asdfgh0318/SoundVisualizer/server/README.md

# SoundVisualizer Server

Python 3.12 + FastAPI + asyncio. Drives 6× UMIK-2 + Tyto Robotics 1585 + (later) Norsonic NOR-145. Filesystem JSON+WAV measurement store.

For overall project context see [`../CLAUDE.md`](../CLAUDE.md) and [`../PLAN.md`](../PLAN.md).

## Quick start

```bash
cd /home/adam/ŻYCIE/PRACA/SoundVisualizer
python3.12 -m venv .venv
source .venv/bin/activate
pip install -e ".[dev]"
uvicorn server.main:app --reload --port 8000
# → http://localhost:8000/health
# → http://localhost:8000/docs   (OpenAPI / Swagger)
```

Tests: `pytest server/tests/` (129 passing). Lint: `ruff check server/ scripts/`.

## Layout

```
server/
  main.py            # FastAPI app entry + lifespan (boots Tyto service & orchestrator); SPA fallback when SOUNDVIS_STATIC set
  __main__.py        # `python -m server` — prod entrypoint, reads [server] host/port from config (used by the RPi systemd unit)
  api/               # HTTP + WS route handlers
    keys.py            # /keys CRUD
    measurements.py    # /keys/{slug}/measurements
    devices.py         # /devices/audio (hw-only filter)
    calibration.py     # /calibrations upload + list
    capture.py         # /capture/acoustic (single-shot, no Tyto)
    capture_run.py     # /capture/run (orchestrated PWM-ramp + mics + WS)
    thrust_stand.py    # /tyto/{status,zero,pwm,cutoffs,reset,ws/telemetry}
    research_tree.py   # /research-tree/nodes — aggregates the configured [[research_trees]]
    results.py         # /keys/{slug}/{pwm_points, .../fft, .../performance_summary, .../psychoacoustics}
    setup_presets.py   # /setup-presets — named mic-list snapshots
    compat_tolerances.py # /compat-tolerances — PWM-point merge tolerances
    dev.py             # /dev/{seed, fake_capture} — synthetic drone-noise data
    schemas.py         # shared Pydantic models (Key, meta, cutoffs, setup, capture run)
  core/              # Hardware orchestration + signal processing
    audio_devices.py   # sounddevice device enumeration (hw: only)
    capture.py         # multi-stream capture
    trigger_sync.py    # dBFS onset alignment (server-side; the old client-side version is gone); skips already-running sources (#13)
    tones.py           # blade-passage frequency from the audio, per-harmonic tone levels, tone-notched third-octaves (#12)
    wav.py             # float32 WAV read/write via scipy
    fft.py             # Welch PSD → dB
    calibration.py     # REW-format UMIK-2 cal parser + response curve + dBFS→dB SPL + Pa scalar
    cutoff_watchdog.py # Tyto safety latching
    thrust_stand_service.py  # owns the Tyto connection + sample stream; detects link loss and reconnects
    capture_orchestrator.py  # per-half PWM-ramp capture loop
    calibration_override.py  # applies config.toml to Paweł's vendored constants
    config.py          # Pydantic config loader (config.toml) — [server], [tyto]
    psychoacoustics.py # mosqito loudness/sharpness/roughness + Zwicker PA (audio scaled to Pa)
  store/             # Filesystem JSON+WAV persistence
    paths.py keys.py measurements.py calibration.py
    setup_presets.py compat_tolerances.py psychoacoustics.py (versioned metrics cache)
  vendor/pawel/      # Vendored — Paweł's Tyto MSP + Norsonic protocol code
  tests/             # 129 passing tests
```

## Conventions

- `server/vendor/pawel/` is treated as upstream — modifications limited to package-relative import fixes (documented in `vendor/pawel/README.md`). Calibration overrides happen in `server/core/calibration_override.py`, not inside the vendored module.
- Hardware modules behind narrow interfaces in `core/`. The watchdog wraps the Tyto poll loop, not the other way around. The orchestrator wraps both.
- Type-hint everything Python 3.12-style (`list[str]`, `int | None`, `dict[str, X]`). Pydantic for any data crossing the API boundary.
- No comments unless the *why* is non-obvious. No docstring bloat.

## Endpoints (37 routes: 33 HTTP + 4 WS)

```
GET  /health
GET  /devices/audio
WS   /devices/audio/{index}/level                # one mic's live level meter (physical-identify tool)
WS   /devices/audio/levels                       # every configured mic at once — Setup level board + Results Live tab
GET  /calibrations
POST /calibrations             (multipart UMIK-2 .txt upload)
GET  /setup-presets
POST /setup-presets
GET  /setup-presets/{id}
DELETE /setup-presets/{id}
GET  /keys                        # each base + first/last capture time (UTC)
POST /keys
GET  /keys/{slug}
GET  /keys/{slug}/measurements
POST /keys/{slug}/measurements
GET  /keys/{slug}/measurements/{id}
GET  /keys/{slug}/pwm_points                     # underlying[].bpf_hz / off_speed flag (>3 % off the PWM's median BPF); underlying[].repeat + acoustic[].repeat
GET  /keys/{slug}/measurements/{id}/fft          # + bpf_hz, tones[], band_centres_hz, broadband_bands_db (tone/broadband split)
GET  /keys/{slug}/measurements/{id}/performance_summary
GET  /keys/{slug}/measurements/{id}/psychoacoustics   # cached, versioned; rel/abs per calibration
POST /capture/acoustic         (single-shot, no Tyto)
POST /capture/run              (orchestrated PWM-ramp capture; repeats (default 1) + repeat_gap_seconds (default 4) run the ramp N times with a 1200 µs gap; every meta.json gets `repeat`, 1-based; status has current_repeat/total_repeats)
GET  /capture/run
DELETE /capture/run            (abort, slams PWM=1000)
WS   /capture/run/ws           (live capture status stream)
GET  /tyto/status              (live link_state: absent | connected | reconnecting)
POST /tyto/zero                (tare)
POST /tyto/zero/clear          (drop the tare offsets)
POST /tyto/pwm
POST /tyto/cutoffs
POST /tyto/reset
WS   /tyto/ws/telemetry        (~33 Hz Tyto poll stream; link-down frames on serial drop)
GET  /research-tree/nodes      (nodes from every configured tree, prefixed per tree)
GET  /compat-tolerances
PUT  /compat-tolerances        (PWM-point merge tolerances, stored at data/compat-tolerances.json)
POST /dev/seed                 (creates a demo key with synthetic drone-noise data)
POST /dev/fake_capture         (real capture-run body, bypasses hardware; curl-only since the wizard button went, issue #17)
```
