asdfgh0318/SoundVisualizer/docs/acoustic-speculations/hub-source-options.md

# Hub sound source for the loudspeaker session

Written 2026-09-09. Needed for campaign session 2; that session has since been run — see `arc-rig-onepager.pdf`, which records that the sphere built from these options is only axisymmetric below 3 kHz:
a source that sits where the propeller sits, plays a 20 Hz–20 kHz exponential sweep and
tones at 216/238/258 Hz, recorded by all 11 microphones with the motor off.

## Requirements, derived from our own captures

| requirement | value | why |
|---|---|---|
| level | ~60 dB SPL at 0.84 m is enough | the propeller itself gave 25–62 dB per third-octave, 67 dB overall; a 10 s sweep adds ~50 dB of processing gain |
| size | 10–20 cm | it replaces a 15 cm propeller; anything larger becomes the reflector we are trying to find |
| omnidirectional | to at least 1 kHz | the reflector question lives at 200–1000 Hz. ka=1 limit: 6 cm piston → 1.8 kHz, 11 cm → 1.0 kHz |
| enclosure | sealed, single driver | must be quiet before the echoes at 2.0 ms (−72°) and 4.4 ms (+36°/+54°); a crossover would make two sources |
| bandwidth | ≥8 kHz usable | resolves 0.125 ms; the shortest echo of interest is 0.58 ms |

Timing, not amplitude flatness, is what the analysis needs, so beaming above 2 kHz is tolerable.

## Options, all verified on the vendor's own page 2026-09-09

**Borrow first.** PW Zakład Elektroakustyki (IRiTM) lists "laboratoryjne źródła dźwięku"
among its Brüel & Kjær equipment, plus a 300 m³ anechoic chamber and Dirac, and offers
measurements to outside parties: <https://zea.ire.pw.edu.pl/oferta/>. Models are not
published. Contact: prof. Jan Żera (Jan.Zera@ire.pw.edu.pl, +48 22 234 7999),
dr Marcin Lewandowski (+48 22 234 7637), dr G. Makarewicz (+48 22 234 7748).
Ask specifically for the **B&K OmniSource 4295**: single driver through a conical coupler
to a small orifice, 50–6300 Hz, Ø145 × 560 mm, 3.5 kg, Lw 105 dB broadband and ≥85 dB per
third-octave (datasheet bp2103). Its long thin body sits down the stand axis, so it is the
only professional source that fits the hub. PL distributor JPT VIBRO (Warszawa), quote only.

**Buy ready-made.** Avantone Active MixCube, single, 1222 zł at thomann.pl. Sealed 18 mm MDF
with Dacron stuffing, one 5.25" paper cone, no tweeter and no crossover, 200 Hz–10 kHz
(no tolerance stated), 104 dB at 1 m, XLR/TRS input, 165 mm cube, 60 W built in.
The only sealed single-driver active found. Genelec 8010A, Neumann KH 80, Yamaha HS3 and
IK iLoud are all bass-reflex; Adam D3V uses passive radiators.

**Build.** Visaton FRS 8 M 8 Ω, 58 zł at thomann.pl (article 218171, in stock, re-checked 2026-09-15) (73.70 zł at grelton.pl, the Polish
Visaton distributor). Sd 29 cm² = 6.1 cm effective piston, so omnidirectional to ~1.8 kHz;
fs 125 Hz, Qts 0.49, Vas 1.1 l, 88 dB/1 W/1 m — all quoted from Visaton themselves and held
with the datasheet at `papers/datasheets/` (Qes 0.58, Qms 3.24, Mms 1.8 g, Bxl 4.0 Tm, Rdc 7.2 Ω,
Le 0.3 mH, 30 W, xmech ±2.5 mm). The alignment below stands on those three numbers, so they are
no longer carried on trust. In a **1.0 litre sealed box** (a 10 cm cube,
lightly stuffed) the alignment is Butterworth: Fc 181 Hz, Qtc 0.71.

| band | 125 | 157 | 198 | 250 | 315 | 400 Hz |
|---|---|---|---|---|---|---|
| output re passband | −7.3 | −4.4 | −2.3 | −1.0 | −0.4 | −0.2 dB |

At 88 dB/W it makes ~95 dB at 1 m on a few watts against the ~60 dB needed, so even the
125 Hz band has 25 dB of margin. Amplifier: TPA3116 board with a 3.5 mm input, 180 zł at
gotronik.pl, or SMSL A100 (40 W into 8 Ω, RCA line in), 449 zł at mp3store.pl.

**Not suitable.** Measurement dodecahedrons are 25–39 cm and 4.5–8 kg (Svantek SV 90/103
250 mm, Norsonic Nor283 270 mm, B&K OmniPower 4292-L 390 mm). At the hub they would replace
the propeller with a large obstacle. No Polish vendor publishes a price for any measurement
source; all are quote-only.

## Still missing on our side

No sweep tooling exists: no playback path in the server, no sweep generator, no
deconvolution script. Needed before the session, not after.

## Build sheet (chosen route, 2026-09-11)

A 1 litre sealed cube around one Visaton FRS 8 M. Gross 1.00 l, about 0.94 l net after the
driver; light stuffing gives most of it back. The alignment barely moves over that range:

| net volume | Fc | Qtc |
|---|---|---|
| 0.90 l | 186 Hz | 0.73 |
| 1.00 l | 181 Hz | 0.71 |

### 3D-printed sphere (alternative, modelled 2026-09-15)

A parametric model is in `hardware/hub-source/hub-sphere.scad` — **one piece**, the driver cutout its
only opening, printed flat-face-down with no support and no glue line with notes in that
directory's README: 1 litre net, 5 mm wall, internal dia 125.8 mm, external 135.8 mm,
split at the equator on a spigot, M6 mount pad at the south pole, driver firing up.

Why a sphere once printing is on the table: a doubly-curved shell is far stiffer than
flat panels of the same thickness, which is the weak point of every printed enclosure,
and it has no edges to diffract. The risk moves to airtightness — printed walls leak
through the layer lines, so the interior has to be sealed or the alignment below is
fiction. For the flat-arc session the shape hardly matters (the source fires along the
axis, so its directivity is common to all eleven microphones and lands in the run-gain
term); it starts to matter for the later vertical-arc session, which is the argument
for building the sphere rather than the cube if only one gets built.

### Cut list, 12 mm MDF or birch ply

External 124 mm cube, internal 100 mm cube. Total panel area 0.076 m², so a 290 × 290 mm
offcut is enough. Butt joints, the two large panels outermost.

| panel | size (mm) | qty |
|---|---|---|
| baffle (driver, faces **up** in use) | 124 × 124 | 1 |
| opposite face | 124 × 124 | 1 |
| two faces spanning between them | 124 × 100 | 2 |
| two faces fitting inside | 100 × 100 | 2 |

- Driver cutout **75 mm Ø** (datasheet), centred on the baffle at 62, 62.
- Chamfer the four edges between the side faces, 45° × 10 mm. Those edges are vertical in
  use, so chamfering makes the horizontal cross-section closer to a circle and evens out
  what the eleven microphones see around the azimuth.
- 6 mm cable hole in the face opposite the driver, sealed with silicone.
- Glue and seal every joint. No port, no vent. About 10 g of polyester, loosely packed.
- Driver mechanics, from the datasheet drawing (27.07.2018), held at
  `papers/datasheets/Visaton_2023_datasheet_FRS-8-M-2001.pdf`: cut-out Ø75 mm, frame a
  **78 mm square** with corner tabs **93 mm across the diagonal**, bolt circle Ø83 mm through
  4.5 × 5.5 slots, overall depth 47 mm, flange 2.1 mm, 30 W, xmech ±2.5 mm. The square frame is
  the trap: the seating face has to clear 93 mm, not the ~80 mm a round 8 cm driver implies.

### Orientation and mounting

The driver fires **up**, along the rig's vertical axis, the direction the propeller blew.
The arc then samples one constant polar angle from the source, so the box's directivity is a
gain common to all eleven microphones and is absorbed by the run-gain term of the fit.

Mount so the cone plane sits at the propeller disc height if the motor allows it; otherwise
record the offset, it is a geometry input like any other.

### Qualification before the box is trusted

1. One sweep, motor off. Check each microphone's impulse response: the source's own decay
   must be over before the echoes at 2.0 ms (−72°) and 4.4 ms (+36°/+54°).
2. Rotate the box 45° about the vertical axis and sweep again. What moves with the box is
   the box; what stays is the room. Ten minutes, and it is the control that makes the rest
   of the session interpretable.

For the later vertical-arc session the microphones span different angles and the directivity
stops cancelling. The method then is Papadakis & Stavroulakis (Appl. Sci. 8:1703, 2018, held
in `papers/arc-validation/`): record with the speaker in 12–26 orientations and sum the
impulse responses; they matched a dodecahedron's reverberation time to within 0.08 s. Their
stated limitation is a two-way speaker's tweeter, which a single full-range driver does not
have.

## Parts chosen (Adam, 2026-09-11)

Chain: laptop → USB → **Behringer UCA202** → RCA → **XH-M189 (TPA3116D2, 2×50 W)** →
**Visaton FRS 8 M** in the 1 litre sealed cube.

| part | why it is the right choice | verified spec |
|---|---|---|
| Behringer UCA202 | replaces the laptop headphone jack with a real line output, so the unknown headphone source impedance that would have raised Qtc and lengthened the box's ring is gone | 16-bit/48 kHz, 2 RCA in, 2 RCA out, headphone out with level control, optical out, USB bus-powered |
| XH-M189, TPA3116D2 | class D, 2 × 50 W, far more than the well-under-1 W we need | DC 5–24 V (24 V for full power), 84 × 51 × 29 mm, short-circuit and reverse-polarity protected |
| Visaton FRS 8 M | see the build sheet above | 58 zł at thomann.pl, in stock |

**Still to buy: a DC supply for the amplifier.** The board does not include one. **12 V at 2 A**
is the right choice. What we actually need is tiny: at 88 dB/1 W/1 m, 60 dB SPL at the arc radius
of 0.84 m is 1.1 mW (0.09 V rms into 8 Ω), a comfortable 75 dB is 35 mW (0.53 V), and even 85 dB is
350 mW (1.7 V). The worst case is the 125 Hz band, where this box is 7.3 dB down — 75 dB there
still only asks 190 mW (1.2 V). A TPA3116 on 12 V can deliver about 6.9 W into 8 Ω, so the supply
is roughly forty times what the loudest planned tone needs, and it is gentler on the board than
the 24 V maximum. Do not size the supply for the amplifier's rating; size it for the level, and
set the level digitally. Plus an input cable to whatever connector
the board carries, and speaker wire.

**Why the cheapness does not matter.** For the substitution calibration the whole source chain
cancels, because every capsule hears the same chain at the same point. For the room sweep the
chain is common to all eleven microphones and we compare microphones to each other. Only an
absolute spectrum would carry the chain's own response, and we never use one.

**Three operating rules.**

1. **Set the level digitally, not with the pot.** Put the amplifier's volume at a sensible mid
   position, mark it, and never touch it again; control the level in the sweep file. That keeps
   the analog chain in a good operating point and makes the drive repeatable and recordable.
2. **The pot is now part of source stability.** If it is nudged between capsule swaps the source
   level changes. The drift-monitor capsule cancels exactly that, which is one more reason not to
   skip it.
3. **Never loop the amplifier output back into the UCA202 inputs.** TPA3116 boards drive a
   bridge-tied load, so neither speaker terminal is at ground; connecting one to an input ground
   shorts the output stage. If an electrical reference of the drive signal is ever wanted, take it
   in software from the playback side.

Generate the sweep as mono, or on the one channel that is wired, and drive a single amplifier
channel.
