asdfgh0318/SoundVisualizer/2.md

# SETUP:(changes regarding setup page of visualizer)
1. throw out auto assign we need manual setup for usb path.
2. make a list for detected devices.
3. button to load a calibration file for the umik mics.
4. possibility of assigning placement positions from 90deg every 15deg allthe way to -90deg and since we will be gathering data from the top portion of the sphere first then placing mics at the bottom half we need 0deg mic to stay the same and others to be dual deg for example 90deg mic on top half will be the same mic on the bottom half measurement but at -90deg. the same goes for other mics.
5. possibility of adding/deleting mics
6. throw out reset button 
7. in the last step we need to merge pawels code regardin the norsonic microphone.
8. we need to add a section to setup tyto robotics cutoff triggers.tick buttons to enable plus plae to input value 

# CAPTURE:
1. azimuth out in the current state we need to introduce a eanblling tick box with input of how many steps around the object wewant to listen to and then change the capture wizard accordingly.itll be described in detail later.
2. duration out like it is now in the following points i will describe more.
3. trigger out like it is now
4. when we open capture first we have to fill in the motor:, propeller:, shroud: , other: , in order for us to use this measurement later with our database coherently.
5. then we should tell the tyto robotics stand how to drive the motor with pwm how many steps and duration of them we need the sound to settle at that pwm before we makea measurement so the pwm will rise like that 
            __2000ms
         __/1500ms
1000ms__/

6. then we hit record and a small window should pop up with a worning about spining propeller and then  we have to click ok on the warning and the motor will spin the mics will record the sound from the top half then we have to manually reconfigure the mics and click done in the wizard and then a second spin of the motor and measurement from the bottom alternatively if we want to measure the drone from different azimuthal angles it should work with the wizard so that we make measurements x times from the topa and the bottom but we should also have checkboxes to tick top or bottom so the wizard can only run top or bottom if we need to correct some measurement for example. 
7. some live telemetry from the tyto robotics stand

# RESULTS:
delete cea2034 and export thingies 
## FFT:
should looks like this:
|PWM:1000ms* |THRUST:50N|TORQUE:5N/M|CURRENT:4A|
|----------------------------------------------|
|90DEG|FFT PLOT FOR 90DEG MIC                  | 
|----------------------------------------------|
|75DEG|FFT FOR 75DEG                           |

AND SO ON ALL OF THE MICS SCROLLABLE PAGE SO THEY ARE A DECENT SIZE. the other parameters are just so we can sort of get a feel for what was the performance at this point of measurement.
*-is the title of one of our acoustic meaurement points (we can have a few in each measurement that Dpoends on the steps for the tyto pwm)

## POLAR:
should be be similar to the fft same first row to choose a point of measurement and display some parameters configurable wich in setup.
then lower the polar plot can be mirrored so its nice and round and on the right hand side in 1 column slider to adjust range of frequencies at wich we analyze on top of it should be a box to type freq and on the bottom the same then 2nd column tertiary division of spectrum when we choose a specific third the freq slider should move automatically to these positions and the 3rd column for octaves and same behaviours as thirds.

## CUSTOM:
https://git.swarozyn.pl/mtj/ars_noise_measurement.git
this is pawels work we need to implement the plotting tool from there build yourself but we want to achieve what pawel did here also when plotting for example spl vs thrust i want to see where are the measurement points since they are discrete and when i click on it all tabs shoould auto adjust to cheosen pwm point in fft and plot.

# Data structure
Our database should be a structure mapping key structure to a set of measurements. The key structure should be composed of following string fields: motor, propeller, shroud, notes. A measurement should be a structure representing a single measurement, either with accustic data from a single microphone, or with performance data from thrust stand. All measurements should have fields with the exact timestamp of its start and end. The type must be disinguisible by some mechanism (either dedicated type field, or just python object type). performance measurements should have all performance-related data. Accustic measurements should have all appropiate accustic data along with operating conditions info (angle of the microphone it was taken at), might also have some metadata about which microphone it was and/or what calibration data was used. Form of storage of the database is up to your choice, but must be consulted with me first. Whichever is simpler. if sql seems an overkill, i can suggest just storing a bunch of pickles/jsons per-measurement in a directory or set of directories.

# HARDWARE: umik2 mics connected via usb hub to rpi 4 wich we dont have currently. nor145 norsonic connected via wifi with pawels implementation and tyto robotics stand the small one also connnected to usb of the rpi so we have to build scripts to control all that. rpi is gonna be connected via wifi with the laptop to the web program. 

ask me questions for more details tell me wich tech stack are you planning to use also make reaserch with subagents to plan well like how to control tyto and umiks and how to implement all that.
