asdfgh0318/SoundVisualizer/docs/analysis/AUDIT-2026-09-11.md

# Self-audit of 2026-09-11 — every number our documents assert from our own data

Run by `docs/analysis/audit_2026_09_11.py`. Each entry recomputes a figure from the source
CSV or from `arc-validation-data.json` and compares it against what the document states.
Standing rule: compute and re-check every figure before reporting it.

Documents audited: `docs/arc-validation-onepager.pdf`, `docs/arc-validation-remedies.pdf`,
`docs/acoustic-speculations/chamber-fighting-guide.pdf`, and the arc-validation bullets of `CLAUDE.md`.

> Note added 2026-09-17: the one-pager and the remedies report have since been retired
> (superseded by `docs/arc-rig-onepager.pdf` after the loudspeaker campaign). This log is
> kept as the record of what was checked on 11 September, against the documents as they
> stood that day; recover them from git to re-read a specific claim.

**Result: 40 of 40 pass after one correction.**

## The one error found, and what it was

Three documents stated that microphone position −72° and position +54° are "9.3 dB apart at
794 Hz" and called it the largest **broadband** feature. The number was real but it came from a
**mixed-band** fit, not from the tone-notched broadband map. Recomputed:

| map | −72° vs +54° at 794 Hz | largest within-group contrast anywhere |
|---|---|---|
| broadband, tones notched | 2.87 dB | 4.34 dB, −72° vs +54° at 397 Hz |
| mixed band, as the one-pager plots | 9.31 dB | 12.46 dB, −36° vs +36° at 250 Hz |

Corrected in the remedies report, the guide and `CLAUDE.md` to quote both maps with the right
label. The argument the number was supporting is unaffected and in fact stronger: the single
largest feature on the one-pager's map, the 250 Hz tone hole at ±36°, sits **inside** one
position/microphone group and is therefore fully determined despite the degeneracy of §Problem 6.

## What passed

- **Broadband position map**: 92 % of cells within ±1.3 dB, worst 2.69 dB, 209 cells, 99 beyond
  three standard errors; 92.2 % within ±1.3 dB below 3.15 kHz against 92.7 % above; worst 2.69
  below and 2.58 above.
- **ISO 3745 tolerance applied as an analogy**: 29 of 209 broadband cells and 55 of 209
  mixed-band cells outside ±1.5/±1.0/±1.5 dB.
- **Microphone terms**: span −5.8 to +3.0 dB; 811-1892 worst at −5.8 dB.
- **Echo delays and gating**: 0.68 m → 1.98 ms → gating valid above about 500 Hz; 1.49 m →
  4.34 ms → 230 Hz; 1.37 m of extra path needed to gate at 250 Hz.
- **Fit identifiability**: 34 parameters on 132 observations, rank 28, six undetermined
  directions, one if the microphone terms are known, five connected position/serial groups.
- **The degeneracy check**: residual RMS 1.5012 dB at 794 Hz, unchanged to four decimals after
  shifting the ±36° group by +1 dB and its two serials by −1 dB.
- **Hub source design** from the Visaton datasheet: 1 litre sealed gives Fc 181 Hz and Qtc 0.71;
  −1.7, −1.2, −0.9 dB at 216, 238, 258 Hz and −7.3 dB at 125 Hz; 6.1 cm effective piston,
  omnidirectional to about 1.8 kHz; decay 2.9 ms to −20 dB and 4.3 ms to −30 dB.
- **Propeller levels**: third-octave band means from 24 to 62 dB, overall 67 dB at the microphones.

## Not audited here

Quotations from the literature are checked separately, by alphanumeric-key matching against the
text dumps: 98 of 98 in the guide, and the five passages added to the remedies report on
2026-09-11. The Schroeder estimate of 190–270 Hz is **not** audited because it depends on a room
size we have not measured; it is flagged as a hypothesis in every document that carries it.
