asdfgh0318/SoundVisualizer/docs/analysis/timeline-2026-11-10/TIMELINE.md

# Recordings timeline

Built by `build_inventory.py` from the data repo; 228 runs on 26 days. `recordings.csv` holds the same rows. Times are local. Telemetry is the mean at the run's highest ESC signal; rpm is electrical as logged.

## 2026-07-24  (1 prop runs, 0 loudspeaker runs)

| Time | Base / run | Mics | Steps | ESC µs or tones | Rep | Thrust N | V | A | rpm el. |
|---|---|---|---|---|---|---|---|---|---|
| 17:52 | 2004__6in__unset__dp1-baseline | 11 | 5 | 1200 1500 1800 1900 2000 | 1 | 4.1 | 6.56 | 8.9 | 0.0 |

## 2026-07-27  (4 prop runs, 0 loudspeaker runs)

| Time | Base / run | Mics | Steps | ESC µs or tones | Rep | Thrust N | V | A | rpm el. |
|---|---|---|---|---|---|---|---|---|---|
| 16:53 | 2004__6in__thinsulate__dp1-thinsulate | 11 | 5 | 1200 1500 1800 1900 2000 | 1 | 4.06 | 6.57 | 8.7 | 0.0 |
| 17:05 | 2004__6in__cardboard__dp1-cardboard | 11 | 5 | 1200 1500 1800 1900 2000 | 1 | 3.96 | 6.57 | 8.69 | 0.0 |
| 17:14 | 2004__6in__xps__dp1-xps | 11 | 5 | 1200 1500 1800 1900 2000 | 1 | 3.97 | 6.57 | 8.74 | 0.0 |
| 17:24 | 2004__6in__epp__dp1-epp | 11 | 5 | 1200 1500 1800 1900 2000 | 1 | 3.94 | 6.55 | 8.54 | 0.0 |

## 2026-08-28  (5 prop runs, 0 loudspeaker runs)

| Time | Base / run | Mics | Steps | ESC µs or tones | Rep | Thrust N | V | A | rpm el. |
|---|---|---|---|---|---|---|---|---|---|
| 17:01 | 2004__6in__unset__dp1-baseline-2026-08-28 | 11 | 5 | 1200 1500 1800 1900 2000 | 1 | 3.99 | 6.65 | 9.53 | 0.0 |
| 17:35 | 2004__6in__cork__dp1-cork | 11 | 5 | 1200 1500 1800 1900 2000 | 1 | 4.33 | 6.58 | 9.53 | 0.0 |
| 17:50 | 2004__6in__felt__dp1-felt | 11 | 5 | 1200 1500 1800 1900 2000 | 1 | 4.31 | 6.59 | 9.53 | 0.0 |
| 18:14 | 2004__6in__felt-rubber__dp1-felt-rubber | 11 | 5 | 1200 1500 1800 1900 2000 | 1 | 4.36 | 6.59 | 9.53 | 0.0 |
| 18:24 | 2004__6in__rubber__dp1-rubber | 11 | 5 | 1200 1500 1800 1900 2000 | 1 | 4.36 | 6.58 | 9.53 | 0.0 |

## 2026-08-31  (7 prop runs, 0 loudspeaker runs)

| Time | Base / run | Mics | Steps | ESC µs or tones | Rep | Thrust N | V | A | rpm el. |
|---|---|---|---|---|---|---|---|---|---|
| 15:39 | 2004__6in__rubber__dp1-rubber-horizontal | 11 | 5 | 1200 1500 1800 1900 2000 | 1 | 4.93 | 7.47 | 11.22 | 0.0 |
| 16:07 | 2004__6in__unset__dp1-baseline-horizontal-2026-08-31 | 11 | 5 | 1200 1500 1800 1900 2000 | 1 | 6.16 | 7.35 | 13.86 | 0.0 |
| 16:14 | 2004__6in__unset__dp1-baseline-horizontal-2 | 11 | 5 | 1200 1500 1800 1900 2000 | 1 | 6.41 | 7.34 | 13.85 | 0.0 |
| 16:20 | 2004__6in__unset__dp1-baseline-horizontal-3 | 11 | 5 | 1200 1500 1800 1900 2000 | 1 | 6.29 | 7.35 | 13.84 | 0.0 |
| 16:24 | 2004__6in__unset__dp1-baseline-horizontal-4 | 11 | 5 | 1200 1500 1800 1900 2000 | 1 | 4.93 | 7.47 | 11.22 | 0.0 |
| 16:26 | 2004__6in__unset__dp1-baseline-horizontal-5 | 11 | 5 | 1200 1500 1800 1900 2000 | 1 | 6.14 | 7.35 | 13.86 | 0.0 |
| 16:31 | 2004__6in__unset__dp1-baseline-horizontal-6 | 11 | 10 | 1200 1500 1800 1900 2000 | 1 | 5.59 | 7.41 | 12.53 | 0.0 |

## 2026-09-01  (10 prop runs, 0 loudspeaker runs)

| Time | Base / run | Mics | Steps | ESC µs or tones | Rep | Thrust N | V | A | rpm el. |
|---|---|---|---|---|---|---|---|---|---|
| 13:55 | 2004__6in__unset__dp1-baseline-horizontal-prop1 | 11 | 5 | 1200 1500 1800 1900 2000 | 1 | 1.14 | 7.83 | 3.85 | 0.0 |
| 13:58 | 2004__6in__unset__dp1-baseline-horizontal-prop2 | 11 | 5 | 1200 1500 1800 1900 2000 | 1 | -0.81 | 7.84 | 3.54 | 0.0 |
| 14:01 | 2004__6in__unset__dp1-baseline-horizontal-prop3 | 11 | 5 | 1200 1500 1800 1900 2000 | 1 | -0.87 | 7.84 | 3.54 | 0.0 |
| 14:18 | 2004__6in__unset__dp1-baseline-horizontal-prop4 | 11 | 5 | 1200 1500 1800 1900 2000 | 1 | -0.83 | 7.84 | 3.53 | 0.0 |
| 14:22 | 2004__6in__unset__dp1-baseline-horizontal-prop5 | 11 | 5 | 1200 1500 1800 1900 2000 | 1 | -0.84 | 7.84 | 3.54 | 0.0 |
| 15:13 | 2004__6in__unset__dp1-baseline-horizontal-prop6 | 11 | 5 | 1200 1500 1800 1900 2000 | 1 | -0.88 | 7.84 | 3.55 | 0.0 |
| 18:42 | 2004__6in__unset__dp1-baseline-horizontal-prop7 | 11 | 5 | 1200 1500 1800 1900 2000 | 1 | -1.82 | 7.81 | 3.93 | 0.0 |
| 18:44 | 2004__6in__unset__dp1-baseline-horizontal-prop8 | 11 | 5 | 1200 1500 1800 1900 2000 | 1 | -3.98 | 11.64 | 7.35 | 0.0 |
| 18:50 | 2004__6in__unset__dp1-baseline-horizontal-prop9 | 11 | 5 | 1200 1500 1800 1900 2000 | 1 | -4.0 | 11.65 | 7.37 | 0.0 |
| 18:55 | 2004__6in__unset__dp1-baseline-horizontal-prop10 | 11 | 5 | 1200 1500 1800 1900 2000 | 1 | -3.96 | 11.65 | 7.33 | 0.0 |

## 2026-09-02  (8 prop runs, 0 loudspeaker runs)

| Time | Base / run | Mics | Steps | ESC µs or tones | Rep | Thrust N | V | A | rpm el. |
|---|---|---|---|---|---|---|---|---|---|
| 15:18 | 2004__6in__unset__dp1-baseline-horizontal-prop11 | 11 | 5 | 1200 1500 1800 1900 2000 | 1 | -4.05 | 11.65 | 7.4 | 0.0 |
| 16:24 | 2004__6in__unset__dp1-baseline-horizontal-prop12 | 11 | 5 | 1200 1500 1800 1900 2000 | 1 | -4.01 | 11.66 | 7.34 | 0.0 |
| 16:34 | 2004__6in__unset__dp1-baseline-horizontal-prop13 | 11 | 5 | 1200 1500 1800 1900 2000 | 1 | -3.93 | 11.6 | 7.25 | 0.0 |
| 16:36 | 2004__6in__unset__dp1-baseline-horizontal-prop14 | 11 | 5 | 1200 1500 1800 1900 2000 | 1 | -3.97 | 11.61 | 7.31 | 0.0 |
| 17:48 | 2004__6in__unset__dp1-baseline-horizontal-prop15 | 11 | 5 | 1200 1500 1800 1900 2000 | 1 | -3.98 | 11.66 | 7.31 | 0.0 |
| 17:54 | 2004__6in__unset__dp1-baseline-horizontal-prop16 | 11 | 5 | 1200 1500 1800 1900 2000 | 1 | -4.02 | 11.66 | 7.36 | 0.0 |
| 18:52 | 2004__6in__unset__dp1-baseline-horizontal-prop17 | 11 | 5 | 1200 1500 1800 1900 2000 | 1 | -4.0 | 11.66 | 7.33 | 0.0 |
| 19:08 | 2004__6in__unset__dp1-baseline-horizontal-prop18 | 11 | 5 | 1200 1500 1800 1900 2000 | 1 | -0.75 | 11.92 | 1.93 | 0.0 |

## 2026-09-16  (0 prop runs, 14 loudspeaker runs)

| Time | Base / run | Mics | Steps | ESC µs or tones | Rep | Thrust N | V | A | rpm el. |
|---|---|---|---|---|---|---|---|---|---|
| 18:09 | 🔊 2026-09-16/m-810-8904 (single-capsule substitution) | 1 | 25 | 63-16000 Hz |  |  |  |  |  |
| 18:15 | 🔊 2026-09-16/m-810-8904__3 (single-capsule substitution) | 1 | 97 | 62-16000 Hz |  |  |  |  |  |
| 18:24 | 🔊 2026-09-16/m-810-8904__4 (single-capsule substitution) | 1 | 97 | 62-16000 Hz |  |  |  |  |  |
| 18:35 | 🔊 2026-09-16/m-811-1896 (single-capsule substitution) | 1 | 97 | 62-16000 Hz |  |  |  |  |  |
| 18:45 | 🔊 2026-09-16/m-810-8903 (single-capsule substitution) | 1 | 97 | 62-16000 Hz |  |  |  |  |  |
| 18:56 | 🔊 2026-09-16/m-810-8900 (single-capsule substitution) | 1 | 97 | 62-16000 Hz |  |  |  |  |  |
| 19:15 | 🔊 2026-09-16/m-811-2310 (single-capsule substitution) | 1 | 97 | 62-16000 Hz |  |  |  |  |  |
| 19:29 | 🔊 2026-09-16/m-810-8897 (single-capsule substitution) | 1 | 97 | 62-16000 Hz |  |  |  |  |  |
| 19:41 | 🔊 2026-09-16/m-811-2321 (single-capsule substitution) | 1 | 97 | 62-16000 Hz |  |  |  |  |  |
| 19:49 | 🔊 2026-09-16/m-810-8893 (single-capsule substitution) | 1 | 97 | 62-16000 Hz |  |  |  |  |  |
| 20:05 | 🔊 2026-09-16/m-811-1892 (single-capsule substitution) | 1 | 97 | 62-16000 Hz |  |  |  |  |  |
| 20:13 | 🔊 2026-09-16/m-810-8901 (single-capsule substitution) | 1 | 97 | 62-16000 Hz |  |  |  |  |  |
| 20:21 | 🔊 2026-09-16/m-811-1897 (single-capsule substitution) | 1 | 97 | 62-16000 Hz |  |  |  |  |  |
| 20:37 | 🔊 2026-09-16/m-810-8904__5 (single-capsule substitution) | 1 | 97 | 62-16000 Hz |  |  |  |  |  |

## 2026-09-17  (0 prop runs, 13 loudspeaker runs)

| Time | Base / run | Mics | Steps | ESC µs or tones | Rep | Thrust N | V | A | rpm el. |
|---|---|---|---|---|---|---|---|---|---|
| 12:21 | 🔊 2026-09-17/battery (single-capsule substitution) | 1 | 25 | 62-16000 Hz |  |  |  |  |  |
| 12:24 | 🔊 2026-09-17/mains (single-capsule substitution) | 1 | 25 | 62-16000 Hz |  |  |  |  |  |
| 13:14 | 🔊 2026-09-17/sanity (rig-stepped-tones) | 11 | 1 | 1000-1000 Hz |  |  |  |  |  |
| 13:17 | 🔊 2026-09-17/full-rig (rig-stepped-tones) | 11 | 112 | 257-6350 Hz |  |  |  |  |  |
| 13:39 | 🔊 2026-09-17/full-rig-2 (rig-stepped-tones) | 11 | 112 | 257-6350 Hz |  |  |  |  |  |
| 13:54 | 🔊 2026-09-17/flipped (rig-stepped-tones) | 11 | 112 | 257-6350 Hz |  |  |  |  |  |
| 15:01 | 🔊 2026-09-17/vertical (rig-stepped-tones) | 11 | 112 | 257-6350 Hz |  |  |  |  |  |
| 15:31 | 🔊 2026-09-17/vertical-source-back (rig-stepped-tones) | 11 | 112 | 257-6350 Hz |  |  |  |  |  |
| 15:51 | 🔊 2026-09-17/rotated-zoom (rig-stepped-tones) | 11 | 17 | 3462-5496 Hz |  |  |  |  |  |
| 15:55 | 🔊 2026-09-17/rotated90-zoom (rig-stepped-tones) | 11 | 17 | 3462-5496 Hz |  |  |  |  |  |
| 16:09 | 🔊 2026-09-17/roll-A (rig-stepped-tones) | 11 | 112 | 257-6350 Hz |  |  |  |  |  |
| 16:16 | 🔊 2026-09-17/roll-B (rig-stepped-tones) | 11 | 112 | 257-6350 Hz |  |  |  |  |  |
| 16:51 | 🔊 2026-09-17/driver-180 (rig-stepped-tones) | 11 | 112 | 257-6350 Hz |  |  |  |  |  |

## 2026-09-23  (0 prop runs, 14 loudspeaker runs)

| Time | Base / run | Mics | Steps | ESC µs or tones | Rep | Thrust N | V | A | rpm el. |
|---|---|---|---|---|---|---|---|---|---|
| --:-- | 🔊 2026-09-23/noise-floor (rig-silence) | 1 | 0 |  |  |  |  |  |  |
| --:-- | 🔊 2026-09-23/noise-floor-CHAMBER-NOT-READY (rig-silence) | 1 | 0 |  |  |  |  |  |  |
| 17:36 | 🔊 2026-09-23/vertical-2a-ABORTED-chamber-not-ready (rig-stepped-tones) | 11 | 112 | 257-6350 Hz |  |  |  |  |  |
| 17:40 | 🔊 2026-09-23/vertical-2a (rig-stepped-tones) | 11 | 112 | 257-6350 Hz |  |  |  |  |  |
| 17:46 | 🔊 2026-09-23/vertical-2b (rig-stepped-tones) | 11 | 112 | 257-6350 Hz |  |  |  |  |  |
| 18:02 | 🔊 2026-09-23/foam-1 (rig-stepped-tones) | 11 | 95 | 257-6350 Hz |  |  |  |  |  |
| 18:24 | 🔊 2026-09-23/foam-2 (rig-stepped-tones) | 11 | 95 | 257-6350 Hz |  |  |  |  |  |
| 18:32 | 🔊 2026-09-23/foam-out-NOISY-above-420Hz (rig-stepped-tones) | 11 | 95 | 257-6350 Hz |  |  |  |  |  |
| 18:40 | 🔊 2026-09-23/foam-out (rig-stepped-tones) | 11 | 95 | 257-6350 Hz |  |  |  |  |  |
| 18:56 | 🔊 2026-09-23/tripod-unwrapped (rig-stepped-tones) | 11 | 95 | 257-6350 Hz |  |  |  |  |  |
| 19:15 | 🔊 2026-09-23/ring-unwrapped (rig-stepped-tones) | 11 | 95 | 257-6350 Hz |  |  |  |  |  |
| 19:32 | 🔊 2026-09-23/ring-unwrapped-2 (rig-stepped-tones) | 11 | 95 | 257-6350 Hz |  |  |  |  |  |
| 19:45 | 🔊 2026-09-23/floor-carpet (rig-stepped-tones) | 11 | 95 | 257-6350 Hz |  |  |  |  |  |
| 20:13 | 🔊 2026-09-23/ceiling-carpet (rig-stepped-tones) | 11 | 95 | 257-6350 Hz |  |  |  |  |  |

## 2026-09-24  (0 prop runs, 34 loudspeaker runs)

| Time | Base / run | Mics | Steps | ESC µs or tones | Rep | Thrust N | V | A | rpm el. |
|---|---|---|---|---|---|---|---|---|---|
| 13:17 | 🔊 2026-09-24/ceiling-carpet-day2 (rig-stepped-tones) | 11 | 95 | 257-6350 Hz |  |  |  |  |  |
| 13:25 | 🔊 2026-09-24/ceiling1-floor2 (rig-stepped-tones) | 11 | 95 | 257-6350 Hz |  |  |  |  |  |
| 13:37 | 🔊 2026-09-24/felt-floor-only (rig-stepped-tones) | 11 | 95 | 257-6350 Hz |  |  |  |  |  |
| 13:46 | 🔊 2026-09-24/bare-day2 (rig-stepped-tones) | 11 | 95 | 257-6350 Hz |  |  |  |  |  |
| 14:05 | 🔊 2026-09-24/floor-no-wedges (rig-stepped-tones) | 11 | 95 | 257-6350 Hz |  |  |  |  |  |
| 14:16 | 🔊 2026-09-24/carpet-added (rig-stepped-tones) | 11 | 95 | 257-6350 Hz |  |  |  |  |  |
| 14:32 | 🔊 2026-09-24/chaotic-carpet (rig-stepped-tones) | 11 | 95 | 257-6350 Hz |  |  |  |  |  |
| 14:43 | 🔊 2026-09-24/chaotic-carpet-2 (rig-stepped-tones) | 11 | 95 | 257-6350 Hz |  |  |  |  |  |
| 14:52 | 🔊 2026-09-24/chaotic-carpet-3 (rig-stepped-tones) | 11 | 95 | 257-6350 Hz |  |  |  |  |  |
| 15:31 | 🔊 2026-09-24/wall-mount-a (rig-stepped-tones) | 11 | 95 | 257-6350 Hz |  |  |  |  |  |
| 15:36 | 🔊 2026-09-24/wall-mount-b (rig-stepped-tones) | 11 | 95 | 257-6350 Hz |  |  |  |  |  |
| 15:47 | 🔊 2026-09-24/wall-mount-decoupled (rig-stepped-tones) | 11 | 95 | 257-6350 Hz |  |  |  |  |  |
| 16:34 | 🔊 2026-09-24/wall-direct-a (rig-stepped-tones) | 11 | 95 | 257-6350 Hz |  |  |  |  |  |
| 16:39 | 🔊 2026-09-24/wall-direct-b (rig-stepped-tones) | 11 | 95 | 257-6350 Hz |  |  |  |  |  |
| 16:56 | 🔊 2026-09-24/wall-direct-absorber (rig-stepped-tones) | 11 | 95 | 257-6350 Hz |  |  |  |  |  |
| 17:06 | 🔊 2026-09-24/ring-bare (rig-stepped-tones) | 11 | 95 | 257-6350 Hz |  |  |  |  |  |
| 17:30 | 🔊 2026-09-24/center-new-a (rig-stepped-tones) | 11 | 95 | 257-6350 Hz |  |  |  |  |  |
| 17:35 | 🔊 2026-09-24/center-new-b (rig-stepped-tones) | 11 | 95 | 257-6350 Hz |  |  |  |  |  |
| 17:46 | 🔊 2026-09-24/center-leveled (rig-stepped-tones) | 11 | 95 | 257-6350 Hz |  |  |  |  |  |
| 19:25 | 🔊 2026-09-24/floor-even-carpet (rig-stepped-tones) | 11 | 95 | 257-6350 Hz |  |  |  |  |  |
| 19:34 | 🔊 2026-09-24/carpet-plus-felt (rig-stepped-tones) | 11 | 95 | 257-6350 Hz |  |  |  |  |  |
| 19:42 | 🔊 2026-09-24/metal-rod (rig-stepped-tones) | 11 | 95 | 257-6350 Hz |  |  |  |  |  |
| 19:51 | 🔊 2026-09-24/felt-ceiling (rig-stepped-tones) | 11 | 95 | 257-6350 Hz |  |  |  |  |  |
| 20:02 | 🔊 2026-09-24/rod-removed (rig-stepped-tones) | 11 | 95 | 257-6350 Hz |  |  |  |  |  |
| 20:17 | 🔊 2026-09-24/carpet-raised (rig-stepped-tones) | 11 | 95 | 257-6350 Hz |  |  |  |  |  |
| 20:29 | 🔊 2026-09-24/carpet-raised-2 (rig-stepped-tones) | 11 | 95 | 257-6350 Hz |  |  |  |  |  |
| 20:37 | 🔊 2026-09-24/shield-removed (rig-stepped-tones) | 11 | 95 | 257-6350 Hz |  |  |  |  |  |
| 20:44 | 🔊 2026-09-24/ceiling-felt-removed (rig-stepped-tones) | 11 | 95 | 257-6350 Hz |  |  |  |  |  |
| 20:54 | 🔊 2026-09-24/ceiling-felt-to-floor (rig-stepped-tones) | 11 | 95 | 257-6350 Hz |  |  |  |  |  |
| 21:02 | 🔊 2026-09-24/felt-foil-in (rig-stepped-tones) | 11 | 95 | 257-6350 Hz |  |  |  |  |  |
| 21:17 | 🔊 2026-09-24/felt-foil-removed (rig-stepped-tones) | 11 | 95 | 257-6350 Hz |  |  |  |  |  |
| 21:28 | 🔊 2026-09-24/felt-foil-free-inverted (rig-stepped-tones) | 11 | 95 | 257-6350 Hz |  |  |  |  |  |
| 21:39 | 🔊 2026-09-24/felt-bare (rig-stepped-tones) | 11 | 95 | 257-6350 Hz |  |  |  |  |  |
| 21:54 | 🔊 2026-09-24/floor-raised-3 (rig-stepped-tones) | 11 | 95 | 257-6350 Hz |  |  |  |  |  |

## 2026-09-25  (0 prop runs, 28 loudspeaker runs)

| Time | Base / run | Mics | Steps | ESC µs or tones | Rep | Thrust N | V | A | rpm el. |
|---|---|---|---|---|---|---|---|---|---|
| 13:17 | 🔊 2026-09-25/day3-a (rig-stepped-tones) | 11 | 95 | 257-6350 Hz |  |  |  |  |  |
| 13:22 | 🔊 2026-09-25/day3-b (rig-stepped-tones) | 11 | 95 | 257-6350 Hz |  |  |  |  |  |
| 13:33 | 🔊 2026-09-25/blue-carpet (rig-stepped-tones) | 11 | 95 | 257-6350 Hz |  |  |  |  |  |
| 13:44 | 🔊 2026-09-25/closer-a (rig-stepped-tones) | 11 | 95 | 257-6350 Hz |  |  |  |  |  |
| 13:49 | 🔊 2026-09-25/closer-b (rig-stepped-tones) | 11 | 95 | 257-6350 Hz |  |  |  |  |  |
| 14:03 | 🔊 2026-09-25/in-plane-a (rig-stepped-tones) | 11 | 95 | 257-6350 Hz |  |  |  |  |  |
| 14:08 | 🔊 2026-09-25/in-plane-b (rig-stepped-tones) | 11 | 95 | 257-6350 Hz |  |  |  |  |  |
| 14:18 | 🔊 2026-09-25/curtain (rig-stepped-tones) | 11 | 95 | 257-6350 Hz |  |  |  |  |  |
| 14:28 | 🔊 2026-09-25/material-roll (rig-stepped-tones) | 11 | 95 | 257-6350 Hz |  |  |  |  |  |
| 14:40 | 🔊 2026-09-25/corner-stuffed (rig-stepped-tones) | 11 | 95 | 257-6350 Hz |  |  |  |  |  |
| 14:55 | 🔊 2026-09-25/screen-1-layer (rig-stepped-tones) | 11 | 95 | 257-6350 Hz |  |  |  |  |  |
| 15:09 | 🔊 2026-09-25/felt-wall (rig-stepped-tones) | 11 | 95 | 257-6350 Hz |  |  |  |  |  |
| 15:17 | 🔊 2026-09-25/carpet-only (rig-stepped-tones) | 11 | 95 | 257-6350 Hz |  |  |  |  |  |
| 15:29 | 🔊 2026-09-25/backed-5cm (rig-stepped-tones) | 11 | 95 | 257-6350 Hz |  |  |  |  |  |
| 15:41 | 🔊 2026-09-25/cleanup-1 (rig-stepped-tones) | 11 | 95 | 257-6350 Hz |  |  |  |  |  |
| 16:02 | 🔊 2026-09-25/cleanup-2 (rig-stepped-tones) | 11 | 95 | 257-6350 Hz |  |  |  |  |  |
| 16:15 | 🔊 2026-09-25/cleanup-3 (rig-stepped-tones) | 11 | 95 | 257-6350 Hz |  |  |  |  |  |
| 16:23 | 🔊 2026-09-25/cleanup-4 (rig-stepped-tones) | 11 | 95 | 257-6350 Hz |  |  |  |  |  |
| 16:31 | 🔊 2026-09-25/cleanup-5 (rig-stepped-tones) | 11 | 95 | 257-6350 Hz |  |  |  |  |  |
| 17:06 | 🔊 2026-09-25/cleanup-6 (rig-stepped-tones) | 11 | 95 | 257-6350 Hz |  |  |  |  |  |
| 17:18 | 🔊 2026-09-25/carpet-removed (rig-stepped-tones) | 11 | 95 | 257-6350 Hz |  |  |  |  |  |
| 17:30 | 🔊 2026-09-25/carpet-square (rig-stepped-tones) | 11 | 95 | 257-6350 Hz |  |  |  |  |  |
| 17:42 | 🔊 2026-09-25/wall-thinsulate (rig-stepped-tones) | 11 | 95 | 257-6350 Hz |  |  |  |  |  |
| 18:07 | 🔊 2026-09-25/thin-carpet-raised (rig-stepped-tones) | 11 | 95 | 257-6350 Hz |  |  |  |  |  |
| 18:19 | 🔊 2026-09-25/thick-carpet-raised (rig-stepped-tones) | 11 | 95 | 257-6350 Hz |  |  |  |  |  |
| 18:33 | 🔊 2026-09-25/thicker-carpet-raised (rig-stepped-tones) | 11 | 95 | 257-6350 Hz |  |  |  |  |  |
| 18:48 | 🔊 2026-09-25/full-carpet-raised (rig-stepped-tones) | 11 | 95 | 257-6350 Hz |  |  |  |  |  |
| 19:15 | 🔊 2026-09-25/carpet-reordered (rig-stepped-tones) | 11 | 95 | 257-6350 Hz |  |  |  |  |  |

## 2026-09-30  (5 prop runs, 1 loudspeaker runs)

| Time | Base / run | Mics | Steps | ESC µs or tones | Rep | Thrust N | V | A | rpm el. |
|---|---|---|---|---|---|---|---|---|---|
| 15:43 | 🔊 2026-09-30/carpet-reordered-rerun (rig-stepped-tones) | 11 | 95 | 257-6350 Hz |  |  |  |  |  |
| 17:22 | dupa__ggggg__unset__v1-baseline-vertical | 11 | 7 | 1200 1500 1800 1900 2000 | 1 | -4.07 | 11.64 | 7.42 | 0.0 |
| 18:44 | aaaa__fffff__felt__v1-felt-duct | 11 | 5 | 1200 1500 1800 1900 2000 | 1 | -2.67 | 11.6 | 8.0 | 0.0 |
| 18:49 | aaaa__fffff__felt__v1-felt-duct2 | 11 | 5 | 1200 1500 1800 1900 2000 | 1 | -3.36 | 11.65 | 7.11 | 0.0 |
| 18:53 | aaaa__fffff__felt__v1-felt-duct23 | 11 | 5 | 1200 1500 1800 1900 2000 | 1 | -3.36 | 11.65 | 7.12 | 0.0 |
| 19:01 | aaaa__fffff__felt__v1-felt-plastic-coomp | 11 | 5 | 1200 1500 1800 1900 2000 | 1 | -3.31 | 11.65 | 7.08 | 0.0 |

## 2026-10-02  (7 prop runs, 0 loudspeaker runs)

| Time | Base / run | Mics | Steps | ESC µs or tones | Rep | Thrust N | V | A | rpm el. |
|---|---|---|---|---|---|---|---|---|---|
| 18:13 | 2004__5in3b__unset__v1-naked-cage-vertical | 11 | 5 | 1200 1500 1800 1900 2000 | 1 | -3.65 | 11.64 | 7.39 | 0.0 |
| 18:17 | 2004__5in3b__unset__v1-naked-horizontal | 11 | 5 | 1200 1500 1800 1900 2000 | 1 | -3.62 | 11.64 | 7.37 | 0.0 |
| 18:45 | 2004__5in3b__cork__v1-cork-horizontal | 11 | 5 | 1200 1500 1800 1900 2000 | 1 | -3.49 | 11.65 | 7.35 | 0.0 |
| 18:53 | 2004__5in3b__rubber__v1-rubber | 11 | 5 | 1200 1500 1800 1900 2000 | 1 | -3.36 | 11.65 | 7.29 | 0.0 |
| 19:00 | 2004__5in3b__felt-rubber__v1-felt-rubber | 11 | 3 | 1200 1500 1800 | 1 | 0.0 | 12.01 | -0.0 | 0.0 |
| 19:06 | 2004__5in3b__felt-rubber__v1-felt-rubber | 11 | 5 | 1200 1500 1800 1900 2000 | 1 | -3.23 | 11.65 | 7.24 | 0.0 |
| 19:15 | 2004__5in3b__felt__v1-felt | 11 | 5 | 1200 1500 1800 1900 2000 | 1 | -3.38 | 11.65 | 7.32 | 0.0 |

## 2026-10-07  (13 prop runs, 0 loudspeaker runs)

| Time | Base / run | Mics | Steps | ESC µs or tones | Rep | Thrust N | V | A | rpm el. |
|---|---|---|---|---|---|---|---|---|---|
| 13:47 | axii__5in3b__inner-felt-outer-open-pore-pu-foam__v1-inner-felt-outer-pu | 11 | 5 | 1200 1500 1800 1900 2000 | 1 | -3.27 | 11.64 | 7.17 | 0.0 |
| 13:55 | axii__5in3b__open-pore-pu-foam__v1-pu-foam | 11 | 5 | 1200 1500 1800 1900 2000 | 1 | -3.33 | 11.64 | 7.23 | 0.0 |
| 14:01 | axii__5in3b__open-pore-pu-foam-double-layer__v1-pu-foam-double | 11 | 5 | 1200 1500 1800 1900 2000 | 1 | -2.9 | 11.65 | 7.07 | 0.0 |
| 14:26 | axii__5in3b__thinsulate-4-layers__v1-thinsulate-4-layers | 11 | 5 | 1200 1500 1800 1900 2000 | 1 | -3.09 | 11.65 | 7.1 | 0.0 |
| 14:39 | axii__5in3b__thinsulate-8-layers__v1-thinsulate-8-layers | 11 | 5 | 1200 1500 1800 1900 2000 | 1 | -2.94 | 11.64 | 7.11 | 0.0 |
| 14:59 | axi__5in3b__inner-cork-outer-thinsulate-8-layers__v1-cork-inner-thinsulate-8-outer | 11 | 5 | 1200 1500 1800 1900 2000 | 1 | -2.88 | 11.63 | 7.07 | 0.0 |
| 16:56 | axi__8in__thinsulate-cork__v1-thinsulate-cork-bp | 11 | 15 | 1200 1500 1800 1900 2000 | 3 | -3.54 | 9.18 | 15.59 | 0.0 |
| 17:07 | axi__8x4-5inapc__unset__v1-naked-cage-bp | 11 | 15 | 1200 1500 1800 1900 2000 | 3 | -7.05 | 9.12 | 16.98 | 0.0 |
| 17:24 | axi__8x4-5inapc__open-pore-pu-foam__v1-pu-foam-bp | 11 | 15 | 1200 1500 1800 1900 2000 | 3 | -6.58 | 9.14 | 16.68 | 0.0 |
| 17:35 | axi__8x4-5inapc__cork-open-pore-pu-foam__v1-cork-pu-bp | 11 | 15 | 1200 1500 1800 1900 2000 | 3 | -6.25 | 9.14 | 16.75 | 0.0 |
| 17:45 | axi__8x4-5inapc__open-pore-pu-foam-double-layer__v1-pu-foam-double-bp | 11 | 15 | 1200 1500 1800 1900 2000 | 3 | -6.17 | 9.18 | 15.93 | 0.0 |
| 18:13 | axi__8x4-5inapc__felt-rubber__v1-felt-rubber-bp | 11 | 15 | 1200 1500 1800 1900 2000 | 3 | -5.72 | 9.17 | 16.27 | 0.0 |
| 18:39 | axi__8inapc__felt-rubber__v1-felt-rubber-bp | 11 | 15 | 1200 1500 1800 1900 2000 | 3 | -5.69 | 9.17 | 16.27 | 0.0 |

## 2026-10-08  (2 prop runs, 0 loudspeaker runs)

| Time | Base / run | Mics | Steps | ESC µs or tones | Rep | Thrust N | V | A | rpm el. |
|---|---|---|---|---|---|---|---|---|---|
| 16:46 | f30__5in3b__membrane-duct-small__v1-membrane-duct-small | 11 | 15 | 1200 1500 1800 1900 2000 | 3 | -0.97 | 9.3 | 13.8 | 0.0 |
| 16:52 | f30__5in3b__membrane-open-pore-pu-foam__v1-membrane-pu-foam | 11 | 15 | 1200 1500 1800 1900 2000 | 3 | -1.04 | 9.3 | 13.7 | 0.0 |

## 2026-10-09  (9 prop runs, 0 loudspeaker runs)

| Time | Base / run | Mics | Steps | ESC µs or tones | Rep | Thrust N | V | A | rpm el. |
|---|---|---|---|---|---|---|---|---|---|
| 15:12 | f30__5in3b__membrane-duct-open-pore-pu-foam-double-layer__v1-membrane-duct-pu-foam-double | 11 | 15 | 1200 1500 1800 1900 2000 | 3 | -1.04 | 9.27 | 13.8 | 0.0 |
| 15:18 | f30__5in3b__membrane-felt__v1-membrane-felt | 11 | 15 | 1200 1500 1800 1900 2000 | 3 | -0.95 | 9.26 | 14.02 | 0.0 |
| 15:35 | f30__5in3b__membrane-felt-double-layer__v1-membrane-felt-double | 11 | 15 | 1200 1500 1800 1900 2000 | 3 | -0.88 | 9.27 | 13.93 | 0.0 |
| 16:23 | f30__5in3b__membrane-cork__v1-membrane-cork | 11 | 15 | 1200 1500 1800 1900 2000 | 3 | -1.2 | 9.26 | 14.16 | 0.0 |
| 16:44 | f30__5in3b__membrane-felt-rubber__v1-membrane-felt-rubber | 11 | 15 | 1200 1500 1800 1900 2000 | 3 | -1.1 | 9.26 | 14.15 | 0.0 |
| 17:03 | f30__5in3b__membrane-thinsulate-8-layers__v1-membrane-thinsulate-8-layers | 11 | 15 | 1200 1500 1800 1900 2000 | 3 | -1.1 | 9.23 | 14.62 | 0.0 |
| 17:16 | f30__5in3b__membrane-thinsulate-4-layers__v1-membrane-thinsulate-4-layers | 11 | 15 | 1200 1500 1800 1900 2000 | 3 | -0.39 | 9.24 | 14.55 | 0.0 |
| 17:21 | f30__5in3b__membrane-thinsulate-2-layers__v1-membrane-thinsulate-2-layers | 11 | 15 | 1200 1500 1800 1900 2000 | 3 | -0.37 | 9.24 | 14.56 | 0.0 |
| 18:10 | f30__5in3b__unset__v1-bare-prop | 11 | 15 | 1200 1500 1800 1900 2000 | 3 | -3.76 | 9.2 | 15.27 | 0.0 |

## 2026-10-23  (2 prop runs, 0 loudspeaker runs)

| Time | Base / run | Mics | Steps | ESC µs or tones | Rep | Thrust N | V | A | rpm el. |
|---|---|---|---|---|---|---|---|---|---|
| 14:29 | axi__8in__unset__m8-baseline | 11 | 20 | 1200 1500 1800 1900 2000 | 3 | -8.59 | 10.67 | 20.81 | 0.0 |
| 18:11 | axi__8in__unset__pr1-apc-8x4-5mr | 11 | 15 | 1200 1500 1800 1900 2000 | 3 | -4.74 | 8.0 | 8.79 | 0.0 |

## 2026-10-27  (7 prop runs, 0 loudspeaker runs)

| Time | Base / run | Mics | Steps | ESC µs or tones | Rep | Thrust N | V | A | rpm el. |
|---|---|---|---|---|---|---|---|---|---|
| 17:24 | axi2212__8in__petg__r27-petg-0-8mm | 11 | 15 | 1200 1500 1800 1900 2000 | 3 | -7.7 | 10.98 | 20.56 | 1436.87 |
| 17:58 | axi2217__8in__pu-foam__r27-pu-foam | 11 | 15 | 1200 1500 1800 1900 2000 | 3 | -7.79 | 10.98 | 20.73 | 1429.04 |
| 18:07 | axi2217__8in__petg__r27-petg-0-8mm | 11 | 15 | 1200 1500 1800 1900 2000 | 3 | -7.8 | 10.98 | 20.63 | 1433.27 |
| 18:35 | 2217__8in__pu-foam__r27-pu-foam | 11 | 15 | 1200 1500 1800 1900 2000 | 3 | -8.62 | 10.96 | 21.22 | 1419.95 |
| 18:42 | 2217__8in__petg__r27-petg-0-8mm | 11 | 15 | 1200 1500 1800 1900 2000 | 3 | -7.8 | 10.98 | 20.67 | 1435.41 |
| 18:53 | 2217__8in__thinsulate-4-layers__r27-thinsulate-4-layers | 11 | 15 | 1200 1500 1800 1900 2000 | 3 | -7.52 | 10.98 | 20.83 | 1430.63 |
| 19:01 | 2217__8in__thinsulate-10-layers__r27-thinsulate-10-layers (also: r27-thinsulate-10-layers-archive-2026-10-27) | 11 | 15 | 1200 1500 1800 1900 2000 | 3 | -7.42 | 10.98 | 20.79 | 1431.61 |

## 2026-10-28  (8 prop runs, 0 loudspeaker runs)

| Time | Base / run | Mics | Steps | ESC µs or tones | Rep | Thrust N | V | A | rpm el. |
|---|---|---|---|---|---|---|---|---|---|
| 17:20 | axi-2217__8in__thinsulate-8-layers__r27-thinsulate-8-layers (also: r27-thinsulate-8-layers-archive-2026-10-28) | 11 | 15 | 1200 1500 1800 1900 2000 | 3 | -7.54 | 10.96 | 20.99 | 1426.48 |
| 17:32 | axi2217__8in__thinsulate-6-layers__r27-thinsulate-6-layers (also: r27-thinsulate-6-layers-archive-2026-10-28) | 11 | 15 | 1200 1500 1800 1900 2000 | 3 | -7.33 | 10.97 | 20.85 | 1429.77 |
| 17:36 | axi2217__8in__thinsulate-4-layers__r27-thinsulate-4-layers (also: r27-thinsulate-4-layers-archive-2026-10-28) | 11 | 15 | 1200 1500 1800 1900 2000 | 3 | -7.34 | 10.97 | 20.81 | 1428.5 |
| 17:41 | axi2217__8in__thinsulate-2-layers__r27-thinsulate-2-layers | 11 | 15 | 1200 1500 1800 1900 2000 | 3 | -5.67 | 10.98 | 20.42 | 1438.39 |
| 17:47 | axi2217__8in__petg__r27-petg-0-8mm | 11 | 15 | 1200 1500 1800 1900 2000 | 3 | -7.83 | 10.97 | 20.74 | 1432.09 |
| 18:02 | axi2217__8in__pu-foam__r27-pu-foam | 11 | 15 | 1200 1500 1800 1900 2000 | 3 | -8.18 | 10.96 | 20.91 | 1426.72 |
| 19:07 | axi2217__8in__felt__r27-felt | 11 | 15 | 1200 1500 1800 1900 2000 | 3 | -8.91 | 10.94 | 21.39 | 1413.81 |
| 20:10 | axi2217__8in__thinsulate-2-layers__r27-thinsulate-2-layers (also: r27-thinsulate-2-layers-archive-2026-10-28) | 11 | 15 | 1200 1500 1800 1900 2000 | 3 | -7.89 | 10.96 | 20.88 | 1427.3 |

## 2026-10-29  (4 prop runs, 0 loudspeaker runs)

| Time | Base / run | Mics | Steps | ESC µs or tones | Rep | Thrust N | V | A | rpm el. |
|---|---|---|---|---|---|---|---|---|---|
| 16:48 | axi2217__8in__felt-2-layers__r27-felt-2-layers | 11 | 15 | 1200 1500 1800 1900 2000 | 3 | -8.63 | 10.95 | 21.17 | 1422.28 |
| 17:16 | axi2217__8in__felt-2-layers-rubber__r27-felt-2-layers-rubber | 11 | 15 | 1200 1500 1800 1900 2000 | 3 | -8.72 | 10.95 | 21.19 | 1419.6 |
| 18:34 | axi2217__8in__rubber__r27-rubber | 11 | 15 | 1200 1500 1800 1900 2000 | 3 | -7.6 | 10.98 | 20.69 | 1433.41 |
| 20:26 | axi2217__8in__pu-foam-rubber__r27-pu-foam-rubber | 11 | 15 | 1200 1500 1800 1900 2000 | 3 | -8.33 | 10.96 | 21.03 | 1424.84 |

## 2026-10-30  (6 prop runs, 0 loudspeaker runs)

| Time | Base / run | Mics | Steps | ESC µs or tones | Rep | Thrust N | V | A | rpm el. |
|---|---|---|---|---|---|---|---|---|---|
| 16:39 | axi2217__8in__thinsulate-2-layers__r27-thinsulate-2-layers | 11 | 15 | 1200 1500 1800 1900 2000 | 3 | -8.57 | 10.95 | 21.02 | 1423.49 |
| 16:55 | axi2217__8in__thinsulate-2-layers__r27-thinsulate-2-layers (also: r27-thinsulate-2-layers-archive-2026-10-30-remount-trial) | 11 | 11 | 1200 1500 1800 1900 2000 | 3 | -8.54 | 10.95 | 21.04 | 1425.15 |
| 17:04 | axi2217__8in__thinsulate-2-layers__r27-thinsulate-2-layers (also: r27-thinsulate-2-layers-archive-2026-10-30-trial-1604) | 11 | 15 | 1200 1500 1800 1900 2000 | 3 | -8.51 | 10.95 | 21.08 | 1421.98 |
| 17:26 | axi2217__8in__thinsulate-6-layers__r27-thinsulate-6-layers | 11 | 15 | 1200 1500 1800 1900 2000 | 3 | -8.64 | 10.95 | 21.09 | 1420.11 |
| 17:30 | axi2217__8in__thinsulate-6-layers__r27-thinsulate-6-layers-archive-2026-10-30-trial-1630 | 11 | 15 | 1200 1500 1800 1900 2000 | 3 | -8.58 | 10.95 | 20.99 | 1420.61 |
| 17:44 | axi2217__8in__thinsulate-8-layers__r27-thinsulate-8-layers | 11 | 15 | 1200 1500 1800 1900 2000 | 3 | -8.74 | 10.95 | 21.16 | 1418.74 |

## 2026-11-02  (9 prop runs, 0 loudspeaker runs)

| Time | Base / run | Mics | Steps | ESC µs or tones | Rep | Thrust N | V | A | rpm el. |
|---|---|---|---|---|---|---|---|---|---|
| 17:19 | axi2217__8in__thinsulate-8-layers__r27-thinsulate-8-layers-archive-2026-11-02-trial-1619 | 11 | 15 | 1200 1500 1800 1900 2000 | 3 | -8.82 | 10.97 | 21.31 | 1423.4 |
| 17:49 | axi2217__8in__thinsulate-10-layers__r27-thinsulate-10-layers | 11 | 15 | 1200 1500 1800 1900 2000 | 3 | -8.91 | 10.97 | 21.43 | 1419.68 |
| 17:51 | axi2217__8in__thinsulate-10-layers__r27-thinsulate-10-layers-archive-2026-11-02-trial-1651 | 11 | 15 | 1200 1500 1800 1900 2000 | 3 | -8.85 | 10.97 | 21.38 | 1416.86 |
| 18:03 | axi2217__8in__thinsulate-4-layers__r27-thinsulate-4-layers | 11 | 15 | 1200 1500 1800 1900 2000 | 3 | -9.23 | 10.97 | 21.45 | 1416.32 |
| 18:08 | axi2217__8in__thinsulate-4-layers__r27-thinsulate-4-layers-archive-2026-11-02-trial-1708 | 11 | 15 | 1200 1500 1800 1900 2000 | 3 | -9.23 | 10.97 | 21.47 | 1416.21 |
| 18:20 | axi2217__8in__thinsulate-2-layers__r27-thinsulate-2-layers-trial-2026-11-02 | 11 | 15 | 1200 1500 1800 1900 2000 | 3 | -8.77 | 10.98 | 21.22 | 1424.79 |
| 18:35 | axi2217__8in__duct-unlined__r27-duct-unlined | 11 | 15 | 1200 1500 1800 1900 2000 | 3 | -8.01 | 10.99 | 20.97 | 1430.53 |
| 18:51 | axi2217__8in__duct-unlined__r27-duct-unlined-archive-2026-11-02-trial-1751 | 11 | 15 | 1200 1500 1800 1900 2000 | 3 | -7.93 | 11.0 | 20.84 | 1434.21 |
| 18:59 | axi2217__8in__none__r27-8x45mr-bare-prop | 11 | 15 | 1200 1500 1800 1900 2000 | 3 | -10.57 | 10.9 | 22.94 | 1377.16 |

## 2026-11-03  (6 prop runs, 0 loudspeaker runs)

| Time | Base / run | Mics | Steps | ESC µs or tones | Rep | Thrust N | V | A | rpm el. |
|---|---|---|---|---|---|---|---|---|---|
| 17:38 | axi2217__8in__duct-unlined-inlet__r27-duct-unlined-inlet | 11 | 15 | 1200 1500 1800 1900 2000 | 3 | -10.13 | 10.94 | 21.69 | 1408.28 |
| 17:43 | axi2217__8in__duct-unlined-inlet__r27-duct-unlined-inlet-trial-2026-11-03 | 11 | 15 | 1200 1500 1800 1900 2000 | 3 | -10.08 | 10.94 | 21.64 | 1409.61 |
| 17:55 | axi2217__8in__inlet-thinsulate-2-layers__r27-inlet-thinsulate-2-layers | 11 | 15 | 1200 1500 1800 1900 2000 | 3 | -10.05 | 10.94 | 21.65 | 1410.07 |
| 18:04 | axi2217__8in__inlet-thinsulate-4-layers__r27-inlet-thinsulate-4-layers | 11 | 15 | 1200 1500 1800 1900 2000 | 3 | -10.04 | 10.94 | 21.68 | 1408.58 |
| 18:36 | axi2217__8in__inlet-thinsulate-4-layers-rubber__r27-inlet-thinsulate-4-layers-rubber | 11 | 15 | 1200 1500 1800 1900 2000 | 3 | -10.11 | 10.94 | 21.73 | 1406.46 |
| 18:49 | axi2217__8in__inlet-felt__r27-inlet-felt | 11 | 15 | 1200 1500 1800 1900 2000 | 3 | -10.03 | 10.94 | 21.73 | 1406.62 |

## 2026-11-04  (1 prop runs, 0 loudspeaker runs)

| Time | Base / run | Mics | Steps | ESC µs or tones | Rep | Thrust N | V | A | rpm el. |
|---|---|---|---|---|---|---|---|---|---|
| 19:18 | axi2217__8in__inlet-petg-1-layer__r27-inlet-petg-1-layer | 11 | 15 | 1200 1500 1800 1900 2000 | 3 | -10.27 | 10.92 | 21.74 | 1407.39 |

## 2026-11-06  (3 prop runs, 0 loudspeaker runs)

| Time | Base / run | Mics | Steps | ESC µs or tones | Rep | Thrust N | V | A | rpm el. |
|---|---|---|---|---|---|---|---|---|---|
| 18:54 | axi2217__8in__inlet-transparent-wall__r27-inlet-transparent-wall | 11 | 15 | 1200 1500 1800 1900 2000 | 3 | -10.14 | 10.95 | 21.64 | 1408.71 |
| 19:06 | axi2217__8in__inlet-transparent-wall-thinsulate-2-layers__r27-inlet-transparent-wall-thinsulate-2-layers | 11 | 15 | 1200 1500 1800 1900 2000 | 3 | -10.12 | 10.95 | 21.66 | 1408.47 |
| 19:14 | axi2217__8in__inlet-transparent-wall-thinsulate-4-layers__r27-inlet-transparent-wall-thinsulate-4-layers | 11 | 15 | 1200 1500 1800 1900 2000 | 3 | -10.27 | 10.94 | 21.76 | 1406.04 |

## 2026-11-09  (7 prop runs, 0 loudspeaker runs)

| Time | Base / run | Mics | Steps | ESC µs or tones | Rep | Thrust N | V | A | rpm el. |
|---|---|---|---|---|---|---|---|---|---|
| 17:31 | axi2217__5in3b__thinsulate-4-layers__g5-thinsulate-4-layers | 11 | 15 | 1200 1500 1800 1900 2000 | 3 | -3.24 | 11.65 | 7.49 | 1804.23 |
| 17:35 | axi2217__5in3b__thinsulate-4-layers__g5-thinsulate-4-layers-trial-2026-11-09 | 11 | 15 | 1200 1500 1800 1900 2000 | 3 | -3.22 | 11.65 | 7.5 | 1800.96 |
| 18:33 | axi2217__5in3b__thinsulate-2-layers__g5-thinsulate-2-layers | 11 | 15 | 1200 1500 1800 1900 2000 | 3 | -3.27 | 11.65 | 7.49 | 1801.53 |
| 18:34 | axi2217__5in3b__thinsulate-2-layers__g5-thinsulate-2-layers-trial-2026-11-09 | 11 | 15 | 1200 1500 1800 1900 2000 | 3 | -3.19 | 11.62 | 7.96 | 1780.87 |
| 18:40 | axi2217__5in3b__thinsulate-2-layers__g5-thinsulate-2-layers-confirm-2026-11-09 | 11 | 15 | 1200 1500 1800 1900 2000 | 3 | -3.16 | 11.6 | 8.49 | 1785.6 |
| 19:20 | axi2217__5in3b__duct-unlined__g5-duct-unlined | 11 | 8 | 1200 1500 1800 1900 2000 | 2 | -3.18 | 11.61 | 8.21 | 1777.19 |
| 19:25 | axi2217__5in3b__duct-unlined__g5-duct-unlined-full-2026-11-09 | 11 | 15 | 1200 1500 1800 1900 2000 | 3 | -3.24 | 11.59 | 8.66 | 1779.51 |
