asdfgh0318/SoundVisualizer/docs/overview.html

# SoundVisualizer

Drone-noise directivity measurement — 6× UMIK-2 vertical arc + Tyto 1585 thrust stand

MVP complete · 10/11 phases done · RPi 5 packaging shipped · Norsonic deferred (hardware pending)

## Hardware status

Device | Role | Connection | Status
6× miniDSP UMIK-2 | Acoustic capture (vertical arc) | USB hub → laptop or RPi 5 | Available
Tyto Robotics 1585 | Thrust / torque / current / RPM | USB serial → laptop or RPi 5 | Available
Norsonic NOR-145 | Class-1 SLM (optional cross-check) | WiFi (WS + FTP) | Pending delivery
Raspberry Pi 5 | Production host (consolidates all hardware) | USB + WiFi to laptop browser | Available

## Architecture

#### Frontend

Laptop browser

- React 19 + Vite 7 + TypeScript
- Tailwind 4, Zustand 5
- Plotly.js (FFT, polar, custom)
- API client + WebSocket telemetry

HTTP + WS

#### Backend

Laptop (dev) → RPi 5 (production)

- Python 3.12 + FastAPI + asyncio
- sounddevice — 6× UMIK-2 capture
- pyserial-asyncio — Tyto MSP serial (Paweł's RE)
- aioftp + websockets — Norsonic (later)
- Cutoff-trigger watchdog (current/V/RPM/thrust/torque/3× temp)
- Filesystem JSON+WAV store under data/

## Data store layout

data/
  <motor>__<propeller>__<shroud>__<notes>/    # key dir, fields sluggified
    key.json                                  # {motor, propeller, shroud, notes}
    measurements/
      2026-05-06T14-22-01__acoustic__top__mic-8100002/
        meta.json    # type, t_start, t_end, mic_serial, elevation_deg,
                     # azimuth_deg:null, sample_rate, calibration_file, pwm_setpoint
        audio.wav
      2026-05-06T14-22-01__performance/
        meta.json    # type:"performance", t_start, t_end, pwm_setpoint
        telemetry.csv
      2026-05-06T14-22-01__norsonic/             # later
        meta.json
        norsonic.txt
        norsonic.json

## Phased plan

0

### Repo split Done

server/ directory scaffolding alongside React frontend. Paweł's six Python modules vendored.

No hardware needed

1

### Server skeleton + DB Done

FastAPI app, filesystem store, OpenAPI types, Pydantic schemas for setup config + measurement metadata.

No hardware needed

4

### UMIK-2 capture Done

sounddevice multi-stream, REW-format calibration parser, server-side trigger-onset sync, udev rule generator. Audio device list filtered to ALSA (hw:…) only.

UMIKs (have)

3

### Tyto integration Done

Paweł's msp.py/thrust_stand.py wired up. Calibration constants overridden at runtime from config.toml. Cutoff watchdog (all 8 channels, latching). Live telemetry over /tyto/ws/telemetry. Serial-link drops are detected and reconnected automatically — PWM returns at idle, in-flight capture runs fail loudly.

Tyto + UMIKs (have)

2

### Frontend rebuild Done

Legacy Web Audio + spinorama stripped. Rebuilt Setup page: manual USB-path picker, mic list with add/delete, per-mic cal upload, cutoff-trigger config UI, live Tyto status.

No hardware needed

5

### Capture wizard Done

Motor/propeller/shroud/notes form → PWM ramp with live SVG visualization (per-step recording_ms) → safety modal → one pass, every configured mic recording simultaneously → done. The backend still accepts the legacy top/bottom halves, but the wizard has not driven that flow since single-pass became the default. Landing Intro page, RCbenchmark wording (tare, ESC signal, safety cutoffs), ⓘ parameter help. Synthetic data via POST /dev/seed only.

Full stack

7

### Results — FFT tab Done

Per-PWM-point page with performance header strip and scrollable per-mic FFT rows. Inline bar for FFT size and overlap (the window is fixed Hann, shown as text).

Data only

8

### Results — Polar tab Done

SPL-vs-elevation polar. 180°/360° toggle, scroll zoom + Reset view, mic-arc schematic beside the plot. Top+bottom merge combines sibling captures at the same PWM µs. Right rail: range + 1/3-octave + octave selectors with snap-to.

Data only

9

### Results — Custom tab Done

Plotly.js port of Paweł's Bokeh viz. X/Y scatter with column pickers (PWM/thrust/torque/current/voltage/RPM/temp/SPL-in-band). Clicking a point snaps FFT and Polar tabs to that PWM step. Selected-point FFT overlay below the scatter.

Data only

6

### Norsonic Deferred

Wire Paweł's norsonic.py/norsonic_fetcher.py/norsonic_parser.py. Capture flow integrates NOR start/stop into per-PWM windows.

NOR-145 (pending delivery)

10

### RPi 5 packaging Done & deployed

Live on a Pi 5 (Debian 13 Trixie) at http://sound-viz.local:8000. Native systemd service (deploy/soundvis.service) on system Python 3.13 — no pyenv (all deps have aarch64 wheels). Deploy from the laptop via scripts/deploy_to_pi.sh (builds bundle locally, ships it — no Node on the Pi); scripts/setup_rpi.sh is the dist-aware on-device installer. Pi 5's RP1 chip has real USB 3.0 — no VL805 workaround. Bring-up docs in deploy/README.md.

RPi 5 (live)

## Locked decisions

No azimuth. Tested objects are rotationally symmetric around the vertical axis. Elevation is the only spatial dimension. The 360° polar view is purely cosmetic mirroring of the 180° measured arc.

6 mics, 2 configurations. "Top half" / "bottom half", both fully user-defined per-mic in Setup. The user manually re-mounts mics between captures. No hardcoded pairing.

Filesystem JSON+WAV store. No SQL. Keys are motor__propeller__shroud__notes directories under data/.

Paweł's code is ours. Full permission granted by the user (2026-05-06) to copy/edit. msp.py, thrust_stand.py, norsonic*.py reused wholesale.

Calibration constants are unit-specific. Paweł's HINGE_DISTANCE, CAL_* values are correct for this user's 1585 but get exposed via config.toml rather than hardcoded.

Trigger-onset sync stays. UMIK-2s cannot be hardware-clock-locked. Existing JS implementation moves into Python server-side — no new alignment strategy.

Cutoff triggers: all 8 channels. Current, voltage, RPM, thrust, torque, temp0/1/2 — each tickbox-enabled with threshold. Server watchdog at ~33 Hz slams PWM to 1000µs on any trip.

FFT defaults. Hann window, 4096 size, 50% overlap, log-x 20 Hz–24 kHz, dBSPL after UMIK calibration (dBFS fallback). 48 kHz sample rate.

Reference docs: CLAUDE.md · PLAN.md · 2.md (original scope)
