asdfgh0318/SoundVisualizer/docs/analysis/chamber-final-2026-10-01/slides/chamber-slides-final.pptx

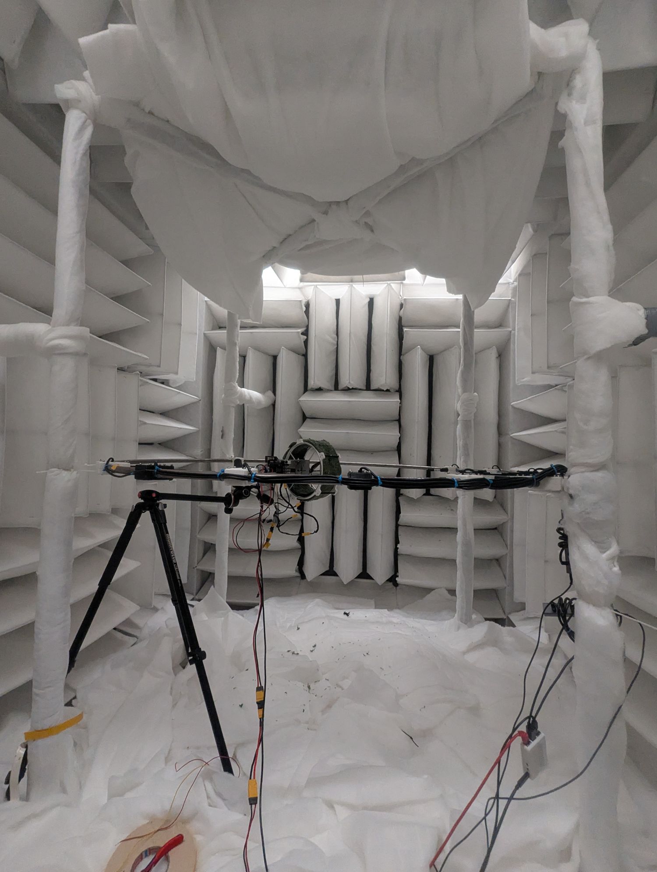
[picture p26: figure]
The chamber in its current set-up: the microphone ring laid flat around the propeller rig, speaker tripod on the left, absorbing material on floor, ceiling and walls

Chasing a round polar

Our chamber in its current set-up (5 Oct 2026): eleven microphones on a ring around the source, absorbing material on floor, ceiling and walls.

Notes: Intro slide. The photo (komora_05_10_26.jpg) shows the chamber in the final configuration (carpet-reordered): the microphone ring laid flat around the propeller rig at the hub, the loudspeaker tripod on the left, batting on the floor and ceiling, wedges and lined pillars on the walls. Ring diameter 1.68 m (radius 0.84 m), eleven UMIK-2 microphones.

## Slide 2

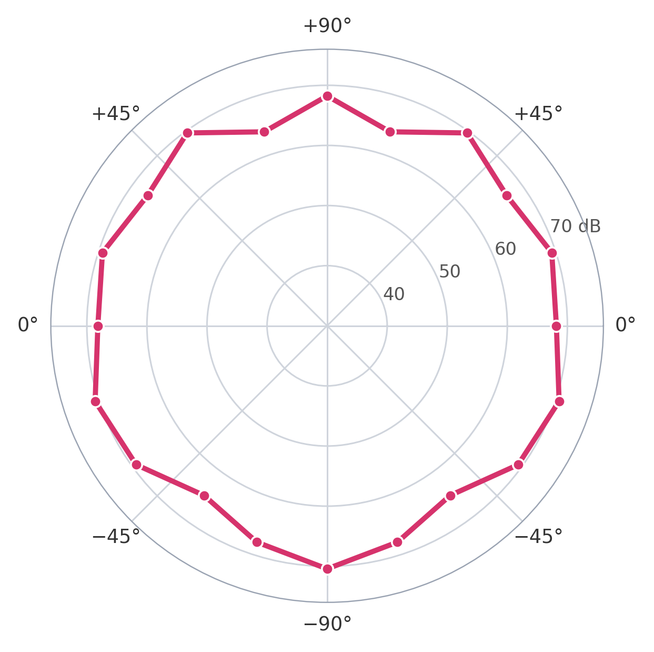
[picture p27: figure]
Polar plot of the 31 Aug propeller measurement, 20 to 560 Hz, with a jagged outline

31 Aug 2026, 20–560 Hz, motor at 2000 µs. Radial axis 30–76 dB, the same as in the report.

THE PROBLEM

Our polar plot is jagged

- We measured a propeller with the microphone arc in a plane parallel to the propeller disc.
- A propeller is symmetric around its axis, so every microphone should read about the same.
- We expected a smooth, nearly round polar. We observed a jagged outline.

6.7 dB

between the loudest and quietest of the eleven microphones

2

Notes: Data: the 31 Aug 2026 horizontal baseline (arc laid flat, propeller axis vertical), propeller at PWM 2000, total level 20-560 Hz per microphone, read with the factory calibration files as it was measured. Rms spread about the mean 2.05 dB, range 6.7 dB (63.9 to 70.6 dB SPL). The radial axis is 30-76 dB, the same as the report polars, so the same red curve can be shown against the 30 Sep measurement on a later slide. On a 0-80 dB axis the same curve looks rounder.

## Slide 3

THE FIX

What we did: every microphone, one loudspeaker

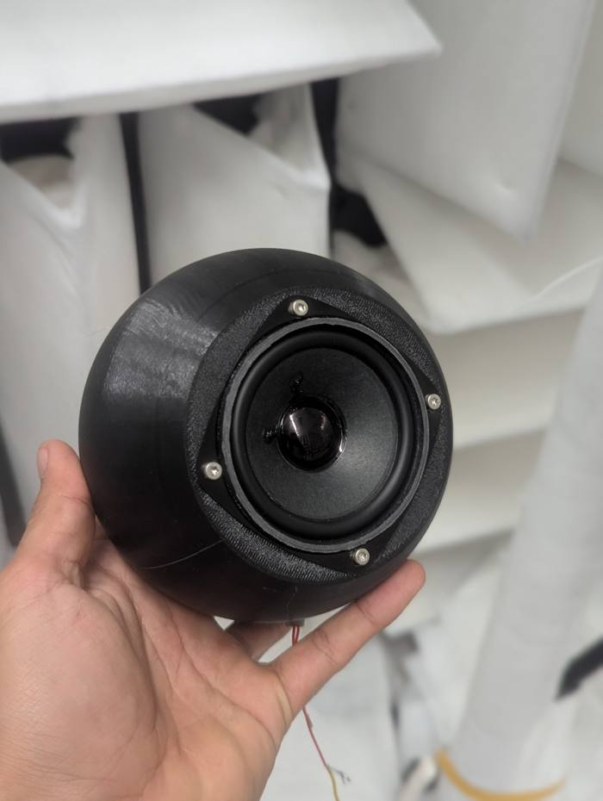
[picture p28: figure]
Our loudspeaker: a printed sphere with an 8 cm driver

Our loudspeaker

tones, 62 Hz–16 kHz

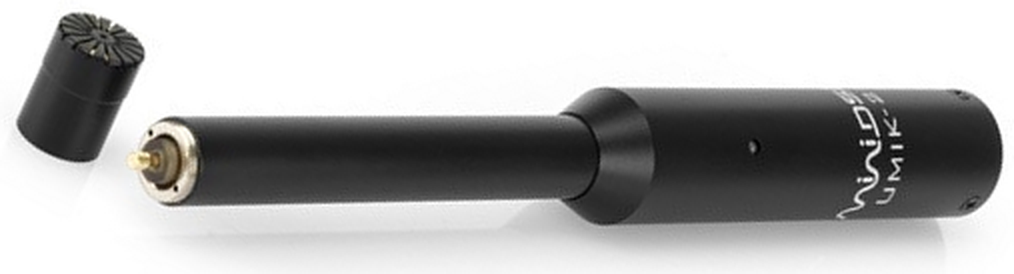
[picture p29: figure]
UMIK-2 measurement microphone, capsule end on the left facing the loudspeaker

UMIK-2 microphone, capsule faces the loudspeaker

- 97 tones per microphone, 62 Hz to 16 kHz, 12 per octave (a stepped sweep)
- One tone at a time: 0.7 s to settle, then 2 s recorded (6 s below 250 Hz)
- Microphones swapped in turn: same position, same loudspeaker, same level
- One microphone measured three times as the reference

Calibration session 16 Sep 2026, loudspeaker amplitude 0.03 of full scale. UMIK-2 photo: miniDSP product brief.

4.01 → 0.02 dB

spread across the eleven microphones for the same sound

7 of 11 factory files were off by 0.8–2.6 dB on average

3

Notes: Procedure (calibrator/session.py, 2026-09-16 session): each of the eleven UMIK-2 capsules was plugged in at the same mounting point in front of the loudspeaker and measured over 97 stepped tones, 62 Hz to 16 kHz (about 12 per octave), amplitude 0.03, 48 kHz sampling, 0.7 s settle and 2 s capture per tone (6 s below 250 Hz). Capsule 810-8904 was measured three full times (18:21, 18:30, 20:43) as the reference. The difference of each capsule from the reference was folded into its calibration curve; Sens Factors kept as in the factory files. The datum is the mean of four capsules whose factory files agree with measurement (810-8900, 810-8903, 811-1896, 811-2321). Spread 4.01 to 0.02 dB is from the project notes: a same-session check, since the corrections come from this session, and the absolute level is not anchored (that needs a 94 dB calibrator). Seven capsules have a mean offset beyond 0.6 dB over frequency, between 0.76 and 2.59 dB; the worst single frequency is 3.48 dB (811-1892), from CORRECTIONS-2026-09-16.csv. Seven capsules had a mean offset beyond 0.6 dB (811-1892 -2.6, 811-1897 -1.4, 811-2310 -0.8, 810-8897 +0.8, 810-8901 +0.8, 810-8904 +0.9, 810-8893 +1.3). Absolute level is not anchored: that needs a 94 dB calibrator.

## Slide 4

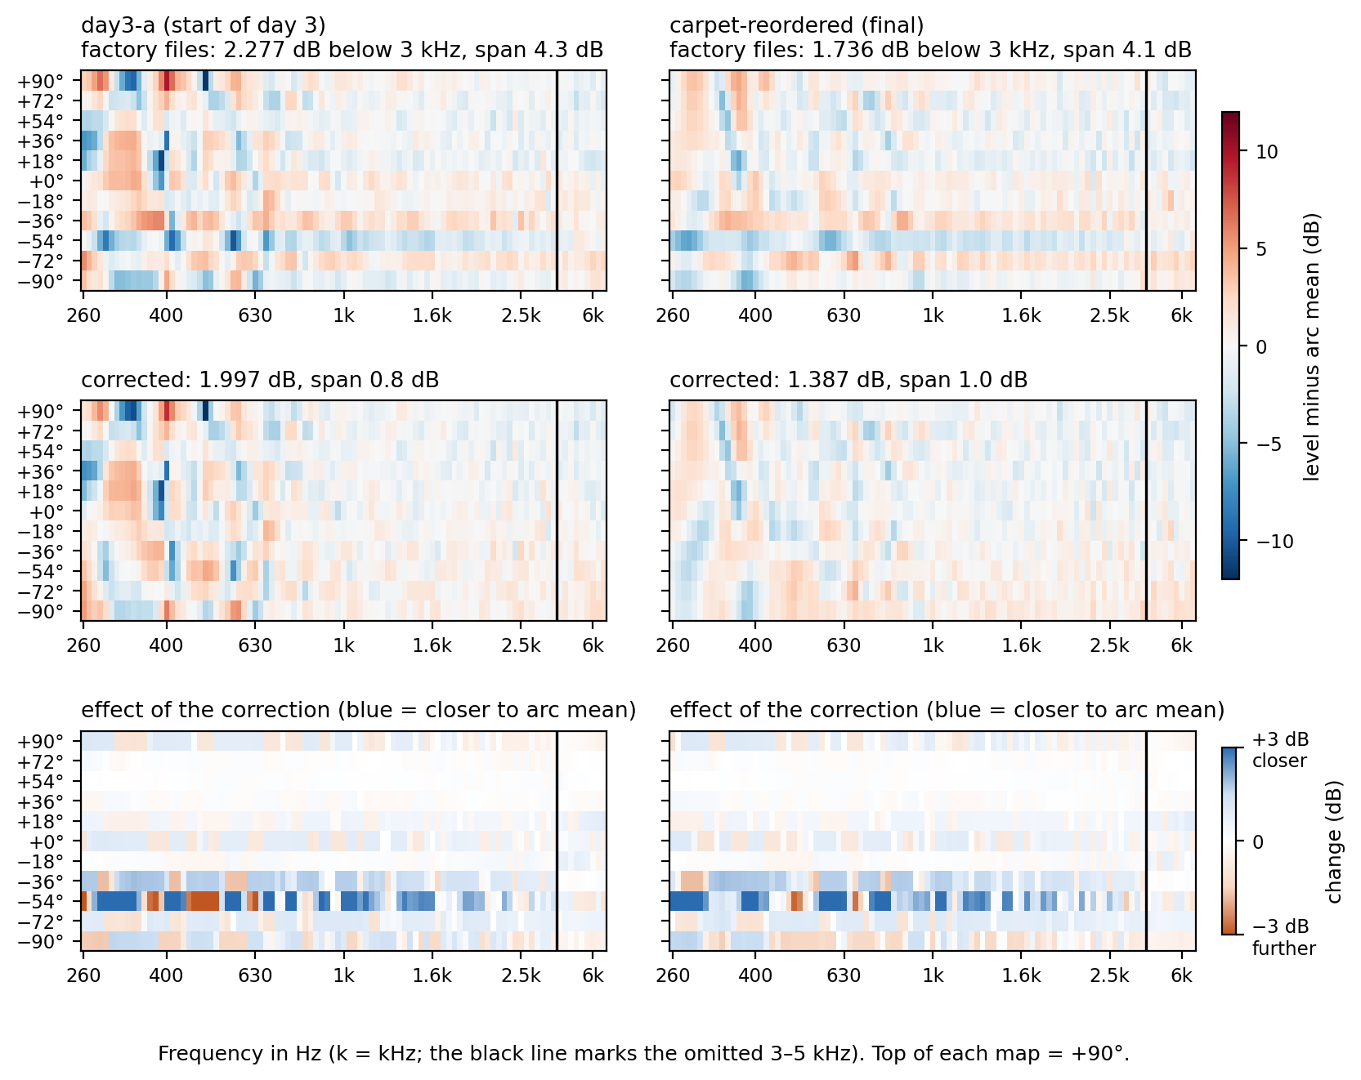
[picture p30: figure]
Maps of each microphone against frequency for two captures: factory files (top), corrected (middle), effect of the correction (bottom)

Two captures from 25 Sep 2026: the start of day 3 (left) and the final configuration (right).

THE RESULT

The correction removes the microphone offsets

- Top: factory files. Middle: corrected. Bottom: what the correction changed.
- A stripe across all frequencies is one microphone reading too loud or too quiet. The middle row has none.
- The room pattern stays: whole rows move, not the frequency structure.

4.3 → 0.8 dB

gap between the loudest and quietest microphone for the same sound: factory files → corrected (start of day 3; final state 4.1 → 1.0 dB)

4

Notes: Same figure as chapter 1 of the report, redrawn larger. The same two captures were calibrated two ways: with the factory files and with the corrections measured on 16 Sep. The span is the range of the capsules mean levels: 4.3 to 0.8 dB at the start of day 3, 4.1 to 1.0 dB in the final configuration. Room error below 3 kHz: 2.277 to 1.997 dB and 1.736 to 1.387 dB. The change is mainly a per-capsule offset, so it mainly moves whole rows.

## Slide 5

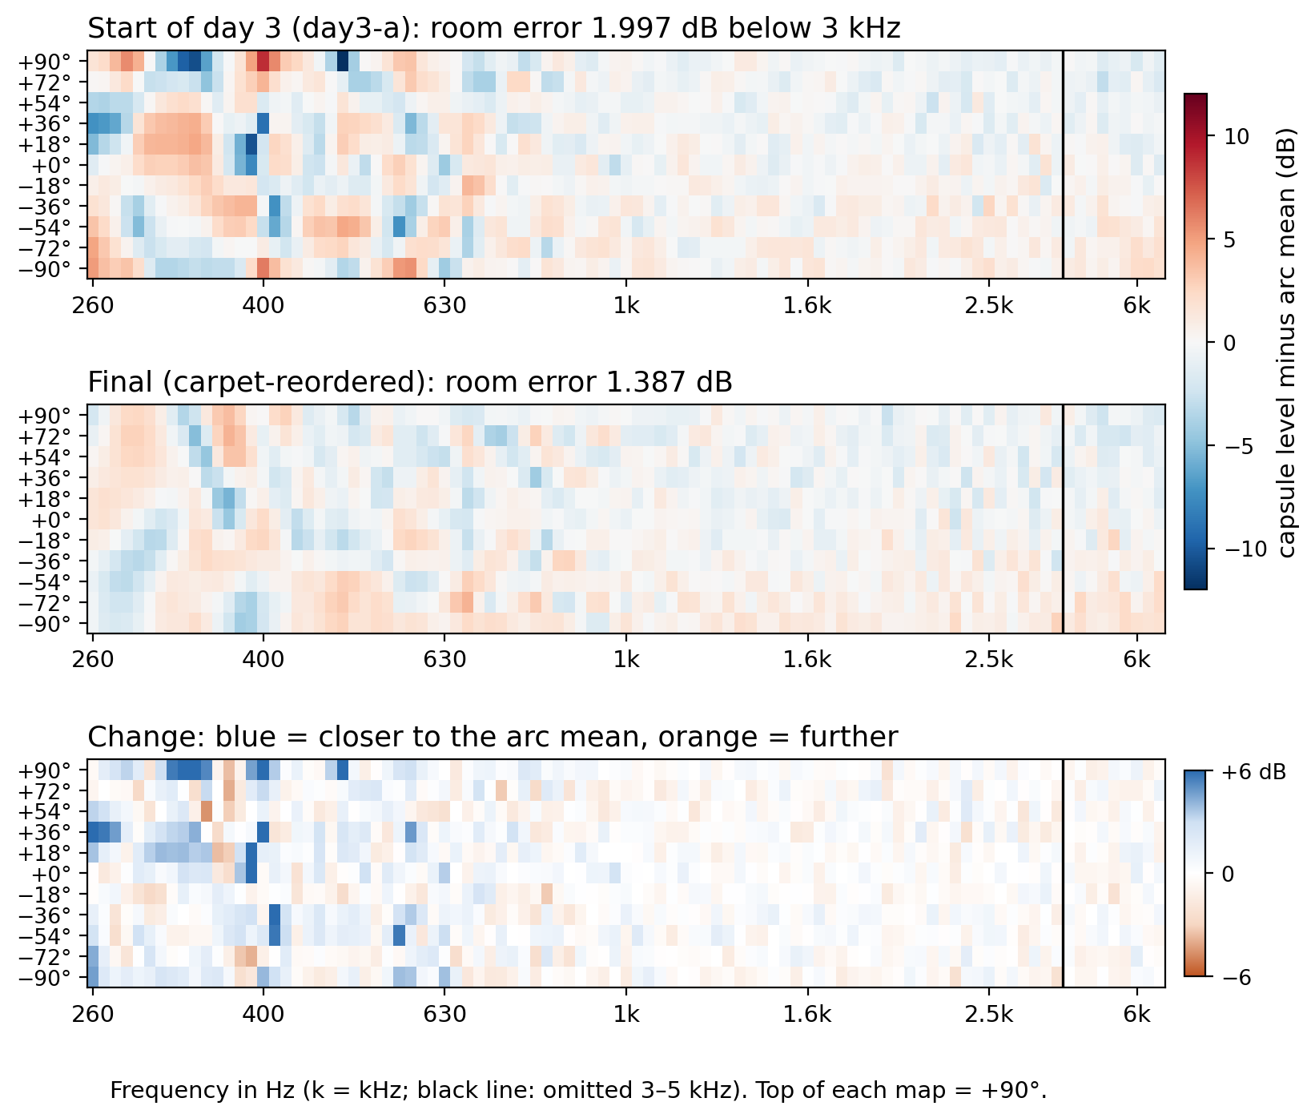
[picture p31: figure]
Maps of each microphone against frequency: start of day 3, final state, and the change between them

25 Sep 2026. The loudspeaker was moved during the day and returned to about its starting point; the position was not documented. Room error: rms difference of the eleven microphones from their average.

THE CHAMBER

The treatments flatten the low end

2.00 → 1.39 dB

room error below 3 kHz

We improved the low end (below 630 Hz) by 1.2 dB: the error fell from 3.0 to 1.8 dB, 40 % lower. Above 1 kHz only marginal changes.

5

Notes: Same pair as page 3 of the report (day3-a at 13:17, carpet-reordered at 19:15, both 25 Sep), read with the corrected microphone files. Room error is the rms deviation of the eleven microphones from their mean, per band. Below 630 Hz the rms room error fell from 2.98 to 1.78 dB (1.2 dB, 40 %); between 1 and 3 kHz it went 0.84 to 0.91 dB. Start of day 3: 3.33, 2.57, 1.57, 0.80, 0.87, 1.04 dB; final: 1.99, 1.52, 1.47, 0.85, 0.96, 1.17 dB for the bands 250-400, 400-630, 630-1000, 1000-1600, 1600-3000 and 5000-6400 Hz. Caveat from the report: the loudspeaker was moved on purpose during the day (20 cm closer, into the ring plane, 5 cm back) and then returned to about its starting mounting point, which was not recorded. The tilt of the map changed from -0.41 to -0.63 and the mean level rose 1.16 dB, so the gain is the treatments plus a small unknown difference in source position, and part of it may be the louder direct sound. The clean pair with an unmoved source is 24 Sep: empty floor 2.054 to carpet 1.317 dB.

## Slide 6

Band | Limit | Tones | Start of day 3 | | Final
Hz | ± dB | per band | worst mic, dB | cells in limit | worst mic, dB | cells in limit
250 | 1.5 | 3 | 6.81 | 36 % | 1.88 | 52 %
315 | 1.5 | 8 | 3.46 | 28 % | 0.89 | 56 %
400 | 1.5 | 8 | 3.46 | 41 % | 1.41 | 59 %
500 | 1.5 | 8 | 1.93 | 41 % | 1.99 | 59 %
630 | 1.5 | 8 | 0.93 | 43 % | 1.49 | 61 %
800 | 1.0 | 8 | 0.87 | 60 % | 1.12 | 55 %
1000 | 1.0 | 9 | 1.08 | 71 % | 0.57 | 73 %
1250 | 1.0 | 8 | 0.54 | 83 % | 1.02 | 73 %
1600 | 1.0 | 8 | 0.69 | 75 % | 1.15 | 76 %
2000 | 1.0 | 8 | 0.66 | 84 % | 0.77 | 82 %
2500 | 1.0 | 8 | 0.82 | 64 % | 0.75 | 65 %
5000* | 1.0 | 4 | 1.24 | 73 % | 1.23 | 64 %
6300* | 1.5 | 5 | 1.59 | 78 % | 1.77 | 76 %

THE EVALUATION

Band by band against the ISO tolerance

Colour key

0

at the limit

2× or more

Worst microphone as a share of the limit. Cells: green 100 %, yellow 50 %, red 0 %.

Bands clearly over (of 13): 7 → 6
Cells in limit (13 bands): 60 % → 66 %

* Partial bands: only the tones above 5 kHz are measured (4 and 5 tones). 3–5 kHz is left out because of the loudspeaker: its cone has a rocking mode near 4.4 kHz. ISO values are an analogue, not a qualification of the room.

6

Notes: Same table as page 4 of the report. Each one-third-octave band is judged against the anechoic tolerance values of ISO 5305 Table 1 (also ISO 3745 as printed by Cunefare 2003): +-1.5 dB for 125-630 Hz, +-1.0 dB for 800-5000 Hz. The number is the worst microphone band-mean deviation from the arc mean, in dB; the colour is that number as a share of the limit. Cells in limit counts tone x microphone cells inside the limit (3 tones x 11 microphones = 33 cells at 250 Hz, where the grid starts at 257 Hz). This is an analogue: the standards use a traverse and test decay with distance, we use eleven fixed microphones at one radius. The room is treated and not qualified. Within the tolerance values from 1250 Hz at the start of day 3 and from 2000 Hz in the final state, up to 2500 Hz. The rows marked * (5000 and 6300 Hz) are partial: 4 and 5 tones above 5 kHz, the limit is +-1.0 dB at 5000 Hz and +-1.5 dB at 6300 Hz (ISO 5305 Table 1). Both are over the limit in both states (1.24 and 1.23 dB; 1.59 and 1.77 dB). The 3150 and 4000 Hz bands are not shown: no tones between 3 and 5 kHz because of the rocking mode of the sphere at about 4.4 kHz. Caveat: the loudspeaker position was not documented across the day.

## Slide 7

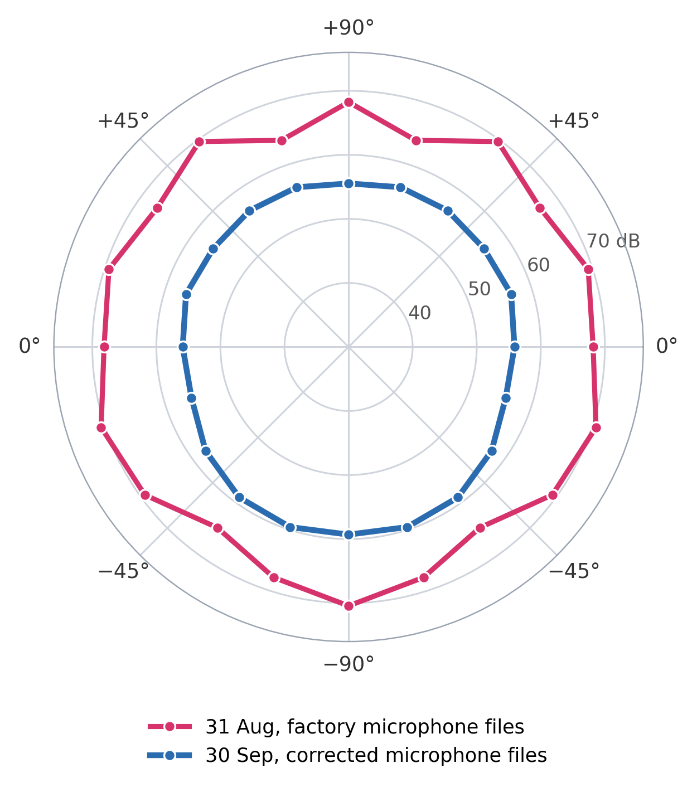
[picture p32: figure]
Polar plot of 20 to 560 Hz: the jagged red 31 Aug outline and the smoother blue 30 Sep outline

COMPARISON

31 Aug and 30 Sep on the same axes

- Red: 31 Aug, factory microphone files. Blue: 30 Sep, corrected files. Two different propellers.
- The propeller was mounted the other way round between the two, so the thrust points the other way. We do not expect this to change the sound.
- The 30 Sep outline is smoother.

6.7 → 4.0 dB

between the loudest and quietest microphone

20–560 Hz, motor at 2000 µs. Different propellers and run conditions, so the levels are not comparable; compare the shapes.

7

Notes: Blue: 30 Sep propeller measurement (11.7 V, 7.3 A, thrust -4 N), read with the 16 Sep microphone corrections. Rms spread about the mean 1.45 dB against 2.05 dB for 31 Aug; range 4.0 dB (55.5 to 59.6 dB SPL) against 6.7 dB. The blue is about 11 dB lower, but this cannot be attributed to the supply voltage (the blue run had the higher voltage): the two runs used different propellers, and the thrust direction was reversed, so the levels are not comparable. The 4 dB range of the blue is a bottom-louder trend. Honest caveat: with the same calibration applied to the 1-2 Sep runs, those are about as round as 30 Sep, so most of the improvement against the earlier baselines comes from the microphone calibration, not the room.

## Slide 8

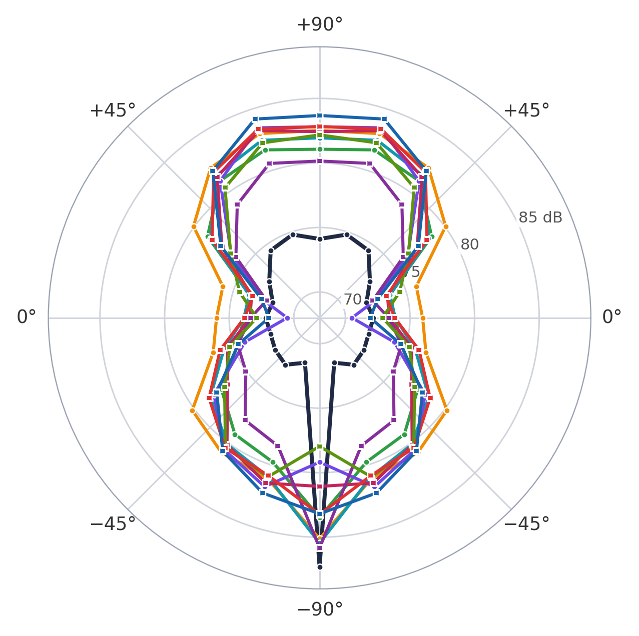
[picture p33: figure]
Polar plot of ten material set-ups at 2000 microseconds, total level 500 Hz to 24 kHz: bare, cork, rubber, felt, felt with rubber, felt with PU foam, PU foam, double PU foam, 4 and 8 layers of Thinsulate

2 and 7 Oct 2026, 5-inch 3-blade propeller, total level 500 Hz–24 kHz, motor at 2000 µs, corrected microphone files. Radial axis 68–89 dB.

THE MATERIALS

Materials at 2000 µs

Mean level. Round markers: 2 Oct. Square: 7 Oct.

Bare

PU foam

2 Oct

7 Oct

74.2 dB

77.6 dB

Felt + rubber

2 Oct

78.2 dB

PU foam, double layer

Cork

7 Oct

2 Oct

78.2 dB

78.6 dB

Inner felt + outer PU foam

Thinsulate, 8 layers

7 Oct

7 Oct

78.8 dB

79.2 dB

Felt

2 Oct

79.3 dB

Thinsulate, 4 layers

Rubber

7 Oct

2 Oct

79.4 dB

80.3 dB

+3.4 to +6.2 dB

louder than bare, on average (bare measured 2 Oct)

8

Notes: Bases in the data repo. 2 Oct 2026: 2004__5in3b__unset__v1-naked-horizontal (bare), ...cork__v1-cork-horizontal, ...rubber__v1-rubber, ...felt__v1-felt, ...felt-rubber__v1-felt-rubber. 7 Oct 2026 (axii__5in3b__...): inner-felt-outer-open-pore-pu-foam, open-pore-pu-foam, open-pore-pu-foam-double-layer, thinsulate-4-layers, thinsulate-8-layers. Each capture is the PWM 2000 step; level per microphone is the total level 500 Hz to 24 kHz in dB SPL (was 100 Hz to 10 kHz on the earlier version of this slide), read with the corrected microphone files (all after 16 Sep). The polar is mirrored to 360 degrees. Mean over the eleven positions. The bare reference is from 2 Oct, so the 7 Oct materials are compared across days: the differences from bare are indicative, not a controlled comparison. The earlier 100 Hz-10 kHz version had a strong lobe at -90 degrees (94-98 dB); with the band from 500 Hz it is 78-87 dB and fits on the plot. Operating points (voltage, thrust) were not compared here.

## Slide 9

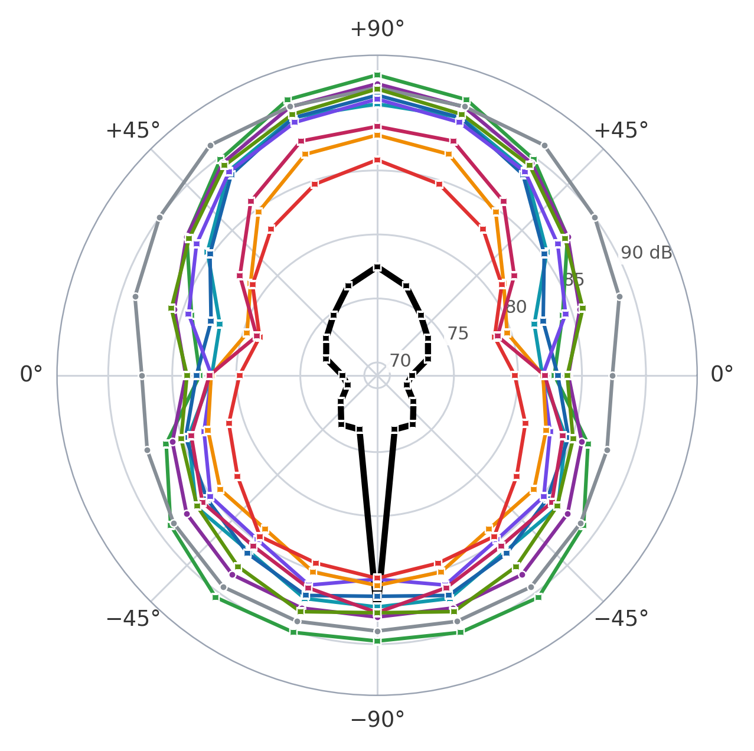
[picture p34: figure]
Polar plot of ten membrane set-ups at 2000 microseconds, total level 500 Hz to 24 kHz

8 and 9 Oct 2026, 5-inch 3-blade propeller, 500 Hz–24 kHz, 2000 µs, mean of 3 repeats, corrected files. Axis 69–94 dB. Not comparable with slide 8.

THE MEMBRANES

Membranes at 2000 µs

Mean level. Round markers: 8 Oct. Square: 9 Oct.

Bare prop

Thinsulate, 4 layers

9 Oct

9 Oct

75.1 dB

82.8 dB

Thinsulate, 2 layers

Thinsulate, 8 layers

9 Oct

9 Oct

84.0 dB

85.0 dB

Felt + rubber

Felt

9 Oct

9 Oct

86.0 dB

86.3 dB

Felt, double layer

Duct + PU foam, double

9 Oct

9 Oct

86.4 dB

87.5 dB

PU foam

Cork

8 Oct

9 Oct

87.9 dB

88.5 dB

up to 10.2 dB

best against worst membrane set-up (Thinsulate, 4 layers and Duct, membrane only), at +18°; 6.7 dB on average

Thrust at 2000 µs: bare prop 3.75 N. The quietest other set-up, Thinsulate 4 layers, only 0.39 N.

Duct, membrane only

8 Oct

89.5 dB

9

Notes: Bases in the data repo (f30__5in3b__membrane-...): 8 Oct 2026: membrane-duct-small, membrane-open-pore-pu-foam. 9 Oct 2026: membrane-duct-open-pore-pu-foam-double-layer, membrane-felt, membrane-felt-double-layer, membrane-cork, membrane-felt-rubber, membrane-thinsulate-8-layers, -4-layers, -2-layers. Each base was captured with 3 repeats of the ramp; the plot uses the PWM 2000 step and the mean over the 3 repeats of the total level 500 Hz to 24 kHz per microphone, in dB SPL, read with the corrected microphone files. The repeat-to-repeat scatter of the mean level is 0.02-0.11 dB. The bare prop (base f30__5in3b__unset__v1-bare-prop, 9 Oct 16:10, 3 repeats) is the reference for this set-up and the quietest curve on average (75.1 dB), 7.7 dB below the quietest membrane set-up on average, but at -90 degrees it is 87.7 dB, level with the others. Thrust at 2000 us (median of the second half of each step, mean of 3 repeats, magnitude; the stand reads negative): bare prop 3.75 N; membrane set-ups 0.37-1.19 N (Thinsulate 2 layers 0.37, Thinsulate 4 layers 0.39, felt double 0.88, felt 0.95, duct membrane only 0.97, PU foam 1.03, duct + PU foam double 1.03, felt + rubber 1.09, Thinsulate 8 layers 1.10, cork 1.19), so every membrane set-up delivers 10-32 % of the bare thrust and the levels are not at equal thrust. Levels here are not comparable with slide 8 (different motor field in the base name, f30). The callout is the difference between the quietest (best: Thinsulate, 4 layers) and the loudest (worst: duct, membrane only) set-up: 10.2 dB at its largest, at +18°, and 6.7 dB on average over the eleven microphones. Per angle the difference runs from 4.1 dB at -90 degrees to 10.2 dB at +18 degrees; the largest spread across all ten set-ups at a single angle is the same 10.2 dB. Two of the bases are ducts. The polar is mirrored to 360 degrees.
