asdfgh0318/SoundVisualizer/docs/analysis/chamber-final-2026-10-01/slides/hemi-slide.pptx

Band | Limit | Tones | Bare floor
Hz | ± dB | per band | worst mic, dB | cells in limit
250 | 2.5 | 3 | 5.71 | 52 %
315 | 2.5 | 8 | 2.60 | 52 %
400 | 2.5 | 8 | 2.05 | 70 %
500 | 2.5 | 8 | 2.25 | 68 %
630 | 2.5 | 8 | 1.64 | 82 %
800 | 2.0 | 8 | 1.42 | 72 %
1000 | 2.0 | 9 | 0.89 | 82 %
1250 | 2.0 | 8 | 0.72 | 90 %
1600 | 2.0 | 8 | 1.39 | 93 %
2000 | 2.0 | 8 | 0.98 | 94 %
2500 | 2.0 | 8 | 0.81 | 86 %
5000* | 2.0 | 4 | 1.77 | 95 %
6300* | 3.0 | 5 | 1.36 | 100 %

BARE FLOOR

Against the hemi-anechoic ISO values

Limits: ±2.5 dB up to 630 Hz, ±2.0 dB from 800 to 5000 Hz, ±3.0 dB at 6300 Hz. Colour: worst microphone as a share of the limit (yellow at the limit, red at twice).

2 of 13 bands over the limit · 80 % of cells in limit
Room error below 3 kHz: 2.05 dB

How the floor should look in a hemi-anechoic room

A hemi-anechoic room has a hard, reflecting floor, for example a concrete slab, with absorbing walls and ceiling. The floor is part of the intended sound field and is not treated. Ours is different: the foam base is still on the floor, so the floor still absorbs and this test is not a true hemi-anechoic one.

Bare floor: 24 Sep 14:05, wedges off the floor, flat foam base left. * Partial bands: tones above 5 kHz only; 3–5 kHz left out because of the loudspeaker. ISO values are an analogue, not a qualification. Hemi limits: Winker & Stahnke 2016, Table 1 (quoting ISO 3745:2012). Reflecting floor: Nardari 2019, p. 2.

Notes: Hemi-anechoic tolerance values of ISO 3745:2012 as printed in Winker and Stahnke 2016, Table 1 (and Kayhan 2008 p. 13): +-2.5 dB up to 630 Hz, +-2.0 dB for 800 to 5000 Hz, +-3.0 dB from 6300 Hz. They are looser than the anechoic values (+-1.5 / +-1.0 / +-1.5) used elsewhere. Bare floor = 2026-09-24/floor-no-wedges (14:05): wedges removed from the floor, the flat foam base left. A hemi-anechoic room has a reflecting floor (Nardari 2019, p. 2 describes a hemi-anechoic room whose walls and ceiling are foam-treated while the floor, a thick concrete slab, is left untreated and reflective), so this run is the nearest we have but not a true hemi test: a true one would remove the foam base as well. Method as in the colour table slide: worst microphone band-mean deviation from the arc mean, and the share of tone x microphone cells inside the limit.
