asdfgh0318/SoundVisualizer/docs/analysis/chamber-treatments-2026-09-23/TOP5-vs-best.pdf

# Chamber top-5 vs top performer (2026-09-23-25)

Room-error total <3kHz, dB, lower=flatter. Repeat 0.01dB, handling 0.04dB, overnight drift 0.1-0.2dB. Grid 95 tones 257Hz-6.35kHz, 3-5kHz excluded (sphere mode). Top = floor-carpet 1.277.

# | setup | total | bands 250-400/400-630/630-1k/1-1.6k/1.6-3k | vs top

1 | floor-carpet | 1.277 | 1.74/1.51/1.30/0.81/0.95 | 0
2 | cleanup-1/backed-5cm | 1.301/1.303 | 1.56/1.62/1.43/0.81/1.03 | +0.02
3 | closer | 1.311 | 1.99/1.28/1.29/0.86/0.97 | +0.03
4 | cleanup-2 | 1.314 | 1.61/1.72/1.40/0.79/0.98 | +0.04
5 | chaotic-carpet | 1.317 | 1.73/1.45/1.48/0.90/0.97 | +0.04

AVOID 250-400Hz (modes+floor) and 3-5kHz (sphere m=1, 11dB@4362Hz). TRUST 1-3kHz. 400Hz-1kHz use with per-position correction (du Plessis <0.55dB precedent; quarter-wave: cm porous = 3kHz treatment; gate 1.98ms -> valid >500Hz).

### floor-carpet.png

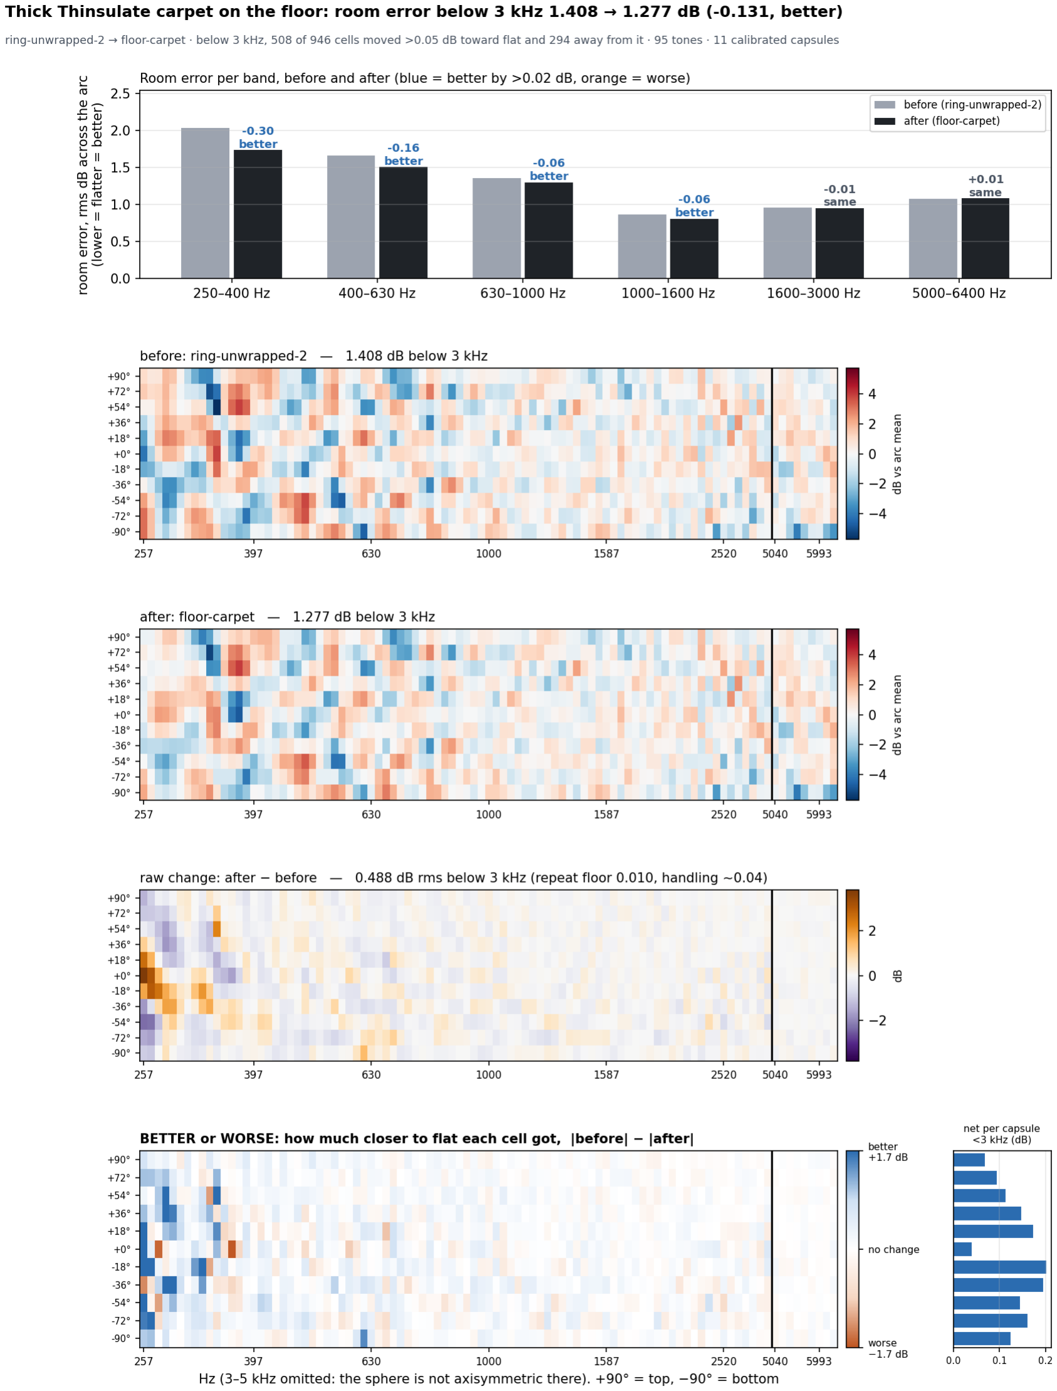
[picture p37: figure]

### carpet-floor-vs-ceiling.png

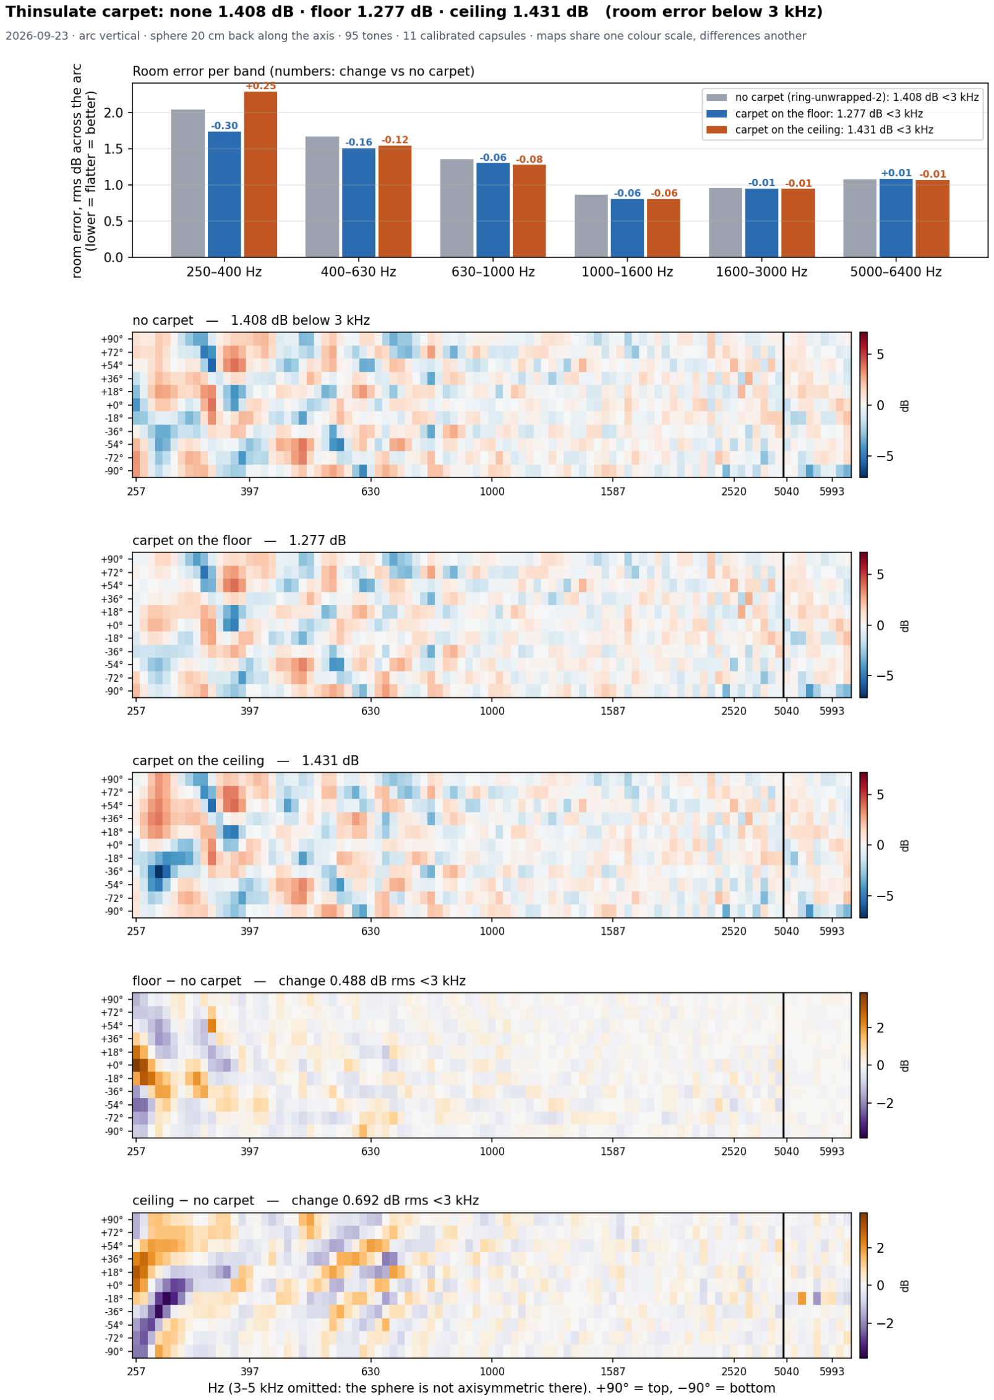
[picture p38: figure]

### backed-5cm-day3.png


### backed-5cm-vs-best-day3.png

### closer-day3.png

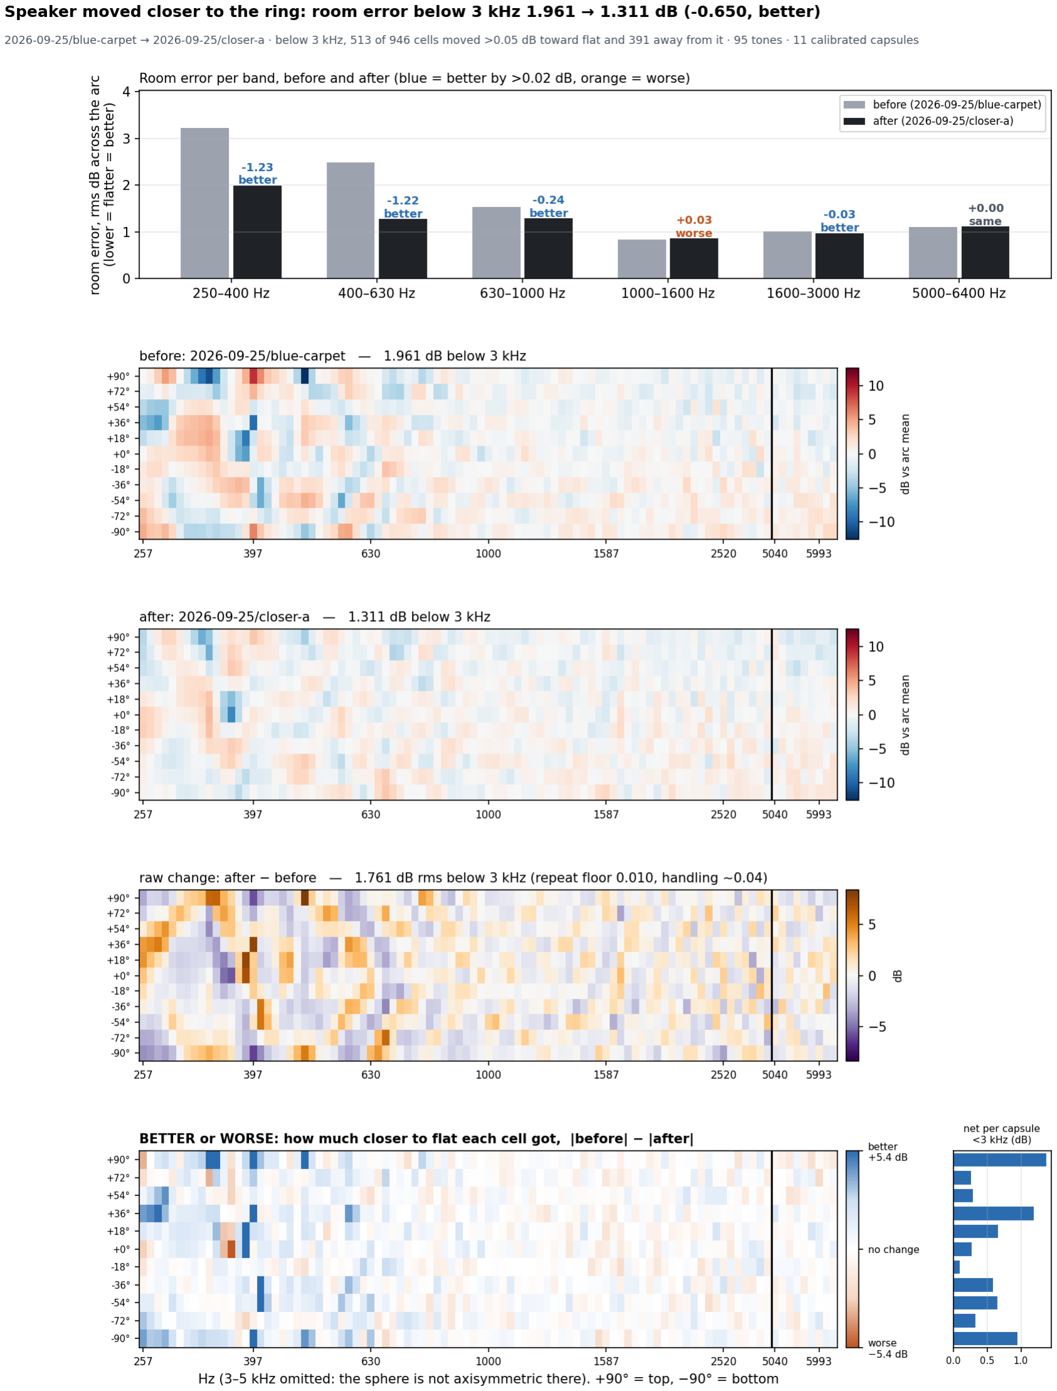
[picture p39: figure]

### closer-vs-best-day3.png


### cleanup-2-day3.png


### chaotic-carpet-vs-wedges-day2.png

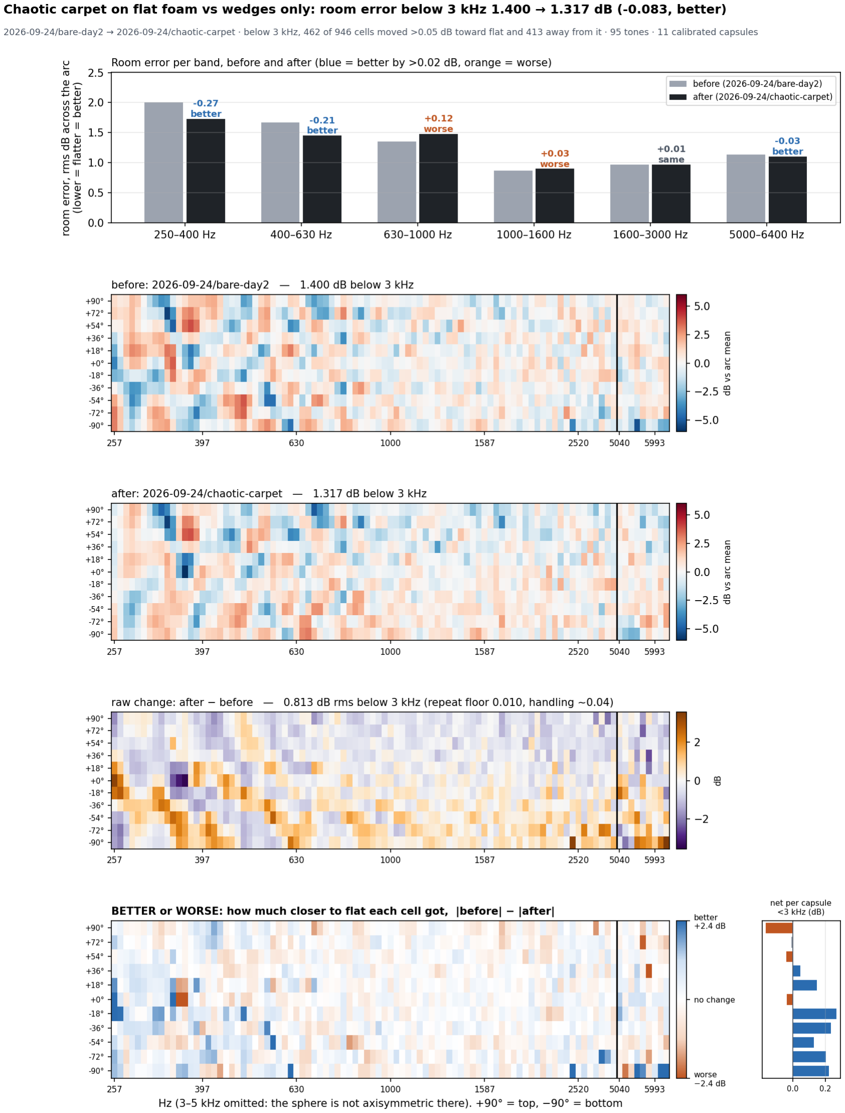
[picture p40: figure]

### chaotic-1-2-3-day2.png

### bare-day2.png

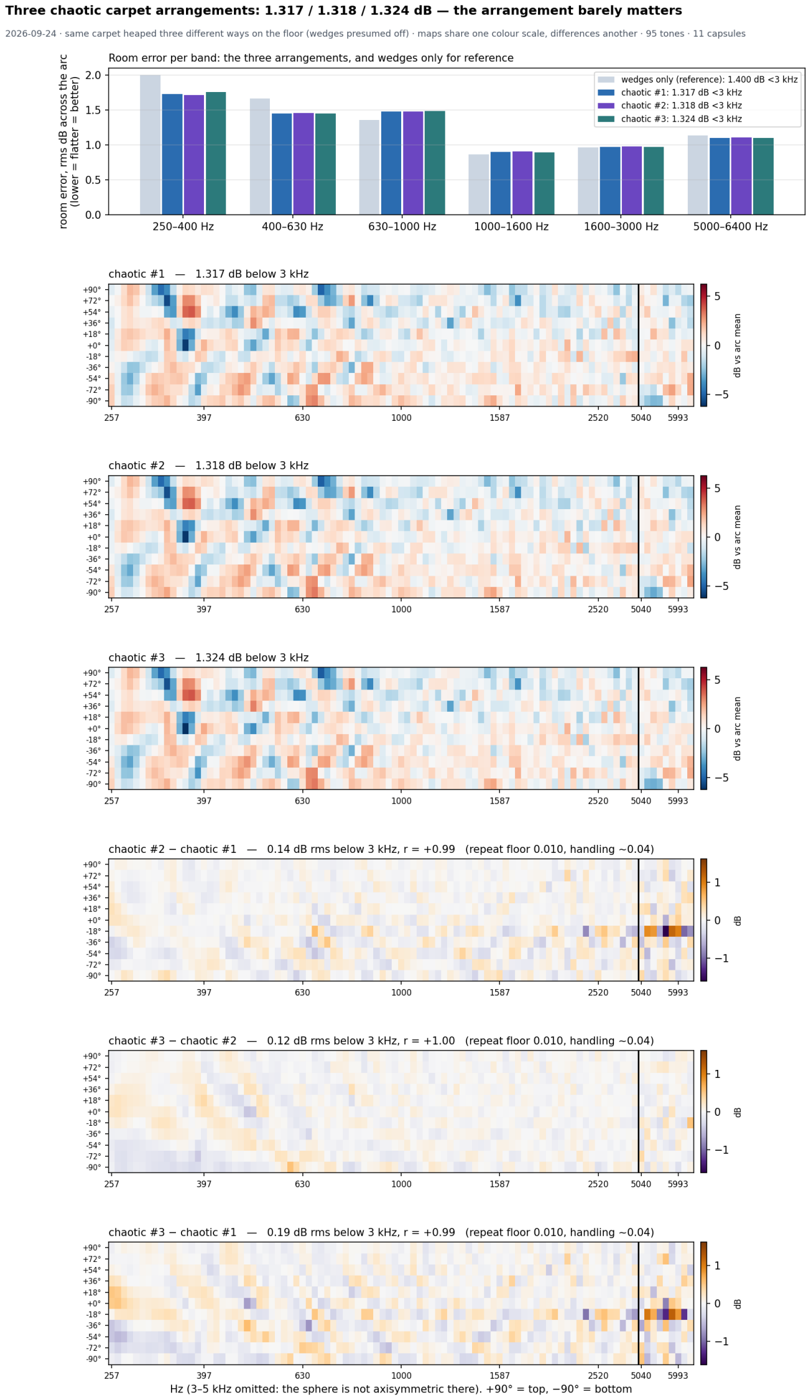
[picture p41: figure]
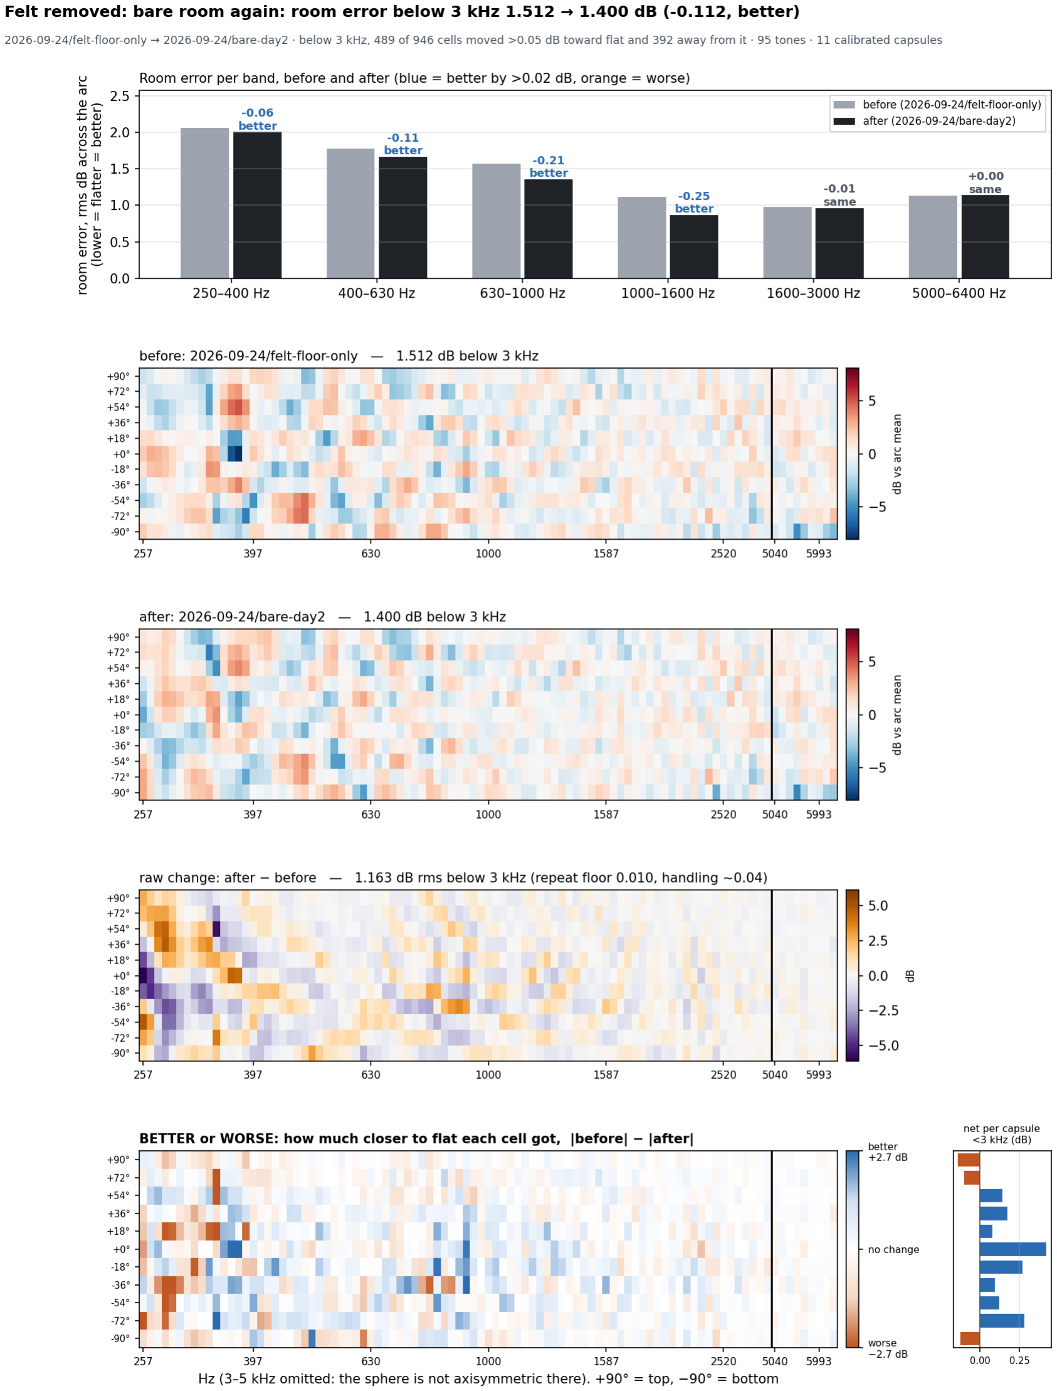
[picture p42: figure]

### floor-no-wedges-day2.png


### floor-states-compare.png
