asdfgh0318/SoundVisualizer/docs/analysis/chamber-treatments-2026-09-23/TOP5-vs-current.pdf

# Day3 one-page: reordered (1.387) + same-day states

carpet-reordered 1.387 | blue-carpet 1.961 | closer 1.311 | in-plane 1.473 | curtain 1.783 | material-roll 1.403
corner-stuffed 1.445 | screen-1-layer 1.626 | felt-wall 1.409 | carpet-only 1.393 | backed-5cm 1.303* | cleanup-1 1.301
cleanup-2 1.314 | cleanup-4 1.458 | cleanup-6 1.443 | carpet-removed 1.740 | carpet-square 1.779 | wall-thinsulate 1.955
thin-carpet-raised 1.778 | thick-carpet-raised 1.579 | thicker-carpet-raised 1.497 | full-carpet-raised 1.541
