asdfgh0318/SoundVisualizer/docs/analysis/chamber-final-2026-10-01/CHAMBER-FINAL.pdf

# 1 · Microphone calibration

SoundVisualizer · chamber report, 2026-10-05 · calibrator session 2026-09-16 (97 tones per capsule, amplitude 0.03)


The test loudspeaker: a printed 1-litre sphere with an 8 cm driver, placed at the hub (the centre of the ring).

Eleven UMIK-2 measurement microphones, called capsules in this report, sit on a ring of 1.68 m diameter (0.84 m radius). Each came with a factory calibration file, and nobody had checked these files against each other. On 16 Sep we measured every capsule in turn, one at a time, at the same mounting point in front of our loudspeaker, over a stepped frequency sweep: 97 tones from 62 Hz to 16 kHz, 12 per octave. One capsule (810-8904) was measured three full times (18:21, 18:30 and 20:43) as the reference. The loudspeaker, the room and the mounting point were the same for every capsule, so a difference between two curves comes from the capsules.
Seven of the eleven factory files were off by 0.8–2.6 dB on average (3.5 dB at the worst single frequency). The errors are grouped by serial-number prefix.
Each capsule's difference from the reference was added to its calibration curve. The updated curves are called the corrections; the original curves are the factory files. For the same sound, the spread of the eleven readings fell from 4.01 dB to 0.02 dB. Repeated measurements agreed to 0.08 dB (standard deviation).
The reference level is set by the four capsules whose factory files agree with the measurement. Still open: the absolute level, which needs a 94 dB sound calibrator.
On the 30 Sep propeller-plane polar (chapter 3), the corrections reduced the roughness from 3.3 to 1.0 dB (a different statistic from the rms spread on page 5, defined in docs/analysis/baseline-story-2026-09-30/REPORT.pdf).

### Before and after, on two captures from this report

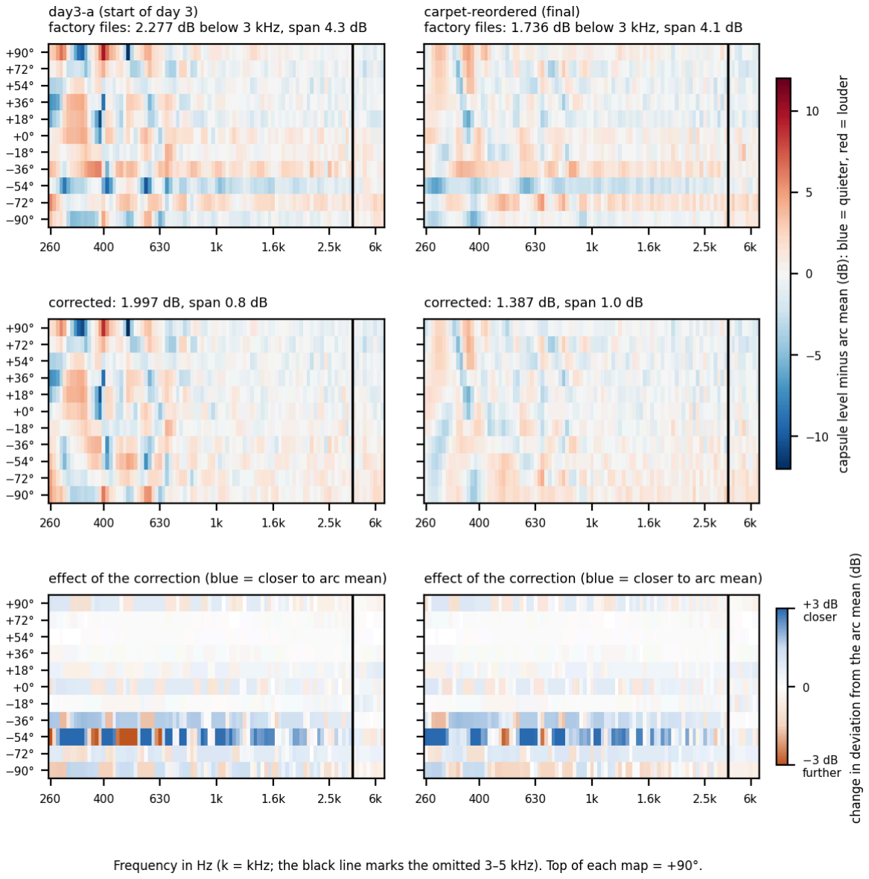
[picture p43: figure]

How to read the figure. Each map is one capture. Rows are capsule positions, columns are tones, and the colour is the capsule's level minus the mean of all eleven (the arc mean). Left: the start of day 3 (day3-a, 25 Sep). Right: the final configuration (carpet-reordered). Top row: read with the factory files. Middle row: read with the corrections. Bottom row: the effect of the correction. The factory files give each capsule a different offset, which shows up as horizontal stripes across every frequency. The span is the range of the capsules' mean levels. It changes from 4.3 → 0.8 dB at the start of day 3 and 4.1 → 1.0 dB in the final configuration. The room error is the rms deviation of the capsules from the arc mean, below 3 kHz. It changes 2.277 → 1.997 dB and 1.736 → 1.387 dB. The change is mainly a per-capsule offset. It therefore mainly moves whole rows and leaves the frequency pattern of the room in place. Every room-error number elsewhere in this report uses the corrected files.
The numbers on this page come from the project notes (CLAUDE.md in the repository) and the calibrator session of 2026-09-16. Where this page and the notes differ, the notes govern.

# 2 · Main waterfall and the day 3 evaluation


2.1 The chamber

The chamber in the final configuration (carpet-reordered, photographed 5 Oct). The microphone ring lies flat around the propeller rig at the hub. The loudspeaker tripod stands on the left. Batting covers the floor and the ceiling; wedges and lined pillars line the walls. The waterfall on the next page compares the start of day 3 with this state.

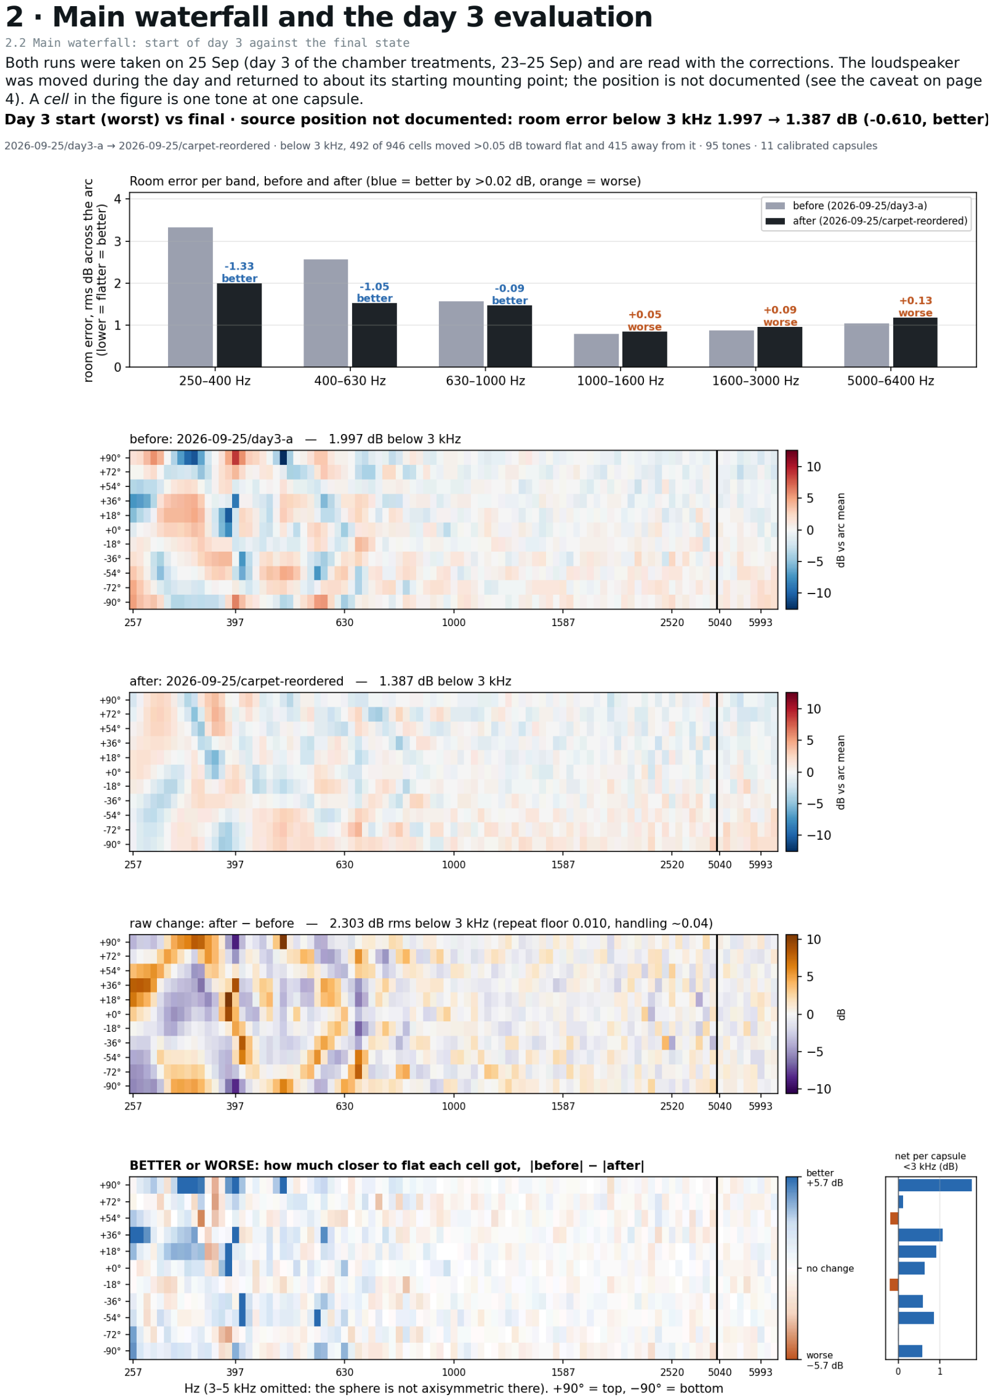
[picture p44: page 3]

2.2 Main waterfall: start of day 3 against the final state
Both runs were taken on 25 Sep (day 3 of the chamber treatments, 23–25 Sep) and are read with the corrections. The loudspeaker was moved during the day and returned to about its starting mounting point; the position is not documented (see the caveat on page 4). A cell in the figure is one tone at one capsule.

2.3 Evaluation against the ISO anechoic tolerance values (an analogue, not a qualification)
11 calibrated capsules on an arc of 0.84 m radius · 95 tones, 257 Hz–6.35 kHz · runs: 25 Sep, day3-a (13:17) → carpet-reordered (19:15)

### The method

Taken from the standards. Each one-third-octave band is judged on its own against the free-field ideal. The standards judge tones and noise separately. Here both measures come from the stepped tones; the band level stands in for the noise test. In each band the worst position is compared with the limit. The limits are the anechoic tolerance values: ±1.5 dB for 125–630 Hz and ±1.0 dB for 800–5000 Hz (ISO 5305:2024 Table 1, p. 8). Cunefare et al. 2003 give the same values (J. Acoust. Soc. Am. 113(2), p. 882; quoted on page 6). ISO 3745:2012 and ISO 26101 are the two qualification procedures; Russo et al. 2018 compare them.
Specific to this rig, not taken from the standards. The standards move one microphone along a line away from the source (a traverse) and test how the level falls with distance. Only that test allows a room to be called "qualified" or "in conformity" (ISO 26101-1 p. 3; ISO 3745 §5.1). This rig has eleven fixed capsules at one radius. It tests how uniform the level is around a source that radiates the same way in every direction about its axis. The reference is therefore the arc mean, and the same tolerance values are applied to a different quantity.
The two measures. Band level: for each capsule, the mean deviation over the 3–9 tones in the band (only 3 at 250 Hz, because the grid starts at 257 Hz and covers only the top of that band); the worst capsule is compared with the limit. Pure tones: the share of tone × capsule cells inside the limit. A band within ±0.03 dB of its limit is called marginal. This margin is the largest difference found between two runs of one unchanged state on the same day (5 pairs).
What the result means. The room is treated, not qualified. The result is a figure of merit that ranks the bands. It claims neither qualification nor conformity. The standards were available as previews only: ISO 3745:2012 (clauses 1–6.1.2, no annexes), ISO 26101-1 and ISO 5305.

Cell = one tone at one capsule. "Cells in limit" is the share of cells inside the limit. Example, 250 Hz at the start of day 3: 3 tones ×
11 capsules = 33 cells; 12 are inside ±1.5 dB, which is 36 %. The deviation columns give the worst capsule's band-mean deviation in dB; their colour shows it as a share of the limit.
BAND | LIMIT (DB) | TONES (× 11 CAPSULES) | DAY 3 START (DB) | CELLS IN LIMIT | FINAL (DB) | CELLS IN LIMIT
250 Hz | ±1.5 | 3 | 6.81 | 36 % | 1.88 | 52 %
315 Hz | ±1.5 | 8 | 3.46 | 28 % | 0.89 | 56 %
400 Hz | ±1.5 | 8 | 3.46 | 41 % | 1.41 | 59 %
500 Hz | ±1.5 | 8 | 1.93 | 41 % | 1.99 | 59 %
630 Hz | ±1.5 | 8 | 0.93 | 43 % | 1.49 | 61 %
800 Hz | ±1 | 8 | 0.87 | 60 % | 1.12 | 55 %
1000 Hz | ±1 | 9 | 1.08 | 71 % | 0.57 | 73 %
1250 Hz | ±1 | 8 | 0.54 | 83 % | 1.02 | 73 %
1600 Hz | ±1 | 8 | 0.69 | 75 % | 1.15 | 76 %
2000 Hz | ±1 | 8 | 0.66 | 84 % | 0.77 | 82 %
2500 Hz | ±1 | 8 | 0.82 | 64 % | 0.75 | 65 %
MEASURE | | | | DAY 3 START | | FINAL
Room error below 3 kHz (dB) | 1.997 | 1.387
Inside the tolerance values from this band up to 2500 Hz (highest
band evaluated)
| | | | 1250 Hz | | 2000 Hz
Bands clearly over the limit (of 11) | 5: 250, 315, 400, 500, 1000 Hz | 4: 250, 500, 800, 1600 Hz
Bands marginal (of 11) | 0: — Hz | 2: 630, 1250 Hz
Cells inside the limit, all bands | 58 % | 65 %

Colour. Deviation columns: the number is the worst capsule's band-mean deviation in dB; the colour shows it as a share of the band's limit (green 0, yellow at the limit, red at twice the limit or more). Cells-in-limit columns: green 100 %, yellow 50 %, red 0 %. The "from this band up" row is set by the highest failing band, so read it together with the two lists below it.

Caveat: the loudspeaker position is not documented for these two runs. During day 3 the loudspeaker was moved
on purpose (20 cm closer at 13:44, into the ring plane at 14:03, 5 cm back at 15:29) and then returned to about its starting mounting point. The final point was meant to repeat the starting one, but this was not recorded. The data show the match is not exact: the top-to-bottom tilt of the map went from -0.41 to -0.63 (a 5 cm move changes it by about 0.25) and the mean level rose by 1.16 dB. The map changed by 2.30 dB rms; for comparison, re-arranging the 24 Sep carpet (chaotic-carpet→chaotic-carpet-2) changed it by 0.14 dB and a 5 cm source move by 0.80 dB. The gain is therefore the treatments plus a small, unknown difference in source position. The final tilt is closer to the 24 Sep afternoon runs (-0.57 to -0.60). The one pair with a documented, unmoved source is from 24 Sep: empty floor 2.054 → carpet 1.317 (three carpet arrangements: 1.317 / 1.318 / 1.324).

# 3 · Polars: is the propeller-plane polar rounder than before?

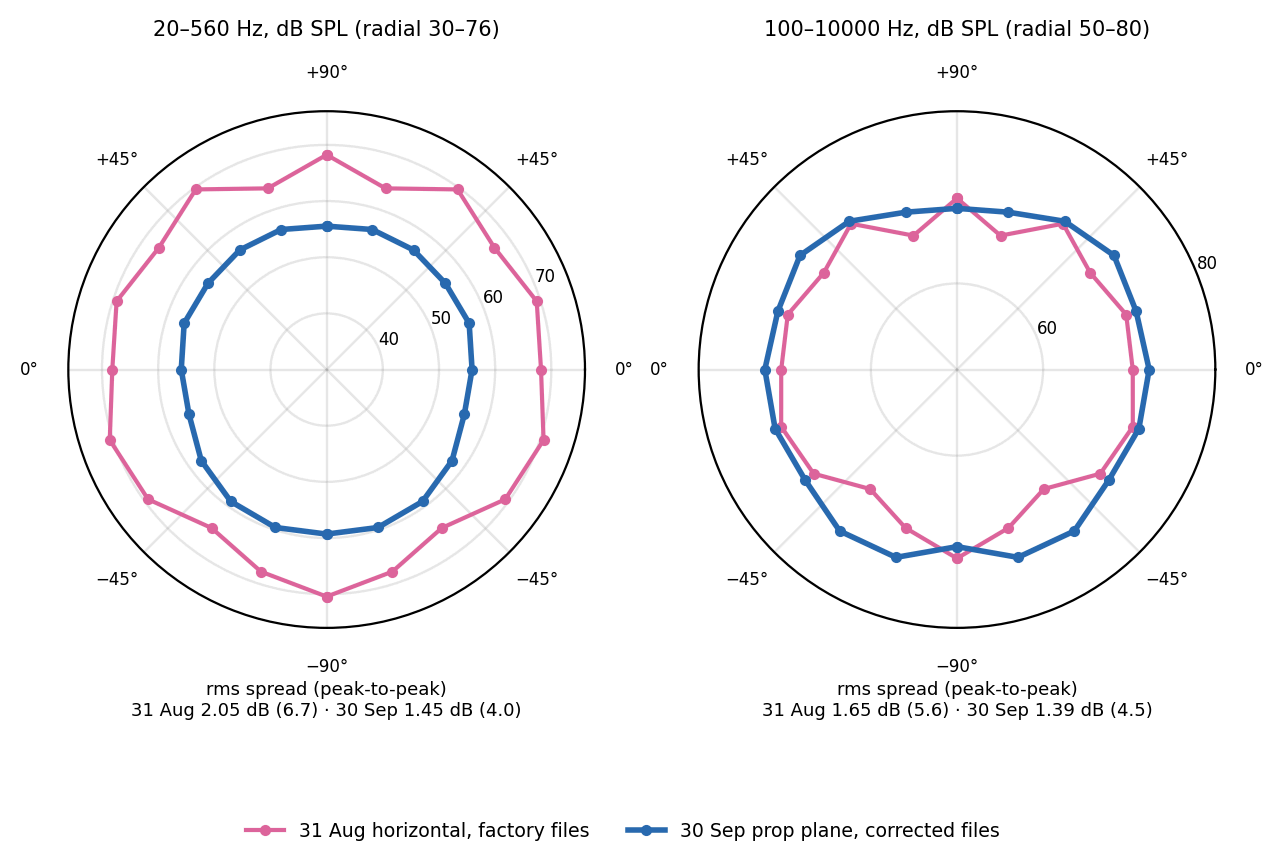
[picture p45: figure]

CAPSULE × BAND VALUES
WITHIN ±1.3 DB OF THE
POLAR MEAN
(BROADBAND, TONES
REMOVED, 315 HZ–8
KHZ) | RUNS PWM 2000: MEDIAN (RANGE) WORST DEVIATION (MEDIAN OVER RUNS) PWM 1900: MEDIAN (RANGE)
30 Sep (11.7 V),
corrections
1 | 66.1 % | 3.1 dB | 72 %

1–2 Sep, arc laid flat
(11.65 V, 7.3 A, −4.0 N),
factory files
10 | 61.5 % (58–64) | 4.4 dB | 61 % (58–68)

31 Aug, arc laid flat (7.35 V, 13.8 A, +6 N: other
operating point), factory
files
5 | 61.2 % (40–62) | 8.2 dB | 56 % (38–61)

for reference: 1–2 Sep re-read with the 16 Sep
corrections
10 | 70.9 % (65–79) | 3.4 dB | 76 % (65–84)

The figure draws the polars the way the app's Polar tab does. It shows the total level in the band at each capsule, at PWM 2000 (the motor throttle signal, 2000 µs), recomputed from the data. The angle is the capsule's position on the arc; the left half mirrors the right half. Each capture is read with the calibration that existed when it was taken: the factory files for 31 Aug and 1–2 Sep, the corrections for 30 Sep. The "before" curve is the 31 Aug baseline with the arc laid flat. It was taken with a different propeller and at another operating point (7.35 V against 11.7 V), so the two curves are not a controlled pair.
20–560 Hz is the low end; it contains the blade-passing tone at about 238 Hz. The rms spread of the total level across the capsules is 1.45 dB on 30 Sep, 2.05 dB on 31 Aug and 1.79 / 1.78 / 2.25 dB on 2 Sep (prop15 / 16 / 17). In this band 30 Sep has the smallest spread, but it is the only curve read with the corrections (see the reference row of the table). 100–10000 Hz: 1.39 dB on 30 Sep, 1.65 dB on 31 Aug and 1.18 / 1.29 / 1.30 dB on 2 Sep. In this band the 2 Sep runs have a slightly smaller spread than 30 Sep. The 2 Sep curves are not drawn; their spreads are given only in this text.
Broadband with the tones removed, 315 Hz–8 kHz (table). The level is taken in one-third-octave bands with the propeller tones cut out. On 30 Sep, 66 % of the capsule × band values lie within ±1.3 dB of the polar mean. The median is 62 % for 1–2 Sep (range 58–64) and 61 % for 31 Aug (range 40–62). The worst capsule is 3.1 dB off the mean on 30 Sep, against 4.4 and 8.2 dB. Part of this difference is the microphone correction. The same 1–2 Sep captures, re-read with the 16 Sep corrections, give 71 % (range 65–79), 30 Sep (66 %) lies inside that range but below its median. Read with the same calibration, the 30 Sep polar is not rounder than the 1–2 Sep polars. The gain over the factory-file readings comes from the calibration, not from the room.

### Which captures carry the microphone corrections

CAPTURE SET | DATE | CALIBRATION IT IS READ WITH
31 Aug horizontal baseline | 31 Aug, before the corrections | factory files
prop8–10 | 1 Sep, before the corrections | factory files
prop11–17 (prop15–17 used for the
spreads in the text)
2 Sep, before the corrections | factory files
30 Sep propeller-plane baseline | 30 Sep, after the 16 Sep microphone calibration

corrections (the only propeller capture in this report that has them)

The corrections were measured on 16 Sep (page 1). The earlier captures are shown as they were taken. The reference row of the table above re-reads 1–2 Sep with the corrections, to show how much of the gain comes from the calibration.

# 4 · Semi-anechoic room solutions that apply to this chamber

What fails in the final configuration (carpet-reordered, evaluated on its own): clearly over the limit at 250, 500, 800, 1600 Hz; marginal at 630, 1250 Hz. The blade-passing frequency (BPF, the blade tone) lies at 215–258 Hz; its third harmonic is at 713 Hz. The nearest measured reflections travel 0.68 m further than the direct sound at −72° and 1.49 m further at +36°/+54°, so they arrive 1.98 ms and 4.34 ms after it. Source of the table: docs/acoustic-speculations/chamber-fighting-guide.pdf, §03 (29 facilities).

SOLUTION | WHAT THE PAPERS GIVE | APPLIES HERE? | WHAT THE TRIALS SHOW

### 1. Change the

geometry (move the source, the arc or the reflecting object) | Limits what every other measure can reach. To work down to 500 Hz, every reflection must travel at least 0.69 m further than the direct sound; for 250 Hz, 1.37 m (a 4 ms gate; Matelján, ARTA application note 4, recommends 5 ms or more). | Yes; first, and at no cost. The 0.68 m reflection is just short of the 500 Hz requirement. | Source position had the largest effect in the trials: moving the loudspeaker about 20 cm closer reduced the room error from 1.96 to 1.31 dB within one afternoon (25 Sep).

### 2. Measured room

correction per position and tone | The source is measured once in a real anechoic chamber and again in the room, band by band: "the uncertainty in measurements is minimal (below 0.55 dB for frequencies above 200 Hz)" (du Plessis et al. 2022, p. 29). | Yes; the strongest option. Valid for a fixed source and fixed microphones, as on this arc. Not valid for a flying drone. | Needs a reference run in an anechoic chamber (the university's 300 m³ room). Invalid once a capsule is re- mounted: a 1 cm shift changes the response by ±6 dB at high frequency (Bellmann & Klippel, p. 7). Must be checked against the propeller at 200– 250 Hz (Mehrgou 2012, p. 34).

### 3. Average over

source speed | Room resonances (modes) distort pure tones most. A pattern that changes over a 19 % frequency step averages out over a speed ladder (a series of propeller speeds). No paper gives the remaining error. | Yes; low cost. The hardware exists; 12–15 PWM steps. | In the flat-arc runs, 8 dB dips in the tone pattern moved with a 19 % frequency step. The 30 Sep polar shape depends on speed outside 1.3–2 kHz.
4. Time gating | Only the sound that arrives before the first reflection is kept. The lowest usable frequency is about 1 / gate length: "the time-bandwidth requirement is satisfied on frequencies above 177.9Hz" for a 5.6 ms gate (Matelján, p. 8). | Only above 500 Hz: the gate here is 1.98 ms. | Useful to identify the surfaces behind the 0.68 m and 1.49 m reflections. Cannot reach the blade tone.
5. Absorb: foam,
wedges | An absorber about 34 cm deep is needed for 250 Hz; lowering the design frequency from 400 Hz to 100 Hz raises the cost per square metre about four times (Orrego et al. 2018, p. 477). With a reflecting floor the overall level deviates from the inverse- square law by up to 3 dB, and two adjacent microphones differ by up to 10 dB at the blade- passing frequency (Ma et al. 2022, p. 7). | Not at 250 Hz. Yes at 630–1000 Hz: about 10 cm on the surface the measurement identifies. | The floor under the arc and the source mattered most (empty floor 2.05 → carpet 1.32, same afternoon). The same material on the walls had no measurable effect.

### 6. Subwavelength

absorber (thin
compared with the
wavelength)

A 100 mm metasurface absorber: "99.2% absorptance at 239 Hz in experiment" (Long et al. 2020, Sci. Rep. 10:13823).

The only option that
reaches the blade
tone, but only if the
238 Hz error comes from
the room and not from
the stand.

Decide this first with the reverserotation capture (step 2 below).

### Order for this chamber

1. Record the room: hub height, room dimensions, and what stands within 1.5 m of the arc ends. Then move the object behind the 0.68 m reflection, or move the arc away from it.
2. Take one capture with the propeller turning the other way and everything else unchanged. This separates asymmetry caused by the stand from asymmetry caused by the room.
3. Measure the loudspeaker correction (solution 2) at the blade-tone frequencies (215–258 Hz and 713 Hz) for the eleven positions. Then compare it with the propeller at the same positions.
4. Run a speed ladder to average the tones. Then treat only the surfaces the sweep names (about 10 cm of foam at 630–1000 Hz).

### Microphone placement against the standards

Meets: far field, (kr)² ≈ 15 at 250 Hz, above 3 (k = wavenumber, r = ring radius). The ring radius, 0.84 m, is more than a quarter wavelength (λ/4) from 250 Hz up. The capsule axis is normal to the measurement surface (ISO 3745 §6.1.1). ISO 5305 requires R ≥ 5·DA

(radius at least five
times the diameter of the aircraft). This holds for the 137 mm sphere and for one 6-inch propeller, not for larger rotors.
Does not meet: the UMIK-2 is not a class 1 free-field microphone of type WS2F or WS3F (ISO 5305 §5.1, ISO 3745 §6.1.1). The ring, clamps and cables are supports without acoustic treatment. All capsules are at one radius, so the fall of level with distance is not tested.
Not recorded: the distance from the ring ends to the walls and the floor, the hub height, and ISO 5305 Hm (the distance from each microphone to the walls, floor and ceiling, or to the wedge tips).
"TABLE I. Maximum allowable difference in anechoic rooms between measured and theoretical free-field levels per ISO 3745 and ANSI S12.35."
Cunefare et al. 2003, J. Acoust. Soc. Am. 113(2), p. 882

### Where the accepted configuration stands, and what the method cannot say

Evaluated on its own (25 Sep): room error 1.387 dB, within the strict anechoic tolerance values from the 2000 Hz band up to the 2500 Hz band (the highest evaluated), 65 % of tone cells inside. Comparable rooms in the held papers (not the 63–275 Hz rotor chambers, which are better rooms): a 6.8 m³ low-cost box conforming to the ISO 3745 anechoic row from 500 Hz with one point 1.0 dB over (Orrego et al. 2018, p. 6); a 51 m³ room that passes with noise and fails with pure tones (Nash 2019); Amazon Prime Air's rotor room, ±1 dB only above 2.2 × BPF and ±4 dB below (Nardari 2019, p. 2). Rooms tested against the standard keep the strict row and publish the range that passes (Russo 2018: "in conformity" for a reduced range); rooms that cannot meet it use their own tolerance. We keep the strict row, as Orrego, Nash and Kayhan did, and report the failures. No held paper judges a room by the angular spread across a fixed ring.
Deviation from the arc mean is blind to an error shared by all eleven positions; the ISO traverse has not been run, so this ranks bands and does not certify. The anechoic table is used because the floor under the arc is absorbing.
Open, unexplained: a two-state switch in the source chain. The level at 5–6.35 kHz minus the level at 257–400 Hz takes one of two values and jumps by the same amount between some neighbouring runs: foam-2→foam-out -4.3, ceiling-carpet→ceiling-carpet-day2 (next morning) +4.4, ceiling1-floor2→felt-floor-only -4.1, chaotic-carpet-2→chaotic-carpet-3 +4.3, in-plane-b→curtain +4.6 dB. Within a day the loudspeaker device and amplitude did not change. It is not a source move (a 5 cm move changes the map by 0.80 dB, the 24 Sep flip by 0.12 dB), not moved absorber (room-only changes that afternoon moved the mean level by at most 0.13 dB), and not a gain or supply-voltage change (that would shift every frequency alike, and 257–400 Hz does not move). It cancels in the room error, which is relative to the arc mean. Still to check: cable, connectors, amplifier and supply (300 Hz and 5 kHz on live_tone while handling each).
The grid starts at 257 Hz; 3–5 kHz is excluded (sphere), 5–6.4 kHz indicative.
