asdfgh0318/SoundVisualizer/docs/analysis/chamber-treatments-2026-09-23/worst-vs-final-day3.pdf

250 400 Hz | 400 630 Hz | 630 1000 Hz | 1000 1600 Hz | 1600 3000 Hz | 5000 6400 Hz

0

1

2

3

4

room error, rms dB across the arc
(lower = flatter = better)

-1.33
better
-1.05
better

-0.09
better
+0.05
worse

+0.09
worse

+0.13
worse

Room error per band, before and after (blue = better by >0.02 dB, orange = worse)

before (2026-09-25/day3-a)
after (2026-09-25/carpet-reordered)
257 | 397 | 630 | 1000 | 1587 | 2520 | 5040 5993

+90°
+72°
+54°
+36°
+18°
+0°
-18°
-36°
-54°
-72°
-90°

before: 2026-09-25/day3-a 1.997 dB below 3 kHz

10

5

0

5

10

dB vs arc mean

257 | 397 | 630 | 1000 | 1587 | 2520 | 5040 5993

+90°
+72°
+54°
+36°
+18°
+0°
-18°
-36°
-54°
-72°
-90°

after: 2026-09-25/carpet-reordered 1.387 dB below 3 kHz

10

5

0

5

10

dB vs arc mean

257 | 397 | 630 | 1000 | 1587 | 2520 | 5040 5993

+90°
+72°
+54°
+36°
+18°
+0°
-18°
-36°
-54°
-72°
-90°

raw change: after before 2.303 dB rms below 3 kHz (repeat floor 0.010, handling ~0.04)

10

5

0

5

10

dB

257 | 397 | 630 | 1000 | 1587 | 2520 | 5040 5993
Hz (3 5 kHz omitted: the sphere is not axisymmetric there). +90° = top, 90° = bottom

+90°
+72°
+54°
+36°
+18°
+0°
-18°
-36°
-54°
-72°
-90°

BETTER or WORSE: how much closer to flat each cell got, |before| |after|

worse
5.7 dB

no change

better
+5.7 dB

0 1

net per capsule
<3 kHz (dB)

Day 3 start (worst, 1.997) vs the final configuration, same day: room error below 3 kHz 1.997 1.387 dB (-0.610, better)

2026-09-25/day3-a 2026-09-25/carpet-reordered · below 3 kHz, 492 of 946 cells moved >0.05 dB toward flat and 415 away from it · 95 tones · 11 calibrated capsules
