asdfgh0318/SoundVisualizer/docs/analysis/chamber-treatments-2026-09-23/SUMMARY-day3.pdf

# Chamber findings — day 3, top 5 setups

2026-09-25 (+ rerun 2026-09-30) · 95 tones 257 Hz–6.35 kHz, 3–5 kHz omitted · 11 calibrated capsules · sphere on the axis, arc vertical
Coefficient = room error below 3 kHz: rms over all tones and capsules of each capsule's level relative to the arc mean, dB, lower is flatter. Repeat floor 0.01 dB, handling ~0.04 dB, so the top four are tied (span 0.014 dB). The accepted last config is 0.086 dB behind the best, but that is the source, not the carpet: fitting out each map's top-to-bottom slope†, it scores 1.165 against 1.157 for cleanup-1. Today's rerun of the last config scored 1.399 (+0.013): consistent with the chamber still being in that state at 15:48.

SETUP

ROOM
ERROR
<3 KHZ | VS BEST | TILT
| | REMOVED† | 250–
| | | 400 | 400–
630 630–1K 1–1.6K 1.6–3K
| | | | | | | | QUALIFIED
| | | | | | | | FROM* | BANDS
| | | | | | | | | FAILED*
last config
2026-09-25/carpet-reordered
1.387 | +0.086 | 1.165 | 1.99 | 1.52 | 1.47 | 0.85 | 0.96 | 2000 Hz | 4

ACCEPTED (Adam, 2026-09-30) and the last configuration of day 3 (19:20): the full carpet on standoffs, layer order changed (bottom layer moved to the top).
cleanup-1
2026-09-25/cleanup-1
1.301 | — | 1.157 | 1.56 | 1.62 | 1.43 | 0.81 | 1.03 | 1000 Hz* | 3

BEST by score. The backed-5cm state with the loose felt sheets removed. backed-5cm
2026-09-25/backed-5cm
1.303 | +0.002 | 1.157 | 1.57 | 1.61 | 1.44 | 0.81 | 1.03 | 1000 Hz* | 3

Accepted on 2026-09-25, superseded by the last config: speaker backed off 5 cm from the ring plane, raised thick carpet. closer
2026-09-25/closer-a
1.311 | +0.011 | 1.183 | 1.99 | 1.28 | 1.29 | 0.86 | 0.97 | 315 Hz* | 1

Speaker moved ~20 cm closer to the ring, still on the axis; morning floor stack of day 3 (after the blue absorbing carpet was added). Repeat `closer-b` agrees to 0.006 dB.
cleanup-2
2026-09-25/cleanup-2
1.314 | +0.014 | 1.162 | 1.61 | 1.72 | 1.40 | 0.79 | 0.98 | 500 Hz | 2

The accepted state after more junk was removed (what, not stated).

†Per tone, the best-fit line in sin(elevation) across the eleven capsules is subtracted before scoring; this removes a tilted or shifted source, not a room effect. *ISO 3745 analogue on band levels, section 2. "Qualified from" = the lowest one-third-octave band from which no band up to 2.5 kHz is clearly over the limit (the way METU and others state a cut-off); * = that band is marginal. "Bands failed" is out of 11.
The single coefficient ranks cleanup-1 first, but it hides where the error is. Bands clearly over the limit, of 11: last config 4, cleanup-1 3, backed-5cm 3, closer 1, cleanup-2 2. Closer and cleanup-2 are the cleanest by that count although they score 0.01 dB behind.
Worst band: 250–400 Hz: last config, closer; 400–630 Hz: cleanup-1, backed-5cm, cleanup-2. Best band: 1000–1600 Hz: last config, cleanup-1, backed-5cm, closer, cleanup-2.
The source moved between cleanup-1 and the last config, in two steps. At cleanup-3 (16:20, some junk put back) the mean level rose +0.63 dB and never came back (cleanup-6: +0.65). At carpet-removed (17:23) the level fell to -0.37 dB and the tilt at 400 Hz–3 kHz flipped from top-louder (+0.49 dB per unit sin(el) at cleanup-6; cleanup-1 +0.43) to bottom-louder (-0.31); the last config sits at -0.63. The likely cause is the tripod standing on the floor stack (README, day 3): the sphere itself was not measured.
Different floors: closer was measured on the morning stack of day 3, the rest on later stacks. Across days the map drifts 0.1–0.2 dB even when the score does not.

### 2. Which frequencies to avoid

Rule, taken from how chambers are qualified. ISO 3745 compares the level at each one-third-octave band with the ideal and allows ±1.5 dB up to 630 Hz and ±1.0 dB from 800 Hz to 5 kHz (the same table in six independent papers). A chamber is then reported as qualified between two bands, with the lowest one its cut-off. Nash 2019 found a chamber that passed with random noise and failed with pure tones, so both are reported here.
What we changed. ISO compares a microphone traverse with the inverse-square law. We have eleven fixed positions and an axisymmetric source, so the reference is the arc mean. Two tests per band: band level (each capsule's mean over the ~8 tones in the band; worst capsule against the limit) and pure tones (share of individual tone×capsule cells inside the limit). Band verdicts within ±0.09 dB of the limit are marked marginal: that is how far the same statistic moved between the last config and its rerun.

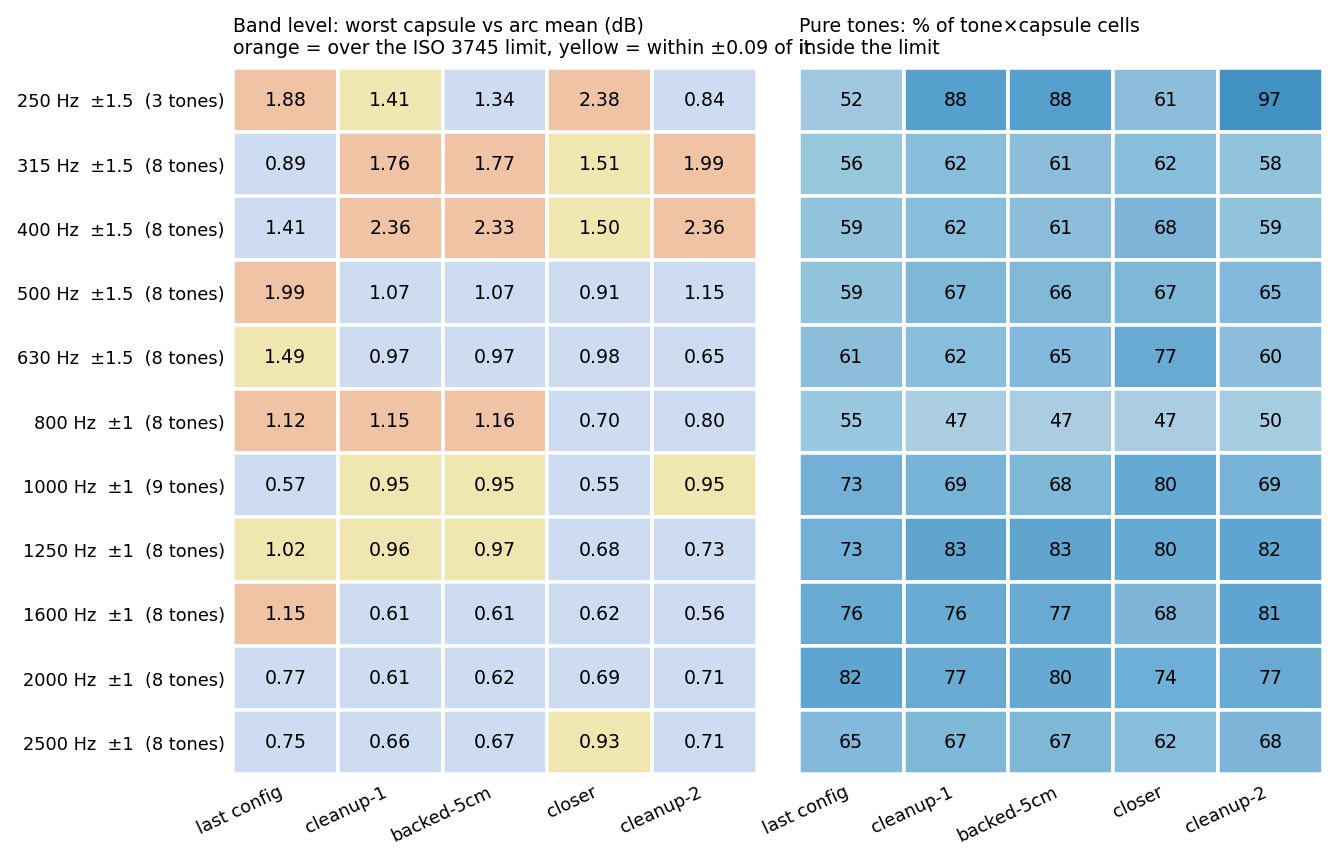
[picture p46: figure]

BAND | LIMIT DB TONES SETUPS OVER THE LIMIT (BAND LEVEL), OF 5 | PURE TONES IN LIMIT, MEDIAN | VERDICT
250 Hz | ±1.5 | 3 | 2 clear + 1 marginal | 88 % | setup-dependent
315 Hz | ±1.5 | 8 | 3 clear + 1 marginal | 61 % | avoid
400 Hz | ±1.5 | 8 | 3 clear + 1 marginal | 61 % | avoid
500 Hz | ±1.5 | 8 | 1 clear + 0 marginal | 66 % | setup-dependent
630 Hz | ±1.5 | 8 | 0 clear + 1 marginal | 62 % | borderline
800 Hz | ±1 | 8 | 3 clear + 0 marginal | 47 % | avoid
1000 Hz ±1 | 9 | 0 clear + 3 marginal | 69 % | borderline
1250 Hz ±1 | 8 | 0 clear + 3 marginal | 82 % | borderline
1600 Hz ±1 | 8 | 1 clear + 0 marginal | 76 % | setup-dependent
2000 Hz ±1 | 8 | 0 clear + 0 marginal | 77 % | holds
2500 Hz ±1 | 8 | 0 clear + 1 marginal | 67 % | borderline

avoid = clearly over the limit in 3 or more of the 5 setups; marginal cases are last config at 630 Hz, last config at 1250 Hz, cleanup-1 at 250 Hz, cleanup-1 at 1000 Hz, cleanup-1 at 1250 Hz, backed-5cm at 1000 Hz, backed-5cm at 1250 Hz, closer at 315 Hz, closer at 400 Hz, closer at 2500 Hz, cleanup-2 at 1000 Hz.
setup-dependent = 1–2; borderline = none clearly over but some marginal; holds = neither. These cut-offs are ours, not from a standard.
Avoid: 315, 400, 800 Hz. Clean in all five: 2000 Hz. Borderline (no clear failure, but at least one setup within the scatter of the limit): 630, 1000, 1250, 2500 Hz. Depends on the setup: 250, 500, 1600 Hz (250 Hz fails only in last config, closer; 500 Hz fails only in last config; 1600 Hz fails only in last config).
Pure tones are not qualified anywhere. No band has all cells inside the limit; the median is 47–82 %, lowest at 800 Hz. The accepted state alone (last config): clearly over the limit at 250, 500, 800, 1600 Hz, marginal at 630, 1250 Hz, clean elsewhere; band level qualified from 2000 Hz.
Never usable: 3–5 kHz (the sphere's rocking mode, a source fault). Indicative only: 5–6.4 kHz. Not measured: below 257 Hz, where blade tones sat at 216 and 238 Hz (and 258 Hz) in the September runs, and the 250 Hz band has only 3 tones.
Limits of this rule. Deviation from the arc mean cannot see an error shared by all eleven positions, such as a uniform reflection. Band verdicts hinge on the single worst of eleven capsules. The tolerance table belongs to a traverse test we never ran; treat the verdicts as a ranking of bands, not a certificate.

250 400 Hz | 400 630 Hz | 630 1000 Hz | 1000 1600 Hz | 1600 3000 Hz | 5000 6400 Hz

0.0

0.5

1.0

1.5

2.0

room error, rms dB across the arc
(lower = flatter = better)

+0.44
worse
-0.10
better

+0.04
worse

+0.04
worse

-0.07
better

+0.12
worse

Room error per band, before and after (blue = better by >0.02 dB, orange = worse)

before (2026-09-25/cleanup-1) after (2026-09-25/carpet-reordered)

257 | 397 | 630 | 1000 | 1587 | 2520 | 5040 5993

+90°
+72°
+54°
+36°
+18°
+0°
-18°
-36°
-54°
-72°
-90°

before: 2026-09-25/cleanup-1 1.301 dB below 3 kHz

4

2

0

2

4

dB vs arc mean

257 | 397 | 630 | 1000 | 1587 | 2520 | 5040 5993

+90°
+72°
+54°
+36°
+18°
+0°
-18°
-36°
-54°
-72°
-90°

after: 2026-09-25/carpet-reordered 1.387 dB below 3 kHz

4

2

0

2

4

dB vs arc mean

257 | 397 | 630 | 1000 | 1587 | 2520 | 5040 5993

+90°
+72°
+54°
+36°
+18°
+0°
-18°
-36°
-54°
-72°
-90°

raw change: after before 1.462 dB rms below 3 kHz (repeat floor 0.010, handling ~0.04)

5.0

2.5

0.0

2.5

5.0

dB

257 | 397 | 630 | 1000 | 1587 | 2520 | 5040 5993
Hz (3 5 kHz omitted: the sphere is not axisymmetric there). +90° = top, 90° = bottom

+90°
+72°
+54°
+36°
+18°
+0°
-18°
-36°
-54°
-72°
-90°

BETTER or WORSE: how much closer to flat each cell got, |before| |after|

worse
2.8 dB

no change

better
+2.8 dB

0.2 0.0 0.2

net per capsule
<3 kHz (dB)

last config vs best (cleanup-1): room error below 3 kHz 1.301 1.387 dB (+0.086, worse)

2026-09-25/cleanup-1 2026-09-25/carpet-reordered · below 3 kHz, 427 of 946 cells moved >0.05 dB toward flat and 481 away from it · 95 tones · 11 calibrated capsules

250 400 Hz | 400 630 Hz | 630 1000 Hz | 1000 1600 Hz | 1600 3000 Hz | 5000 6400 Hz

0.00

0.25

0.50

0.75

1.00

1.25

1.50

1.75

2.00
room error, rms dB across the arc
(lower = flatter = better)
1.56 | 1.62
1.43

0.81

1.03 | 1.05

Room error per band

257 | 397 | 630 | 1000 | 1587 | 2520 | 5040 | 5993
Hz (3 5 kHz omitted: the sphere is not axisymmetric there). +90° = top, 90° = bottom

+90°

+72°

+54°

+36°

+18°

+0°

-18°

-36°

-54°

-72°

-90°

cleanup-1 1.301 dB below 3 kHz

4

2

0

2

4

dB vs arc mean

0 | 1

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

+90°
+72°
+54°
+36°
+18°
+0°
-18°
-36°
-54°
-72°
-90°

BETTER or WORSE: how much closer to flat each cell got, |before| |after|

worse
1.0 dB

no change

better
+1.0 dB

0.1 0.0

net per capsule
<3 kHz (dB)

cleanup-2 vs best (cleanup-1): room error below 3 kHz 1.301 1.314 dB (+0.014, worse)

2026-09-25/cleanup-1 2026-09-25/cleanup-2 · below 3 kHz, 398 of 946 cells moved >0.05 dB toward flat and 392 away from it · 95 tones · 11 calibrated capsules
