asdfgh0318/SoundVisualizer/docs/analysis/chamber-treatments-2026-09-23/full-carpet-vs-accepted-day3.pdf

250 400 Hz | 400 630 Hz | 630 1000 Hz | 1000 1600 Hz | 1600 3000 Hz | 5000 6400 Hz

0.0

0.5

1.0

1.5

2.0

2.5

room error, rms dB across the arc
(lower = flatter = better)

+0.73
worse

-0.01
same

+0.24
worse

+0.09
worse

-0.02
same

+0.05
worse

Room error per band, before and after (blue = better by >0.02 dB, orange = worse)

before (2026-09-25/backed-5cm) after (2026-09-25/full-carpet-raised)

257 | 397 | 630 | 1000 | 1587 | 2520 | 5040 5993

+90°
+72°
+54°
+36°
+18°
+0°
-18°
-36°
-54°
-72°
-90°

before: 2026-09-25/backed-5cm 1.303 dB below 3 kHz

5.0

2.5

0.0

2.5

5.0

dB vs arc mean

257 | 397 | 630 | 1000 | 1587 | 2520 | 5040 5993

+90°
+72°
+54°
+36°
+18°
+0°
-18°
-36°
-54°
-72°
-90°

after: 2026-09-25/full-carpet-raised 1.541 dB below 3 kHz

5.0

2.5

0.0

2.5

5.0

dB vs arc mean

257 | 397 | 630 | 1000 | 1587 | 2520 | 5040 5993

+90°
+72°
+54°
+36°
+18°
+0°
-18°
-36°
-54°
-72°
-90°

raw change: after before 1.516 dB rms below 3 kHz (repeat floor 0.010, handling ~0.04)

5.0

2.5

0.0

2.5

5.0

dB

257 | 397 | 630 | 1000 | 1587 | 2520 | 5040 5993
Hz (3 5 kHz omitted: the sphere is not axisymmetric there). +90° = top, 90° = bottom

+90°
+72°
+54°
+36°
+18°
+0°
-18°
-36°
-54°
-72°
-90°

BETTER or WORSE: how much closer to flat each cell got, |before| |after|

worse
3.3 dB

no change

better
+3.3 dB

0.50 0.25 0.00

net per capsule
<3 kHz (dB)

Now (full carpet on standoffs) vs the accepted state (backed-5cm): room error below 3 kHz 1.303 1.541 dB (+0.238, worse)

2026-09-25/backed-5cm 2026-09-25/full-carpet-raised · below 3 kHz, 427 of 946 cells moved >0.05 dB toward flat and 479 away from it · 95 tones · 11 calibrated capsules
