asdfgh0318/SoundVisualizer/docs/analysis/chamber-treatments-2026-09-23/thin-carpet-raised-day3.pdf

250 400 Hz | 400 630 Hz | 630 1000 Hz | 1000 1600 Hz | 1600 3000 Hz | 5000 6400 Hz

0

1

2

3

room error, rms dB across the arc
(lower = flatter = better)
-0.36
better
-0.11
better | -0.14
| better
-0.15
better

-0.08
better

+0.01
same

Room error per band, before and after (blue = better by >0.02 dB, orange = worse)

before (2026-09-25/wall-thinsulate) after (2026-09-25/thin-carpet-raised)

257 | 397 | 630 | 1000 | 1587 | 2520 | 5040 5993

+90°
+72°
+54°
+36°
+18°
+0°
-18°
-36°
-54°
-72°
-90°

before: 2026-09-25/wall-thinsulate 1.955 dB below 3 kHz

10

5

0

5

10

dB vs arc mean

257 | 397 | 630 | 1000 | 1587 | 2520 | 5040 5993

+90°
+72°
+54°
+36°
+18°
+0°
-18°
-36°
-54°
-72°
-90°

after: 2026-09-25/thin-carpet-raised 1.778 dB below 3 kHz

10

5

0

5

10

dB vs arc mean

257 | 397 | 630 | 1000 | 1587 | 2520 | 5040 5993

+90°
+72°
+54°
+36°
+18°
+0°
-18°
-36°
-54°
-72°
-90°

raw change: after before 0.862 dB rms below 3 kHz (repeat floor 0.010, handling ~0.04)

5.0

2.5

0.0

2.5

5.0

dB

257 | 397 | 630 | 1000 | 1587 | 2520 | 5040 5993
Hz (3 5 kHz omitted: the sphere is not axisymmetric there). +90° = top, 90° = bottom

+90°
+72°
+54°
+36°
+18°
+0°
-18°
-36°
-54°
-72°
-90°

BETTER or WORSE: how much closer to flat each cell got, |before| |after|

worse
2.9 dB

no change

better
+2.9 dB

0.0 0.5

net per capsule
<3 kHz (dB)

Thin carpet on the floor, lifted on standoffs: room error below 3 kHz 1.955 1.778 dB (-0.177, better)

2026-09-25/wall-thinsulate 2026-09-25/thin-carpet-raised · below 3 kHz, 506 of 946 cells moved >0.05 dB toward flat and 367 away from it · 95 tones · 11 calibrated capsules
