asdfgh0318/SoundVisualizer/docs/analysis/chamber-treatments-2026-09-23/carpet-removed-day3.pdf

250 400 Hz | 400 630 Hz | 630 1000 Hz | 1000 1600 Hz | 1600 3000 Hz | 5000 6400 Hz

0.0

0.5

1.0

1.5

2.0

2.5

3.0

room error, rms dB across the arc
(lower = flatter = better)

+0.94
worse

-0.07
better | +0.21
worse

+0.08
worse

+0.15
worse | -0.01
same

Room error per band, before and after (blue = better by >0.02 dB, orange = worse)

before (2026-09-25/cleanup-6) after (2026-09-25/carpet-removed)

257 | 397 | 630 | 1000 | 1587 | 2520 | 5040 5993

+90°
+72°
+54°
+36°
+18°
+0°
-18°
-36°
-54°
-72°
-90°

before: 2026-09-25/cleanup-6 1.443 dB below 3 kHz

5

0

5
dB vs arc mean
257 | 397 | 630 | 1000 | 1587 | 2520 | 5040 5993

+90°
+72°
+54°
+36°
+18°
+0°
-18°
-36°
-54°
-72°
-90°

after: 2026-09-25/carpet-removed 1.740 dB below 3 kHz

5

0

5
dB vs arc mean
257 | 397 | 630 | 1000 | 1587 | 2520 | 5040 5993

+90°
+72°
+54°
+36°
+18°
+0°
-18°
-36°
-54°
-72°
-90°

raw change: after before 1.928 dB rms below 3 kHz (repeat floor 0.010, handling ~0.04)

5

0

5

dB

257 | 397 | 630 | 1000 | 1587 | 2520 | 5040 5993
Hz (3 5 kHz omitted: the sphere is not axisymmetric there). +90° = top, 90° = bottom

+90°
+72°
+54°
+36°
+18°
+0°
-18°
-36°
-54°
-72°
-90°

BETTER or WORSE: how much closer to flat each cell got, |before| |after|

worse
4.2 dB

no change

better
+4.2 dB

0.5 0.0 0.5

net per capsule
<3 kHz (dB)

Thick carpet removed from the floor: room error below 3 kHz 1.443 1.740 dB (+0.298, worse)

2026-09-25/cleanup-6 2026-09-25/carpet-removed · below 3 kHz, 372 of 946 cells moved >0.05 dB toward flat and 533 away from it · 95 tones · 11 calibrated capsules
