asdfgh0318/SoundVisualizer/docs/analysis/chamber-treatments-2026-09-23/cleanup-5-vs-accepted-day3.pdf

250 400 Hz | 400 630 Hz | 630 1000 Hz | 1000 1600 Hz | 1600 3000 Hz | 5000 6400 Hz

0.0

0.5

1.0

1.5

2.0

room error, rms dB across the arc
(lower = flatter = better)

+0.10
worse

+0.34
worse
+0.10
worse

+0.09
worse

-0.03
better

-0.06
better

Room error per band, before and after (blue = better by >0.02 dB, orange = worse)

before (2026-09-25/backed-5cm) after (2026-09-25/cleanup-5)

257 | 397 | 630 | 1000 | 1587 | 2520 | 5040 5993

+90°
+72°
+54°
+36°
+18°
+0°
-18°
-36°
-54°
-72°
-90°

before: 2026-09-25/backed-5cm 1.303 dB below 3 kHz

5

0

5
dB vs arc mean
257 | 397 | 630 | 1000 | 1587 | 2520 | 5040 5993

+90°
+72°
+54°
+36°
+18°
+0°
-18°
-36°
-54°
-72°
-90°

after: 2026-09-25/cleanup-5 1.427 dB below 3 kHz

5

0

5
dB vs arc mean
257 | 397 | 630 | 1000 | 1587 | 2520 | 5040 5993

+90°
+72°
+54°
+36°
+18°
+0°
-18°
-36°
-54°
-72°
-90°

raw change: after before 1.235 dB rms below 3 kHz (repeat floor 0.010, handling ~0.04)

5.0

2.5

0.0

2.5

5.0

dB

257 | 397 | 630 | 1000 | 1587 | 2520 | 5040 5993
Hz (3 5 kHz omitted: the sphere is not axisymmetric there). +90° = top, 90° = bottom

+90°
+72°
+54°
+36°
+18°
+0°
-18°
-36°
-54°
-72°
-90°

BETTER or WORSE: how much closer to flat each cell got, |before| |after|

worse
2.9 dB

no change

better
+2.9 dB

0.5 0.0

net per capsule
<3 kHz (dB)

After clean-up (steps 1-5) vs the accepted state: room error below 3 kHz 1.303 1.427 dB (+0.124, worse) 2026-09-25/backed-5cm 2026-09-25/cleanup-5 · below 3 kHz, 419 of 946 cells moved >0.05 dB toward flat and 471 away from it · 95 tones · 11 calibrated capsules
