asdfgh0318/SoundVisualizer/docs/analysis/chamber-treatments-2026-09-23/backed-5cm-vs-best-day3.pdf

250 400 Hz | 400 630 Hz | 630 1000 Hz | 1000 1600 Hz | 1600 3000 Hz | 5000 6400 Hz

0.0

0.5

1.0

1.5

2.0

room error, rms dB across the arc
(lower = flatter = better)
-0.16
better

+0.10
worse | +0.14
| worse

+0.00
same

+0.08
worse

-0.03
better

Room error per band, before and after (blue = better by >0.02 dB, orange = worse)

before (floor-carpet)
after (2026-09-25/backed-5cm)
257 | 397 | 630 | 1000 | 1587 | 2520 | 5040 5993

+90°
+72°
+54°
+36°
+18°
+0°
-18°
-36°
-54°
-72°
-90°

before: floor-carpet 1.277 dB below 3 kHz

4

2

0

2

4

dB vs arc mean

257 | 397 | 630 | 1000 | 1587 | 2520 | 5040 5993

+90°
+72°
+54°
+36°
+18°
+0°
-18°
-36°
-54°
-72°
-90°

after: 2026-09-25/backed-5cm 1.303 dB below 3 kHz

4

2

0

2

4

dB vs arc mean

257 | 397 | 630 | 1000 | 1587 | 2520 | 5040 5993

+90°
+72°
+54°
+36°
+18°
+0°
-18°
-36°
-54°
-72°
-90°

raw change: after before 1.387 dB rms below 3 kHz (repeat floor 0.010, handling ~0.04)

4

2

0

2

4

dB

257 | 397 | 630 | 1000 | 1587 | 2520 | 5040 5993
Hz (3 5 kHz omitted: the sphere is not axisymmetric there). +90° = top, 90° = bottom

+90°
+72°
+54°
+36°
+18°
+0°
-18°
-36°
-54°
-72°
-90°

BETTER or WORSE: how much closer to flat each cell got, |before| |after|

worse
3.1 dB

no change

better
+3.1 dB

0.25 0.00

net per capsule
<3 kHz (dB)

Speaker backed off 5 cm, raised carpet (day 3) vs the cleanest (Thinsulate on wedges, day 1): room error below 3 kHz 1.277 1.303 dB (+0.026, worse)

floor-carpet 2026-09-25/backed-5cm · below 3 kHz, 427 of 946 cells moved >0.05 dB toward flat and 472 away from it · 95 tones · 11 calibrated capsules
