asdfgh0318/SoundVisualizer/docs/analysis/chamber-treatments-2026-09-23/backed-5cm-day3.pdf

250 400 Hz | 400 630 Hz | 630 1000 Hz | 1000 1600 Hz | 1600 3000 Hz | 5000 6400 Hz

0.0

0.5

1.0

1.5

2.0

room error, rms dB across the arc
(lower = flatter = better)
-0.12
better

-0.29
better | +0.07
| worse

-0.12
better

+0.02
worse

+0.05
worse

Room error per band, before and after (blue = better by >0.02 dB, orange = worse)

before (2026-09-25/carpet-only) after (2026-09-25/backed-5cm)

257 | 397 | 630 | 1000 | 1587 | 2520 | 5040 5993

+90°
+72°
+54°
+36°
+18°
+0°
-18°
-36°
-54°
-72°
-90°

before: 2026-09-25/carpet-only 1.393 dB below 3 kHz

5.0

2.5

0.0

2.5

5.0

dB vs arc mean

257 | 397 | 630 | 1000 | 1587 | 2520 | 5040 5993

+90°
+72°
+54°
+36°
+18°
+0°
-18°
-36°
-54°
-72°
-90°

after: 2026-09-25/backed-5cm 1.303 dB below 3 kHz

5.0

2.5

0.0

2.5

5.0

dB vs arc mean

257 | 397 | 630 | 1000 | 1587 | 2520 | 5040 5993

+90°
+72°
+54°
+36°
+18°
+0°
-18°
-36°
-54°
-72°
-90°

raw change: after before 0.798 dB rms below 3 kHz (repeat floor 0.010, handling ~0.04)

4

2

0

2

4

dB

257 | 397 | 630 | 1000 | 1587 | 2520 | 5040 5993
Hz (3 5 kHz omitted: the sphere is not axisymmetric there). +90° = top, 90° = bottom

+90°
+72°
+54°
+36°
+18°
+0°
-18°
-36°
-54°
-72°
-90°

BETTER or WORSE: how much closer to flat each cell got, |before| |after|

worse
1.9 dB

no change

better
+1.9 dB
0.0 | 0.2 | 0.4

net per capsule
<3 kHz (dB)

Speaker backed off 5 cm from the ring plane: room error below 3 kHz 1.393 1.303 dB (-0.090, better)

2026-09-25/carpet-only 2026-09-25/backed-5cm · below 3 kHz, 471 of 946 cells moved >0.05 dB toward flat and 396 away from it · 95 tones · 11 calibrated capsules
