asdfgh0318/SoundVisualizer/docs/analysis/chamber-treatments-2026-09-23/curtain-day3.pdf

250 400 Hz | 400 630 Hz | 630 1000 Hz | 1000 1600 Hz | 1600 3000 Hz | 5000 6400 Hz

0.0

0.5

1.0

1.5

2.0

2.5

room error, rms dB across the arc
(lower = flatter = better)
+0.03
worse | -0.03
better | +0.18
worse | +0.39
worse

+0.91
worse

+1.27
worse

Room error per band, before and after (blue = better by >0.02 dB, orange = worse)

before (2026-09-25/in-plane-a) after (2026-09-25/curtain)

257 | 397 | 630 | 1000 | 1587 | 2520 | 5040 5993

+90°
+72°
+54°
+36°
+18°
+0°
-18°
-36°
-54°
-72°
-90°

before: 2026-09-25/in-plane-a 1.472 dB below 3 kHz

10

0

10

dB vs arc mean

257 | 397 | 630 | 1000 | 1587 | 2520 | 5040 5993

+90°
+72°
+54°
+36°
+18°
+0°
-18°
-36°
-54°
-72°
-90°

after: 2026-09-25/curtain 1.783 dB below 3 kHz

10

0

10

dB vs arc mean

257 | 397 | 630 | 1000 | 1587 | 2520 | 5040 5993

+90°
+72°
+54°
+36°
+18°
+0°
-18°
-36°
-54°
-72°
-90°

raw change: after before 1.043 dB rms below 3 kHz (repeat floor 0.010, handling ~0.04)

10

5

0

5

10

dB

257 | 397 | 630 | 1000 | 1587 | 2520 | 5040 5993
Hz (3 5 kHz omitted: the sphere is not axisymmetric there). +90° = top, 90° = bottom

+90°
+72°
+54°
+36°
+18°
+0°
-18°
-36°
-54°
-72°
-90°

BETTER or WORSE: how much closer to flat each cell got, |before| |after|

worse
3.5 dB

no change

better
+3.5 dB
1.0 | 0.5 | 0.0

net per capsule
<3 kHz (dB)

Curtain on the wall the speaker fires toward: room error below 3 kHz 1.472 1.783 dB (+0.311, worse)

2026-09-25/in-plane-a 2026-09-25/curtain · below 3 kHz, 374 of 946 cells moved >0.05 dB toward flat and 494 away from it · 95 tones · 11 calibrated capsules
