asdfgh0318/SoundVisualizer/docs/analysis/chamber-treatments-2026-09-23/in-plane-day3.pdf

250 400 Hz | 400 630 Hz | 630 1000 Hz | 1000 1600 Hz | 1600 3000 Hz | 5000 6400 Hz

0.0

0.5

1.0

1.5

2.0

room error, rms dB across the arc
(lower = flatter = better)
-0.05
better | +0.60
| worse
+0.10
worse
+0.11
worse

+0.12
worse

-0.07
better

Room error per band, before and after (blue = better by >0.02 dB, orange = worse)

before (2026-09-25/closer-a) after (2026-09-25/in-plane-a)

257 | 397 | 630 | 1000 | 1587 | 2520 | 5040 5993

+90°
+72°
+54°
+36°
+18°
+0°
-18°
-36°
-54°
-72°
-90°

before: 2026-09-25/closer-a 1.311 dB below 3 kHz

5

0

5
dB vs arc mean
257 | 397 | 630 | 1000 | 1587 | 2520 | 5040 5993

+90°
+72°
+54°
+36°
+18°
+0°
-18°
-36°
-54°
-72°
-90°

after: 2026-09-25/in-plane-a 1.472 dB below 3 kHz

5

0

5
dB vs arc mean
257 | 397 | 630 | 1000 | 1587 | 2520 | 5040 5993

+90°
+72°
+54°
+36°
+18°
+0°
-18°
-36°
-54°
-72°
-90°

raw change: after before 1.578 dB rms below 3 kHz (repeat floor 0.010, handling ~0.04)

5.0

2.5

0.0

2.5

5.0

dB

257 | 397 | 630 | 1000 | 1587 | 2520 | 5040 5993
Hz (3 5 kHz omitted: the sphere is not axisymmetric there). +90° = top, 90° = bottom

+90°
+72°
+54°
+36°
+18°
+0°
-18°
-36°
-54°
-72°
-90°

BETTER or WORSE: how much closer to flat each cell got, |before| |after|

worse
3.5 dB

no change

better
+3.5 dB

0.5 0.0

net per capsule
<3 kHz (dB)

Speaker moved into the ring plane (from ~10 cm off it): room error below 3 kHz 1.311 1.472 dB (+0.161, worse)

2026-09-25/closer-a 2026-09-25/in-plane-a · below 3 kHz, 401 of 946 cells moved >0.05 dB toward flat and 487 away from it · 95 tones · 11 calibrated capsules
