asdfgh0318/SoundVisualizer/docs/analysis/chamber-treatments-2026-09-23/speaker-distance-day3.pdf

250 400 Hz | 400 630 Hz | 630 1000 Hz | 1000 1600 Hz | 1600 3000 Hz | 5000 6400 Hz

0.0

0.5

1.0

1.5

2.0

2.5

3.0

room error, rms dB across the arc
(lower = flatter = better)

Room error per band

previous cleanest (day 1, wedges): 1.277 dB <3 kHz ~30 cm off the ring plane: 1.961 dB <3 kHz
~10 cm off the ring plane: 1.311 dB <3 kHz
in the ring plane: 1.472 dB <3 kHz
257 | 397 | 630 | 1000 | 1587 | 2520 | 5040 | 5993

+90°
+72°
+54°
+36°
+18°
+0°
-18°
-36°
-54°
-72°
-90°

previous cleanest (day 1, wedges) 1.277 dB below 3 kHz (floor-carpet)

5

0

5
dB vs arc mean
(clipped at ±8)
257 | 397 | 630 | 1000 | 1587 | 2520 | 5040 | 5993

+90°
+72°
+54°
+36°
+18°
+0°
-18°
-36°
-54°
-72°
-90°

~30 cm off the ring plane 1.961 dB below 3 kHz (2026-09-25/blue-carpet)

5

0

5
dB vs arc mean
(clipped at ±8)
257 | 397 | 630 | 1000 | 1587 | 2520 | 5040 | 5993

+90°
+72°
+54°
+36°
+18°
+0°
-18°
-36°
-54°
-72°
-90°

~10 cm off the ring plane 1.311 dB below 3 kHz (2026-09-25/closer-a)

5

0

5
dB vs arc mean
(clipped at ±8)
257 | 397 | 630 | 1000 | 1587 | 2520 | 5040 | 5993
Hz (3 5 kHz omitted: the sphere is not axisymmetric there). +90° = top, 90° = bottom

+90°
+72°
+54°
+36°
+18°
+0°
-18°
-36°
-54°
-72°
-90°

in the ring plane 1.472 dB below 3 kHz (2026-09-25/in-plane-a)

5

0

5
dB vs arc mean
(clipped at ±8)

Speaker distance from the ring plane (all on the axis, day 3 floor)
