asdfgh0318/SoundVisualizer/docs/analysis/chamber-treatments-2026-09-23/closer-day3.pdf

250 400 Hz | 400 630 Hz | 630 1000 Hz | 1000 1600 Hz | 1600 3000 Hz | 5000 6400 Hz

0

1

2

3

4

room error, rms dB across the arc
(lower = flatter = better)

-1.23
better
-1.22
better

-0.24
better | +0.03
| worse

-0.03
better

+0.00
same

Room error per band, before and after (blue = better by >0.02 dB, orange = worse)

before (2026-09-25/blue-carpet) after (2026-09-25/closer-a)

257 | 397 | 630 | 1000 | 1587 | 2520 | 5040 5993

+90°
+72°
+54°
+36°
+18°
+0°
-18°
-36°
-54°
-72°
-90°

before: 2026-09-25/blue-carpet 1.961 dB below 3 kHz

10

5

0

5

10

dB vs arc mean

257 | 397 | 630 | 1000 | 1587 | 2520 | 5040 5993

+90°
+72°
+54°
+36°
+18°
+0°
-18°
-36°
-54°
-72°
-90°

after: 2026-09-25/closer-a 1.311 dB below 3 kHz

10

5

0

5

10

dB vs arc mean

257 | 397 | 630 | 1000 | 1587 | 2520 | 5040 5993

+90°
+72°
+54°
+36°
+18°
+0°
-18°
-36°
-54°
-72°
-90°

raw change: after before 1.761 dB rms below 3 kHz (repeat floor 0.010, handling ~0.04)

5

0

5

dB

257 | 397 | 630 | 1000 | 1587 | 2520 | 5040 5993
Hz (3 5 kHz omitted: the sphere is not axisymmetric there). +90° = top, 90° = bottom

+90°
+72°
+54°
+36°
+18°
+0°
-18°
-36°
-54°
-72°
-90°

BETTER or WORSE: how much closer to flat each cell got, |before| |after|

worse
5.4 dB

no change

better
+5.4 dB
0.0 | 0.5 | 1.0

net per capsule
<3 kHz (dB)

Speaker moved closer to the ring: room error below 3 kHz 1.961 1.311 dB (-0.650, better)

2026-09-25/blue-carpet 2026-09-25/closer-a · below 3 kHz, 513 of 946 cells moved >0.05 dB toward flat and 391 away from it · 95 tones · 11 calibrated capsules
