asdfgh0318/SoundVisualizer/docs/analysis/chamber-treatments-2026-09-23/felt-bare-vs-best-day2.pdf

250 400 Hz | 400 630 Hz | 630 1000 Hz | 1000 1600 Hz | 1600 3000 Hz | 5000 6400 Hz

0

1

2

3

4

room error, rms dB across the arc
(lower = flatter = better)

+1.66
worse
+1.03
worse

+0.25
worse
-0.07
better

-0.11
better

-0.05
better

Room error per band, before and after (blue = better by >0.02 dB, orange = worse)

before (floor-carpet)
after (2026-09-24/felt-bare)
257 | 397 | 630 | 1000 | 1587 | 2520 | 5040 5993

+90°
+72°
+54°
+36°
+18°
+0°
-18°
-36°
-54°
-72°
-90°

before: floor-carpet 1.277 dB below 3 kHz

10

5

0

5

10

dB vs arc mean

257 | 397 | 630 | 1000 | 1587 | 2520 | 5040 5993

+90°
+72°
+54°
+36°
+18°
+0°
-18°
-36°
-54°
-72°
-90°

after: 2026-09-24/felt-bare 1.998 dB below 3 kHz

10

5

0

5

10

dB vs arc mean

257 | 397 | 630 | 1000 | 1587 | 2520 | 5040 5993

+90°
+72°
+54°
+36°
+18°
+0°
-18°
-36°
-54°
-72°
-90°

raw change: after before 2.039 dB rms below 3 kHz (repeat floor 0.010, handling ~0.04)

5

0

5

dB

257 | 397 | 630 | 1000 | 1587 | 2520 | 5040 5993
Hz (3 5 kHz omitted: the sphere is not axisymmetric there). +90° = top, 90° = bottom

+90°
+72°
+54°
+36°
+18°
+0°
-18°
-36°
-54°
-72°
-90°

BETTER or WORSE: how much closer to flat each cell got, |before| |after|

worse
6.4 dB

no change

better
+6.4 dB
1 | 0

net per capsule
<3 kHz (dB)

Bare felt on raised carpet (levelled mount) vs the cleanest (Thinsulate on wedges, old tripod): room error below 3 kHz 1.277 1.998 dB (+0.721, worse)

floor-carpet 2026-09-24/felt-bare · below 3 kHz, 394 of 946 cells moved >0.05 dB toward flat and 509 away from it · 95 tones · 11 calibrated capsules
