asdfgh0318/SoundVisualizer/docs/analysis/chamber-treatments-2026-09-23/felt-bare-day2.pdf

250 400 Hz | 400 630 Hz | 630 1000 Hz | 1000 1600 Hz | 1600 3000 Hz | 5000 6400 Hz

0

1

2

3

4

room error, rms dB across the arc
(lower = flatter = better)

+0.01
same
+0.13
worse

-0.07
better
-0.21
better

-0.11
better

-0.13
better

Room error per band, before and after (blue = better by >0.02 dB, orange = worse)

before (2026-09-24/felt-foil-free-inverted) after (2026-09-24/felt-bare)

257 | 397 | 630 | 1000 | 1587 | 2520 | 5040 5993

+90°
+72°
+54°
+36°
+18°
+0°
-18°
-36°
-54°
-72°
-90°

before: 2026-09-24/felt-foil-free-inverted 2.008 dB below 3 kHz

10

5

0

5

10

dB vs arc mean

257 | 397 | 630 | 1000 | 1587 | 2520 | 5040 5993

+90°
+72°
+54°
+36°
+18°
+0°
-18°
-36°
-54°
-72°
-90°

after: 2026-09-24/felt-bare 1.998 dB below 3 kHz

10

5

0

5

10

dB vs arc mean

257 | 397 | 630 | 1000 | 1587 | 2520 | 5040 5993

+90°
+72°
+54°
+36°
+18°
+0°
-18°
-36°
-54°
-72°
-90°

raw change: after before 0.692 dB rms below 3 kHz (repeat floor 0.010, handling ~0.04)

2

0

2

dB

257 | 397 | 630 | 1000 | 1587 | 2520 | 5040 5993
Hz (3 5 kHz omitted: the sphere is not axisymmetric there). +90° = top, 90° = bottom

+90°
+72°
+54°
+36°
+18°
+0°
-18°
-36°
-54°
-72°
-90°

BETTER or WORSE: how much closer to flat each cell got, |before| |after|

worse
2.3 dB

no change

better
+2.3 dB

0.25 0.00 0.25

net per capsule
<3 kHz (dB)

Glue layer left by the foil removed: bare felt: room error below 3 kHz 2.008 1.998 dB (-0.010, better)

2026-09-24/felt-foil-free-inverted 2026-09-24/felt-bare · below 3 kHz, 458 of 946 cells moved >0.05 dB toward flat and 402 away from it · 95 tones · 11 calibrated capsules
