asdfgh0318/SoundVisualizer/docs/analysis/chamber-treatments-2026-09-23/felt-foil-free-inverted-day2.pdf

250 400 Hz | 400 630 Hz | 630 1000 Hz | 1000 1600 Hz | 1600 3000 Hz | 5000 6400 Hz

0

1

2

3

4

room error, rms dB across the arc
(lower = flatter = better)
-0.09
better

-0.15
better
-0.23
better
-0.36
better

-0.15
better

-0.26
better

Room error per band, before and after (blue = better by >0.02 dB, orange = worse)

before (2026-09-24/felt-foil-removed) after (2026-09-24/felt-foil-free-inverted)

257 | 397 | 630 | 1000 | 1587 | 2520 | 5040 5993

+90°
+72°
+54°
+36°
+18°
+0°
-18°
-36°
-54°
-72°
-90°

before: 2026-09-24/felt-foil-removed 2.159 dB below 3 kHz

10

5

0

5

10

dB vs arc mean

257 | 397 | 630 | 1000 | 1587 | 2520 | 5040 5993

+90°
+72°
+54°
+36°
+18°
+0°
-18°
-36°
-54°
-72°
-90°

after: 2026-09-24/felt-foil-free-inverted 2.008 dB below 3 kHz

10

5

0

5

10

dB vs arc mean

257 | 397 | 630 | 1000 | 1587 | 2520 | 5040 5993

+90°
+72°
+54°
+36°
+18°
+0°
-18°
-36°
-54°
-72°
-90°

raw change: after before 0.854 dB rms below 3 kHz (repeat floor 0.010, handling ~0.04)

4

2

0

2

4

dB

257 | 397 | 630 | 1000 | 1587 | 2520 | 5040 5993
Hz (3 5 kHz omitted: the sphere is not axisymmetric there). +90° = top, 90° = bottom

+90°
+72°
+54°
+36°
+18°
+0°
-18°
-36°
-54°
-72°
-90°

BETTER or WORSE: how much closer to flat each cell got, |before| |after|

worse
2.2 dB

no change

better
+2.2 dB
0.0 | 0.2 | 0.4

net per capsule
<3 kHz (dB)

Foil-free felt flipped over: room error below 3 kHz 2.159 2.008 dB (-0.151, better)

2026-09-24/felt-foil-removed 2026-09-24/felt-foil-free-inverted · below 3 kHz, 524 of 946 cells moved >0.05 dB toward flat and 364 away from it · 95 tones · 11 calibrated capsules
