asdfgh0318/SoundVisualizer/docs/analysis/chamber-treatments-2026-09-23/felt-foil-in-day2.pdf

250 400 Hz | 400 630 Hz | 630 1000 Hz | 1000 1600 Hz | 1600 3000 Hz | 5000 6400 Hz

0

1

2

3

4

5

room error, rms dB across the arc
(lower = flatter = better)

+0.64
worse

+0.21
worse | -0.17
better | +0.26
worse

+0.06
worse

+0.58
worse

Room error per band, before and after (blue = better by >0.02 dB, orange = worse)

before (2026-09-24/ceiling-felt-to-floor) after (2026-09-24/felt-foil-in)

257 | 397 | 630 | 1000 | 1587 | 2520 | 5040 5993

+90°
+72°
+54°
+36°
+18°
+0°
-18°
-36°
-54°
-72°
-90°

before: 2026-09-24/ceiling-felt-to-floor 2.517 dB below 3 kHz

10

0

10
dB vs arc mean
257 | 397 | 630 | 1000 | 1587 | 2520 | 5040 5993

+90°
+72°
+54°
+36°
+18°
+0°
-18°
-36°
-54°
-72°
-90°

after: 2026-09-24/felt-foil-in 2.753 dB below 3 kHz

10

0

10
dB vs arc mean
257 | 397 | 630 | 1000 | 1587 | 2520 | 5040 5993

+90°
+72°
+54°
+36°
+18°
+0°
-18°
-36°
-54°
-72°
-90°

raw change: after before 1.709 dB rms below 3 kHz (repeat floor 0.010, handling ~0.04)

5

0

5

dB

257 | 397 | 630 | 1000 | 1587 | 2520 | 5040 5993
Hz (3 5 kHz omitted: the sphere is not axisymmetric there). +90° = top, 90° = bottom

+90°
+72°
+54°
+36°
+18°
+0°
-18°
-36°
-54°
-72°
-90°

BETTER or WORSE: how much closer to flat each cell got, |before| |after|

worse
4.4 dB

no change

better
+4.4 dB
1 | 0

net per capsule
<3 kHz (dB)

Felt turned foil side into the chamber: room error below 3 kHz 2.517 2.753 dB (+0.236, worse)

2026-09-24/ceiling-felt-to-floor 2026-09-24/felt-foil-in · below 3 kHz, 415 of 946 cells moved >0.05 dB toward flat and 480 away from it · 95 tones · 11 calibrated capsules
