asdfgh0318/SoundVisualizer/docs/analysis/chamber-treatments-2026-09-23/ceiling-felt-removed-day2.pdf

250 400 Hz | 400 630 Hz | 630 1000 Hz | 1000 1600 Hz | 1600 3000 Hz | 5000 6400 Hz

0

1

2

3

4

room error, rms dB across the arc
(lower = flatter = better)

+0.61
worse

+0.03
worse

-0.36
better
-0.34
better

-0.26
better

-0.09
better

Room error per band, before and after (blue = better by >0.02 dB, orange = worse)

before (2026-09-24/shield-removed) after (2026-09-24/ceiling-felt-removed)

257 | 397 | 630 | 1000 | 1587 | 2520 | 5040 5993

+90°
+72°
+54°
+36°
+18°
+0°
-18°
-36°
-54°
-72°
-90°

before: 2026-09-24/shield-removed 2.028 dB below 3 kHz

10

5

0

5

10

dB vs arc mean

257 | 397 | 630 | 1000 | 1587 | 2520 | 5040 5993

+90°
+72°
+54°
+36°
+18°
+0°
-18°
-36°
-54°
-72°
-90°

after: 2026-09-24/ceiling-felt-removed 2.107 dB below 3 kHz

10

5

0

5

10

dB vs arc mean

257 | 397 | 630 | 1000 | 1587 | 2520 | 5040 5993

+90°
+72°
+54°
+36°
+18°
+0°
-18°
-36°
-54°
-72°
-90°

raw change: after before 1.721 dB rms below 3 kHz (repeat floor 0.010, handling ~0.04)

10

5

0

5

10

dB

257 | 397 | 630 | 1000 | 1587 | 2520 | 5040 5993
Hz (3 5 kHz omitted: the sphere is not axisymmetric there). +90° = top, 90° = bottom

+90°
+72°
+54°
+36°
+18°
+0°
-18°
-36°
-54°
-72°
-90°

BETTER or WORSE: how much closer to flat each cell got, |before| |after|

worse
5.1 dB

no change

better
+5.1 dB

0.5 0.0 0.5

net per capsule
<3 kHz (dB)

Felt taken off the ceiling: room error below 3 kHz 2.028 2.107 dB (+0.079, worse)

2026-09-24/shield-removed 2026-09-24/ceiling-felt-removed · below 3 kHz, 479 of 946 cells moved >0.05 dB toward flat and 403 away from it · 95 tones · 11 calibrated capsules
