asdfgh0318/SoundVisualizer/docs/analysis/chamber-treatments-2026-09-23/carpet-raised-vs-best-day2.pdf

250 400 Hz | 400 630 Hz | 630 1000 Hz | 1000 1600 Hz | 1600 3000 Hz | 5000 6400 Hz

0

1

2

3

room error, rms dB across the arc
(lower = flatter = better)

+1.31
worse
+1.09
worse
+0.62
worse

+0.28
worse

-0.00
same

-0.15
better

Room error per band, before and after (blue = better by >0.02 dB, orange = worse)

before (floor-carpet)
after (2026-09-24/carpet-raised)
257 | 397 | 630 | 1000 | 1587 | 2520 | 5040 5993

+90°
+72°
+54°
+36°
+18°
+0°
-18°
-36°
-54°
-72°
-90°

before: floor-carpet 1.277 dB below 3 kHz

10

5

0

5

10

dB vs arc mean

257 | 397 | 630 | 1000 | 1587 | 2520 | 5040 5993

+90°
+72°
+54°
+36°
+18°
+0°
-18°
-36°
-54°
-72°
-90°

after: 2026-09-24/carpet-raised 2.011 dB below 3 kHz

10

5

0

5

10

dB vs arc mean

257 | 397 | 630 | 1000 | 1587 | 2520 | 5040 5993

+90°
+72°
+54°
+36°
+18°
+0°
-18°
-36°
-54°
-72°
-90°

raw change: after before 2.131 dB rms below 3 kHz (repeat floor 0.010, handling ~0.04)

10

5

0

5

10

dB

257 | 397 | 630 | 1000 | 1587 | 2520 | 5040 5993
Hz (3 5 kHz omitted: the sphere is not axisymmetric there). +90° = top, 90° = bottom

+90°
+72°
+54°
+36°
+18°
+0°
-18°
-36°
-54°
-72°
-90°

BETTER or WORSE: how much closer to flat each cell got, |before| |after|

worse
5.4 dB

no change

better
+5.4 dB
1.0 | 0.5 | 0.0

net per capsule
<3 kHz (dB)

Raised carpet (felt on ceiling, levelled mount) vs the previous cleanest (Thinsulate on wedges, old tripod): room error below 3 kHz 1.277 2.011 dB (+0.734, worse)

floor-carpet 2026-09-24/carpet-raised · below 3 kHz, 372 of 946 cells moved >0.05 dB toward flat and 533 away from it · 95 tones · 11 calibrated capsules
