asdfgh0318/SoundVisualizer/docs/analysis/chamber-treatments-2026-09-23/carpet-plus-felt-day2.pdf

250 400 Hz | 400 630 Hz | 630 1000 Hz | 1000 1600 Hz | 1600 3000 Hz | 5000 6400 Hz

0

1

2

3

4

5

6

room error, rms dB across the arc
(lower = flatter = better)

-1.17
better | +0.40
worse
+0.67
worse | +0.96
worse | +0.62
worse | +0.11
worse

Room error per band, before and after (blue = better by >0.02 dB, orange = worse)

before (2026-09-24/floor-even-carpet) after (2026-09-24/carpet-plus-felt)

257 | 397 | 630 | 1000 | 1587 | 2520 | 5040 5993

+90°
+72°
+54°
+36°
+18°
+0°
-18°
-36°
-54°
-72°
-90°

before: 2026-09-24/floor-even-carpet 2.540 dB below 3 kHz

20

10

0

10

20

dB vs arc mean

257 | 397 | 630 | 1000 | 1587 | 2520 | 5040 5993

+90°
+72°
+54°
+36°
+18°
+0°
-18°
-36°
-54°
-72°
-90°

after: 2026-09-24/carpet-plus-felt 2.509 dB below 3 kHz

20

10

0

10

20

dB vs arc mean

257 | 397 | 630 | 1000 | 1587 | 2520 | 5040 5993

+90°
+72°
+54°
+36°
+18°
+0°
-18°
-36°
-54°
-72°
-90°

raw change: after before 2.221 dB rms below 3 kHz (repeat floor 0.010, handling ~0.04)

10

0

10

dB

257 | 397 | 630 | 1000 | 1587 | 2520 | 5040 5993
Hz (3 5 kHz omitted: the sphere is not axisymmetric there). +90° = top, 90° = bottom

+90°
+72°
+54°
+36°
+18°
+0°
-18°
-36°
-54°
-72°
-90°

BETTER or WORSE: how much closer to flat each cell got, |before| |after|

worse
6.6 dB

no change

better
+6.6 dB

0.5 0.0 0.5

net per capsule
<3 kHz (dB)

Felt added to the even thick carpet: room error below 3 kHz 2.540 2.509 dB (-0.031, better)

2026-09-24/floor-even-carpet 2026-09-24/carpet-plus-felt · below 3 kHz, 336 of 946 cells moved >0.05 dB toward flat and 578 away from it · 95 tones · 11 calibrated capsules
