asdfgh0318/SoundVisualizer/docs/analysis/chamber-treatments-2026-09-23/center-leveled-vs-best-day2.pdf

250 400 Hz | 400 630 Hz | 630 1000 Hz | 1000 1600 Hz | 1600 3000 Hz | 5000 6400 Hz

0.0

0.5

1.0

1.5

2.0

2.5

room error, rms dB across the arc
(lower = flatter = better)

+0.46
worse
+0.31
worse
-0.04
better
+0.03
worse

-0.12
better

-0.26
better

Room error per band, before and after (blue = better by >0.02 dB, orange = worse)

before (floor-carpet)
after (2026-09-24/center-leveled)
257 | 397 | 630 | 1000 | 1587 | 2520 | 5040 5993

+90°
+72°
+54°
+36°
+18°
+0°
-18°
-36°
-54°
-72°
-90°

before: floor-carpet 1.277 dB below 3 kHz

5

0

5
dB vs arc mean
257 | 397 | 630 | 1000 | 1587 | 2520 | 5040 5993

+90°
+72°
+54°
+36°
+18°
+0°
-18°
-36°
-54°
-72°
-90°

after: 2026-09-24/center-leveled 1.443 dB below 3 kHz

5

0

5
dB vs arc mean
257 | 397 | 630 | 1000 | 1587 | 2520 | 5040 5993

+90°
+72°
+54°
+36°
+18°
+0°
-18°
-36°
-54°
-72°
-90°

raw change: after before 1.227 dB rms below 3 kHz (repeat floor 0.010, handling ~0.04)

4

2

0

2

4

dB

257 | 397 | 630 | 1000 | 1587 | 2520 | 5040 5993
Hz (3 5 kHz omitted: the sphere is not axisymmetric there). +90° = top, 90° = bottom

+90°
+72°
+54°
+36°
+18°
+0°
-18°
-36°
-54°
-72°
-90°

BETTER or WORSE: how much closer to flat each cell got, |before| |after|

worse
3.0 dB

no change

better
+3.0 dB

0.5 0.0

net per capsule
<3 kHz (dB)

Levelled sphere on the new mount vs the previous cleanest (Thinsulate carpet on wedges, old tripod): room error below 3 kHz 1.277 1.443 dB (+0.166, worse)

floor-carpet 2026-09-24/center-leveled · below 3 kHz, 428 of 946 cells moved >0.05 dB toward flat and 467 away from it · 95 tones · 11 calibrated capsules
