asdfgh0318/SoundVisualizer/docs/analysis/chamber-treatments-2026-09-23/center-new-day2.pdf

250 400 Hz | 400 630 Hz | 630 1000 Hz | 1000 1600 Hz | 1600 3000 Hz | 5000 6400 Hz

0.0

0.5

1.0

1.5

2.0

2.5

room error, rms dB across the arc
(lower = flatter = better)

+0.45
worse | +0.52
worse | +0.31
worse
+0.49
worse

+0.59
worse

+0.78
worse

Room error per band, before and after (blue = better by >0.02 dB, orange = worse)

before (2026-09-24/chaotic-carpet-3) after (2026-09-24/center-new-a)

257 | 397 | 630 | 1000 | 1587 | 2520 | 5040 5993

+90°
+72°
+54°
+36°
+18°
+0°
-18°
-36°
-54°
-72°
-90°

before: 2026-09-24/chaotic-carpet-3 1.324 dB below 3 kHz

5

0

5
dB vs arc mean
257 | 397 | 630 | 1000 | 1587 | 2520 | 5040 5993

+90°
+72°
+54°
+36°
+18°
+0°
-18°
-36°
-54°
-72°
-90°

after: 2026-09-24/center-new-a 1.785 dB below 3 kHz

5

0

5
dB vs arc mean
257 | 397 | 630 | 1000 | 1587 | 2520 | 5040 5993

+90°
+72°
+54°
+36°
+18°
+0°
-18°
-36°
-54°
-72°
-90°

raw change: after before 1.331 dB rms below 3 kHz (repeat floor 0.010, handling ~0.04)

5.0

2.5

0.0

2.5

5.0

dB

257 | 397 | 630 | 1000 | 1587 | 2520 | 5040 5993
Hz (3 5 kHz omitted: the sphere is not axisymmetric there). +90° = top, 90° = bottom

+90°
+72°
+54°
+36°
+18°
+0°
-18°
-36°
-54°
-72°
-90°

BETTER or WORSE: how much closer to flat each cell got, |before| |after|

worse
3.0 dB

no change

better
+3.0 dB

0.5 0.0

net per capsule
<3 kHz (dB)

Speaker back at the ring centre on a new, cleaner tripod mount (vs old in-ring mount): room error below 3 kHz 1.324 1.785 dB (+0.461, worse)

2026-09-24/chaotic-carpet-3 2026-09-24/center-new-a · below 3 kHz, 306 of 946 cells moved >0.05 dB toward flat and 588 away from it · 95 tones · 11 calibrated capsules
