asdfgh0318/SoundVisualizer/docs/analysis/chamber-treatments-2026-09-23/ring-bare-day2.pdf

250 400 Hz | 400 630 Hz | 630 1000 Hz | 1000 1600 Hz | 1600 3000 Hz | 5000 6400 Hz

0

1

2

3

4

5

room error, rms dB across the arc
(lower = flatter = better)

-0.10
better

-0.00
same

-0.00
same | -0.01
same | +0.03
worse | +0.09
worse

Room error per band, before and after (blue = better by >0.02 dB, orange = worse)

before (2026-09-24/wall-direct-absorber) after (2026-09-24/ring-bare)

257 | 397 | 630 | 1000 | 1587 | 2520 | 5040 5993

+90°
+72°
+54°
+36°
+18°
+0°
-18°
-36°
-54°
-72°
-90°

before: 2026-09-24/wall-direct-absorber 2.219 dB below 3 kHz

10

5

0

5

10

dB vs arc mean

257 | 397 | 630 | 1000 | 1587 | 2520 | 5040 5993

+90°
+72°
+54°
+36°
+18°
+0°
-18°
-36°
-54°
-72°
-90°

after: 2026-09-24/ring-bare 2.205 dB below 3 kHz

10

5

0

5

10

dB vs arc mean

257 | 397 | 630 | 1000 | 1587 | 2520 | 5040 5993

+90°
+72°
+54°
+36°
+18°
+0°
-18°
-36°
-54°
-72°
-90°

raw change: after before 0.355 dB rms below 3 kHz (repeat floor 0.010, handling ~0.04)

2

0

2

dB

257 | 397 | 630 | 1000 | 1587 | 2520 | 5040 5993
Hz (3 5 kHz omitted: the sphere is not axisymmetric there). +90° = top, 90° = bottom

+90°
+72°
+54°
+36°
+18°
+0°
-18°
-36°
-54°
-72°
-90°

BETTER or WORSE: how much closer to flat each cell got, |before| |after|

worse
1.0 dB

no change

better
+1.0 dB

0.1 0.0 0.1

net per capsule
<3 kHz (dB)

Thinsulate wrap removed from the ring: room error below 3 kHz 2.219 2.205 dB (-0.014, better)

2026-09-24/wall-direct-absorber 2026-09-24/ring-bare · below 3 kHz, 376 of 946 cells moved >0.05 dB toward flat and 386 away from it · 95 tones · 11 calibrated capsules
