asdfgh0318/SoundVisualizer/docs/analysis/chamber-treatments-2026-09-23/wall-direct-absorber-day2.pdf

250 400 Hz | 400 630 Hz | 630 1000 Hz | 1000 1600 Hz | 1600 3000 Hz | 5000 6400 Hz

0

1

2

3

4

5

room error, rms dB across the arc
(lower = flatter = better)

-0.23
better

+0.46
worse

-0.28
better | -0.07
better | +0.03
worse | -0.24
better

Room error per band, before and after (blue = better by >0.02 dB, orange = worse)

before (2026-09-24/wall-direct-a) after (2026-09-24/wall-direct-absorber)

257 | 397 | 630 | 1000 | 1587 | 2520 | 5040 5993

+90°
+72°
+54°
+36°
+18°
+0°
-18°
-36°
-54°
-72°
-90°

before: 2026-09-24/wall-direct-a 2.170 dB below 3 kHz

10

0

10
dB vs arc mean
257 | 397 | 630 | 1000 | 1587 | 2520 | 5040 5993

+90°
+72°
+54°
+36°
+18°
+0°
-18°
-36°
-54°
-72°
-90°

after: 2026-09-24/wall-direct-absorber 2.219 dB below 3 kHz

10

0

10
dB vs arc mean
257 | 397 | 630 | 1000 | 1587 | 2520 | 5040 5993

+90°
+72°
+54°
+36°
+18°
+0°
-18°
-36°
-54°
-72°
-90°

raw change: after before 1.676 dB rms below 3 kHz (repeat floor 0.010, handling ~0.04)

10

5

0

5

10

dB

257 | 397 | 630 | 1000 | 1587 | 2520 | 5040 5993
Hz (3 5 kHz omitted: the sphere is not axisymmetric there). +90° = top, 90° = bottom

+90°
+72°
+54°
+36°
+18°
+0°
-18°
-36°
-54°
-72°
-90°

BETTER or WORSE: how much closer to flat each cell got, |before| |after|

worse
5.5 dB

no change

better
+5.5 dB
0.5 | 0.0

net per capsule
<3 kHz (dB)

Felt and foam placed behind the wall-mounted speaker: room error below 3 kHz 2.170 2.219 dB (+0.049, worse)

2026-09-24/wall-direct-a 2026-09-24/wall-direct-absorber · below 3 kHz, 455 of 946 cells moved >0.05 dB toward flat and 439 away from it · 95 tones · 11 calibrated capsules
