asdfgh0318/SoundVisualizer/docs/analysis/chamber-treatments-2026-09-23/wall-direct-day2.pdf

250 400 Hz | 400 630 Hz | 630 1000 Hz | 1000 1600 Hz | 1600 3000 Hz | 5000 6400 Hz

0

1

2

3

4

room error, rms dB across the arc
(lower = flatter = better)

-1.85
better

+1.53
worse

+0.61
worse
+0.74
worse | +0.19
| worse

+0.05
worse

Room error per band, before and after (blue = better by >0.02 dB, orange = worse)

before (2026-09-24/wall-mount-decoupled) after (2026-09-24/wall-direct-a)

257 | 397 | 630 | 1000 | 1587 | 2520 | 5040 5993

+90°
+72°
+54°
+36°
+18°
+0°
-18°
-36°
-54°
-72°
-90°

before: 2026-09-24/wall-mount-decoupled 2.109 dB below 3 kHz

20

10

0

10

20

dB vs arc mean

257 | 397 | 630 | 1000 | 1587 | 2520 | 5040 5993

+90°
+72°
+54°
+36°
+18°
+0°
-18°
-36°
-54°
-72°
-90°

after: 2026-09-24/wall-direct-a 2.170 dB below 3 kHz

20

10

0

10

20

dB vs arc mean

257 | 397 | 630 | 1000 | 1587 | 2520 | 5040 5993

+90°
+72°
+54°
+36°
+18°
+0°
-18°
-36°
-54°
-72°
-90°

raw change: after before 3.092 dB rms below 3 kHz (repeat floor 0.010, handling ~0.04)

20

10

0

10

20

dB

257 | 397 | 630 | 1000 | 1587 | 2520 | 5040 5993
Hz (3 5 kHz omitted: the sphere is not axisymmetric there). +90° = top, 90° = bottom

+90°
+72°
+54°
+36°
+18°
+0°
-18°
-36°
-54°
-72°
-90°

BETTER or WORSE: how much closer to flat each cell got, |before| |after|

worse
6.7 dB

no change

better
+6.7 dB
1 | 0 | 1

net per capsule
<3 kHz (dB)

Speaker moved from the wall reinforcement to the wall itself, further from the ring: room error below 3 kHz 2.109 2.170 dB (+0.062, worse)

2026-09-24/wall-mount-decoupled 2026-09-24/wall-direct-a · below 3 kHz, 385 of 946 cells moved >0.05 dB toward flat and 526 away from it · 95 tones · 11 calibrated capsules
