asdfgh0318/SoundVisualizer/docs/analysis/chamber-treatments-2026-09-23/chaotic-1-2-3-day2.pdf

250 400 Hz | 400 630 Hz | 630 1000 Hz | 1000 1600 Hz | 1600 3000 Hz | 5000 6400 Hz

0.0

0.5

1.0

1.5

2.0

room error, rms dB across the arc
(lower = flatter = better)

Room error per band: the three arrangements, and wedges only for reference

wedges only (reference): 1.400 dB <3 kHz chaotic #1: 1.317 dB <3 kHz
chaotic #2: 1.318 dB <3 kHz
chaotic #3: 1.324 dB <3 kHz
257 | 397 | 630 | 1000 | 1587 | 2520 | 5040 | 5993

+90°
+72°
+54°
+36°
+18°
+0°
-18°
-36°
-54°
-72°
-90°

chaotic #1 1.317 dB below 3 kHz

5

0

5

dB vs arc mean

257 | 397 | 630 | 1000 | 1587 | 2520 | 5040 | 5993

+90°
+72°
+54°
+36°
+18°
+0°
-18°
-36°
-54°
-72°
-90°

chaotic #2 1.318 dB below 3 kHz

5

0

5

dB vs arc mean

257 | 397 | 630 | 1000 | 1587 | 2520 | 5040 | 5993

+90°
+72°
+54°
+36°
+18°
+0°
-18°
-36°
-54°
-72°
-90°

chaotic #3 1.324 dB below 3 kHz

5

0

5

dB vs arc mean

257 | 397 | 630 | 1000 | 1587 | 2520 | 5040 | 5993

+90°
+72°
+54°
+36°
+18°
+0°
-18°
-36°
-54°
-72°
-90°

chaotic #2 chaotic #1 0.14 dB rms below 3 kHz, r = +0.99 (repeat floor 0.010, handling ~0.04)

1

0

1

dB

257 | 397 | 630 | 1000 | 1587 | 2520 | 5040 | 5993

+90°
+72°
+54°
+36°
+18°
+0°
-18°
-36°
-54°
-72°
-90°

chaotic #3 chaotic #2 0.12 dB rms below 3 kHz, r = +1.00 (repeat floor 0.010, handling ~0.04)

1

0

1

dB

257 | 397 | 630 | 1000 | 1587 | 2520 | 5040 | 5993
Hz (3 5 kHz omitted: the sphere is not axisymmetric there). +90° = top, 90° = bottom

+90°
+72°
+54°
+36°
+18°
+0°
-18°
-36°
-54°
-72°
-90°

chaotic #3 chaotic #1 0.19 dB rms below 3 kHz, r = +0.99 (repeat floor 0.010, handling ~0.04)

1

0

1

dB

Three chaotic carpet arrangements: 1.317 / 1.318 / 1.324 dB the arrangement barely matters

2026-09-24 · same carpet heaped three different ways on the floor (wedges presumed off) · maps share one colour scale, differences another · 95 tones · 11 capsules
