asdfgh0318/SoundVisualizer/docs/analysis/chamber-treatments-2026-09-23/chaotic-2-vs-1-day2.pdf

250 400 Hz | 400 630 Hz | 630 1000 Hz | 1000 1600 Hz | 1600 3000 Hz | 5000 6400 Hz

0.0

0.5

1.0

1.5

2.0

room error, rms dB across the arc
(lower = flatter = better)

-0.02
same
+0.01
same

+0.00
same

+0.01
same

+0.01
same

+0.00
same

Room error per band, before and after (blue = better by >0.02 dB, orange = worse)

before (2026-09-24/chaotic-carpet) after (2026-09-24/chaotic-carpet-2)

257 | 397 | 630 | 1000 | 1587 | 2520 | 5040 5993

+90°
+72°
+54°
+36°
+18°
+0°
-18°
-36°
-54°
-72°
-90°

before: 2026-09-24/chaotic-carpet 1.317 dB below 3 kHz

5.0

2.5

0.0

2.5

5.0

dB vs arc mean

257 | 397 | 630 | 1000 | 1587 | 2520 | 5040 5993

+90°
+72°
+54°
+36°
+18°
+0°
-18°
-36°
-54°
-72°
-90°

after: 2026-09-24/chaotic-carpet-2 1.318 dB below 3 kHz

5.0

2.5

0.0

2.5

5.0

dB vs arc mean

257 | 397 | 630 | 1000 | 1587 | 2520 | 5040 5993

+90°
+72°
+54°
+36°
+18°
+0°
-18°
-36°
-54°
-72°
-90°

raw change: after before 0.143 dB rms below 3 kHz (repeat floor 0.010, handling ~0.04)

1

0

1

dB

257 | 397 | 630 | 1000 | 1587 | 2520 | 5040 5993
Hz (3 5 kHz omitted: the sphere is not axisymmetric there). +90° = top, 90° = bottom

+90°
+72°
+54°
+36°
+18°
+0°
-18°
-36°
-54°
-72°
-90°

BETTER or WORSE: how much closer to flat each cell got, |before| |after|

worse
0.5 dB

no change

better
+0.5 dB

0.0250.000 0.025

net per capsule
<3 kHz (dB)

Chaotic carpet: 2nd arrangement vs 1st: room error below 3 kHz 1.317 1.318 dB (+0.000, same)

2026-09-24/chaotic-carpet 2026-09-24/chaotic-carpet-2 · below 3 kHz, 314 of 946 cells moved >0.05 dB toward flat and 303 away from it · 95 tones · 11 calibrated capsules
