asdfgh0318/SoundVisualizer/docs/psychoacoustics_report_pl.pdf

## Metryki Psychoakustyczne dla Analizy Hałasu Dronów

Raport matematyczny: SQM i Uciążliwość Psychoakustyczna (PA)

Źródło: Vaiuso, Righi, Coretti, Apicella (ZHAW, 2024) — arXiv:2410.22208 (https://arxiv.org/abs/2410.22208)

Skompilowano 13 maja 2026

Streszczenie

Dokument zawiera podstawy matematyczne potrzebne do dodania zakładki Psychoakustyka w SoundVisualizer. Obejmuje cztery metryki jakości dźwięku (SQM, Sound Quality Metrics) — głośność, ostrość, chropowatość, siłę fluktuacji — oraz złożony wskaźnik uciążliwości psychoakustycznej (PA, Psychoacoustic Annoyance), który łączy je w jedną liczbę. Same wzory pochodzą z modelu Zwickera i Fastla; przywoływany artykuł stosuje je do hałasu dronów. Wszystkie metryki opierają się na modelu pasm krytycznych Bark (24 pasma w zakresie słyszalnym).

### 1 Głośność L (son)

Jak głośny jest dźwięk w odczuciu słuchacza. Odniesienie: 1 son = ton sinusoidalny 1 kHz o poziomie 40 dB SPL. Norma: ISO 532-1 / DIN 45631 (metoda Zwickera).

L =

Z 24

z=0

L

′
(z) dz

L

′
(z) głośność właściwa jako funkcja krytycznego pasma z w jednostkach Bark (jednostka: son/Bark). Obliczana w każdym paśmie z poziomu SPL przez nieliniowe prawo potęgowe z korekcjami maskowania międzypasmowego (algorytm ISO 532B).

z częstotliwość krytyczna pasma, 0 ≤ z ≤ 24 Bark. Odwzorowanie na skalę częstotliwości jest nieliniowe: 1 Bark ≈ 100 Hz w zakresie niskich częstotliwości, rośnie do ≈ 20 kHz przy 24 Bark.

Dwa warianty są dla nas istotne:
- Głośność stacjonarna (ISO 532B / DIN 45631) — pojedyncza wartość dla całego nagrania.
- Głośność zmienna w czasie L(t) (DIN 45631/A) — liczona w odstępach ∼ 2 ms. Niezbędna do wyznaczenia PA, gdzie wykorzystywany jest 5-ty percentyl N5 (głośność przekroczona przez 5 % czasu trwania — ujmuje krótkie szczyty, a nie poziom średni).

### 2 Ostrość S (acum)

Jak ostry, przeszywający odbierany jest dźwięk. Odniesienie: 1 acum = szum wąskopasmowy wycentrowany w 1 kHz, poziom 60 dB, szerokość pasma 160 Hz. Artykuł stosuje wagi z DIN 45692 (rozwinięcie metody Auresa / Von Bismarcka).

S =

k
L

Z 24

z=0

L

′
(z) g(z) z dz

g(z) funkcja wagowa wzmacniająca wkład wysokich pasm krytycznych (wysokie wartości z).

k stała skalująca zależna od metody; dobierana tak, aby sygnał odniesienia dawał dokładnie 1 acum.

L całkowita głośność z poprzedniej sekcji.

Interpretacja geometryczna: S to ważony środek ciężkości głośności właściwej na osi Bark, przesunięty w stronę wysokich częstotliwości przez g(z). Dźwięki z większą energią w wysokich pasmach mają wyższą ostrość.

### 3 Chropowatość R (asper)

Jak chropowaty, agresywny w odbiorze jest dźwięk. Powstaje wskutek modulacji amplitudy w zakresie 30–300 Hz — szybkich fluktuacji, których ucho nie potrafi rozróżnić jako odrębnych zdarzeń. Odniesienie: 1 asper = ton 60 dB / 1 kHz, w 100 % modulowany sinusoidą o częstotliwości 70 Hz.

R = cal ·

Z 24

z=0

fmod ∆Ldz

fmod częstotliwość modulacji w każdym paśmie krytycznym (Hz), wyznaczana przez wykrywanie szczytów w widmie obwiedni sygnału.

∆L głębokość modulacji w paśmie: max(env) − min(env) w dB.

cal stała kalibracyjna gwarantująca, że sygnał odniesienia daje 1 asper.

Hałas dronów zazwyczaj wykazuje wysoką chropowatość: częstotliwość przejścia łopaty (BPF) i jej harmoniczne wzajemnie się modulują, dając obwiednię w istotnym akustycznie zakresie 30–300 Hz.

### 4 Siła fluktuacji F (vacil)

Jak "falujący"jest dźwięk. Wynika z wolnej modulacji amplitudy: 0–30 Hz, ze szczytem czułości przy 4 Hz. Odniesienie: 1 vacil = ton 60 dB / 1 kHz, w 100 % modulowany sinusoidą o częstotliwości 4 Hz.

F =

0.008 ·

Z 24

z=0

∆Ldz

fmod
4

+

4

fmod
Struktura wzoru jest taka sama jak dla chropowatości, ale mianownik fmod/4 + 4/fmod osiąga minimum (a F swoje maksimum) w fmod = 4 Hz — odpowiada to empirycznemu szczytowi czułości ucha na powolne fluktuacje.
Dla dronów wartość F jest typowo bliska zeru (∼ 0.01 vacil w pomiarach zawisu w przywoływanym artykule) — modulacje silnika wirnikowego leżą wyraźnie powyżej zakresu wolnych fluktuacji.

### 5 Uciążliwość psychoakustyczna P A

Złożony wskaźnik łączący cztery powyższe metryki w jedną liczbę. Postać Zwickera i Fastla:

P A = N5

1 + q
w²

S + w²

F R

Szczytowa głośność
q

N5 jest mnożona przez bezwymiarowy "współczynnik nieprzyjemności"(1 + w²

S + w²
F R). Dwie wagi:

Waga ostrości wS:

wS =

(
(S − 1.75) · 0.25 · log10(N5 + 10), jeśli S > 1.75
0, | jeśli S ≤ 1.75

Poniżej progu 1.75 acum ostrość nie wnosi wkładu. Powyżej progu wkład rośnie wraz z nadwyżką ostrości i całkowitą głośnością.

Łączna waga chropowatości i fluktuacji wF R:

wF R =

2.18

N⁰.4
5

(0.4 F + 0.6 R)

Chropowatość waży 1,5× więcej niż siła fluktuacji. Czynnik N

−0.4
5

łagodzi wpływ tych składowych przy już głośnych dźwiękach.

Model intuicyjny. P A ≈ głośność×mnożnik nieprzyjemności barwy. Głośność dominuje; ostrość, chropowatość i fluktuacja ją modulują.

### 6 Obserwowane wartości dla dronów

Artykuł podaje następujące wartości dla DJI Matrice 300 RTK w fazie zawisu:

Metryka | Średnia Maks. Jednostka
Głośność (L) | 19,30 | 29,56 son
Ostrość (S) | 1,85 | 3,69 acum
Chropowatość (R) | 0,28 | 0,95 asper
Fluktuacja (F) | 0,01 | 0,06 vacil
Uciążliwość (P A) | 20,31 | 32,57 —

Wnioski:
- Ostrość leży tuż powyżej progu aktywacji 1,75 acum — wkład wS jest niewielki.
- Siła fluktuacji praktycznie nie wpływa na wF R.
- Chropowatość jest dominującą składową barwy poprzez człon 0,6 · R.
- Wskutek tego P A dla drona w zawisie wynosi około L × 1,05 — składowe barwowe podnoszą wskaźnik tylko o kilka procent ponad samą głośność.

### 7 Ścieżka implementacji

W artykule obliczenia wykonano w MATLAB Audio Toolbox (oprogramowanie własnościowe). Otwartoźródłowe alternatywy w Pythonie:

Biblioteka | Co udostępnia | Wady i zalety
mosqito | Wszystkie cztery SQM oraz PA, zgodne
z ISO/DIN, licencja BSD, instalacja przez pip
Dodaje | zależność
(∼ | 10 MB), | ale | jest
naturalnym wyborem
scikit-maad, pyAudioAnalysis | Głośność i część SQM | Mniej kompletne; PA brak
Implementacja własna | Pełna kontrola i zrozumienie | Tygodnie pracy; nietry-
wialne filtry i model maskowania ISO 532B

Rekomendacja: dodać mosqito do pyproject.toml. Po stronie serwera obliczać pięć wartości raz na pomiar akustyczny i buforować je obok meta.json. Frontend tylko odczytuje liczby — brak obliczeń w przeglądarce.

Proponowane widoki zakładki Psychoakustyka.

1. Tabela per-mikrofon dla wybranego punktu PWM — jeden wiersz na mikrofon, kolumny L, S, R, F, P A. Ten sam format co nagłówek wydajnościowy w zakładce FFT, ale w rozbiciu na mikrofony.
2. Metryki w funkcji elewacji — małe wykresy liniowe dla każdej metryki w funkcji kąta elewacji. Ujawniają przestrzenny wzorzec składowych nieprzyjemności, a nie tylko głośności.
3. Metryki w funkcji PWM (lub RPM, ciągu) — analogicznie do wykresu rozrzutu zakładki Custom, z dowolną metryką SQM lub P A na osi Y. Odpowiada na pytania w stylu: „przy jakich obrotach prop zaczyna brzmieć uciążliwie nie z powodu głośności?"

Otwarte kwestie na etapie implementacji.
- Kalibracja. Jednostki son / acum / asper / vacil zakładają, że sygnał wejściowy jest wyrażony w dB SPL, nie w dBFS. Wymagane jest zastosowanie kalibracji UMIK-2 przed przekazaniem audio do mosqito. Działa tak, jeśli dla mikrofonu wgrano plik kalibracyjny; w przeciwnym razie wartości bezwzględne będą zafałszowane (porównania względne pozostają poprawne).
- Długość okna. Dla głośności zmiennej w czasie → N5 potrzebujemy ≳ 1 s nagrania. Nasze typowe okno akwizycji to 1,5 s na krok PWM — marginalnie wystarczające.
- Porównanie z Norsonic. Po dostawie NOR-145 jego wbudowane odczyty głośności i ostrości będą służyć jako sanity-check względem naszego potoku mosqito.
