asdfgh0318/SoundVisualizer/cad/ladder-liner/geometry.png

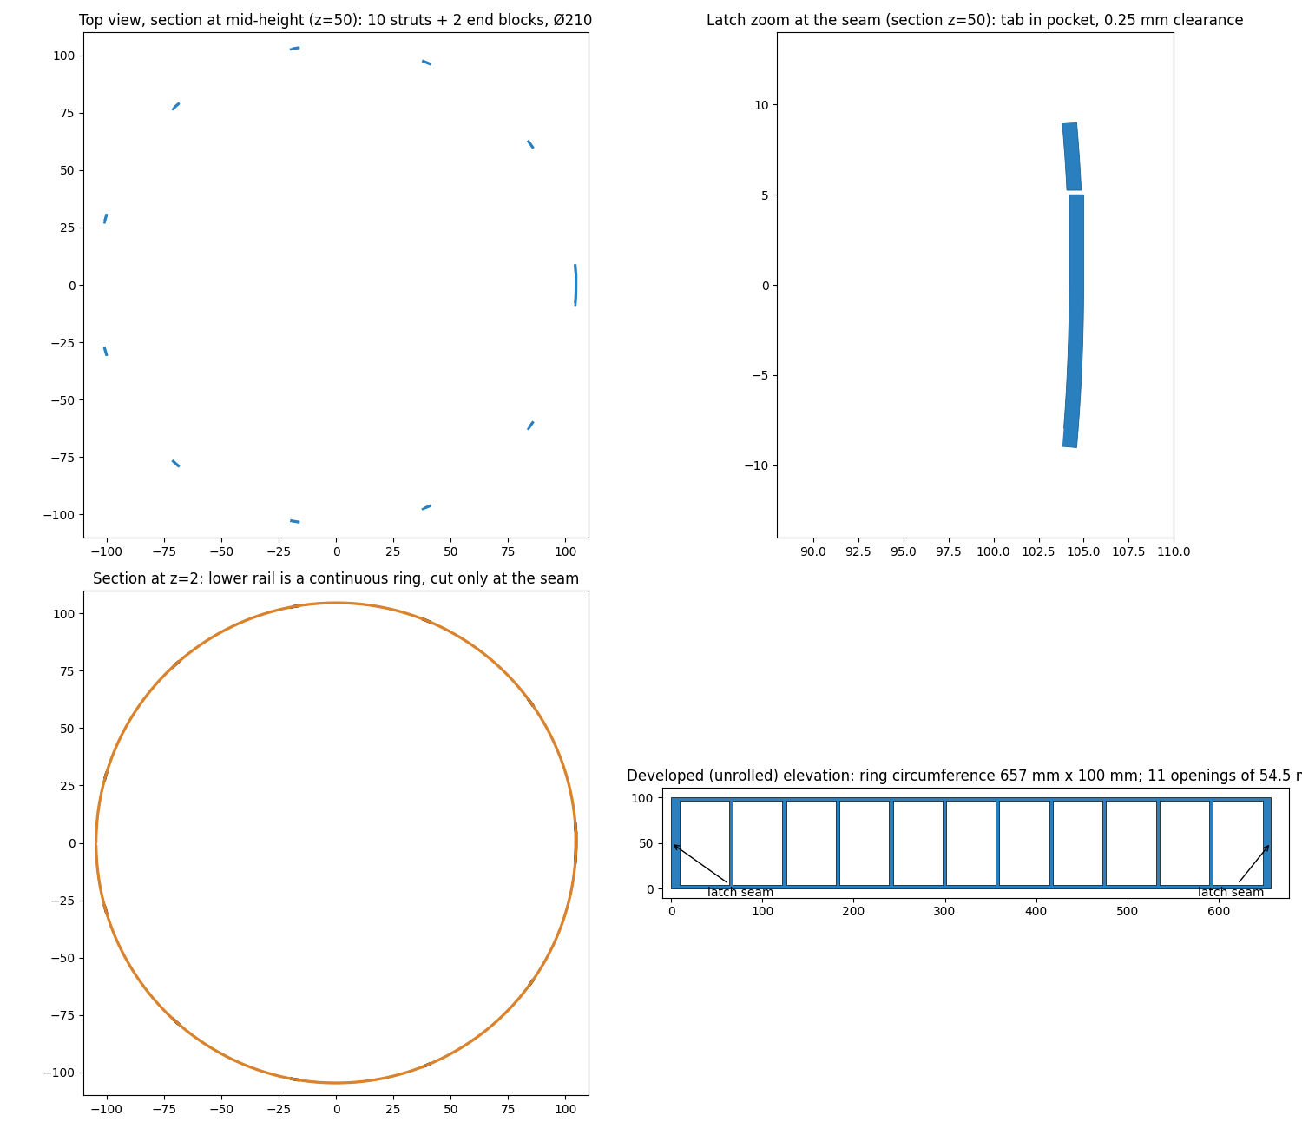
cad/ladder-liner/geometry.png
