asdfgh0318/SoundVisualizer/cad/ladder-liner/spiral-geometry.png

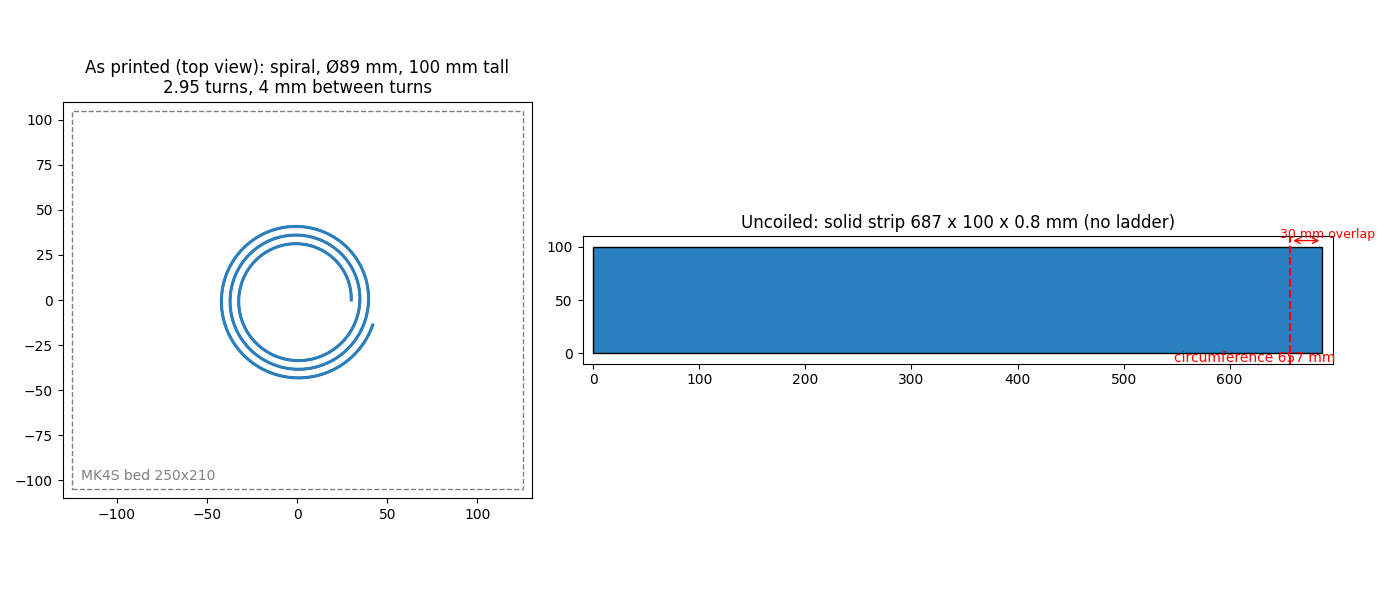
cad/ladder-liner/spiral-geometry.png
