asdfgh0318/SoundVisualizer/docs/analysis/arc-error-map.png

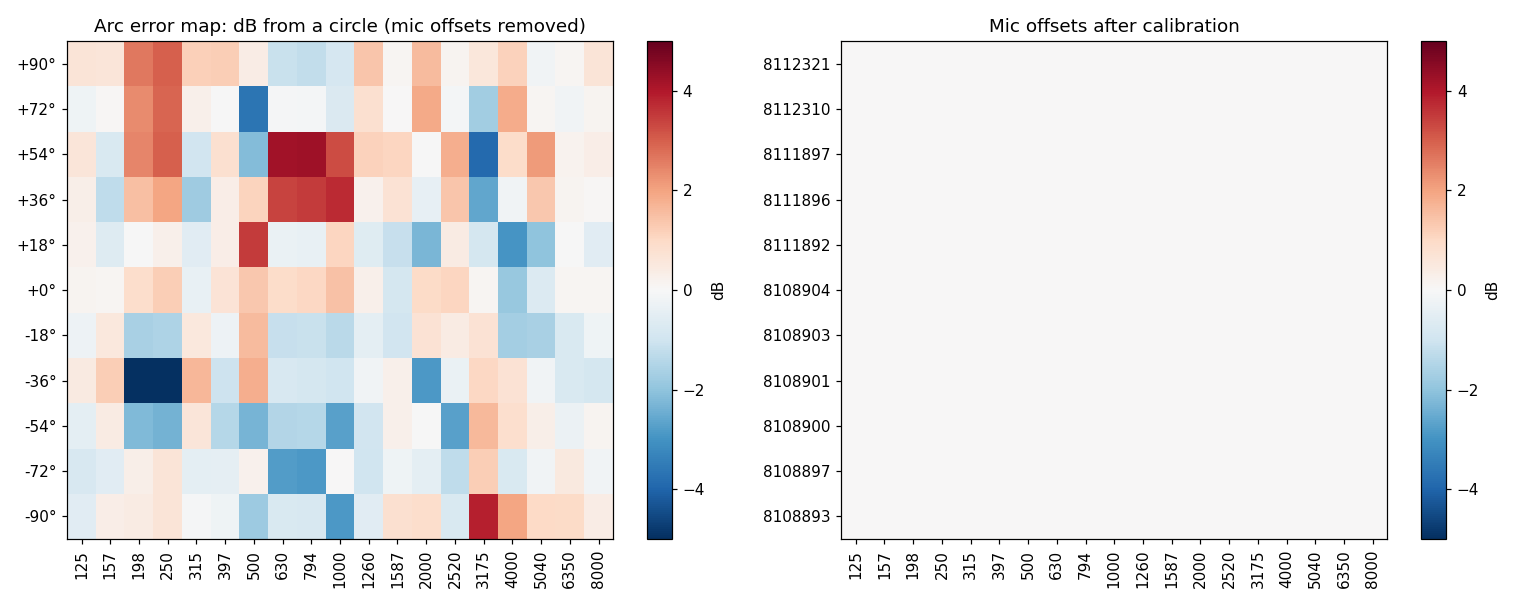
docs/analysis/arc-error-map.png
