asdfgh0318/SoundVisualizer/docs/analysis/brief-fig1-polars.png

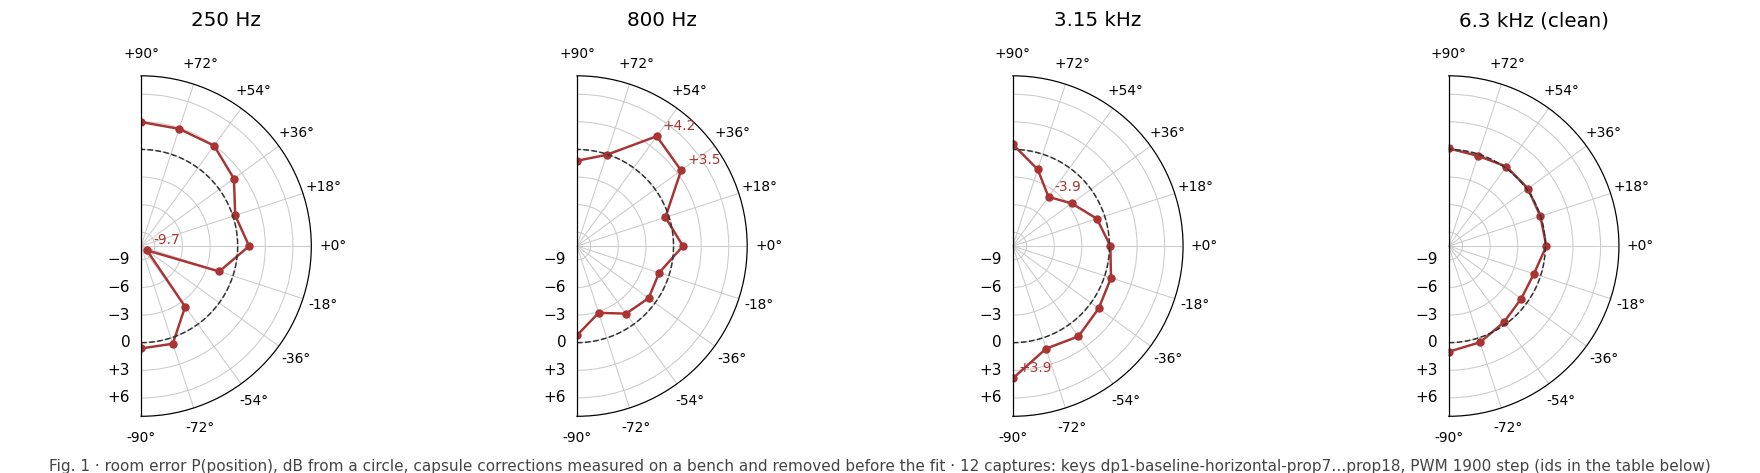
docs/analysis/brief-fig1-polars.png
