asdfgh0318/SoundVisualizer/docs/analysis/brief-fig2-errormap.png

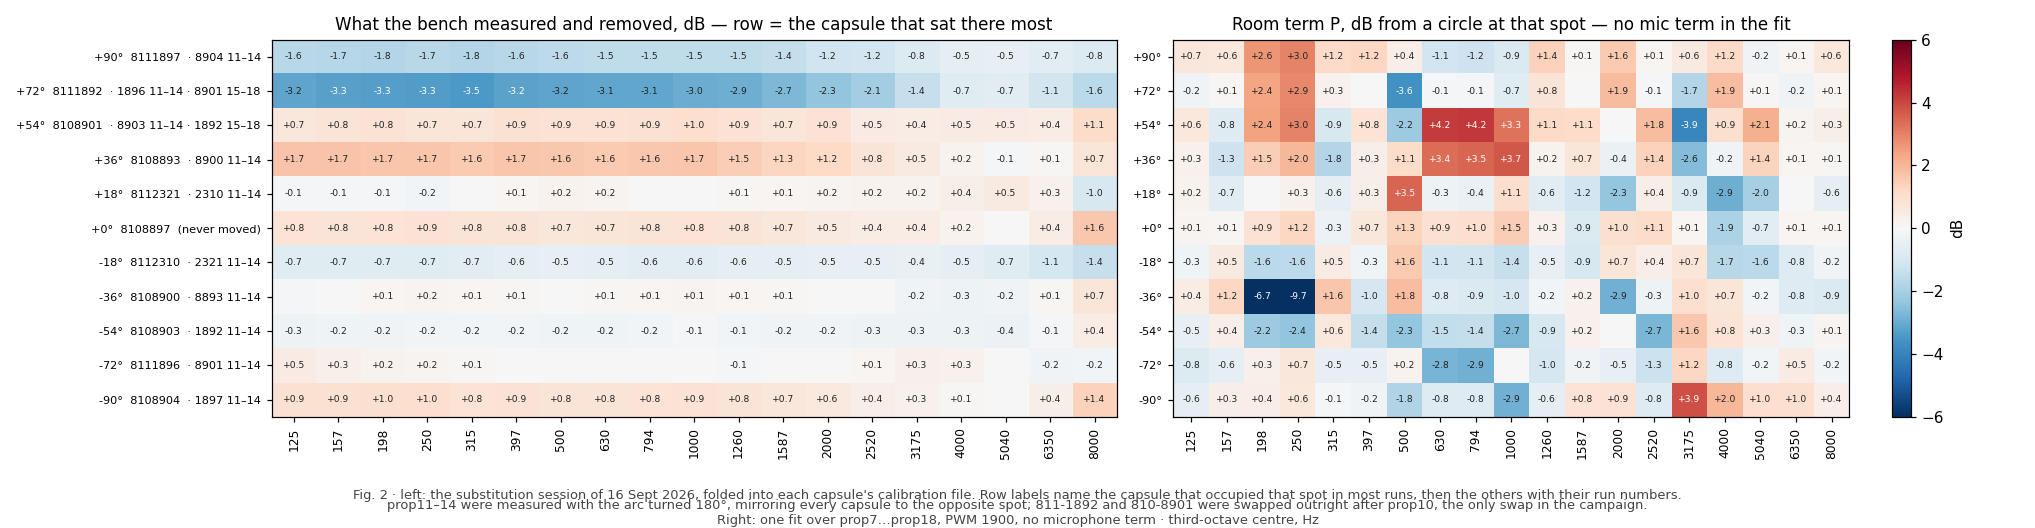
docs/analysis/brief-fig2-errormap.png
