asdfgh0318/SoundVisualizer/docs/analysis/brief-fig3-position-vs-mic.png

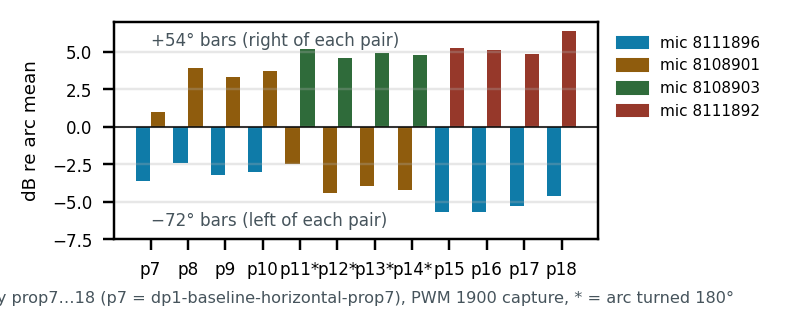
docs/analysis/brief-fig3-position-vs-mic.png
