asdfgh0318/SoundVisualizer/docs/analysis/brief-fig4-mic-vs-room.png

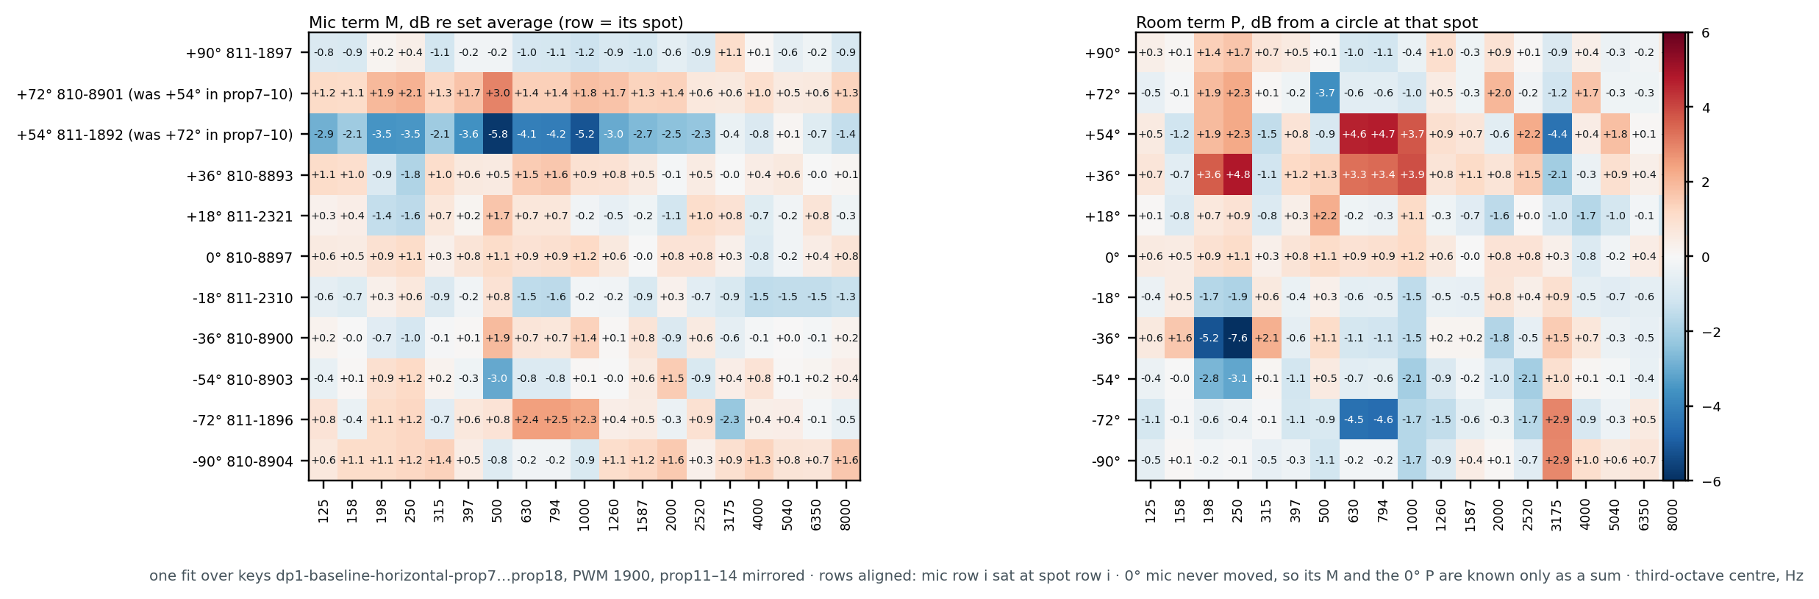
docs/analysis/brief-fig4-mic-vs-room.png
