asdfgh0318/SoundVisualizer/docs/analysis/chamber-final-2026-10-01/fig-mic.png

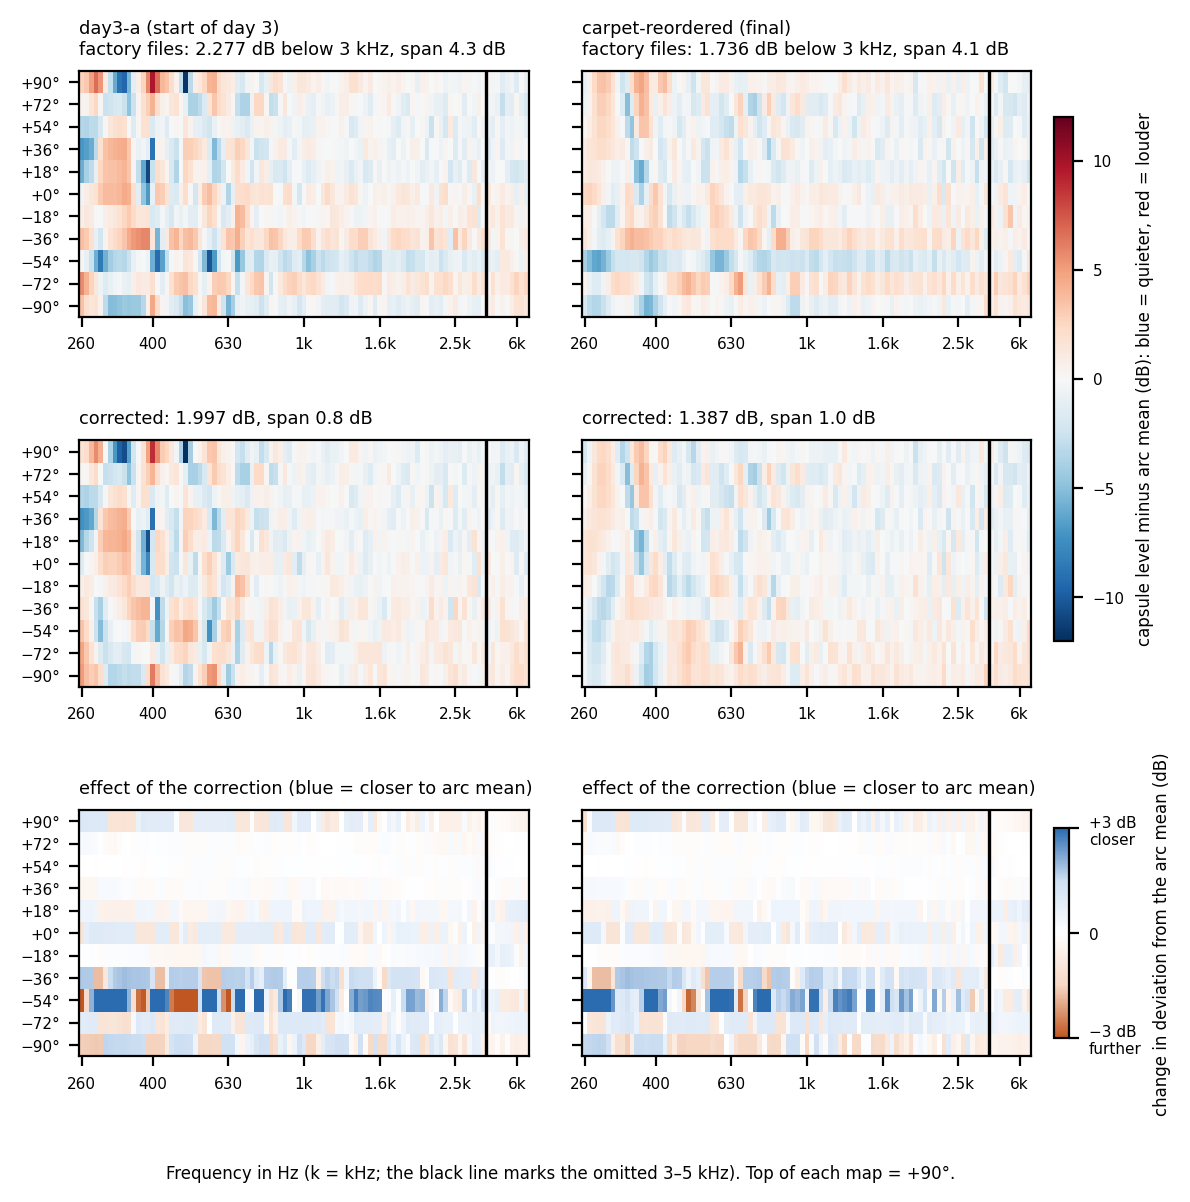
docs/analysis/chamber-final-2026-10-01/fig-mic.png
