asdfgh0318/SoundVisualizer/docs/analysis/chamber-final-2026-10-01/slides/bands-r27-inlet.png

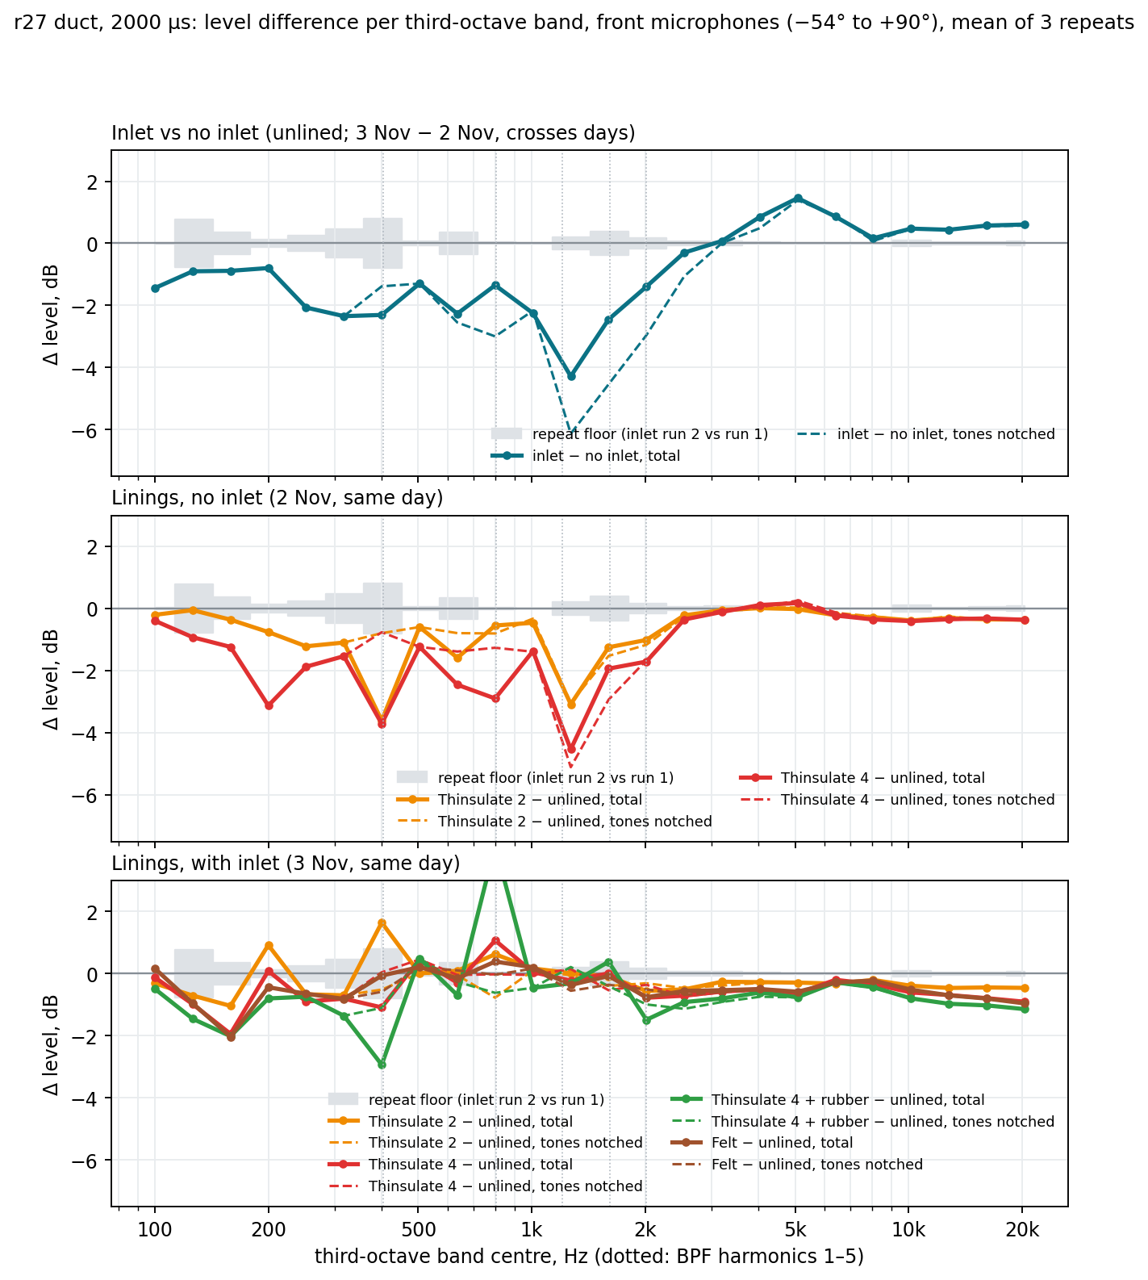
docs/analysis/chamber-final-2026-10-01/slides/bands-r27-inlet.png
