asdfgh0318/SoundVisualizer/docs/analysis/chamber-final-2026-10-01/slides/heatmap-r27-bare-duct-inlet.png

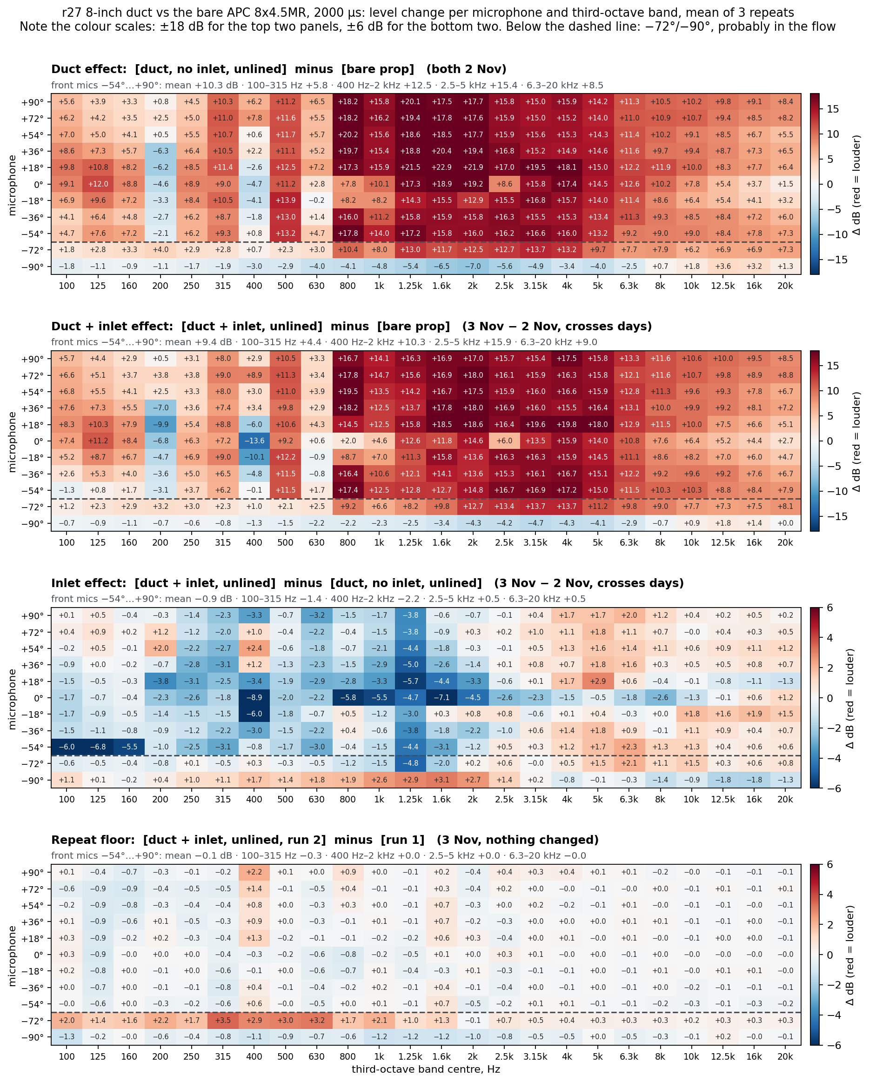
docs/analysis/chamber-final-2026-10-01/slides/heatmap-r27-bare-duct-inlet.png
