asdfgh0318/SoundVisualizer/docs/analysis/chamber-final-2026-10-01/slides/lining-vs-nothing-r27-per-wall.png

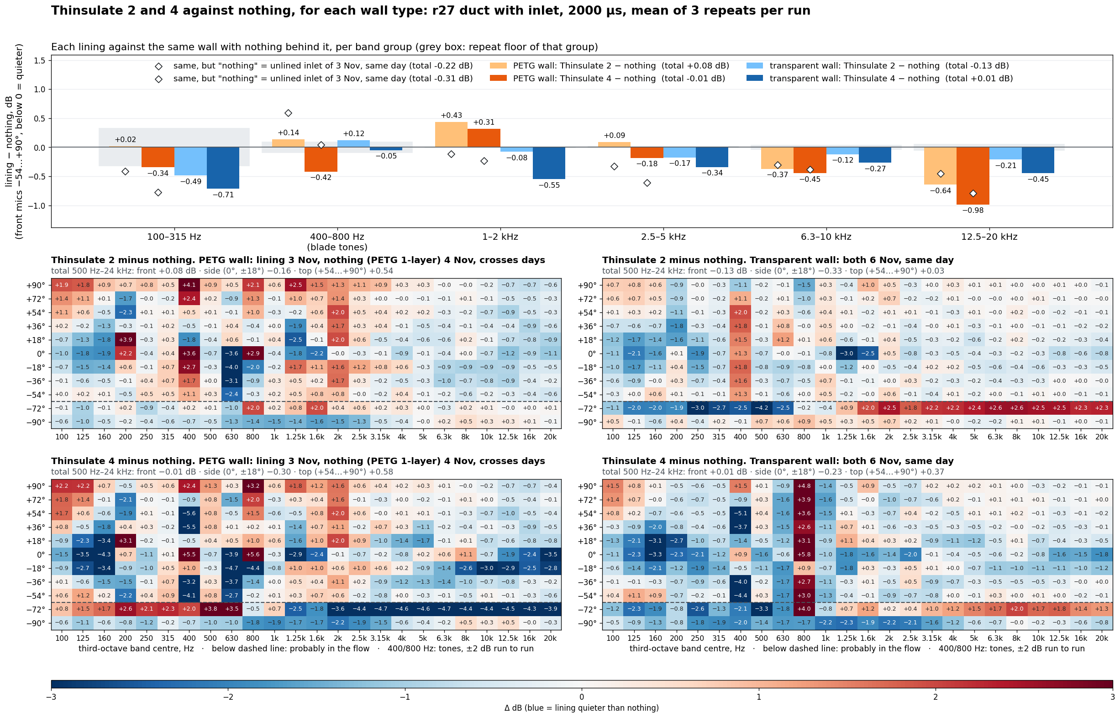
docs/analysis/chamber-final-2026-10-01/slides/lining-vs-nothing-r27-per-wall.png
