asdfgh0318/SoundVisualizer/docs/analysis/chamber-final-2026-10-01/slides/wall-side-vs-top-r27.png

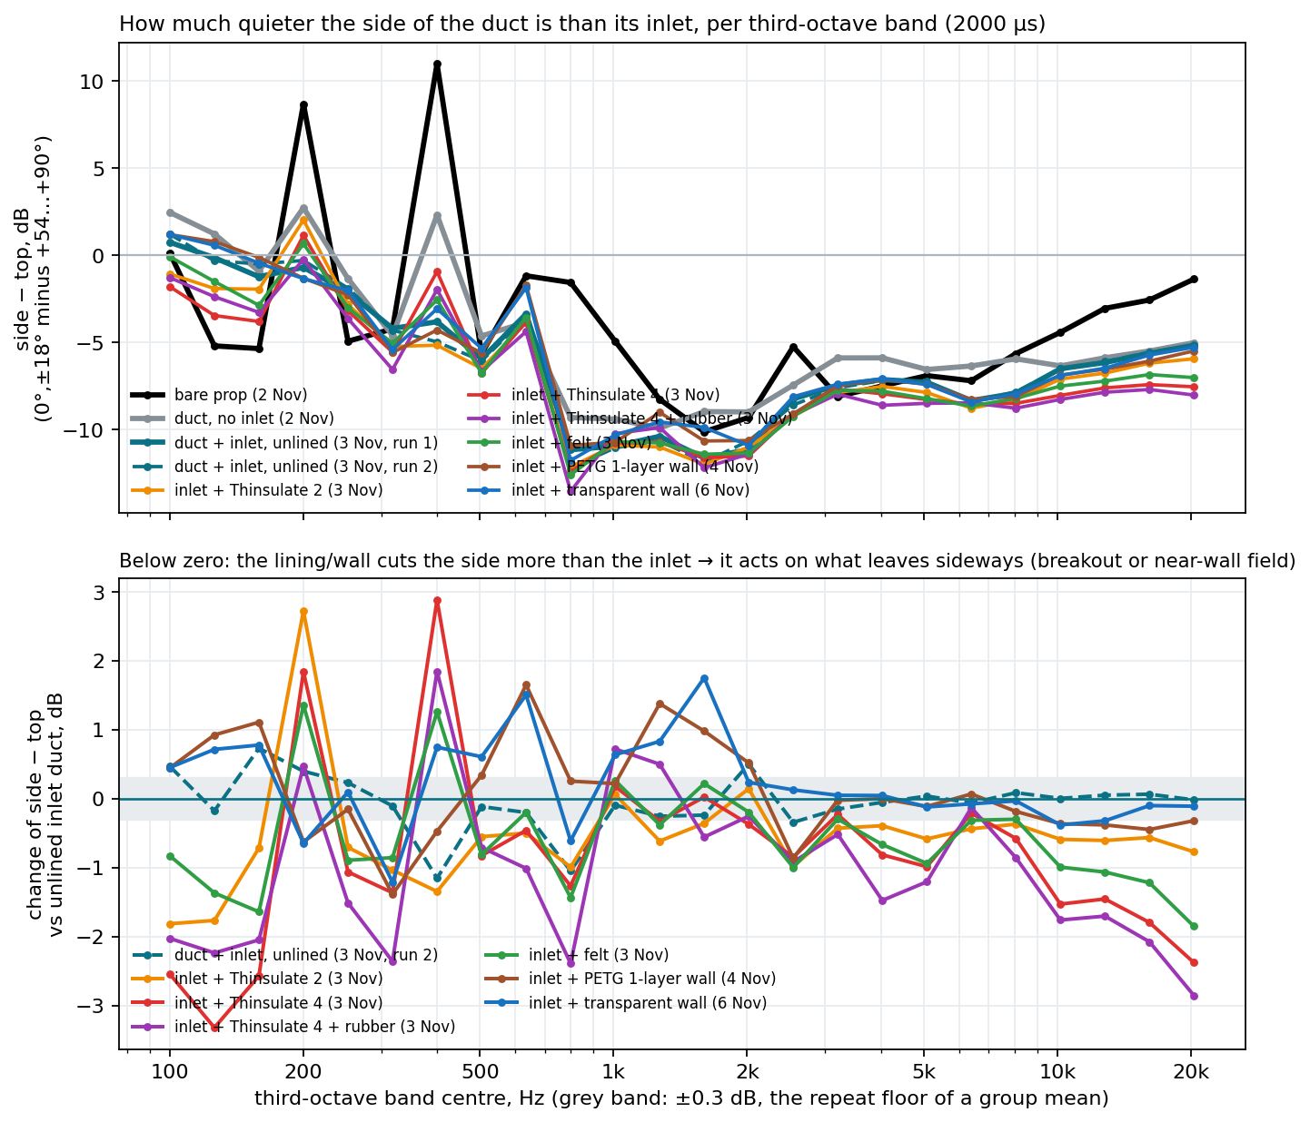
docs/analysis/chamber-final-2026-10-01/slides/wall-side-vs-top-r27.png
