asdfgh0318/SoundVisualizer/docs/analysis/chamber-final-2026-10-01/slides/walls-r27-transparent-vs-petg.png

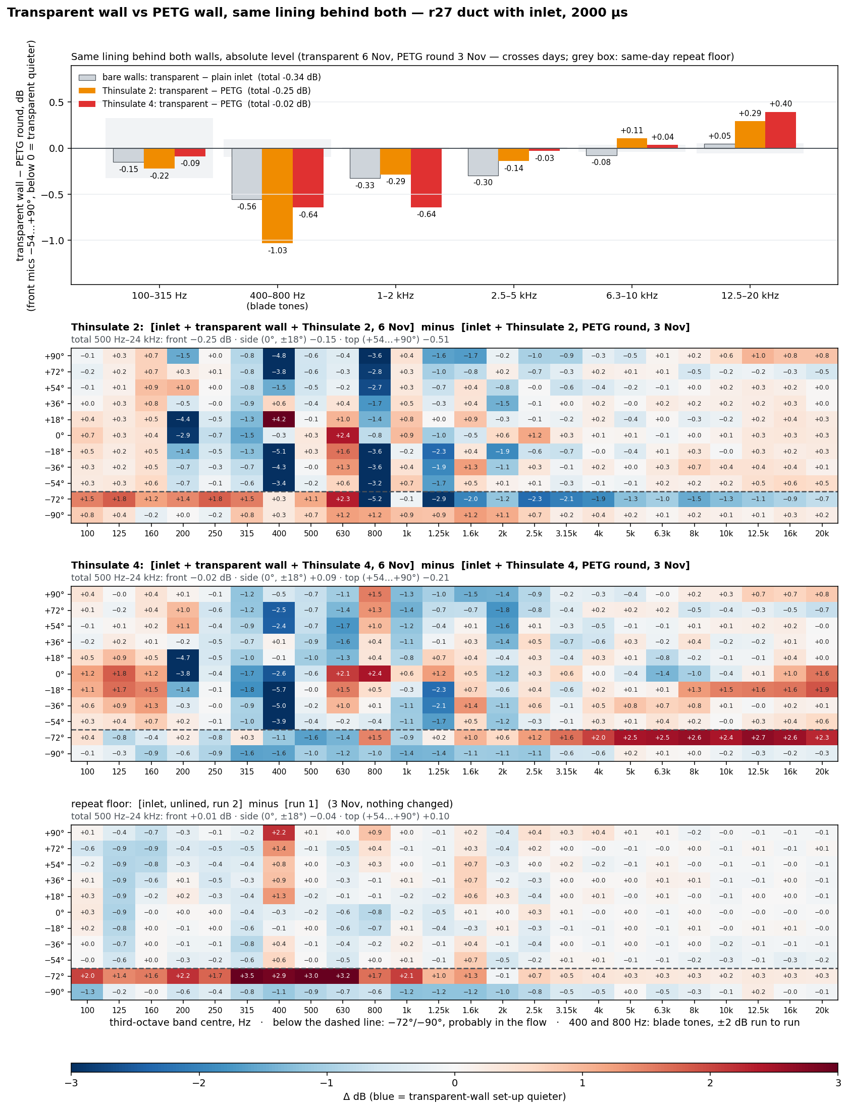
docs/analysis/chamber-final-2026-10-01/slides/walls-r27-transparent-vs-petg.png
