asdfgh0318/SoundVisualizer/docs/analysis/chamber-final-2026-10-01/slides/waterfall-r27-thin4-petg-vs-transparent.png

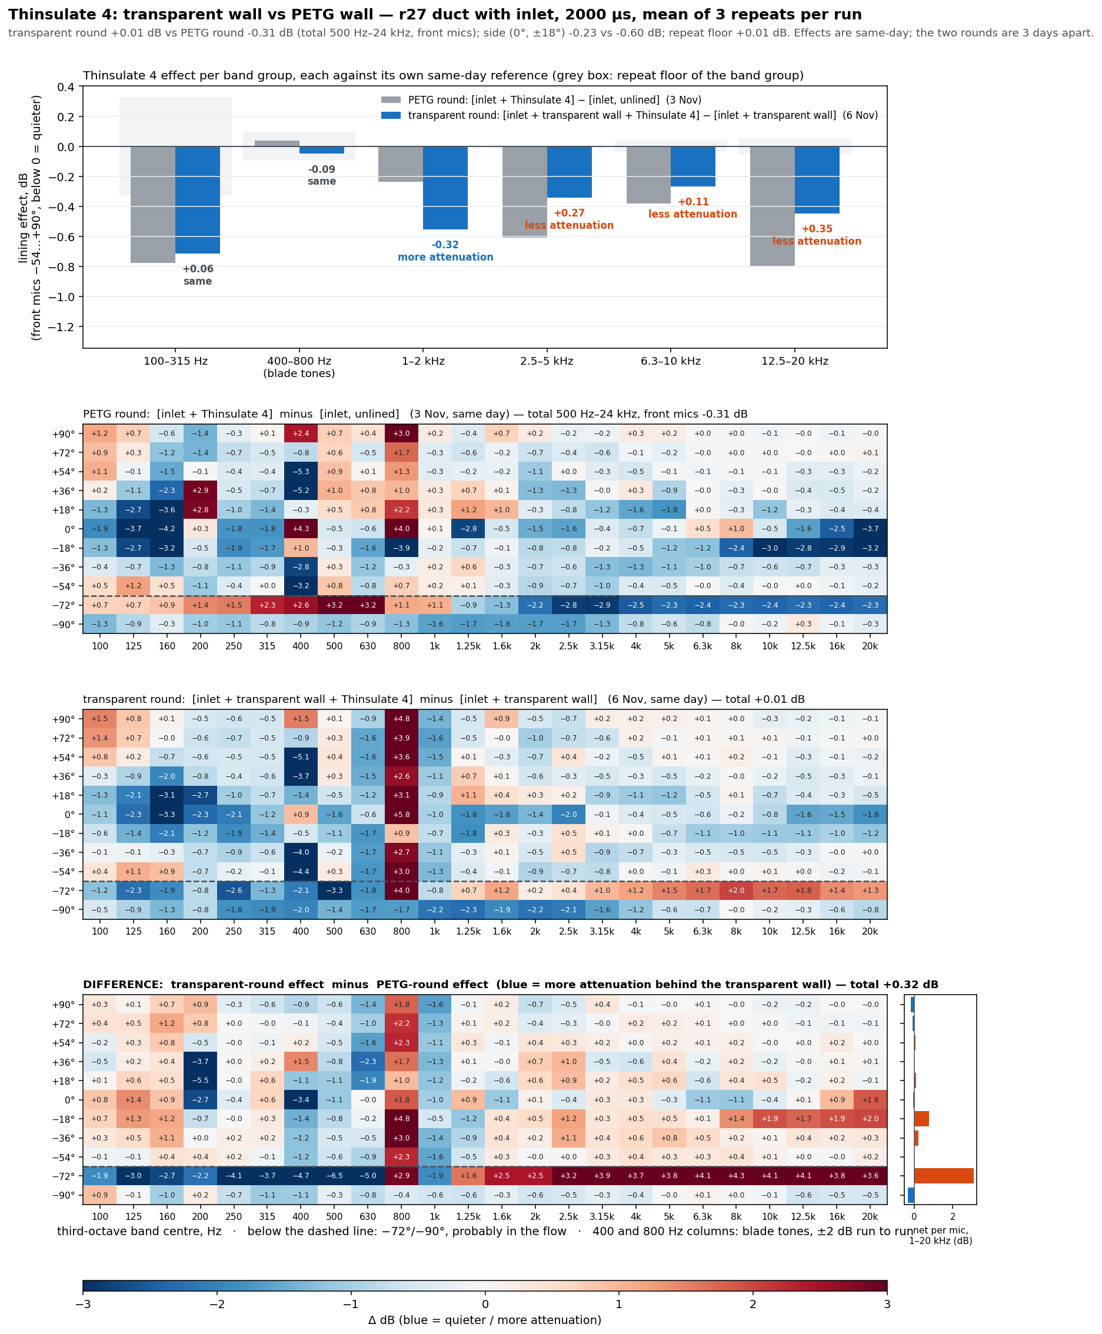
docs/analysis/chamber-final-2026-10-01/slides/waterfall-r27-thin4-petg-vs-transparent.png
