asdfgh0318/SoundVisualizer/docs/analysis/chamber-final-2026-10-01/slides/waterfall-r27-walls-bare.png

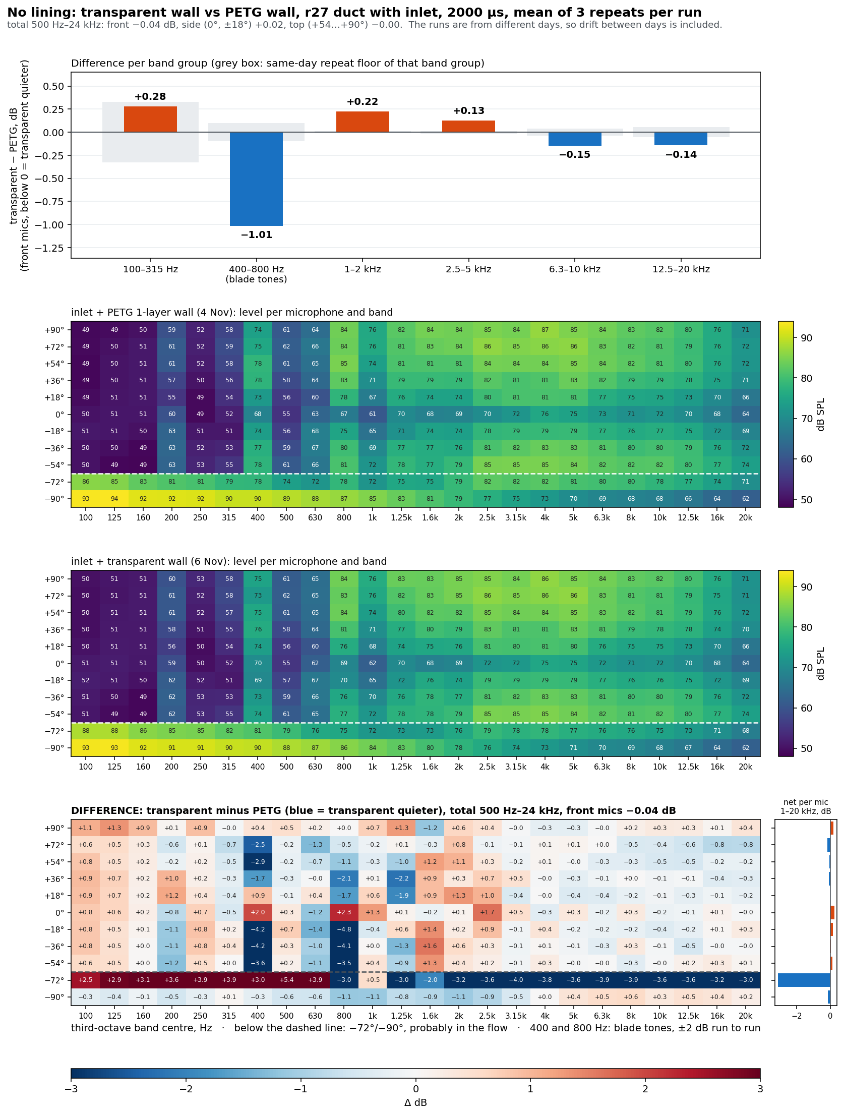
docs/analysis/chamber-final-2026-10-01/slides/waterfall-r27-walls-bare.png
