asdfgh0318/SoundVisualizer/docs/analysis/chamber-final-2026-10-01/slides/waterfall-r27-walls-thin2.png

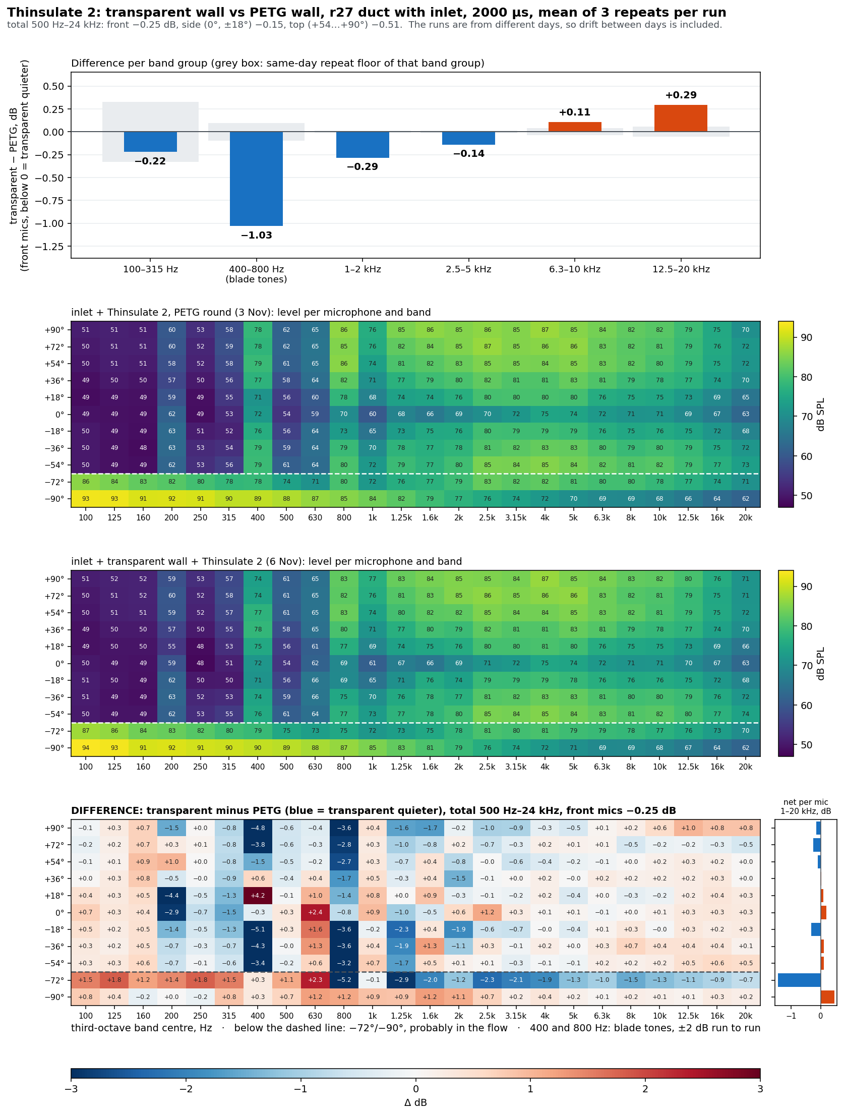
docs/analysis/chamber-final-2026-10-01/slides/waterfall-r27-walls-thin2.png
