asdfgh0318/SoundVisualizer/docs/analysis/chamber-treatments-2026-09-23/blue-carpet-day3.png

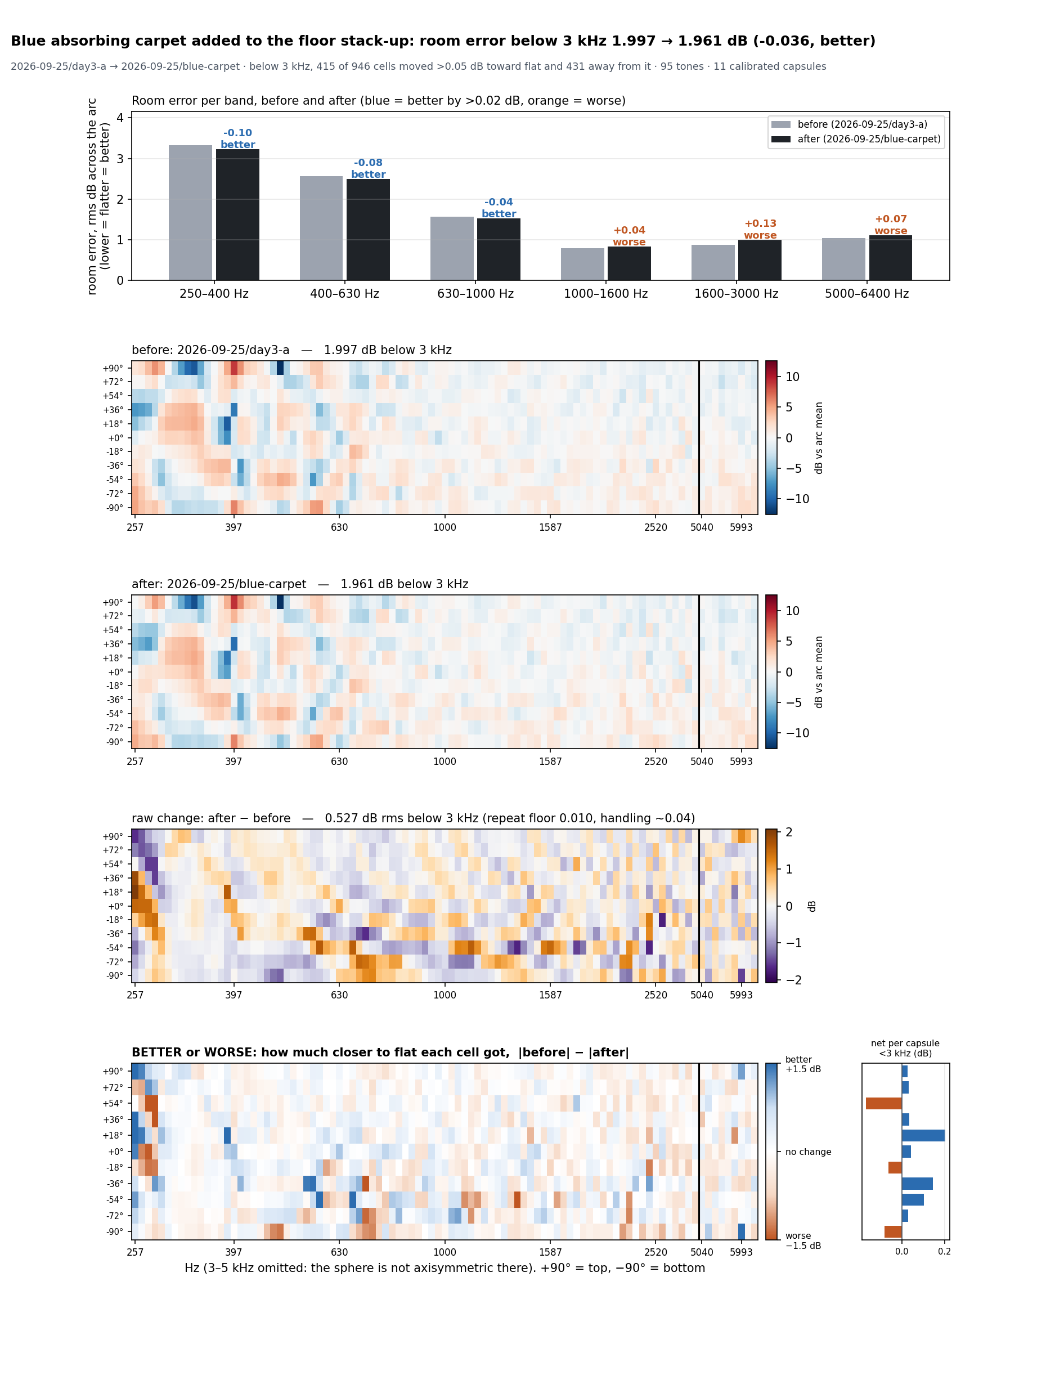
docs/analysis/chamber-treatments-2026-09-23/blue-carpet-day3.png
