asdfgh0318/SoundVisualizer/docs/analysis/chamber-treatments-2026-09-23/carpet-on-flat-foam-day2.png

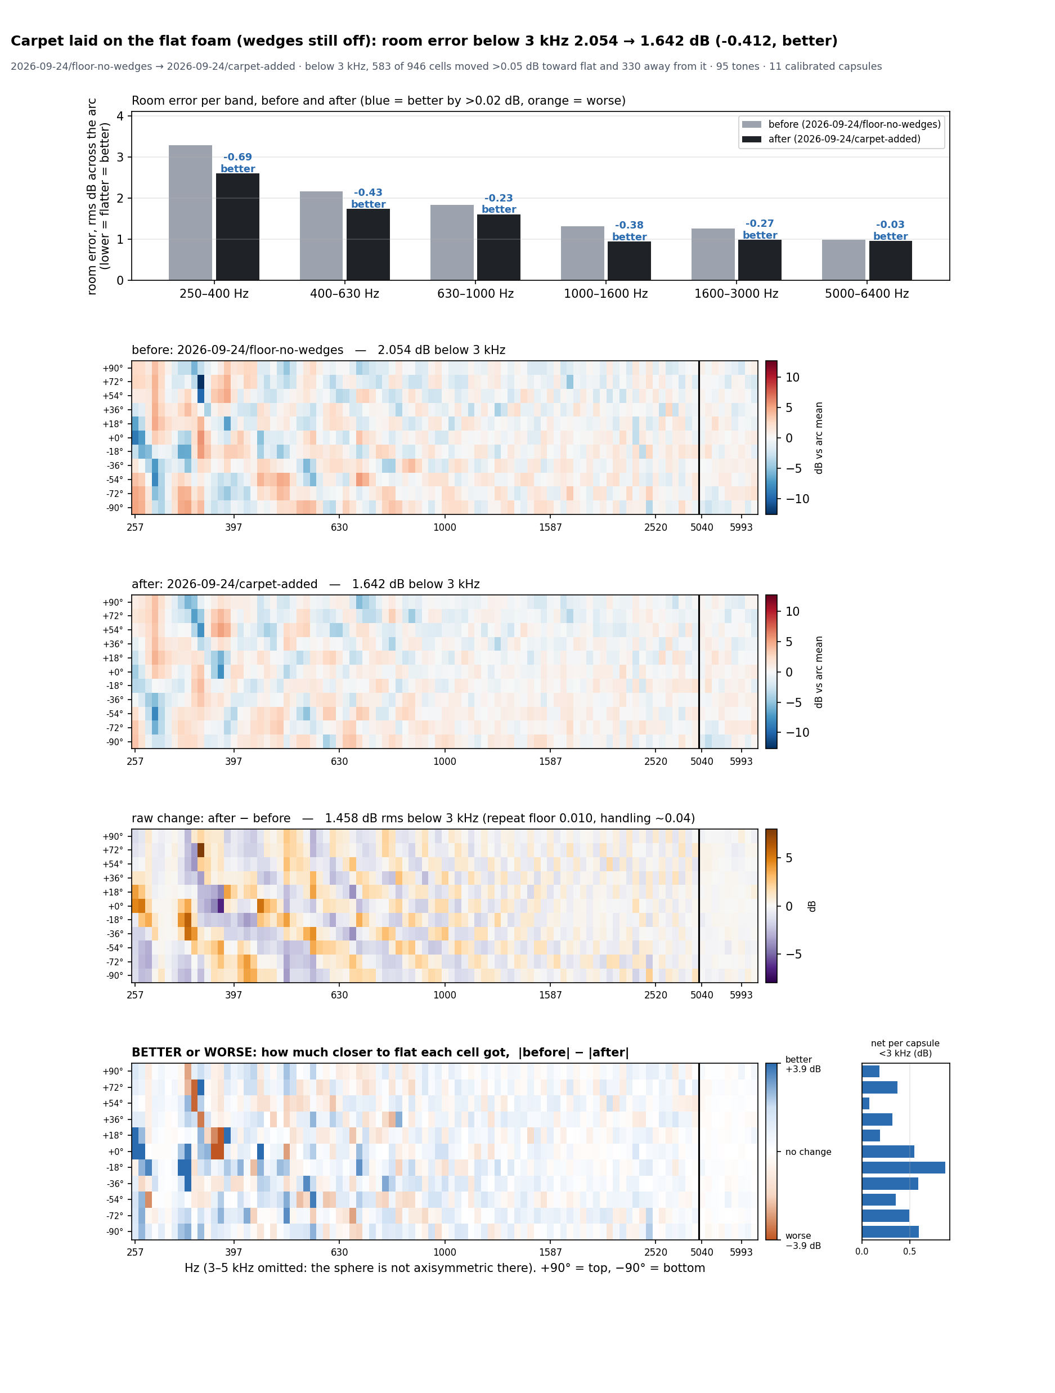
docs/analysis/chamber-treatments-2026-09-23/carpet-on-flat-foam-day2.png
