asdfgh0318/SoundVisualizer/docs/analysis/chamber-treatments-2026-09-23/ceiling-felt-to-floor-day2.png

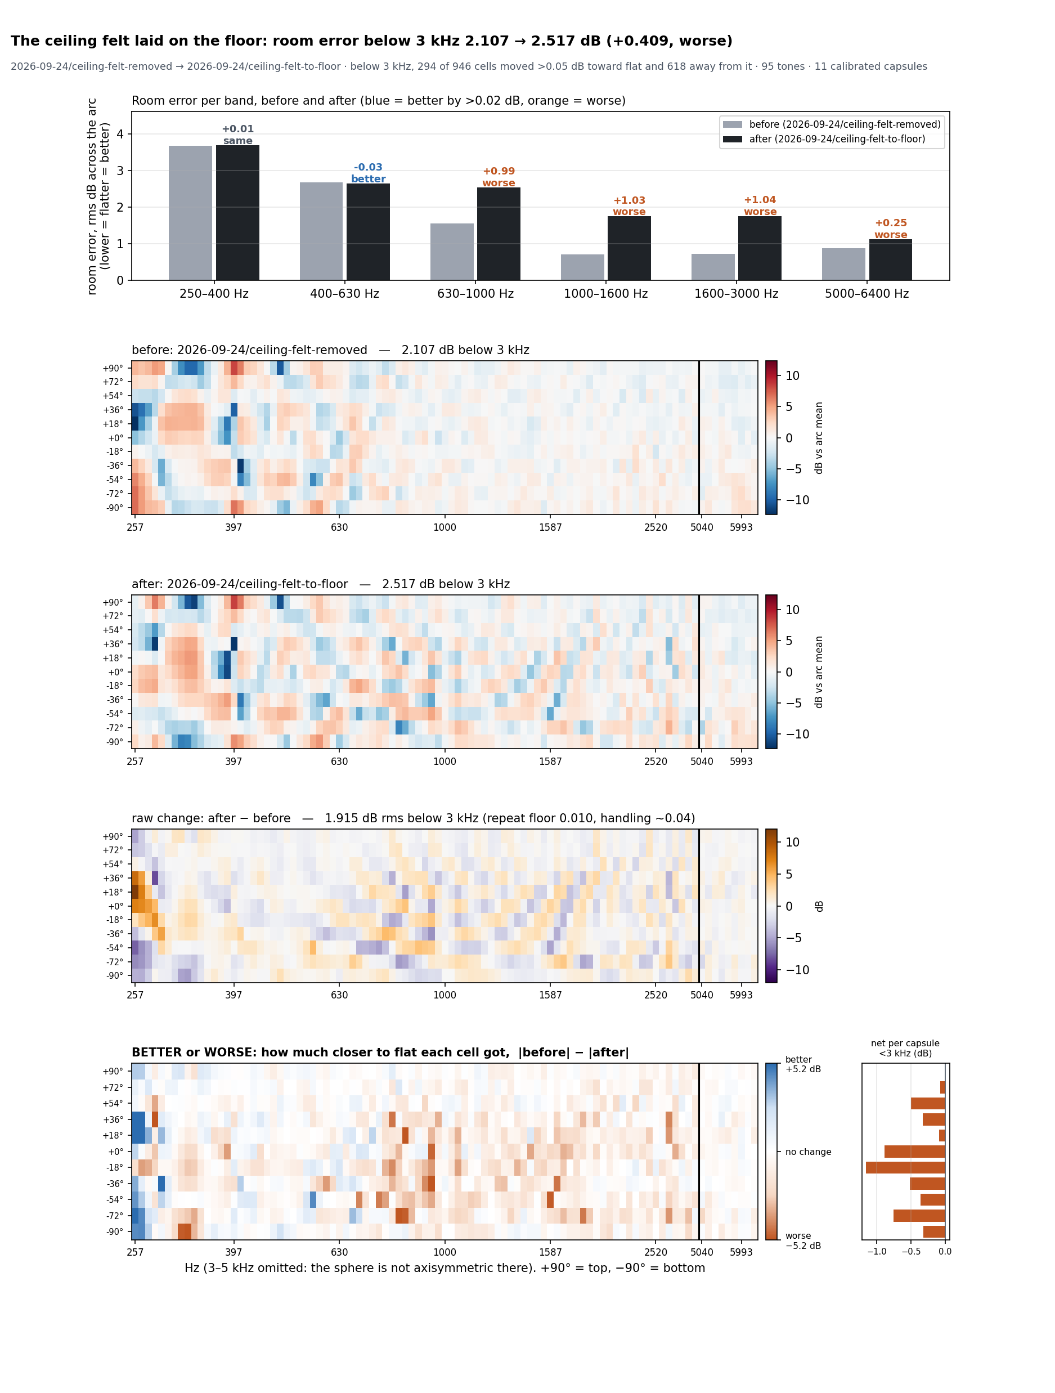
docs/analysis/chamber-treatments-2026-09-23/ceiling-felt-to-floor-day2.png
