asdfgh0318/SoundVisualizer/docs/analysis/chamber-treatments-2026-09-23/center-new-day2.png

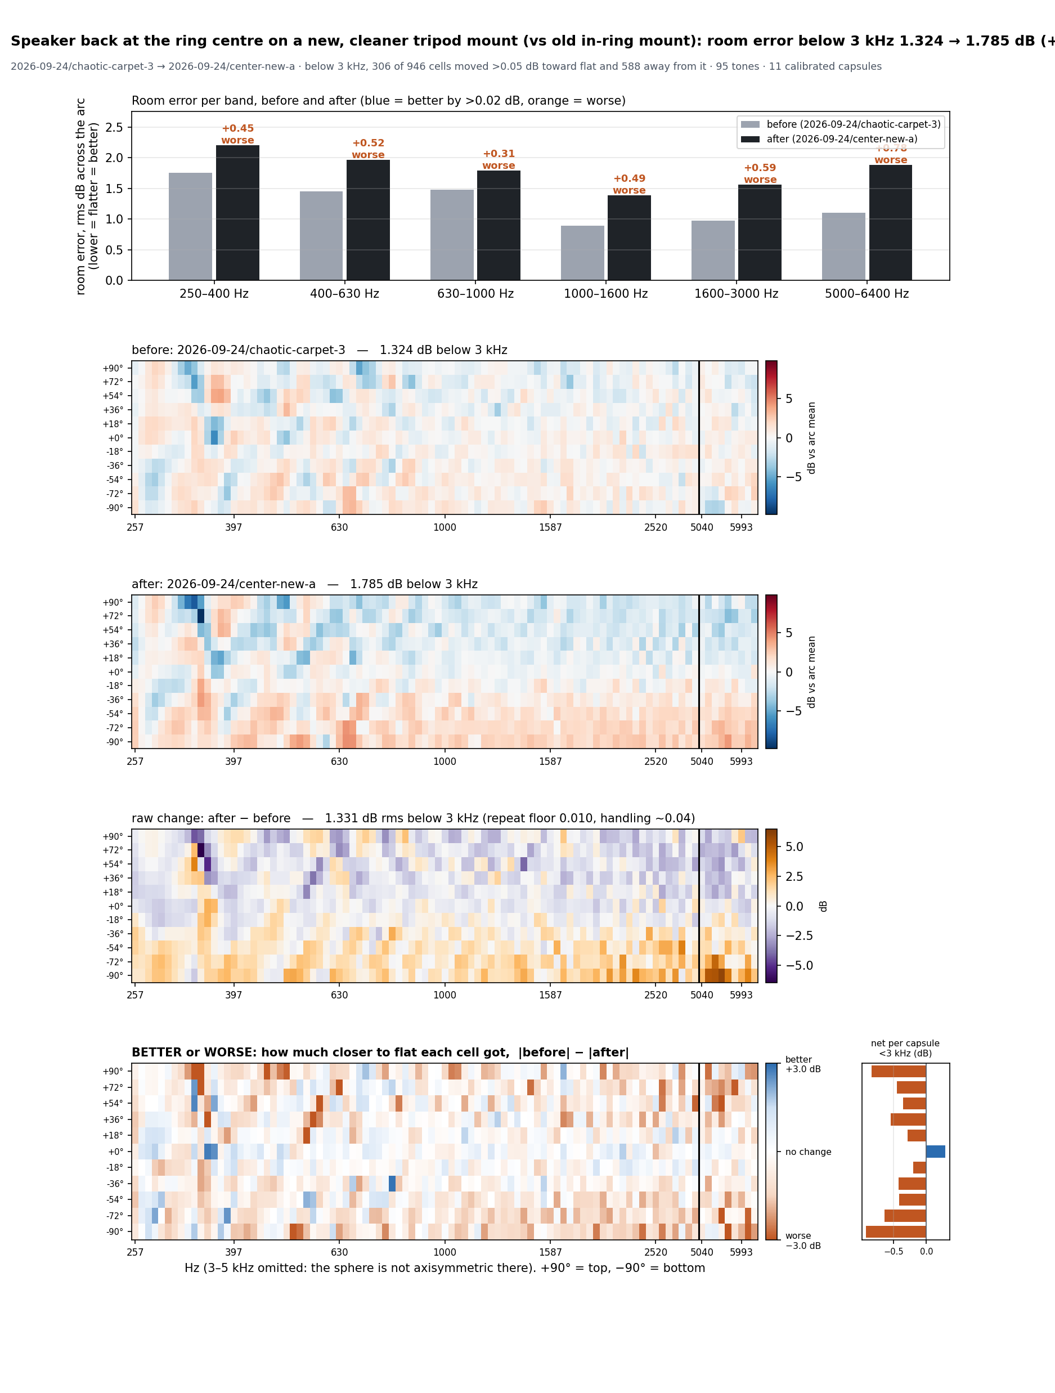
docs/analysis/chamber-treatments-2026-09-23/center-new-day2.png
