asdfgh0318/SoundVisualizer/docs/analysis/chamber-treatments-2026-09-23/chaotic-2-vs-1-day2.png

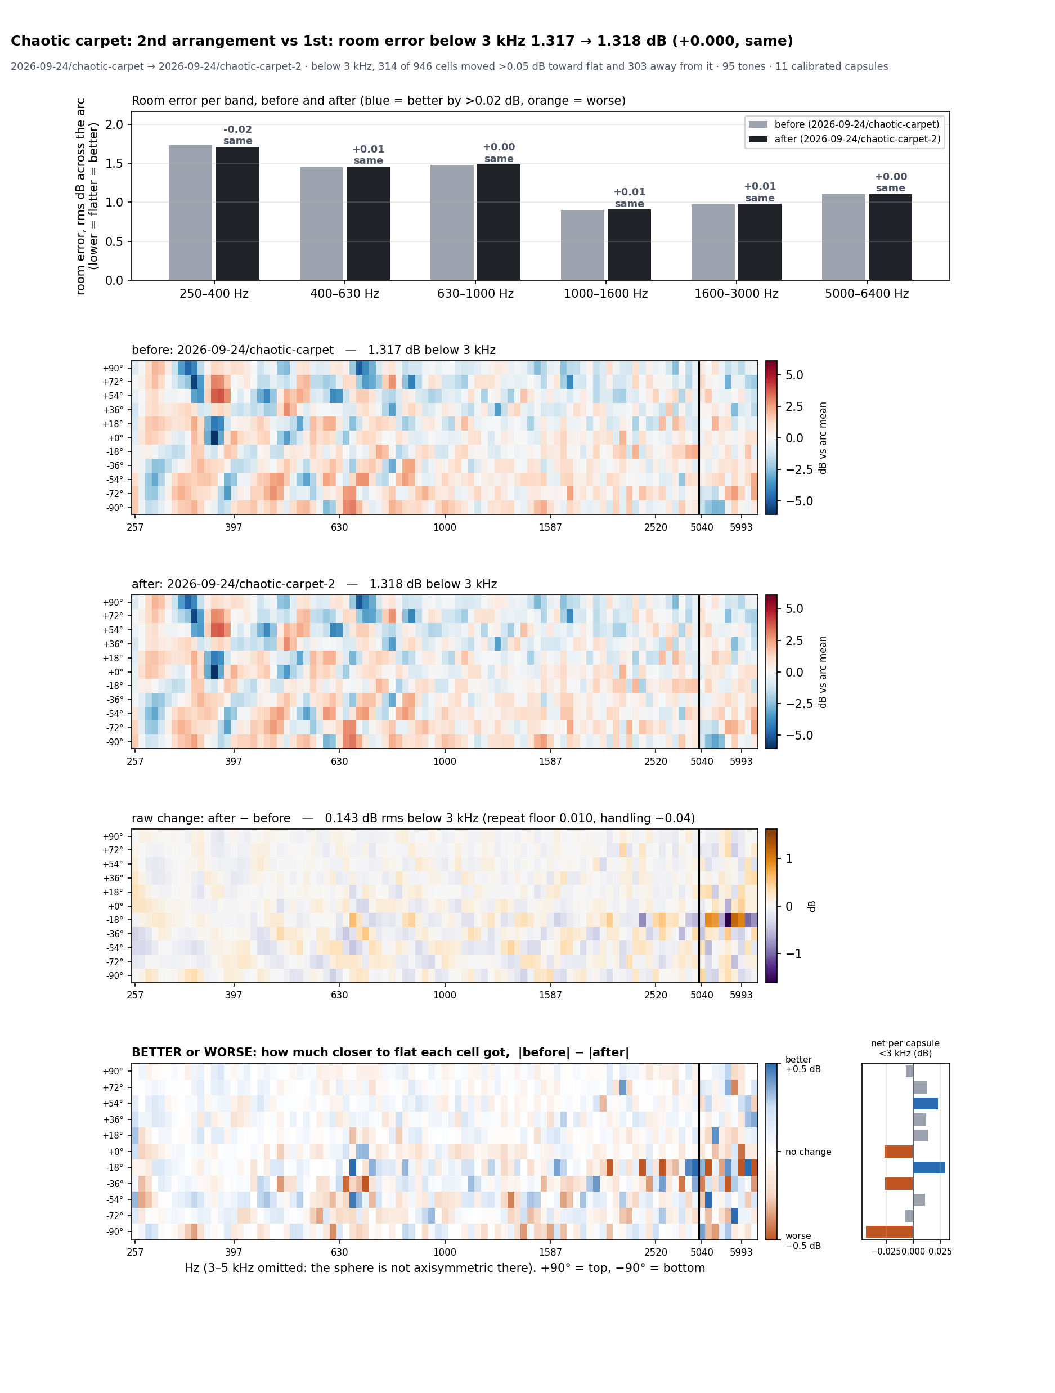
docs/analysis/chamber-treatments-2026-09-23/chaotic-2-vs-1-day2.png
