asdfgh0318/SoundVisualizer/docs/analysis/chamber-treatments-2026-09-23/chaotic-3-vs-2-day2.png

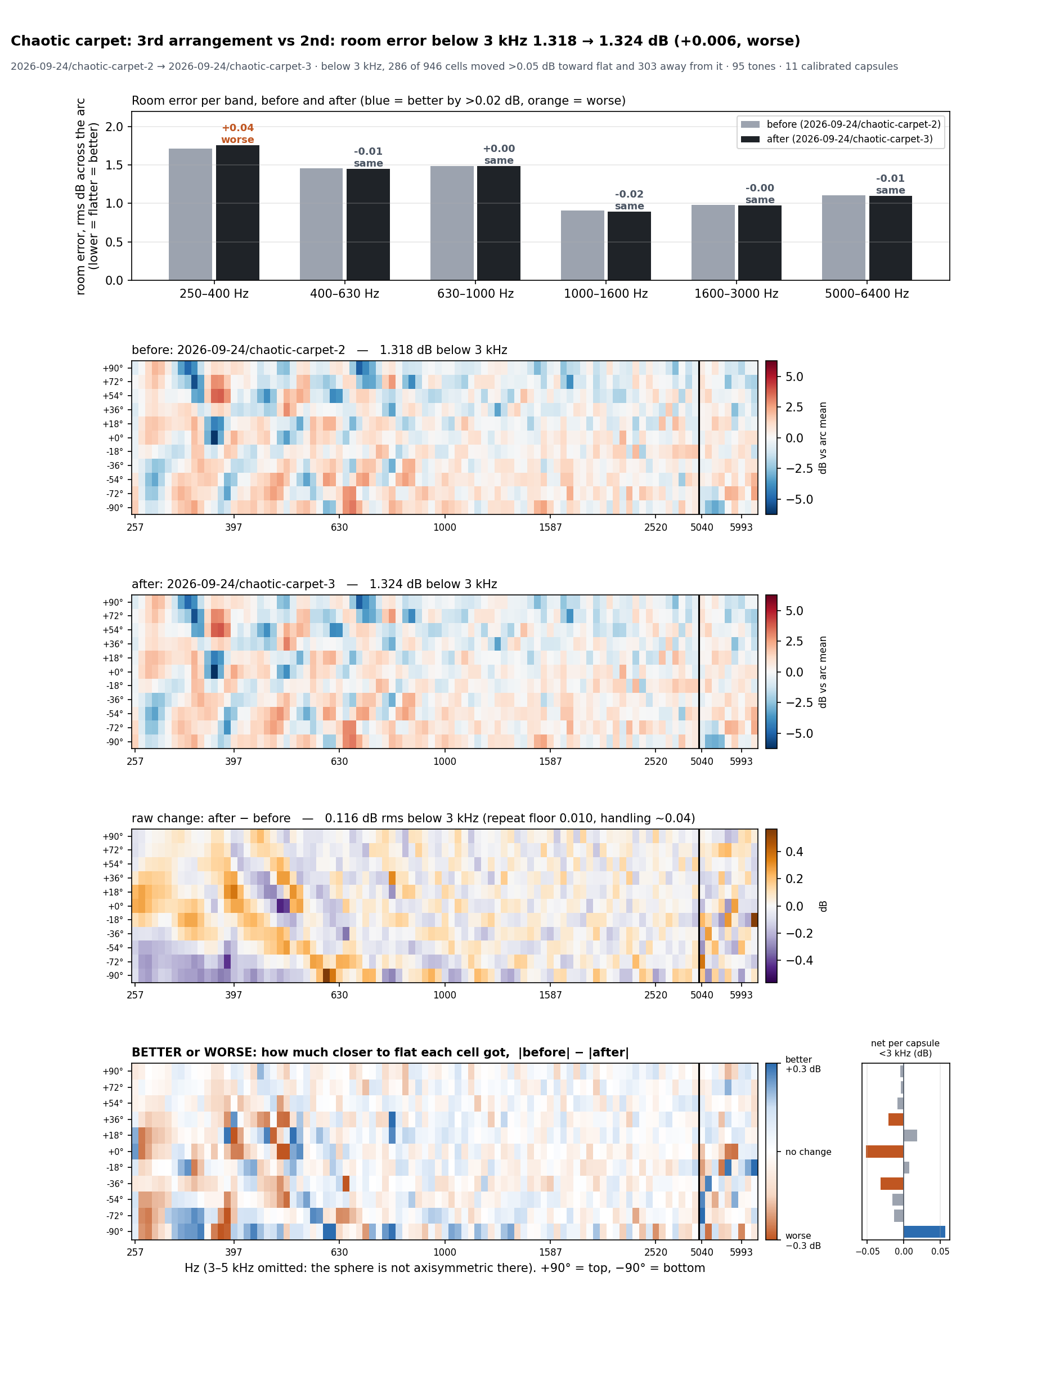
docs/analysis/chamber-treatments-2026-09-23/chaotic-3-vs-2-day2.png
