asdfgh0318/SoundVisualizer/docs/analysis/chamber-treatments-2026-09-23/curtain-day3.png

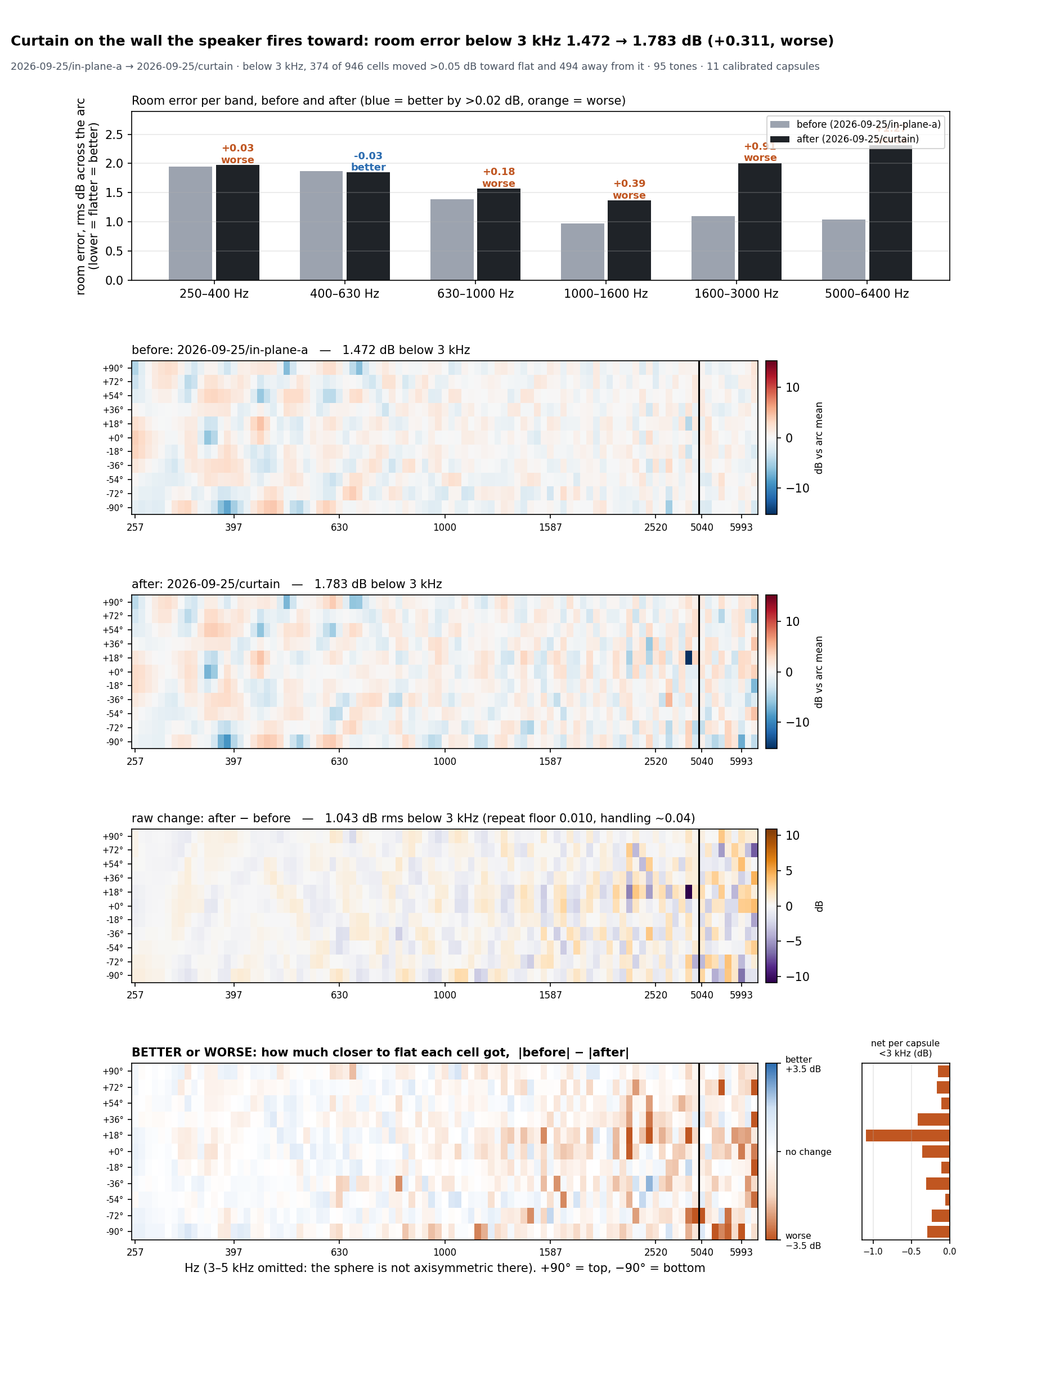
docs/analysis/chamber-treatments-2026-09-23/curtain-day3.png
