asdfgh0318/SoundVisualizer/docs/analysis/chamber-treatments-2026-09-23/felt-bare-day2.png

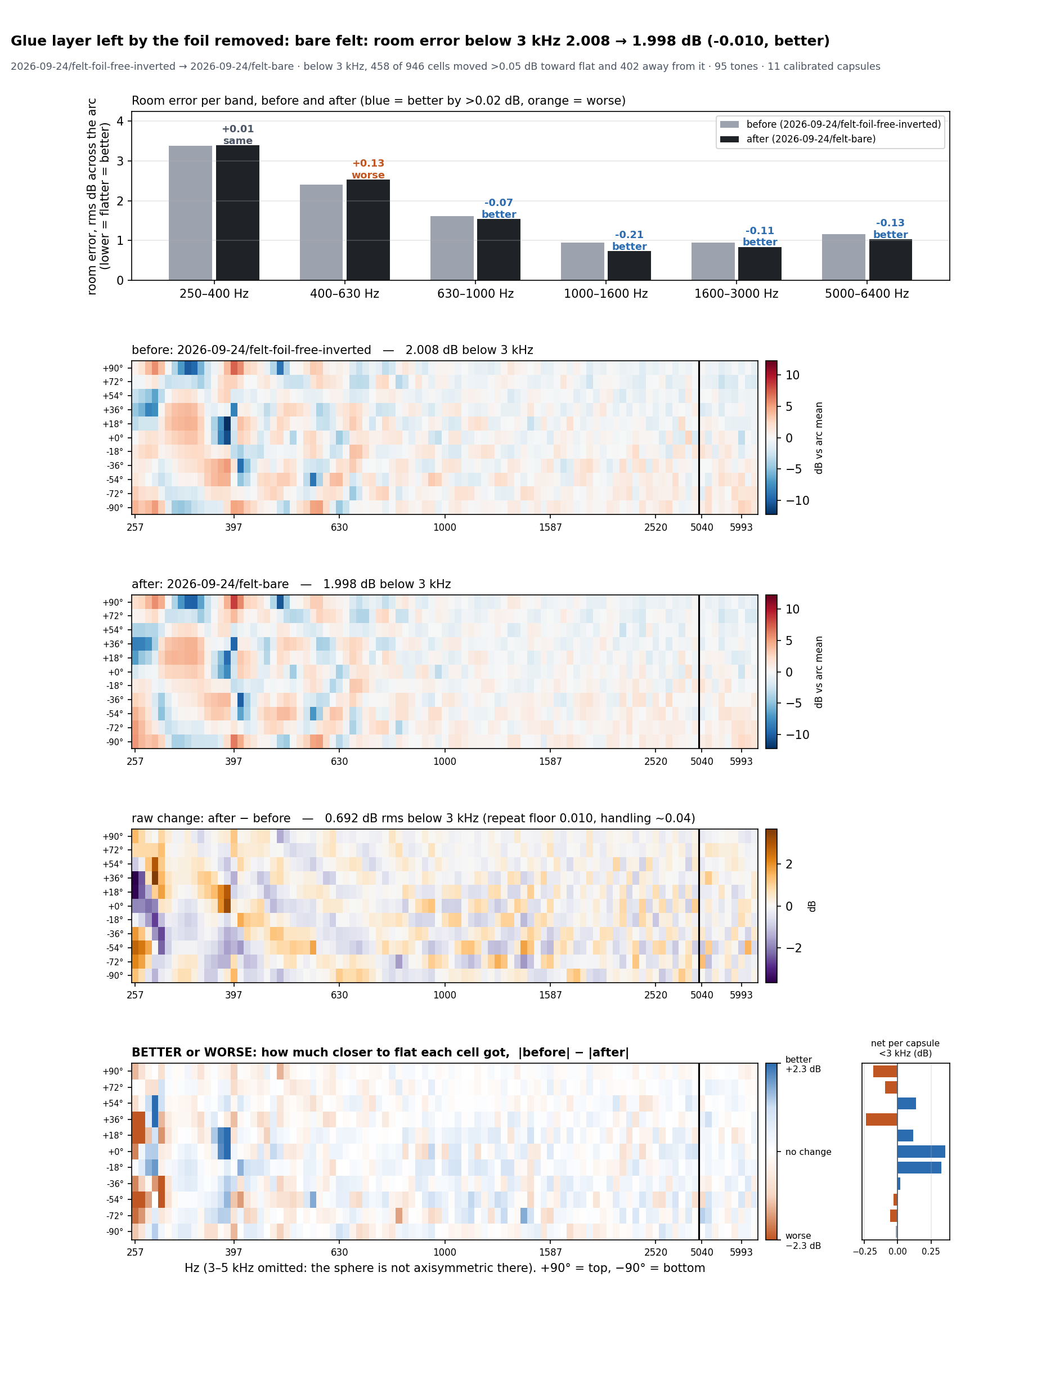
docs/analysis/chamber-treatments-2026-09-23/felt-bare-day2.png
