asdfgh0318/SoundVisualizer/docs/analysis/chamber-treatments-2026-09-23/floor-raised-3-day2.png

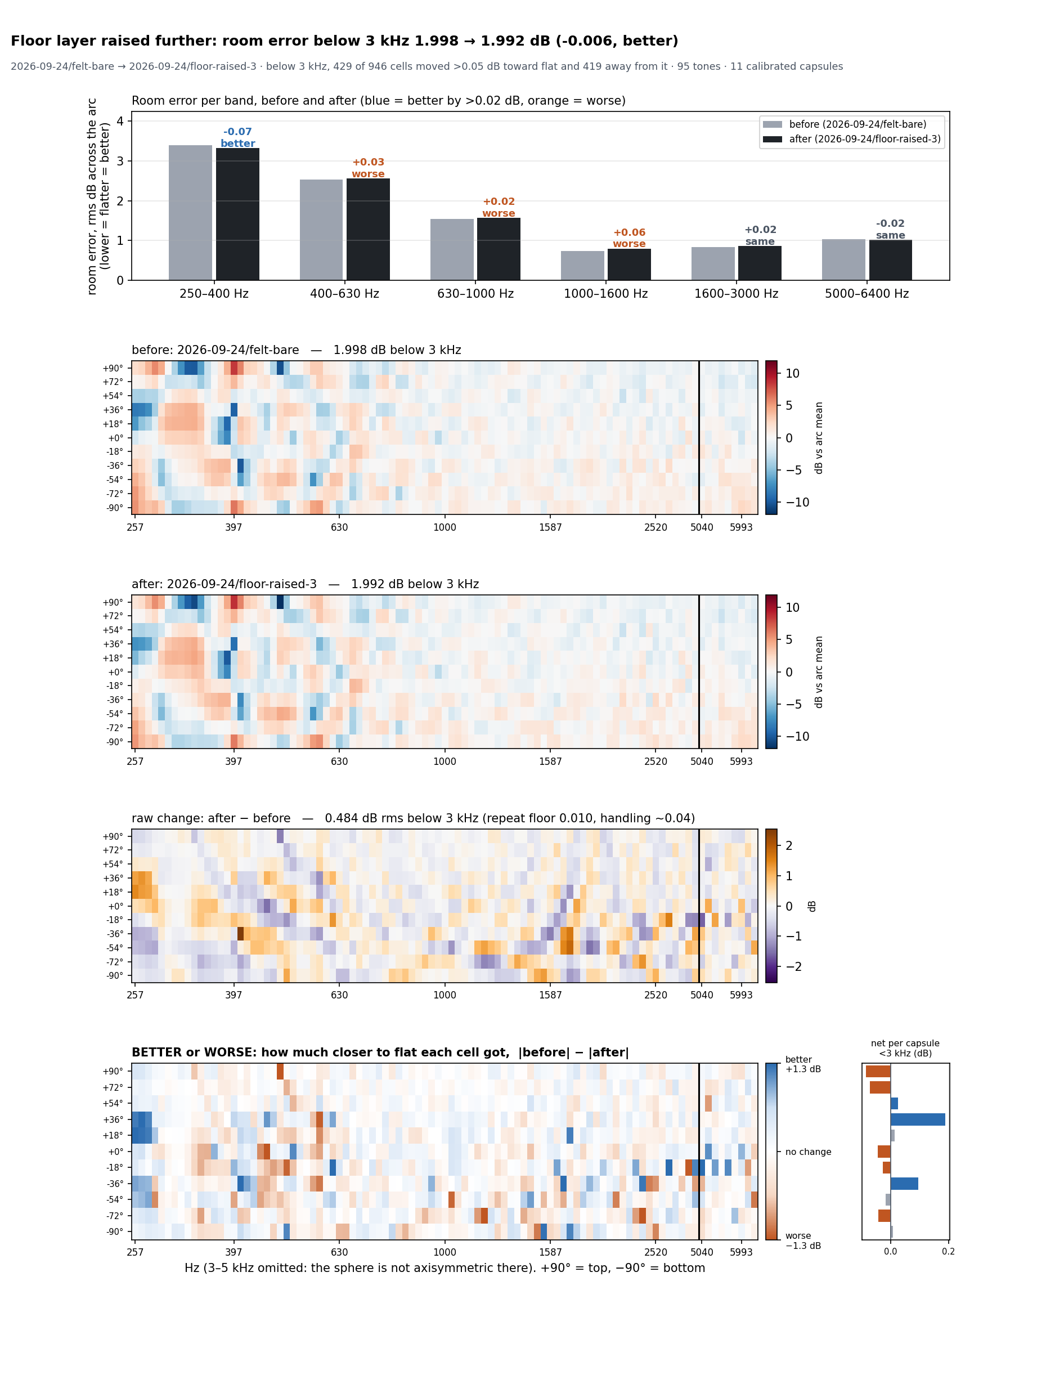
docs/analysis/chamber-treatments-2026-09-23/floor-raised-3-day2.png
