asdfgh0318/SoundVisualizer/docs/analysis/chamber-treatments-2026-09-23/metal-rod-day2.png

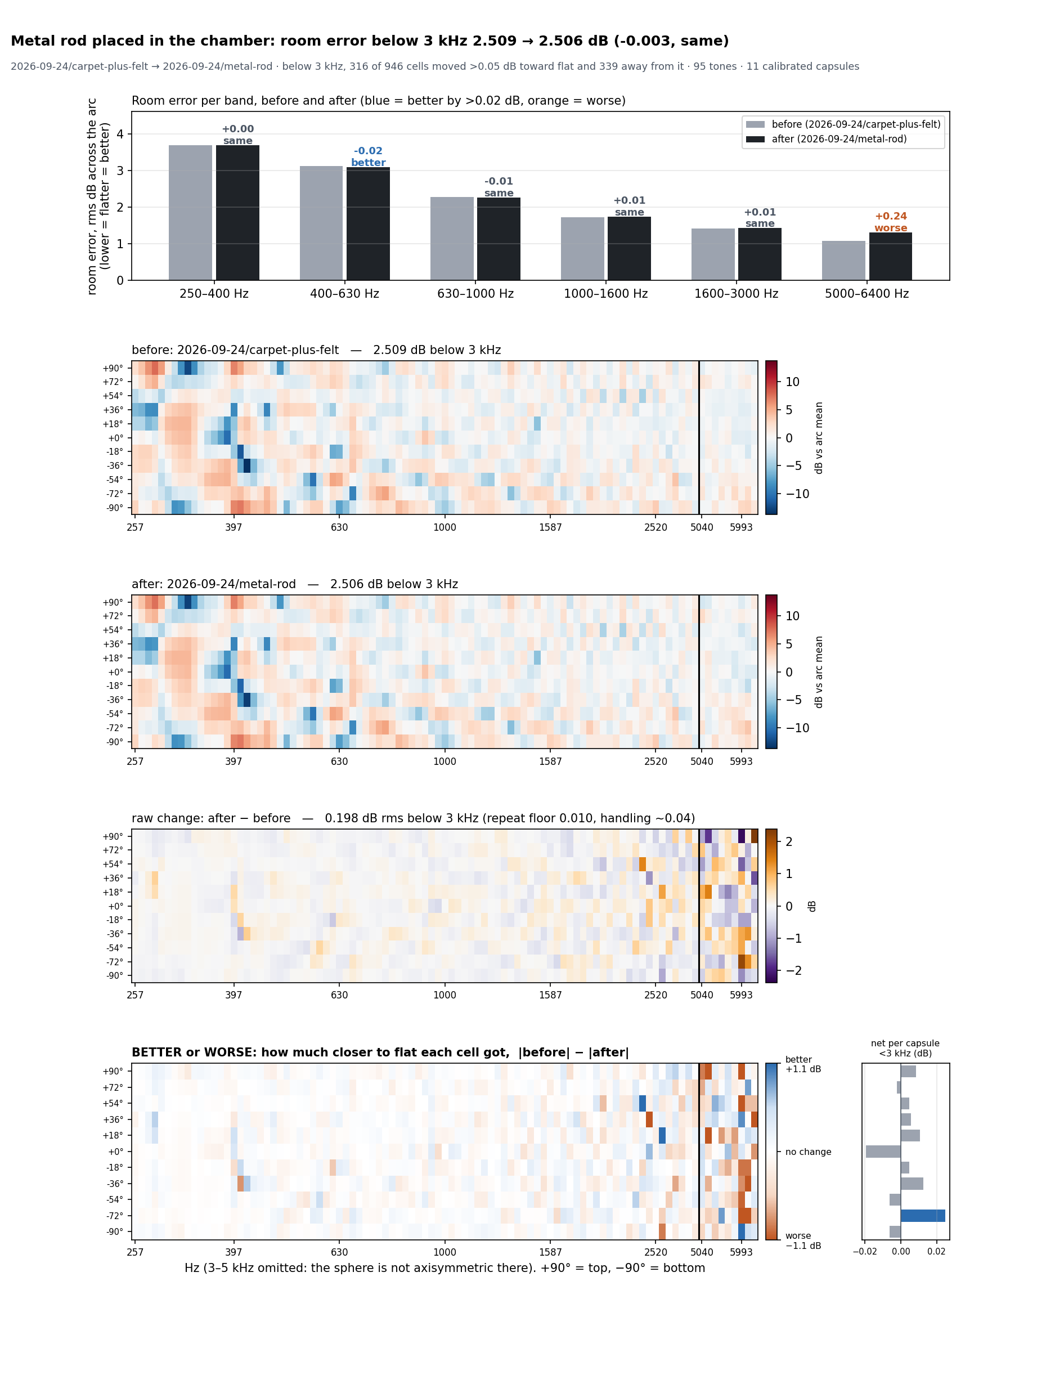
docs/analysis/chamber-treatments-2026-09-23/metal-rod-day2.png
