asdfgh0318/SoundVisualizer/docs/analysis/chamber-treatments-2026-09-23/screen-1-layer-day3.png

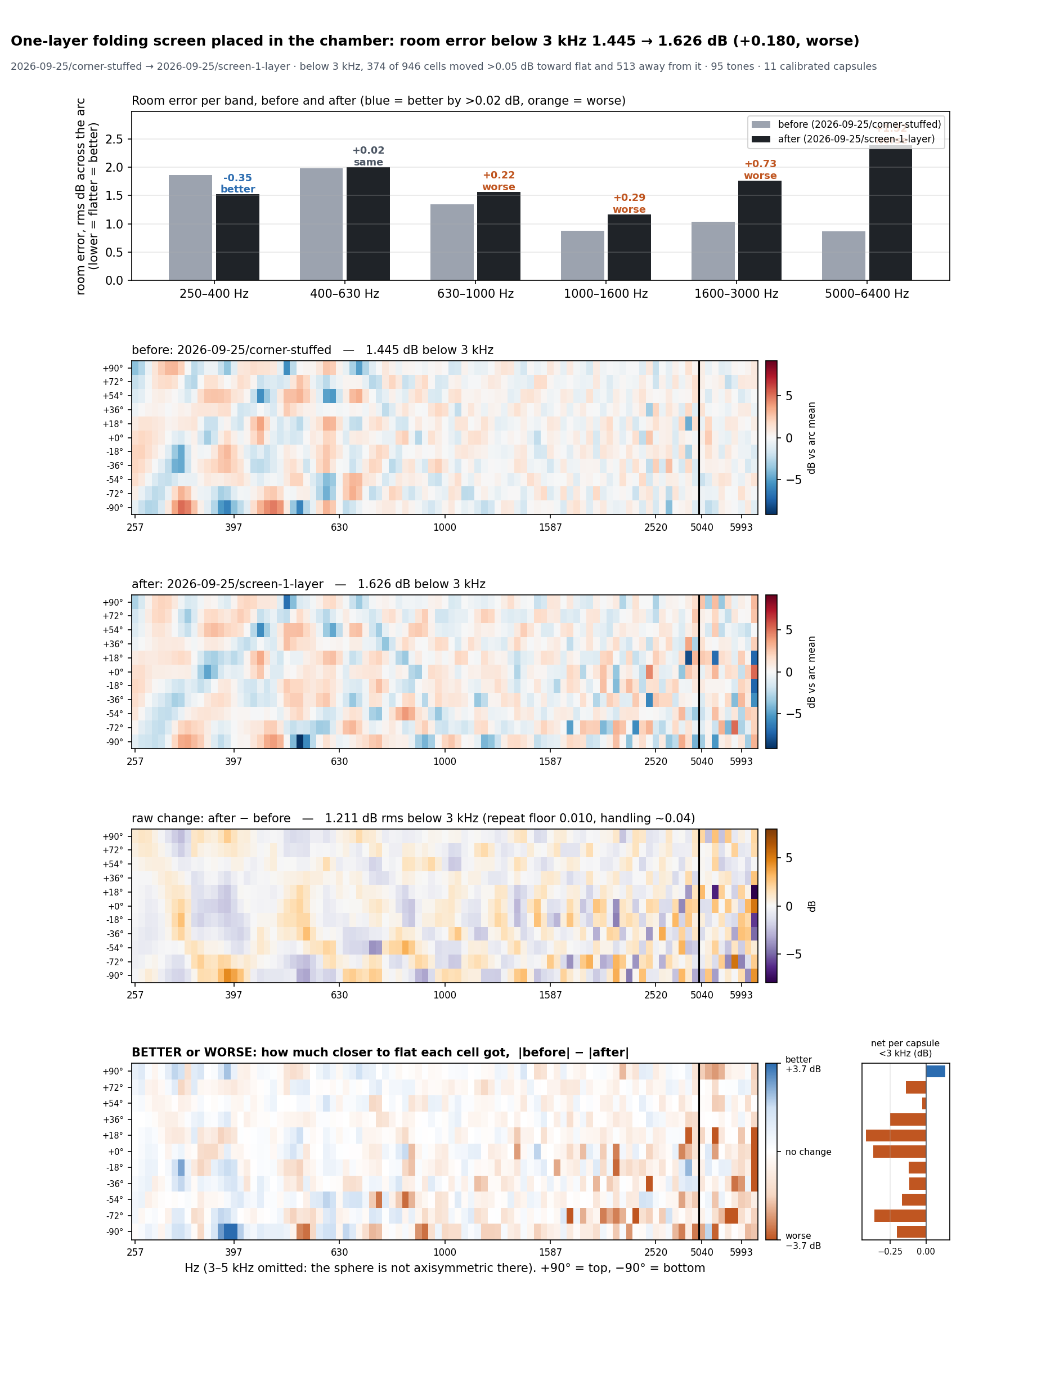
docs/analysis/chamber-treatments-2026-09-23/screen-1-layer-day3.png
