asdfgh0318/SoundVisualizer/docs/analysis/chamber-treatments-2026-09-23/thick-carpet-vs-accepted-day3.png

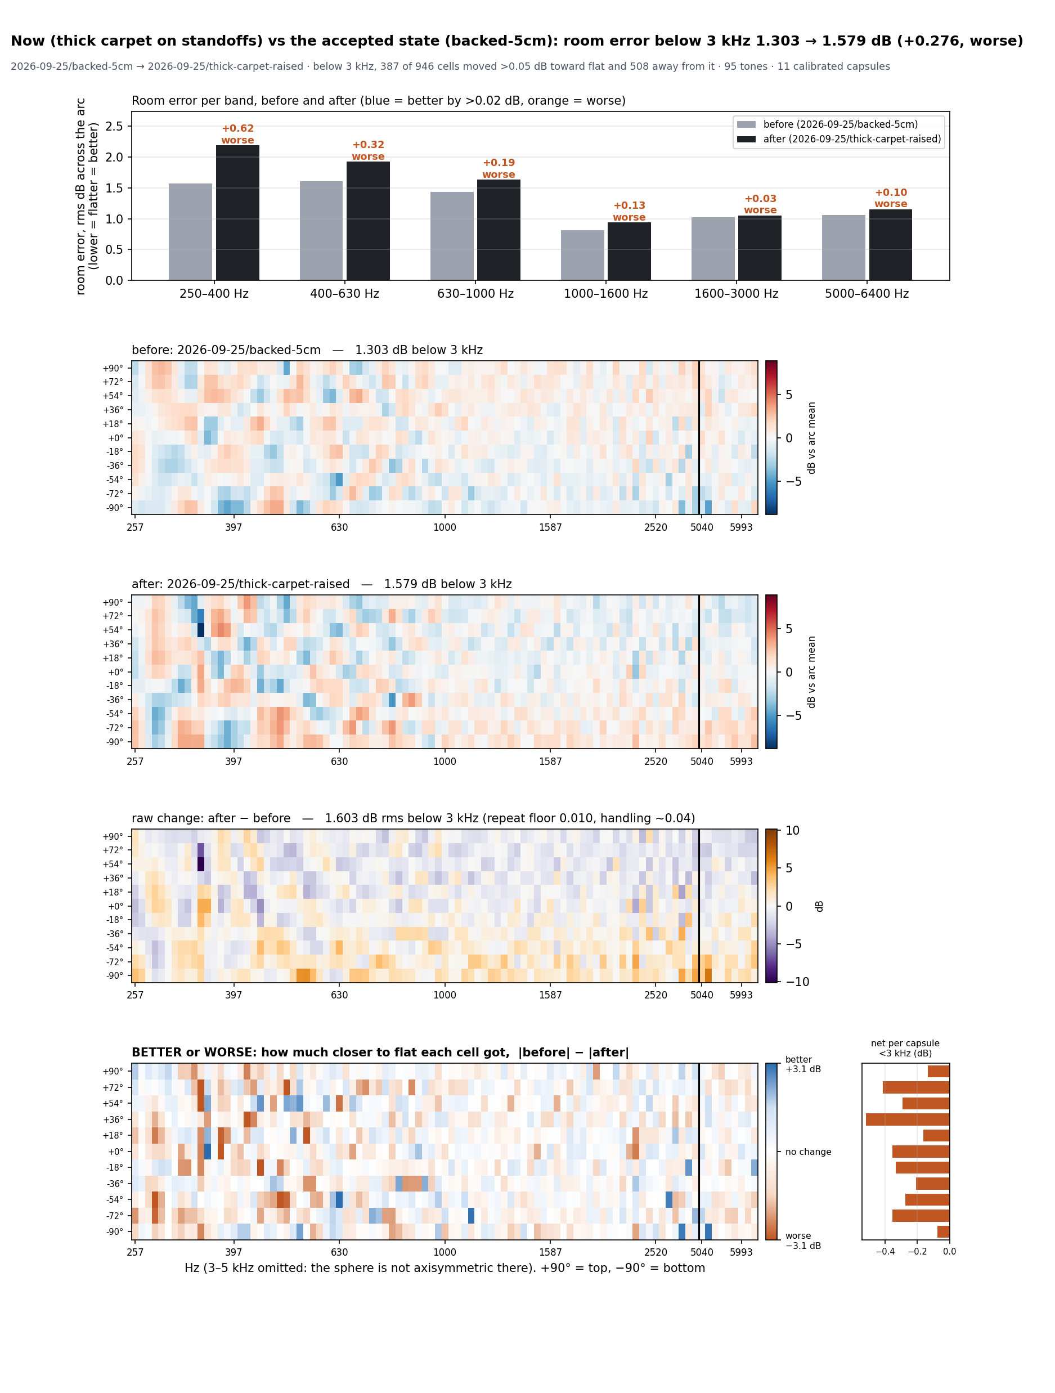
docs/analysis/chamber-treatments-2026-09-23/thick-carpet-vs-accepted-day3.png
