asdfgh0318/SoundVisualizer/docs/analysis/chamber-treatments-2026-09-23/tripod-unwrapped.png

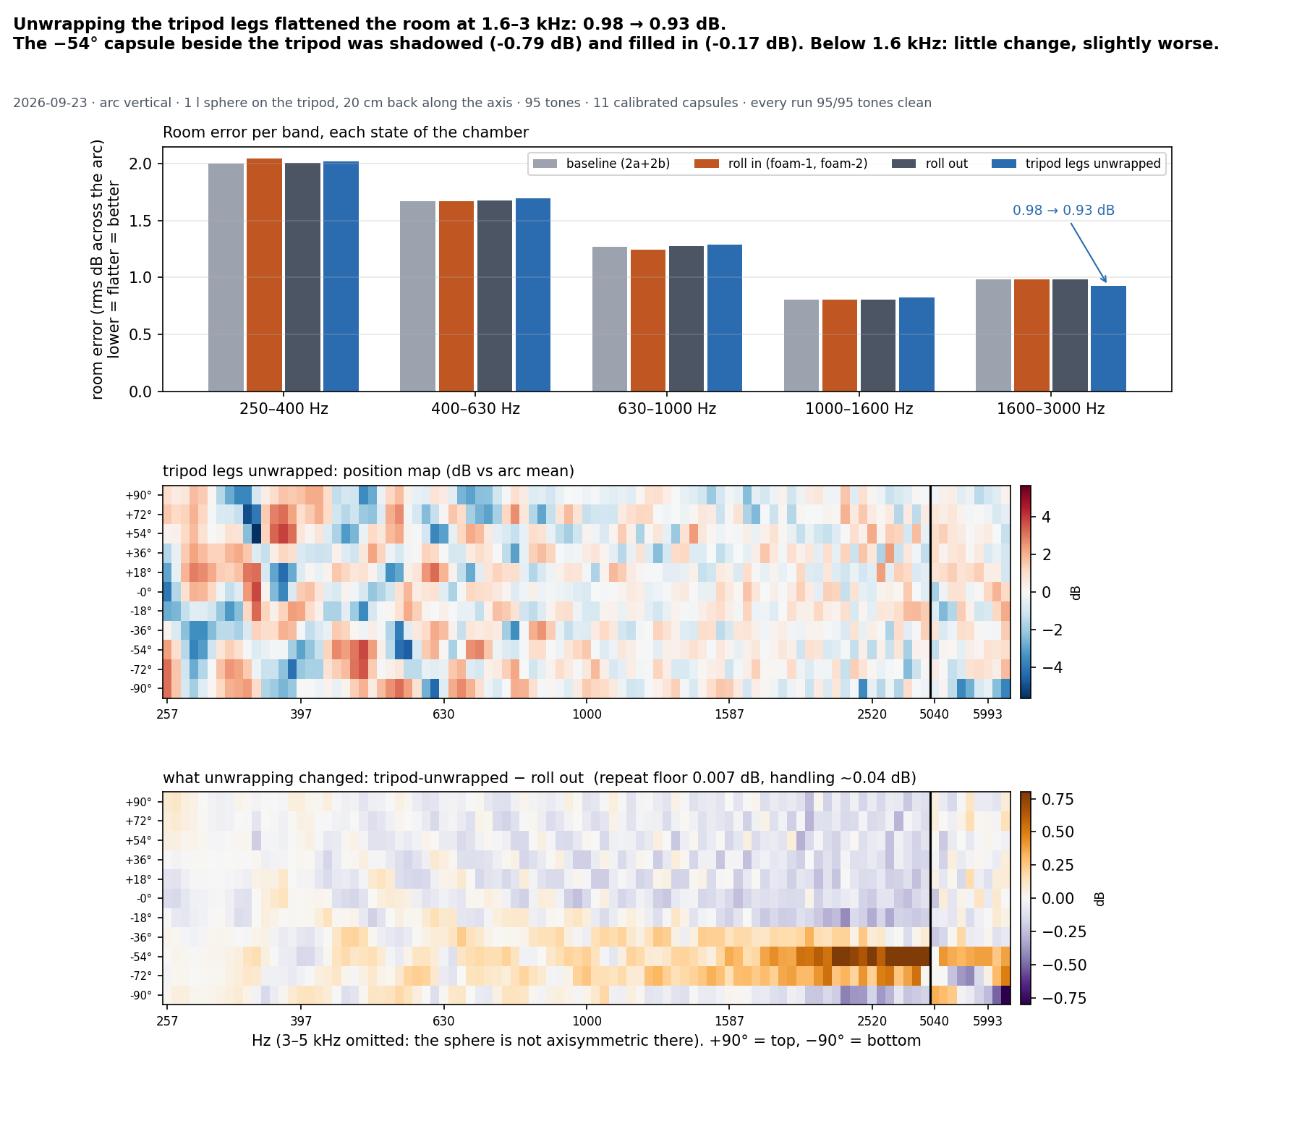
docs/analysis/chamber-treatments-2026-09-23/tripod-unwrapped.png
