asdfgh0318/SoundVisualizer/docs/analysis/chamber-treatments-2026-09-23/worst-vs-final-day3.png

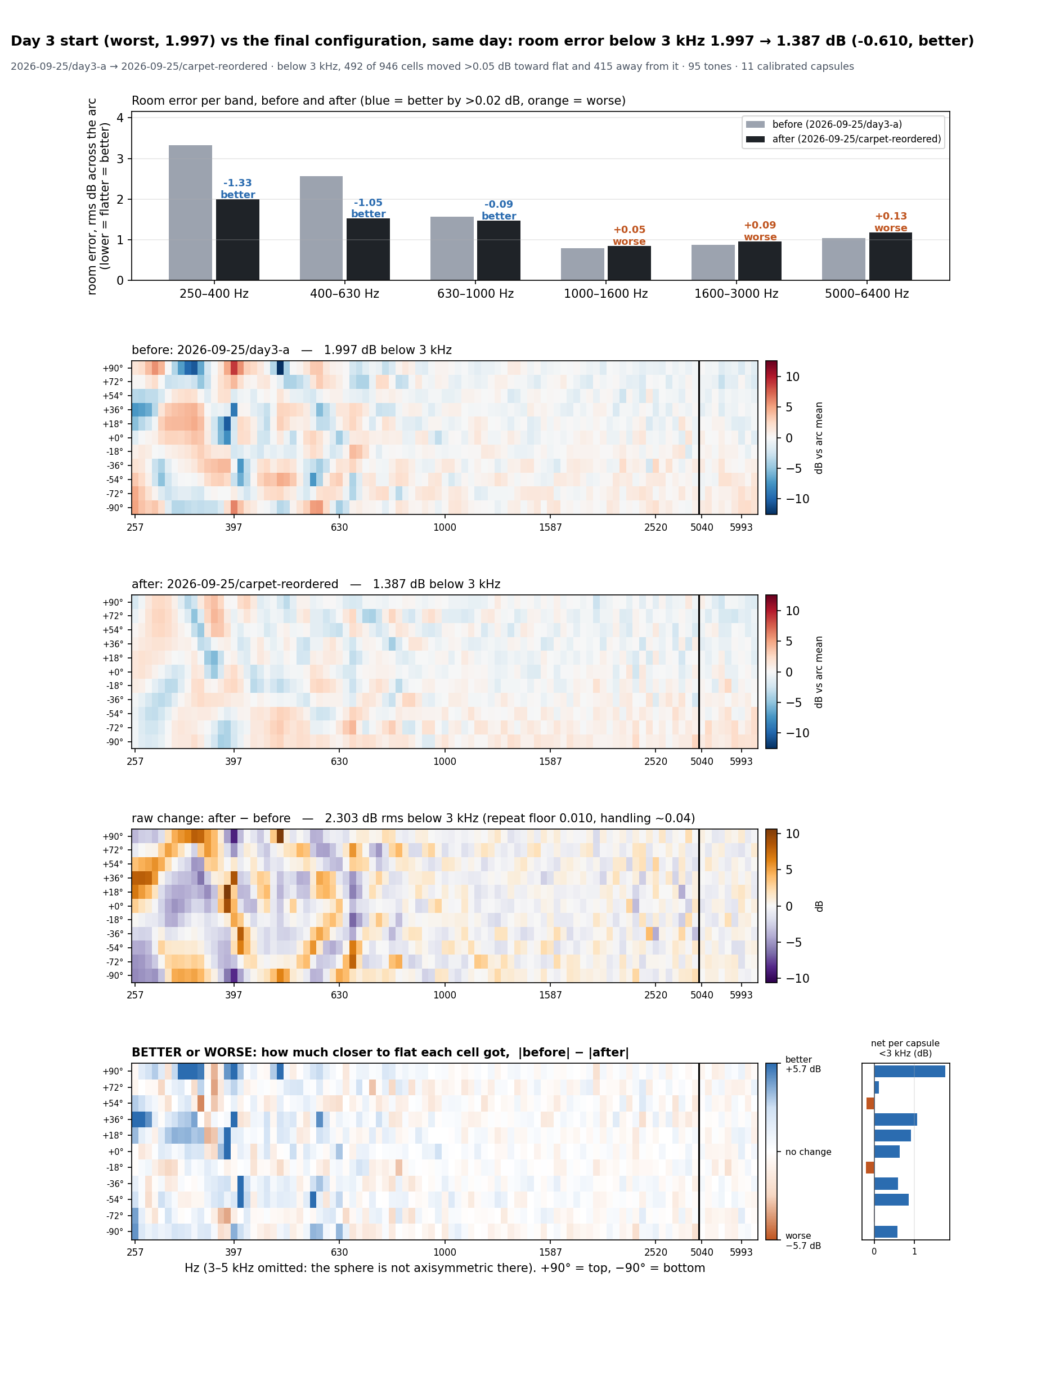
docs/analysis/chamber-treatments-2026-09-23/worst-vs-final-day3.png
