asdfgh0318/SoundVisualizer/docs/analysis/prop18-pwm1900-directivity-by-band.png

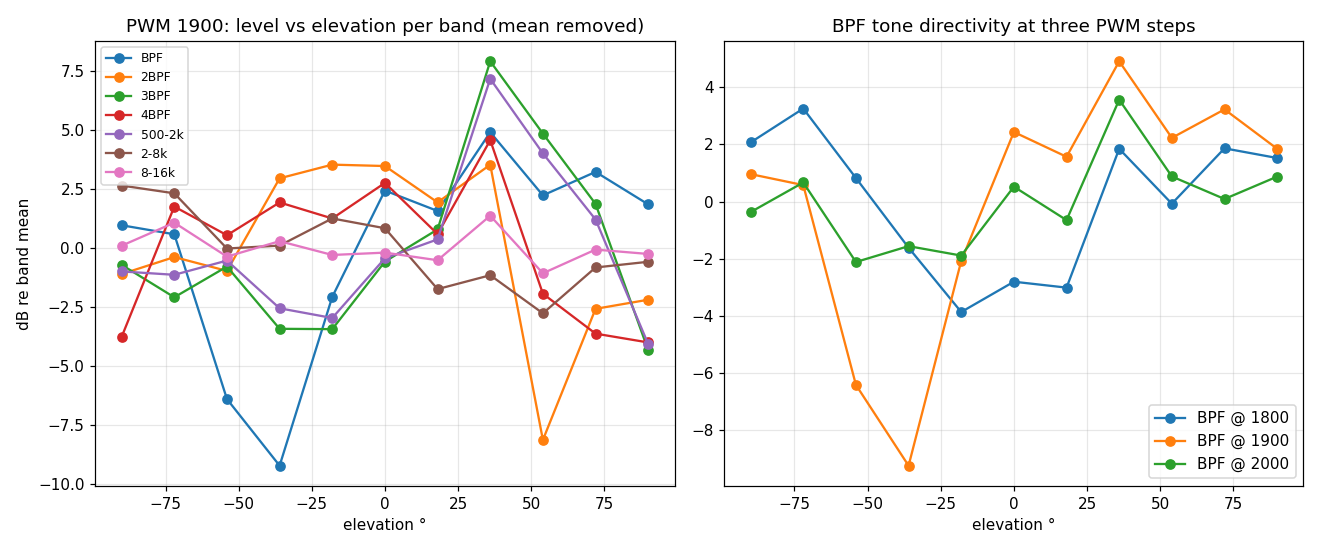
docs/analysis/prop18-pwm1900-directivity-by-band.png
