asdfgh0318/SoundVisualizer/docs/analysis/prop18-pwm1900-floor-ripple.png

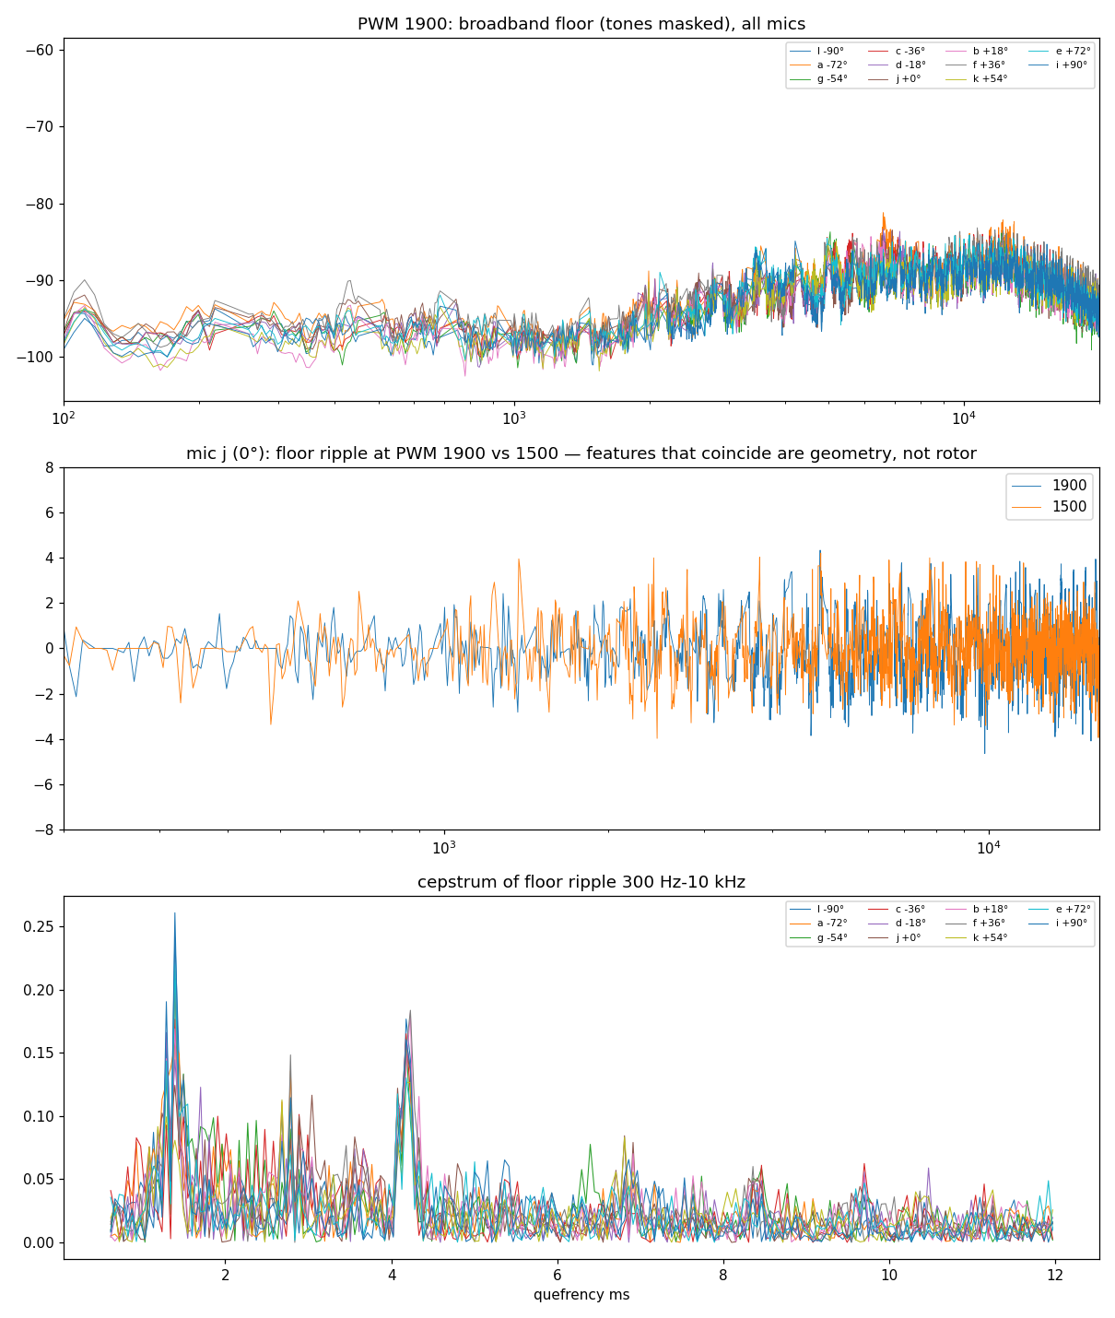
docs/analysis/prop18-pwm1900-floor-ripple.png
