asdfgh0318/SoundVisualizer/docs/analysis/prop18-pwm1900-spectra.png

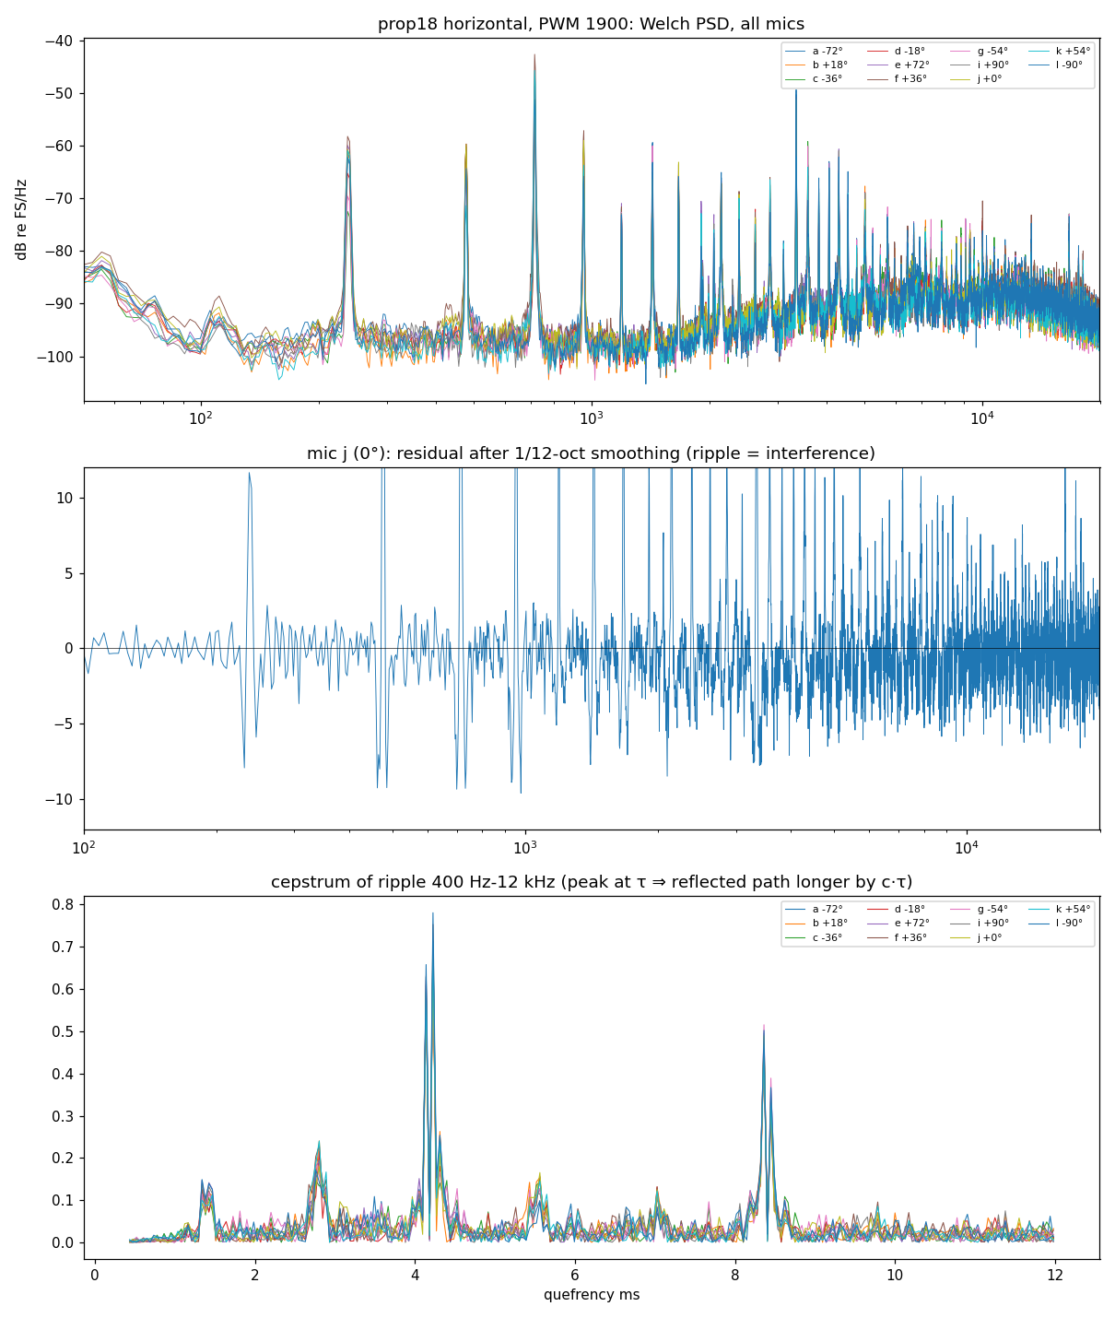
docs/analysis/prop18-pwm1900-spectra.png
