asdfgh0318/SoundVisualizer/docs/analysis/remedies-fig-bpf-tone-vs-broadband.png

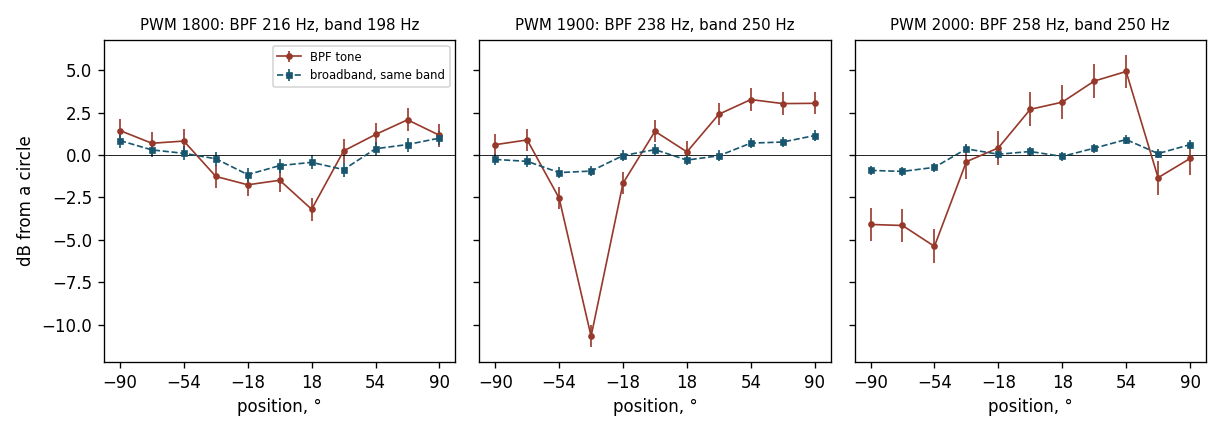
docs/analysis/remedies-fig-bpf-tone-vs-broadband.png
