asdfgh0318/SoundVisualizer/docs/analysis/remedies-fig-cepstrum.png

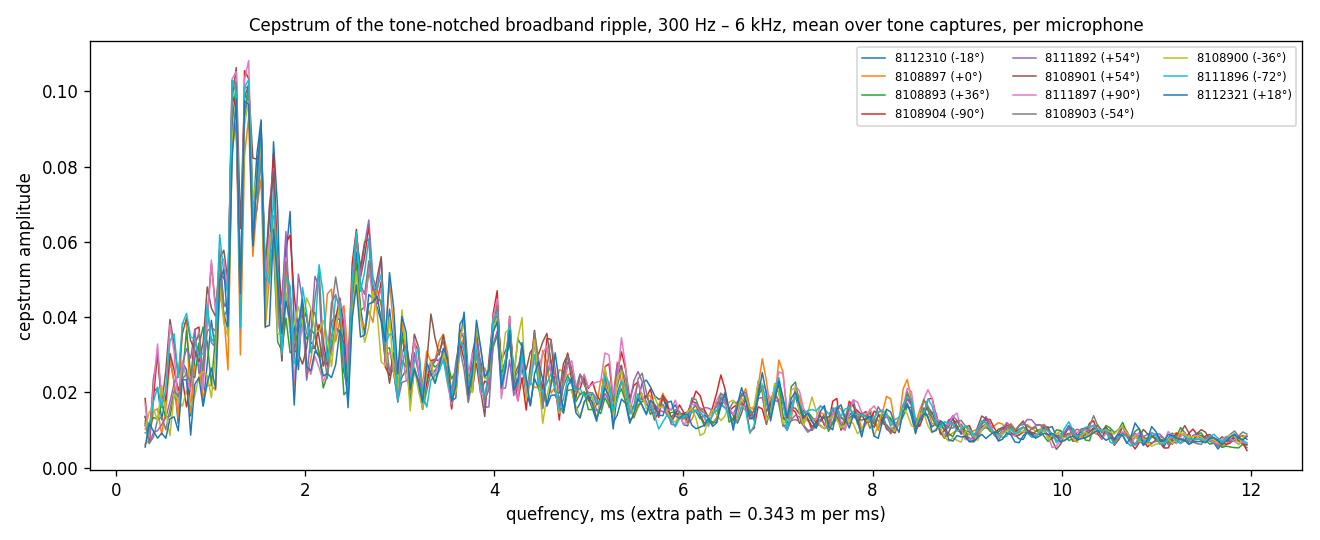
docs/analysis/remedies-fig-cepstrum.png
