asdfgh0318/SoundVisualizer/docs/analysis/remedies-fig-probe-comb.png

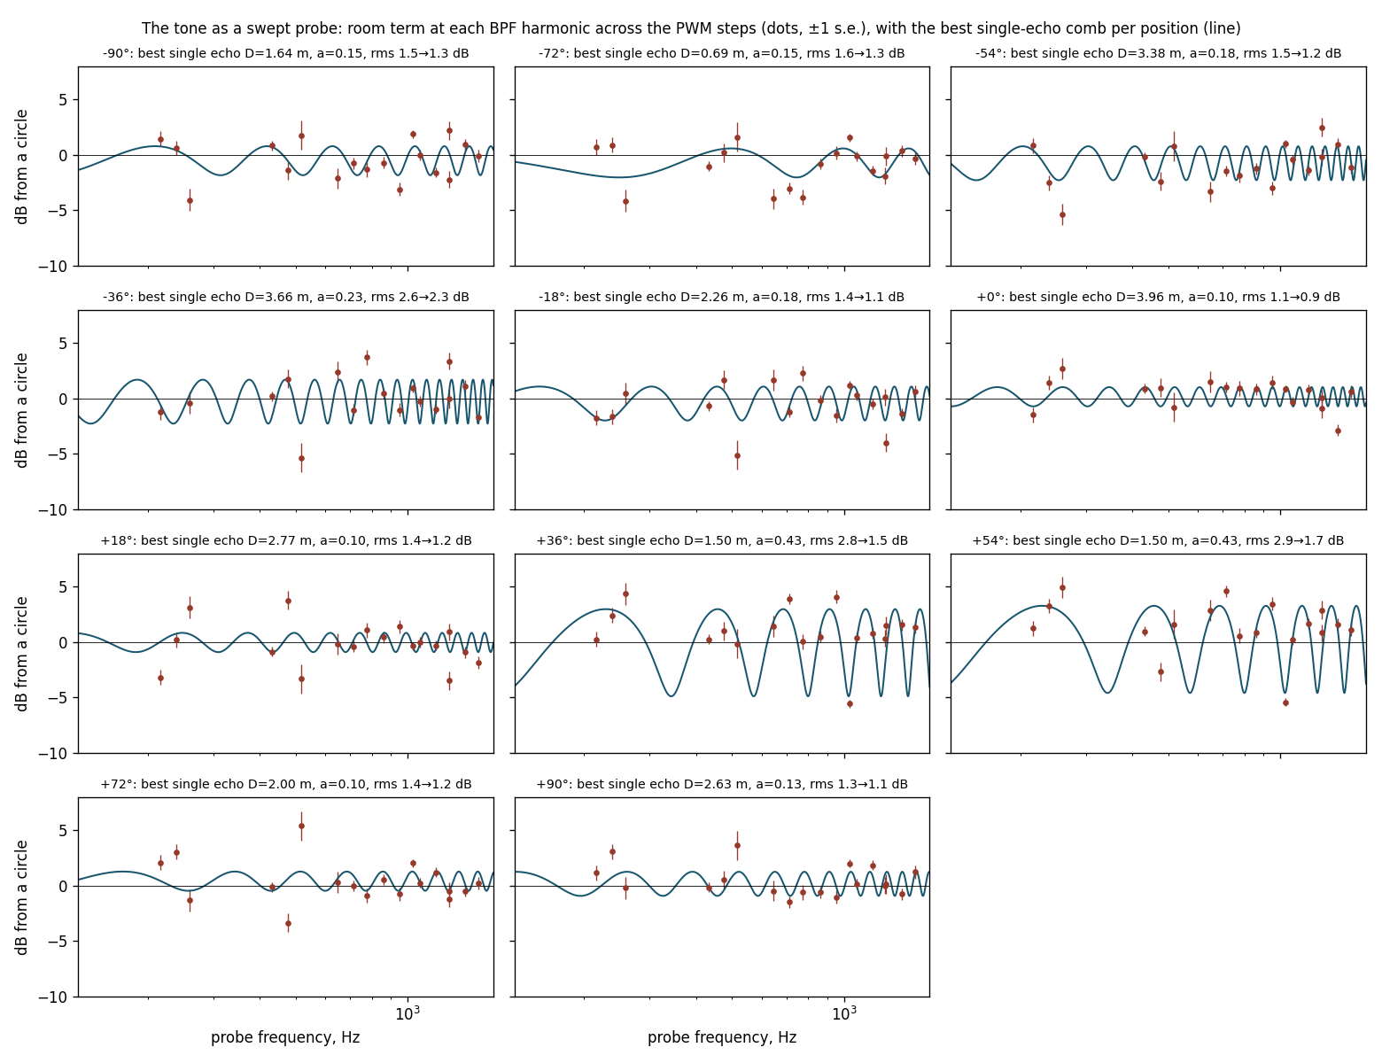
docs/analysis/remedies-fig-probe-comb.png
