asdfgh0318/SoundVisualizer/docs/analysis/remedies-fig-three-speeds.png

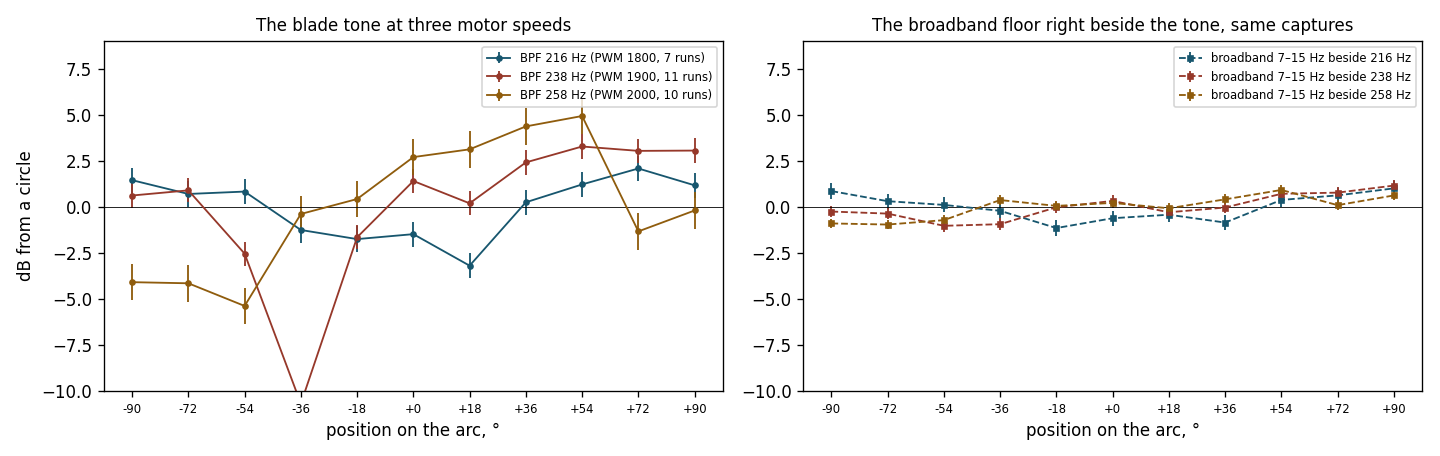
docs/analysis/remedies-fig-three-speeds.png
