asdfgh0318/SoundVisualizer/docs/analysis/remedies-fig-tones-vs-broadband.png

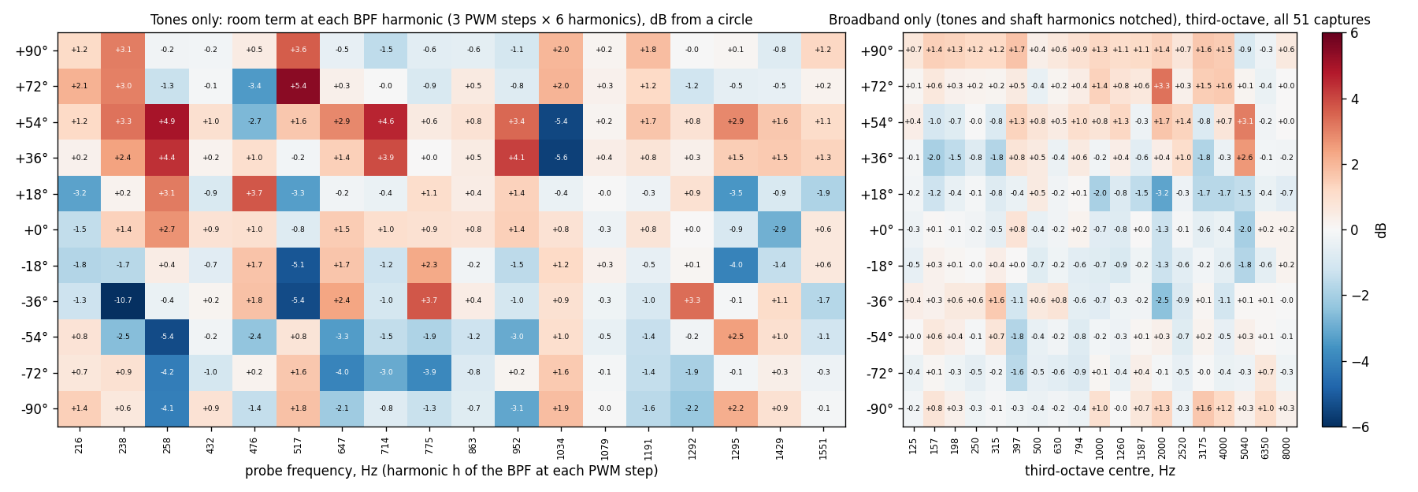
docs/analysis/remedies-fig-tones-vs-broadband.png
