asdfgh0318/SoundVisualizer/docs/figs-onepager-ladder.png

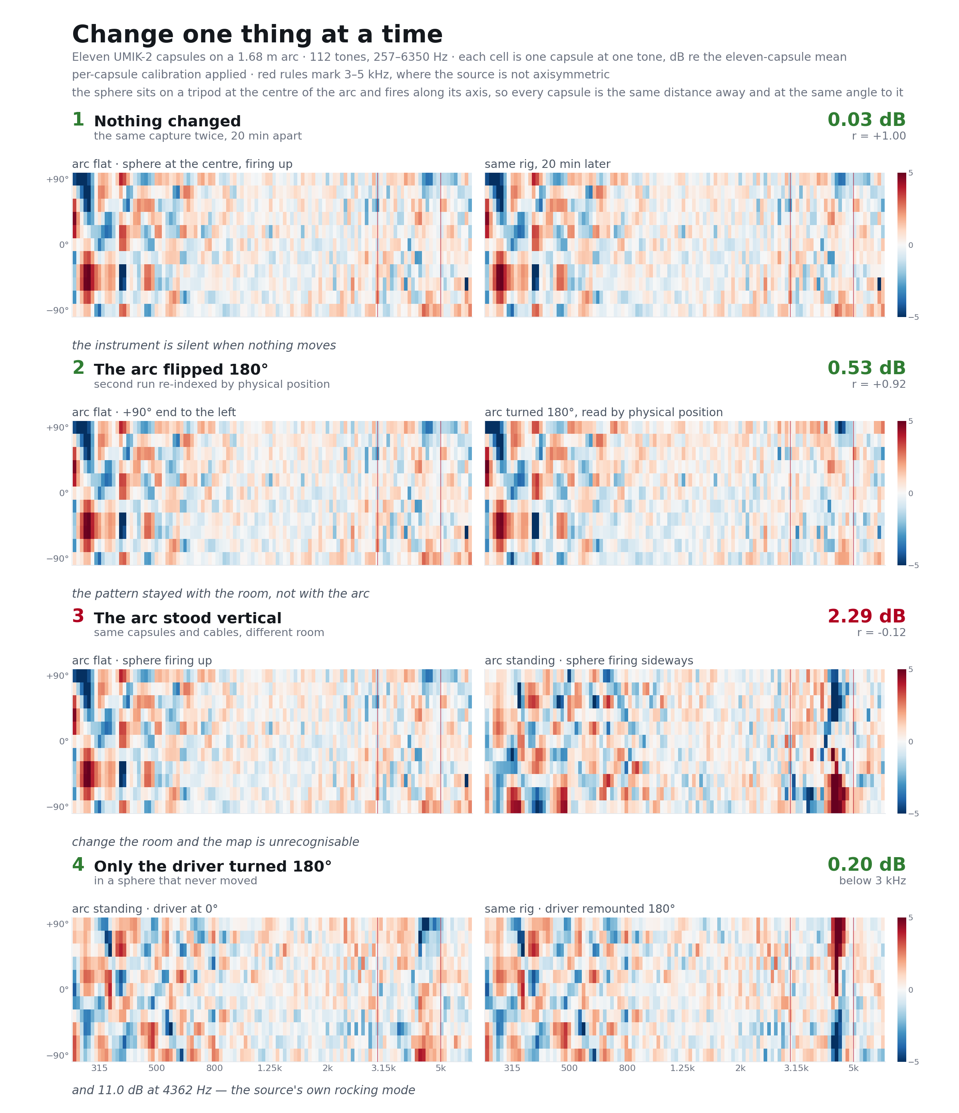
docs/figs-onepager-ladder.png
