asdfgh0318/SoundVisualizer/hardware/duct-8in-axi2217/spider-hub.png

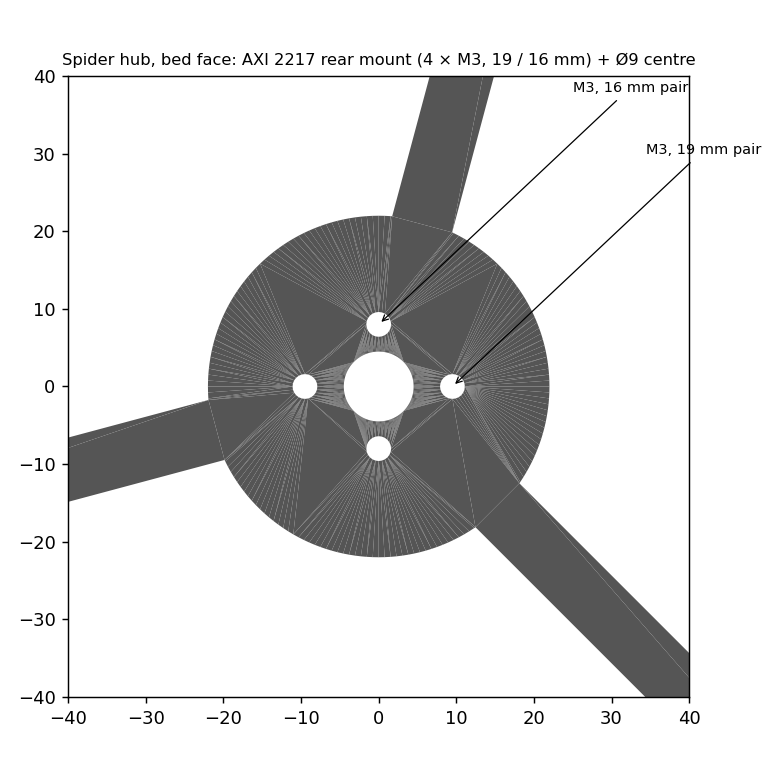
hardware/duct-8in-axi2217/spider-hub.png
