asdfgh0318/SoundVisualizer/hardware/hub-source/driverface.png

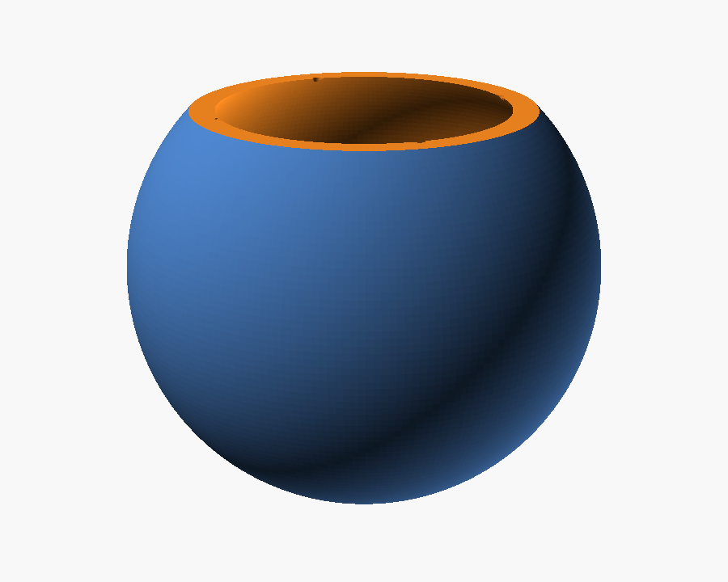
hardware/hub-source/driverface.png
