asdfgh0318/SoundVisualizer/hardware/hub-source/onepiece.png

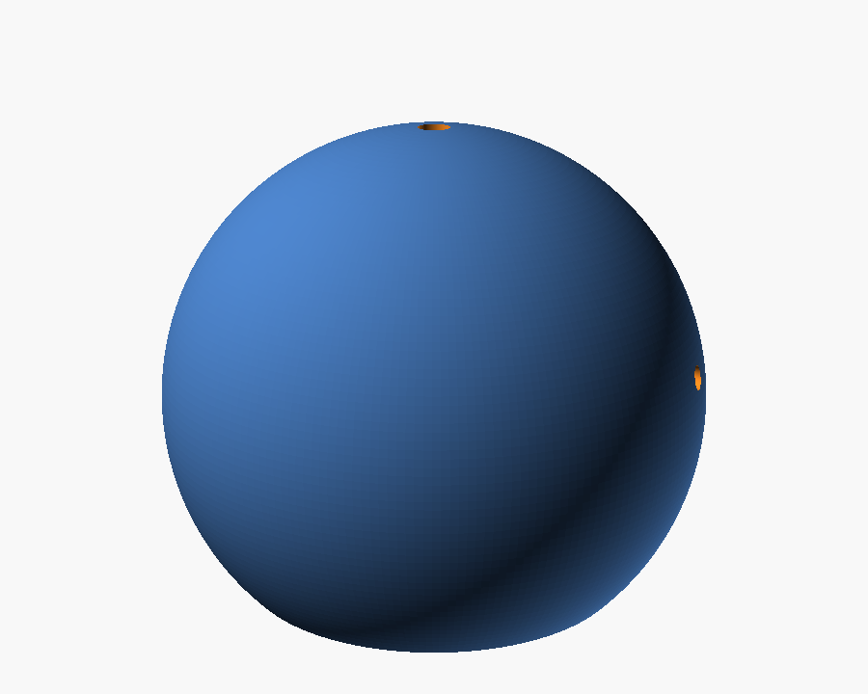
hardware/hub-source/onepiece.png
