asdfgh0318/SoundVisualizer/hardware/hub-source/section.png

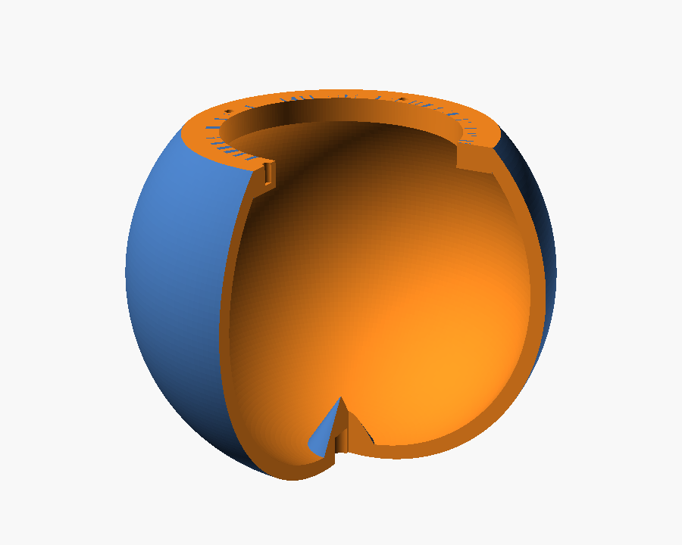
hardware/hub-source/section.png
