asdfgh0318/SoundVisualizer/docs/analysis/chamber-treatments-2026-09-23/material-roll-day3.pdf

250 400 Hz | 400 630 Hz | 630 1000 Hz | 1000 1600 Hz | 1600 3000 Hz | 5000 6400 Hz

0.0

0.5

1.0

1.5

2.0

2.5

room error, rms dB across the arc
(lower = flatter = better)

-0.34
better

+0.14
worse

+0.01
same
-0.10
better

-0.07
better

+0.06
worse

Room error per band, before and after (blue = better by >0.02 dB, orange = worse)

before (2026-09-25/in-plane-a) after (2026-09-25/material-roll)

257 | 397 | 630 | 1000 | 1587 | 2520 | 5040 5993

+90°
+72°
+54°
+36°
+18°
+0°
-18°
-36°
-54°
-72°
-90°

before: 2026-09-25/in-plane-a 1.472 dB below 3 kHz

5

0

5
dB vs arc mean
257 | 397 | 630 | 1000 | 1587 | 2520 | 5040 5993

+90°
+72°
+54°
+36°
+18°
+0°
-18°
-36°
-54°
-72°
-90°

after: 2026-09-25/material-roll 1.403 dB below 3 kHz

5

0

5
dB vs arc mean
257 | 397 | 630 | 1000 | 1587 | 2520 | 5040 5993

+90°
+72°
+54°
+36°
+18°
+0°
-18°
-36°
-54°
-72°
-90°

raw change: after before 0.676 dB rms below 3 kHz (repeat floor 0.010, handling ~0.04)

2

1

0

1

2

dB

257 | 397 | 630 | 1000 | 1587 | 2520 | 5040 5993
Hz (3 5 kHz omitted: the sphere is not axisymmetric there). +90° = top, 90° = bottom

+90°
+72°
+54°
+36°
+18°
+0°
-18°
-36°
-54°
-72°
-90°

BETTER or WORSE: how much closer to flat each cell got, |before| |after|

worse
1.8 dB

no change

better
+1.8 dB
0.0 | 0.1 | 0.2

net per capsule
<3 kHz (dB)

Roll of material on the wall the speaker fires toward (instead of the curtain): room error below 3 kHz 1.472 1.403 dB (-0.069, better)

2026-09-25/in-plane-a 2026-09-25/material-roll · below 3 kHz, 465 of 946 cells moved >0.05 dB toward flat and 395 away from it · 95 tones · 11 calibrated capsules
