asdfgh0318/SoundVisualizer/docs/analysis/chamber-treatments-2026-09-23/material-roll-day3.png

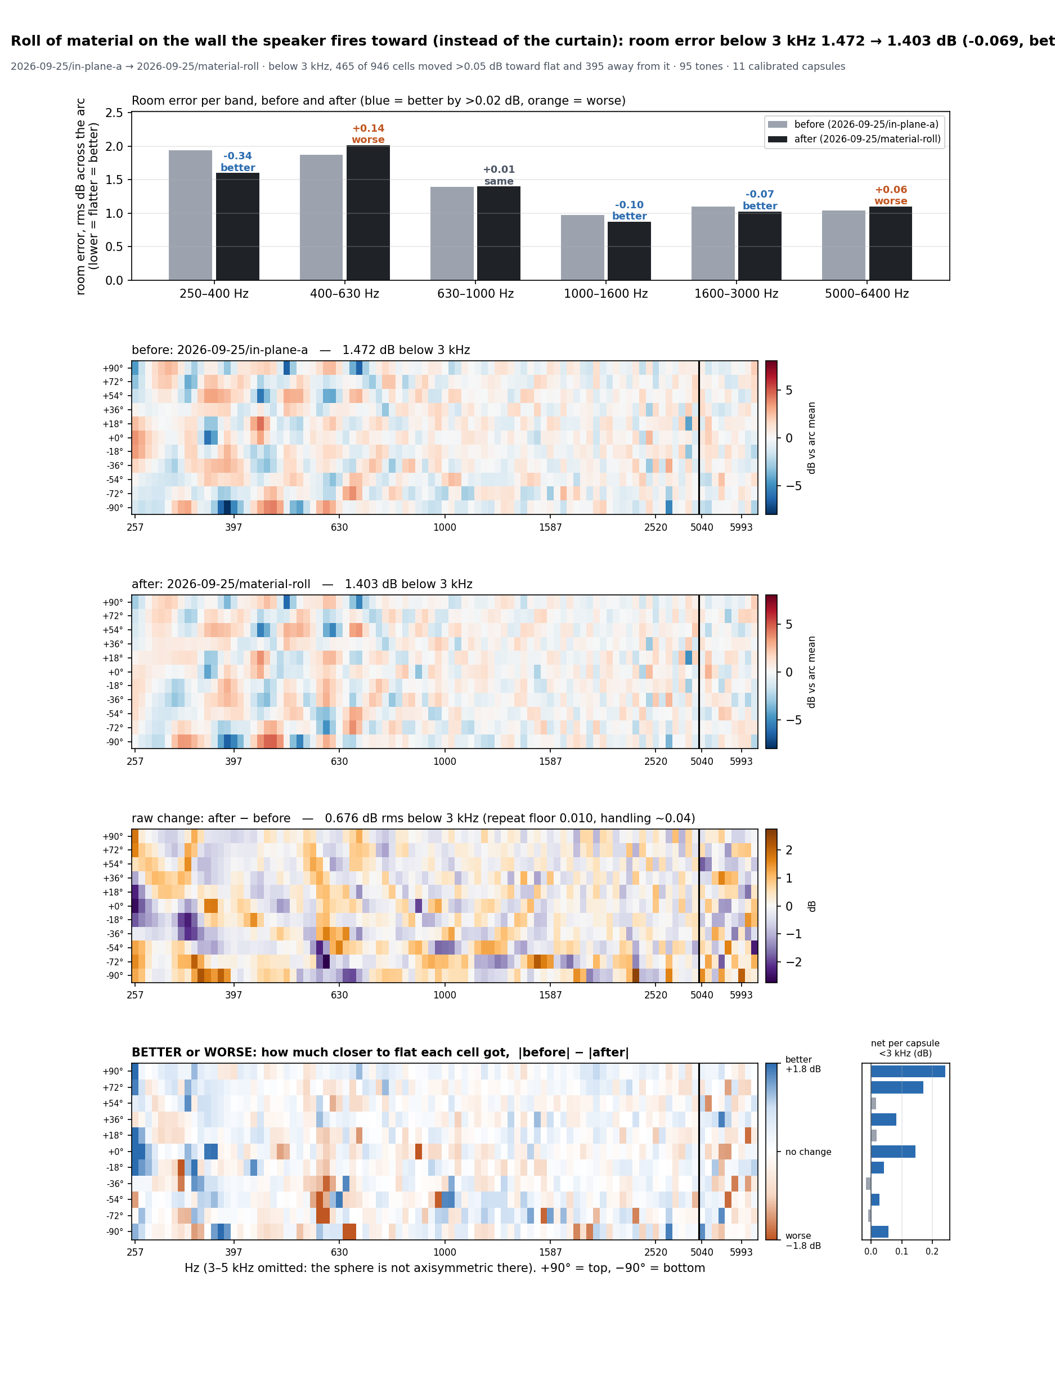
docs/analysis/chamber-treatments-2026-09-23/material-roll-day3.png
