asdfgh0318/SoundVisualizer/hardware/duct-8in-axi2217/assembly.png

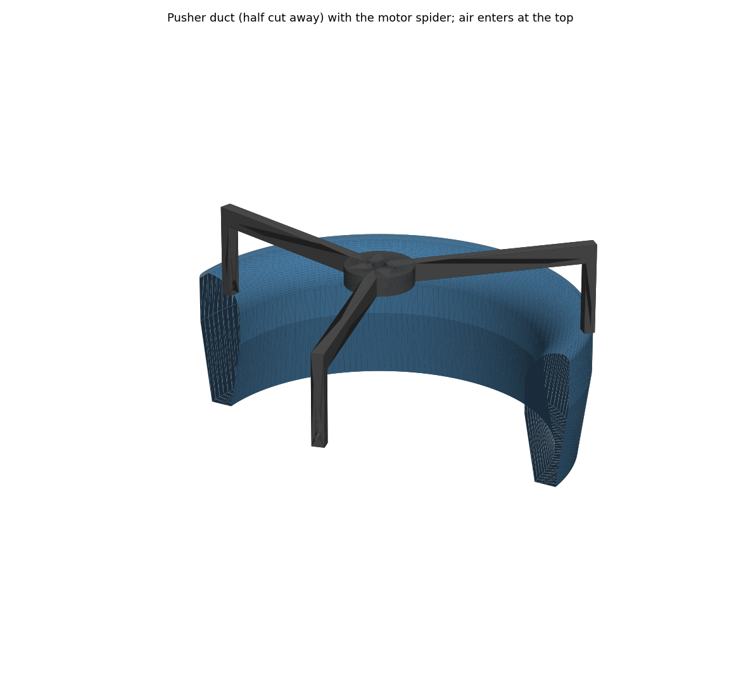
hardware/duct-8in-axi2217/assembly.png
