asdfgh0318/SoundVisualizer/docs/rotation-test-prop14-vs-prop15.png

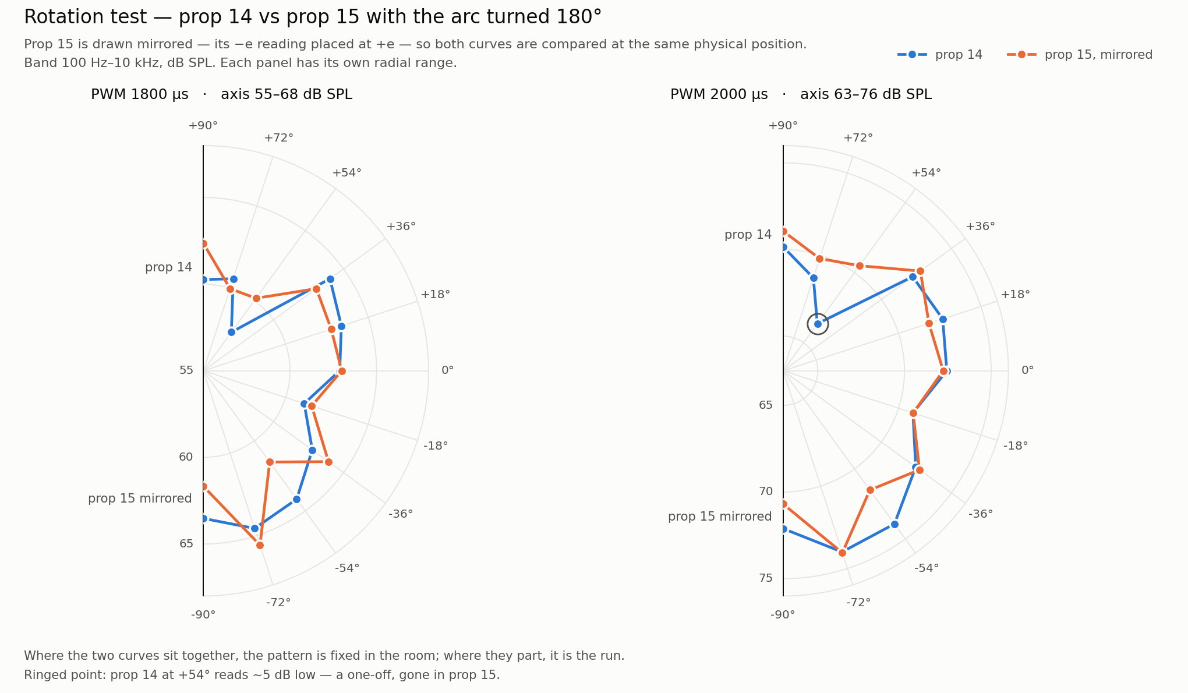
docs/rotation-test-prop14-vs-prop15.png
