asdfgh0318/SoundVisualizer/server/api/schemas.py

from datetime import datetime
from enum import StrEnum
from typing import Annotated, Literal

from pydantic import BaseModel, Field, computed_field

from server.store.paths import key_slug


class Key(BaseModel):
    motor: str
    propeller: str
    shroud: str
    notes: str

    @computed_field  # type: ignore[prop-decorator]
    @property
    def slug(self) -> str:
        return key_slug(self.motor, self.propeller, self.shroud, self.notes)


class KeyListing(Key):
    """A base as the pickers list it: the key plus the span of its captures, so two bases of
    the same material can be told apart by date. Not written to key.json."""

    first_measured_at: datetime | None = None
    last_measured_at: datetime | None = None


class MeasurementHalf(StrEnum):
    """Which half-config the mics were in during this capture.

    `FULL` is the default for single-pass rigs where mics simultaneously span
    the entire arc. `TOP` / `BOTTOM` remain for two-pass rigs that physically
    remount mics between halves — both old data and any future two-pass client
    still parse and merge correctly.
    """

    TOP = "top"
    BOTTOM = "bottom"
    FULL = "full"


class _BaseMeasurementMeta(BaseModel):
    id: str = ""
    t_start: datetime
    t_end: datetime
    pwm_setpoint: int | None = None
    # Which pass of a repeated ramp this belongs to (1-based). Captures from before
    # repeats existed have no field and read as 1.
    repeat: int = Field(default=1, ge=1)


class AcousticMeasurementMeta(_BaseMeasurementMeta):
    type: Literal["acoustic"] = "acoustic"
    mic_serial: str
    elevation_deg: float
    azimuth_deg: float | None = None
    half: MeasurementHalf
    sample_rate: int = 48000
    calibration_file_id: str | None = None
    # Blade-passage frequency read from the audio at capture time (no RPM channel
    # on the stand). None = no tone found (motor idle, or a pre-2026-09 capture).
    bpf_hz: float | None = None


class PerformanceMeasurementMeta(_BaseMeasurementMeta):
    type: Literal["performance"] = "performance"


class NorsonicMeasurementMeta(_BaseMeasurementMeta):
    type: Literal["norsonic"] = "norsonic"


MeasurementMeta = Annotated[
    AcousticMeasurementMeta | PerformanceMeasurementMeta | NorsonicMeasurementMeta,
    Field(discriminator="type"),
]


class CutoffChannel(BaseModel):
    enabled: bool = False
    threshold: float = 0.0
    # "above" trips when measured value > threshold (overcurrent, overheat, overrev).
    # "below" trips when measured value < threshold (undervoltage / battery sag).
    direction: Literal["above", "below"] = "above"


class CutoffTriggers(BaseModel):
    current: CutoffChannel = CutoffChannel()
    voltage: CutoffChannel = CutoffChannel(direction="below")
    rpm: CutoffChannel = CutoffChannel()
    thrust: CutoffChannel = CutoffChannel()
    torque: CutoffChannel = CutoffChannel()
    temp0: CutoffChannel = CutoffChannel()
    temp1: CutoffChannel = CutoffChannel()
    temp2: CutoffChannel = CutoffChannel()


class PWMStep(BaseModel):
    pwm_us: int = Field(ge=1000, le=2000)
    recording_ms: int = Field(ge=100, le=60_000)


class KeyFields(BaseModel):
    motor: str
    propeller: str
    shroud: str
    notes: str


class CaptureRunPhase(StrEnum):
    IDLE = "idle"
    STARTING = "starting"
    TARING = "taring"
    SETTING_PWM = "setting_pwm"
    STABILIZING = "stabilizing"
    RECORDING = "recording"
    WRITING = "writing"
    REPEAT_GAP = "repeat_gap"
    SPOOLING_DOWN = "spooling_down"
    COMPLETED = "completed"
    FAILED = "failed"
    ABORTED = "aborted"


class CaptureRunStatus(BaseModel):
    run_id: str
    state: Literal["idle", "running", "completed", "failed", "aborted"] = "idle"
    phase: CaptureRunPhase = CaptureRunPhase.IDLE
    half: MeasurementHalf | None = None
    key_slug: str | None = None
    current_step: int = 0
    total_steps: int = 0
    current_repeat: int = 0
    total_repeats: int = 1
    current_pwm_us: int | None = None
    measurement_ids: list[str] = []
    error: str | None = None


class MicPresetEntry(BaseModel):
    """Portable mic config — no USB device index since that shifts per machine/boot.

    Single-pass rigs use `elevation_deg`. The legacy `top_elevation_deg` /
    `bottom_elevation_deg` fields stay readable so old presets round-trip; the
    frontend folds whichever was set into `elevation_deg` on load.
    """

    serial: str
    elevation_deg: float | None = None
    top_elevation_deg: float | None = None
    bottom_elevation_deg: float | None = None
    calibration_file_id: str | None = None
    # Stable ALSA card id (udev port-path, e.g. "umik_3_1_4_1"). Lets a preset
    # restore the physical mic→device binding too — valid as long as mics stay
    # in the same hub ports. Ignored gracefully if it doesn't match on load.
    alsa_card_id: str | None = None


class SetupPreset(BaseModel):
    id: str
    name: str
    created_at: datetime
    mics: list[MicPresetEntry]


class CompatTolerance(BaseModel):
    """Tolerance for a single performance channel. Two values are considered
    compatible if `|a - b| <= max(abs, rel * mean(|a|, |b|))`."""

    abs: float = Field(ge=0.0)
    rel: float = Field(ge=0.0, le=1.0)


class CompatibilityTolerances(BaseModel):
    thrust_n: CompatTolerance = CompatTolerance(abs=0.5, rel=0.05)
    torque_nm: CompatTolerance = CompatTolerance(abs=0.05, rel=0.10)
    current_a: CompatTolerance = CompatTolerance(abs=0.5, rel=0.05)
    voltage_v: CompatTolerance = CompatTolerance(abs=0.3, rel=0.0)
    rpm_mean: CompatTolerance = CompatTolerance(abs=100.0, rel=0.02)
