asdfgh0318/SoundVisualizer/server/tests/test_capture_orchestrator.py

"""Orchestrator tests with a fully faked stand + mic capture (no hardware).

The orchestrator is glue code; we exercise its state machine, error handling,
and persistence rather than the actual capture/PWM control."""

import asyncio
import time
from typing import Any

import numpy as np
import pytest

from server.api.schemas import (
    CaptureRunPhase,
    CutoffTriggers,
    KeyFields,
    MeasurementHalf,
    PWMStep,
)
from server.core.calibration_override import apply_calibration_config
from server.core.capture_orchestrator import (
    REPEAT_IDLE_PWM_US,
    CaptureOrchestrator,
    CaptureRunRequest,
    MicSpecRun,
    TriggerSyncRun,
)
from server.core.config import TytoCalibrationConfig
from server.core.cutoff_watchdog import CutoffWatchdog
from server.core.thrust_stand_service import TareOffsets
from server.vendor.pawel.msp import PollResponse


def _make_poll(**ovr: Any) -> PollResponse:
    d = dict(
        esc_voltage=16.0, esc_current=5.0, esc_power=80.0,
        load_thrust=0.0, load_left=0.0, load_right=0.0,
        rot_e=10000.0, rot_o=10000.0,
        temp0=30.0, temp1=30.0, temp2=30.0,
        basic_data_flag=b"\x00", acc_x=0, acc_y=0, acc_z=0,
        vibration=0, raw_pressure_p=0, raw_pressure_t=0,
        pro_data_flag=b"\x00",
    )
    d.update(ovr)
    return PollResponse(**d)


class FakeStand:
    def __init__(self):
        self.mot_pwm = 1000
        self.samples_raw: list[PollResponse] = [_make_poll() for _ in range(20)]
        self.sample_number = len(self.samples_raw)

    async def stabilize_rpm(self, _window: int, _tolerance: float) -> None:
        # immediate return — pretend stable
        await asyncio.sleep(0)

    def start_meas_series(self):
        from server.vendor.pawel.thrust_stand import PendingMeasurementSeries
        return PendingMeasurementSeries(self.sample_number)

    def finish_meas_series(self, p):
        return list(self.samples_raw[-3:])  # 3 samples in the window


class FakeService:
    def __init__(self):
        self.stand = FakeStand()
        self.watchdog = CutoffWatchdog(self.stand, CutoffTriggers())
        self.tare = TareOffsets()
        self.connected = True
        self.link_error: str | None = None
        self.zero_calls: list[int] = []  # records PWM at the moment zero() is called
        self.pwm_log: list[tuple[float, int]] = []

    def set_pwm(self, pwm_us: int) -> None:
        if self.watchdog.tripped:
            raise RuntimeError(f"watchdog tripped on {self.watchdog.tripped}")
        self.stand.mot_pwm = pwm_us
        self.pwm_log.append((time.monotonic(), pwm_us))

    def zero(self, n: int = 30) -> TareOffsets:
        if self.stand.mot_pwm != 1000:
            raise RuntimeError("zero only at idle (pwm 1000)")
        self.zero_calls.append(self.stand.mot_pwm)
        self.tare = TareOffsets()
        return self.tare


@pytest.fixture(autouse=True)
def _setup(tmp_path, monkeypatch):
    monkeypatch.setenv("SOUNDVIS_DATA", str(tmp_path))
    apply_calibration_config(TytoCalibrationConfig())
    return tmp_path


@pytest.fixture
def fake_capture(monkeypatch):
    """Replace `capture_simultaneous` with a stub that returns silent buffers."""
    from server.core import capture_orchestrator as orch_mod
    from server.core.capture import CaptureResult

    def fake(specs, _duration):
        return [
            CaptureResult(
                serial=s.serial, sample_rate=s.sample_rate,
                audio=np.zeros(int(s.sample_rate * 0.1), dtype=np.float32),
            )
            for s in specs
        ]

    monkeypatch.setattr(orch_mod, "capture_simultaneous", fake)


@pytest.fixture
def request_body() -> CaptureRunRequest:
    return CaptureRunRequest(
        key=KeyFields(motor="M", propeller="P", shroud="S", notes="N"),
        half=MeasurementHalf.TOP,
        pwm_steps=[PWMStep(pwm_us=1100, recording_ms=100), PWMStep(pwm_us=1200, recording_ms=100)],
        mics=[
            MicSpecRun(serial="8100001", device_index=0, elevation_deg=0.0),
            MicSpecRun(serial="8100002", device_index=1, elevation_deg=45.0),
        ],
        sample_rate=48000,
        stabilize_timeout_seconds=2.0,
        trigger=TriggerSyncRun(enabled=False),
    )


async def _wait_until_done(orch: CaptureOrchestrator, timeout: float = 5.0):
    """Poll the task until it completes."""
    if orch._task is None:
        return
    await asyncio.wait_for(orch._task, timeout)


async def test_run_completes_and_writes_measurements(fake_capture, request_body):
    orch = CaptureOrchestrator(settle_before_tare_s=0.0)
    svc = FakeService()
    status = await orch.start_run(svc, request_body)
    assert status.state == "running"

    await _wait_until_done(orch)

    final = orch.get_status()
    assert final.state == "completed"
    assert final.phase == CaptureRunPhase.COMPLETED
    # 2 PWM steps * (1 perf + 2 acoustic) = 6 measurements
    assert len(final.measurement_ids) == 6
    # spool-down brought PWM to 1000
    assert svc.stand.mot_pwm == 1000


async def test_concurrent_run_rejected(fake_capture, request_body):
    orch = CaptureOrchestrator(settle_before_tare_s=0.0)
    svc = FakeService()
    await orch.start_run(svc, request_body)
    with pytest.raises(RuntimeError, match="already in progress"):
        await orch.start_run(svc, request_body)
    await _wait_until_done(orch)


async def test_empty_pwm_steps_rejected(fake_capture, request_body):
    request_body.pwm_steps = []
    orch = CaptureOrchestrator(settle_before_tare_s=0.0)
    svc = FakeService()
    with pytest.raises(ValueError, match="pwm_steps"):
        await orch.start_run(svc, request_body)


async def test_abort_stops_run_and_slams_pwm(fake_capture, request_body):
    request_body.pwm_steps = [PWMStep(pwm_us=1500, recording_ms=5000)]  # long step so we can abort mid-run
    orch = CaptureOrchestrator(settle_before_tare_s=0.0)
    svc = FakeService()
    await orch.start_run(svc, request_body)
    await asyncio.sleep(0.1)  # let it advance to capturing
    await orch.abort()
    final = orch.get_status()
    assert final.state == "aborted"
    assert svc.stand.mot_pwm == 1000


async def test_subscribe_receives_status_updates(fake_capture, request_body):
    orch = CaptureOrchestrator(settle_before_tare_s=0.0)
    svc = FakeService()
    queue = orch.subscribe()
    await orch.start_run(svc, request_body)
    await _wait_until_done(orch)

    statuses = []
    while not queue.empty():
        statuses.append(queue.get_nowait())
    states = {s.phase for s in statuses}
    assert CaptureRunPhase.STARTING in states or CaptureRunPhase.SETTING_PWM in states
    assert CaptureRunPhase.COMPLETED in states


async def test_link_drop_fails_run_and_slams_pwm(fake_capture, request_body):
    """A serial drop mid-run must fail the run loudly — continuing would record
    empty telemetry with no cutoff watchdog behind it."""
    request_body.pwm_steps = [PWMStep(pwm_us=1500, recording_ms=5000)]
    orch = CaptureOrchestrator(settle_before_tare_s=0.0, link_check_period_s=0.01)
    svc = FakeService()
    await orch.start_run(svc, request_body)
    await asyncio.sleep(0.1)  # let it get past tare + set_pwm

    svc.connected = False
    svc.link_error = "OSError: device disconnected"
    await _wait_until_done(orch)

    final = orch.get_status()
    assert final.state == "failed"
    assert final.phase == CaptureRunPhase.FAILED
    assert "link dropped" in (final.error or "")
    assert svc.stand.mot_pwm == 1000


async def test_link_down_at_start_fails_before_writing_anything(fake_capture, request_body):
    orch = CaptureOrchestrator(settle_before_tare_s=0.0, link_check_period_s=0.01)
    svc = FakeService()
    svc.connected = False
    await orch.start_run(svc, request_body)
    await _wait_until_done(orch)

    final = orch.get_status()
    assert final.state == "failed"
    assert final.measurement_ids == []
    assert svc.stand.mot_pwm == 1000


async def test_tare_runs_once_before_motor_spin(fake_capture, request_body):
    """Tare must run exactly once per run, at idle, before the motor first spins."""
    orch = CaptureOrchestrator(settle_before_tare_s=0.0)
    svc = FakeService()
    await orch.start_run(svc, request_body)
    await _wait_until_done(orch)

    assert len(svc.zero_calls) == 1
    # FakeService.zero raises unless PWM=1000 — so 1000 in the call log proves idle.
    assert svc.zero_calls[0] == 1000


def _stored(slug: str):
    from server.store import measurements as meas_store
    return meas_store.list_measurements(slug)


async def test_single_pass_default_writes_repeat_one(fake_capture, request_body):
    assert request_body.repeats == 1
    orch = CaptureOrchestrator(settle_before_tare_s=0.0)
    svc = FakeService()
    await orch.start_run(svc, request_body)
    await _wait_until_done(orch)

    final = orch.get_status()
    assert final.state == "completed"
    assert final.total_repeats == 1
    assert len(final.measurement_ids) == 6
    assert {m.repeat for m in _stored(final.key_slug)} == {1}
    assert [p for _, p in svc.pwm_log] == [1100, 1200]


async def test_repeats_run_the_ramp_n_times_with_idle_gap(fake_capture, request_body):
    request_body.repeats = 3
    request_body.repeat_gap_seconds = 0.05
    orch = CaptureOrchestrator(settle_before_tare_s=0.0)
    svc = FakeService()
    await orch.start_run(svc, request_body)
    await _wait_until_done(orch)

    final = orch.get_status()
    assert final.state == "completed"
    assert final.current_repeat == 3 and final.total_repeats == 3
    assert len(final.measurement_ids) == 18
    assert len(set(final.measurement_ids)) == 18

    stored = _stored(final.key_slug)
    for r in (1, 2, 3):
        assert sum(m.repeat == r for m in stored) == 6

    idle = REPEAT_IDLE_PWM_US
    assert [p for _, p in svc.pwm_log] == [1100, 1200, idle, 1100, 1200, idle, 1100, 1200]
    for gap_i in (2, 5):
        t_idle, _ = svc.pwm_log[gap_i]
        t_next, _ = svc.pwm_log[gap_i + 1]
        assert t_next - t_idle >= 0.05
    assert len(svc.zero_calls) == 1
    assert svc.stand.mot_pwm == 1000


async def test_abort_during_repeat_gap(fake_capture, request_body):
    request_body.repeats = 3
    request_body.repeat_gap_seconds = 30.0
    orch = CaptureOrchestrator(settle_before_tare_s=0.0)
    svc = FakeService()
    await orch.start_run(svc, request_body)
    for _ in range(200):
        if orch.get_status().phase == CaptureRunPhase.REPEAT_GAP:
            break
        await asyncio.sleep(0.01)
    assert orch.get_status().phase == CaptureRunPhase.REPEAT_GAP
    assert svc.stand.mot_pwm == REPEAT_IDLE_PWM_US

    t0 = time.monotonic()
    await orch.abort()
    assert time.monotonic() - t0 < 1.0
    final = orch.get_status()
    assert final.state == "aborted"
    assert svc.stand.mot_pwm == 1000
    assert {m.repeat for m in _stored(final.key_slug)} == {1}


async def test_cutoff_trip_during_gap_fails_run(fake_capture, request_body):
    request_body.repeats = 2
    request_body.repeat_gap_seconds = 0.3
    orch = CaptureOrchestrator(settle_before_tare_s=0.0)
    svc = FakeService()
    await orch.start_run(svc, request_body)
    for _ in range(200):
        if orch.get_status().phase == CaptureRunPhase.REPEAT_GAP:
            break
        await asyncio.sleep(0.01)
    svc.watchdog.tripped = "current"
    svc.stand.mot_pwm = 1000
    await _wait_until_done(orch)

    final = orch.get_status()
    assert final.state == "failed"
    assert "tripped" in (final.error or "")
    assert {m.repeat for m in _stored(final.key_slug)} == {1}


def test_old_meta_without_repeat_reads_as_one():
    from server.api.schemas import AcousticMeasurementMeta
    m = AcousticMeasurementMeta.model_validate({
        "t_start": "2026-09-02T10:00:00Z", "t_end": "2026-09-02T10:00:02Z",
        "mic_serial": "x", "elevation_deg": 0.0, "half": "full",
    })
    assert m.repeat == 1
