asdfgh0318/SoundVisualizer/server/tests/test_results_api.py

from datetime import UTC, datetime, timedelta

import numpy as np
import pytest
from fastapi.testclient import TestClient

from server.api.schemas import (
    AcousticMeasurementMeta,
    Key,
    MeasurementHalf,
    PerformanceMeasurementMeta,
)
from server.core.calibration import parse_umik_calibration
from server.core.wav import write_wav_float32
from server.main import app
from server.store import calibration as cal_store
from server.store import keys, measurements
from server.store.paths import measurement_dir


@pytest.fixture(autouse=True)
def _data_dir(tmp_path, monkeypatch):
    monkeypatch.setenv("SOUNDVIS_DATA", str(tmp_path))
    return tmp_path


@pytest.fixture
def client():
    return TestClient(app)


def _make_key():
    k = Key(motor="m", propeller="p", shroud="s", notes="n")
    keys.create_key(k)
    return k


def _write_acoustic(
    slug: str, t_start, mic: str, elev: float, half: MeasurementHalf, pwm: int,
    cal_id: str | None = None, repeat: int = 1,
):
    sr = 48000
    t = np.arange(8192) / sr
    audio = (0.5 * np.sin(2 * np.pi * 1000 * t)).astype(np.float32)
    meta = AcousticMeasurementMeta(
        t_start=t_start,
        t_end=t_start + timedelta(seconds=1),
        pwm_setpoint=pwm,
        mic_serial=mic,
        elevation_deg=elev,
        half=half,
        sample_rate=sr,
        calibration_file_id=cal_id,
        repeat=repeat,
    )
    saved = measurements.create_measurement(slug, meta)
    write_wav_float32(measurement_dir(slug, saved.id) / "audio.wav", audio, sr)
    return saved


def _write_performance(
    slug: str, t_start, pwm: int, *, thrust: float = 5.1, current: float = 4.0, rpm: float = 12000,
    repeat: int = 1,
):
    meta = PerformanceMeasurementMeta(
        t_start=t_start,
        t_end=t_start + timedelta(seconds=1),
        pwm_setpoint=pwm,
        repeat=repeat,
    )
    csv = (
        b"t_offset_s,thrust_n,torque_nm,current_a,voltage_v,rpm,"
        b"temp0_c,temp1_c,temp2_c,vibration\n"
        + f"0.000,{thrust:.2f},0.51,{current:.2f},16.10,{rpm:.0f},35.0,32.0,30.0,40\n".encode()
        + f"0.030,{thrust+0.1:.2f},0.52,{current+0.1:.2f},16.05,{rpm+10:.0f},35.5,32.2,30.1,42\n".encode()
    )
    saved = measurements.create_measurement(slug, meta, telemetry_csv=csv)
    return saved


def test_pwm_points_one_capture_per_pwm(client):
    """Two PWMs, one top capture each → two merged points, each with one underlying."""
    k = _make_key()
    t1 = datetime.now(UTC)
    t2 = t1 + timedelta(seconds=10)
    _write_performance(k.slug, t1, 1200)
    _write_acoustic(k.slug, t1, "8100001", 0.0, MeasurementHalf.TOP, 1200)
    _write_acoustic(k.slug, t1, "8100002", 45.0, MeasurementHalf.TOP, 1200)
    _write_performance(k.slug, t2, 1500)
    _write_acoustic(k.slug, t2, "8100001", 0.0, MeasurementHalf.TOP, 1500)

    r = client.get(f"/keys/{k.slug}/pwm_points")
    assert r.status_code == 200
    points = r.json()
    assert len(points) == 2
    p1, p2 = points
    assert p1["pwm_us"] == 1200
    assert p1["composition"] == {"top": 1}
    assert len(p1["underlying"]) == 1
    assert len(p1["acoustic"]) == 2
    # acoustic sorted by elevation desc
    assert p1["acoustic"][0]["elevation_deg"] == 45.0
    assert p1["acoustic"][1]["elevation_deg"] == 0.0
    assert p2["pwm_us"] == 1500


def test_pwm_points_top_and_bottom_merge_when_compatible(client):
    """Top + bottom at same PWM with identical perf → one merged point."""
    k = _make_key()
    t_top = datetime.now(UTC)
    t_bot = t_top + timedelta(seconds=10)
    _write_performance(k.slug, t_top, 1200)
    _write_acoustic(k.slug, t_top, "8100001", 0.0, MeasurementHalf.TOP, 1200)
    _write_performance(k.slug, t_bot, 1200)
    _write_acoustic(k.slug, t_bot, "8100001", 0.0, MeasurementHalf.BOTTOM, 1200)

    points = client.get(f"/keys/{k.slug}/pwm_points").json()
    assert len(points) == 1
    p = points[0]
    assert p["composition"] == {"top": 1, "bottom": 1}
    assert len(p["underlying"]) == 2
    # Both halves measured at 0° — the merged acoustic list dedupes to one mic per
    # unique elevation. Drill-down (point.underlying[x].acoustic) keeps the
    # per-capture mic list separately.
    assert len(p["acoustic"]) == 1
    assert p["acoustic"][0]["elevation_deg"] == 0.0
    # Both underlying captures still carry their own 0° mic.
    assert len(p["underlying"][0]["acoustic"]) == 1
    assert len(p["underlying"][1]["acoustic"]) == 1


def test_pwm_points_top_and_bottom_split_when_incompatible(client):
    """Top + bottom at same PWM but with very different perf (incompatible thrust)
    → two separate merged points."""
    k = _make_key()
    t_top = datetime.now(UTC)
    t_bot = t_top + timedelta(seconds=10)
    # Default tolerance: thrust abs=0.5 N or rel=5%. Make one 5.1 N, the other 12 N.
    _write_performance(k.slug, t_top, 1200, thrust=5.1, current=4.0)
    _write_acoustic(k.slug, t_top, "8100001", 0.0, MeasurementHalf.TOP, 1200)
    _write_performance(k.slug, t_bot, 1200, thrust=12.0, current=9.0)
    _write_acoustic(k.slug, t_bot, "8100001", 0.0, MeasurementHalf.BOTTOM, 1200)

    points = client.get(f"/keys/{k.slug}/pwm_points").json()
    assert len(points) == 2
    assert {p["composition"].get("top", 0) for p in points} == {0, 1}
    assert {p["composition"].get("bottom", 0) for p in points} == {0, 1}


def test_fft_returns_peak_at_1khz(client):
    k = _make_key()
    saved = _write_acoustic(k.slug, datetime.now(UTC), "X", 0.0, MeasurementHalf.TOP, 1500)
    r = client.get(f"/keys/{k.slug}/measurements/{saved.id}/fft")
    assert r.status_code == 200, r.text
    body = r.json()
    freqs = body["frequencies"]
    mags = body["magnitudes_db"]
    peak_idx = max(range(len(mags)), key=lambda i: mags[i])
    assert abs(freqs[peak_idx] - 1000.0) < 30
    assert body["calibrated"] is False
    assert body["absolute_spl"] is False
    assert max(mags) < 0  # uncalibrated → dBFS density, negative


def _save_cal(cal_id: str, header: str) -> str:
    text = f"{header}\n20.000\t0.0\n20000.000\t0.0\n"
    cal_store.save_calibration(cal_id, text, parse_umik_calibration(text))
    return cal_id


def test_fft_with_sens_factor_reports_absolute_spl(client):
    k = _make_key()
    cal_id = _save_cal("8100001", '"Sens Factor =-12.0dB, AGain=18.0dB, SERNO: 8100001"')
    saved = _write_acoustic(
        k.slug, datetime.now(UTC), "8100001", 0.0, MeasurementHalf.TOP, 1500, cal_id=cal_id,
    )
    body = client.get(f"/keys/{k.slug}/measurements/{saved.id}/fft").json()
    assert body["calibrated"] is True
    assert body["absolute_spl"] is True
    # A -9 dBFS sine at +106 dB offset lands well above 0 — real SPL territory.
    assert max(body["magnitudes_db"]) > 50


def test_fft_without_sens_factor_is_not_absolute(client):
    k = _make_key()
    cal_id = _save_cal("8100002", '"SERNO: 8100002"')
    saved = _write_acoustic(
        k.slug, datetime.now(UTC), "8100002", 0.0, MeasurementHalf.TOP, 1500, cal_id=cal_id,
    )
    body = client.get(f"/keys/{k.slug}/measurements/{saved.id}/fft").json()
    assert body["calibrated"] is True
    assert body["absolute_spl"] is False
    assert max(body["magnitudes_db"]) < 0


def test_fft_404_on_missing_measurement(client):
    k = _make_key()
    r = client.get(f"/keys/{k.slug}/measurements/nope/fft")
    assert r.status_code == 404


def test_fft_400_on_performance_measurement(client):
    k = _make_key()
    saved = _write_performance(k.slug, datetime.now(UTC), 1200)
    r = client.get(f"/keys/{k.slug}/measurements/{saved.id}/fft")
    assert r.status_code == 400


def test_performance_summary(client):
    k = _make_key()
    saved = _write_performance(k.slug, datetime.now(UTC), 1500)
    r = client.get(f"/keys/{k.slug}/measurements/{saved.id}/performance_summary")
    assert r.status_code == 200
    body = r.json()
    assert body["n_samples"] == 2
    assert abs(body["thrust_n_mean"] - 5.15) < 0.001
    assert body["thrust_n_max"] == 5.20
    assert abs(body["voltage_v_mean"] - 16.075) < 0.001


def test_performance_summary_404_on_acoustic(client):
    k = _make_key()
    saved = _write_acoustic(k.slug, datetime.now(UTC), "X", 0.0, MeasurementHalf.TOP, 1500)
    r = client.get(f"/keys/{k.slug}/measurements/{saved.id}/performance_summary")
    assert r.status_code == 404


def _write_rotor_capture(slug: str, t_start, pwm: int, bpf: float, mics=("A", "B")):
    """Two mics with a rotor-like signal: BPF comb + shaft harmonics + noise."""
    sr = 48000
    rng = np.random.default_rng(0)
    tt = np.arange(2 * sr) / sr
    x = 0.002 * rng.standard_normal(len(tt))
    for h in range(1, 7):
        x += 0.05 / h * np.sin(2 * np.pi * h * bpf * tt)
    x = x.astype(np.float32)
    saved = []
    for i, mic in enumerate(mics):
        meta = AcousticMeasurementMeta(
            t_start=t_start,
            t_end=t_start + timedelta(seconds=2),
            pwm_setpoint=pwm,
            mic_serial=mic,
            elevation_deg=18.0 * i,
            half=MeasurementHalf.FULL,
            sample_rate=sr,
            bpf_hz=bpf,
        )
        s = measurements.create_measurement(slug, meta)
        write_wav_float32(measurement_dir(slug, s.id) / "audio.wav", x, sr)
        saved.append(s)
    return saved


def test_fft_reports_bpf_tones_and_notched_bands(client):
    k = _make_key()
    saved = _write_rotor_capture(k.slug, datetime.now(UTC), 1900, 238.0)[0]
    body = client.get(f"/keys/{k.slug}/measurements/{saved.id}/fft").json()
    assert abs(body["bpf_hz"] - 238.0) < 1.0
    assert [t["harmonic"] for t in body["tones"]] == [1, 2, 3, 4, 5, 6]
    assert body["tones"][0]["level_db"] > body["tones"][1]["level_db"]
    assert len(body["broadband_bands_db"]) == len(body["band_centres_hz"]) == 19
    # the 250 Hz band holds the BPF; notched it must sit far below the tone
    i250 = min(range(19), key=lambda i: abs(body["band_centres_hz"][i] - 250))
    assert body["broadband_bands_db"][i250] is not None
    assert body["broadband_bands_db"][i250] < body["tones"][0]["level_db"] - 20


def test_pwm_points_flags_off_speed_capture(client):
    k = _make_key()
    t0 = datetime.now(UTC)
    _write_rotor_capture(k.slug, t0, 1900, 238.0)
    _write_rotor_capture(k.slug, t0 + timedelta(minutes=1), 1900, 239.0)
    _write_rotor_capture(k.slug, t0 + timedelta(minutes=2), 1900, 164.0)  # supply-limited run
    pts = client.get(f"/keys/{k.slug}/pwm_points").json()
    caps = [u for p in pts for u in p["underlying"]]
    assert len(caps) == 3
    flags = {round(u["bpf_hz"]): u["off_speed"] for u in caps}
    assert flags == {238: False, 239: False, 164: True}


def test_pwm_points_carry_repeat_index(client):
    """Three passes of one ramp merge into one point; each capture and mic keeps its
    repeat, and the merged (deduped) list is repeat 1 — what the Polar tab showed before."""
    k = _make_key()
    t0 = datetime.now(UTC)
    for r in (1, 2, 3):
        t = t0 + timedelta(seconds=20 * r)
        _write_performance(k.slug, t, 1800, repeat=r)
        _write_acoustic(k.slug, t, "8100001", 0.0, MeasurementHalf.FULL, 1800, repeat=r)
        _write_acoustic(k.slug, t, "8100002", 45.0, MeasurementHalf.FULL, 1800, repeat=r)

    points = client.get(f"/keys/{k.slug}/pwm_points").json()
    assert len(points) == 1
    p = points[0]
    assert [u["repeat"] for u in p["underlying"]] == [1, 2, 3]
    assert all(a["repeat"] == u["repeat"] for u in p["underlying"] for a in u["acoustic"])
    assert {a["repeat"] for a in p["acoustic"]} == {1}

    listed = client.get(f"/keys/{k.slug}/measurements").json()
    assert sorted({m["repeat"] for m in listed}) == [1, 2, 3]
