asdfgh0318/SoundVisualizer/server/core/calibration.py

"""miniDSP UMIK-2 calibration file parser.

Format (REW-compatible plain text):

    "Sens Factor =-1.7240dB, SERNO: 8100123"
    "AGain=-9.0dB"
    20.000   -0.45
    21.000   -0.43
    ...

Some files omit AGain. Some have a third "phase" column we ignore. Comment lines
start with `*`. Values are whitespace- or comma-separated.
"""

import re
from dataclasses import dataclass

import numpy as np

_SENS_RE = re.compile(r"Sens(?:\s*Factor)?\s*=\s*(-?\d+(?:\.\d+)?)\s*dB", re.IGNORECASE)
_AGAIN_RE = re.compile(r"AGain\s*=\s*(-?\d+(?:\.\d+)?)\s*dB", re.IGNORECASE)
_SERNO_RE = re.compile(r"SERNO\s*:\s*(\w+)", re.IGNORECASE)


@dataclass
class UmikCalibration:
    serial: str | None
    sens_factor_db: float | None
    again_db: float | None
    freq_hz: np.ndarray
    gain_db: np.ndarray


def parse_umik_calibration(text: str) -> UmikCalibration:
    serial: str | None = None
    sens: float | None = None
    again: float | None = None
    rows: list[tuple[float, float]] = []

    for raw in text.splitlines():
        line = raw.strip()
        if not line or line.startswith("*"):
            continue

        m = _SENS_RE.search(line)
        if m:
            sens = float(m.group(1))
            sm = _SERNO_RE.search(line)
            if sm:
                serial = sm.group(1)
            # Real UMIK-2 files put AGain on the SAME line as Sens Factor + SERNO
            # (e.g. `Sens Factor =-12dB, AGain =18dB, SERNO: 8108897`), so scan
            # this line for it too before moving on.
            am = _AGAIN_RE.search(line)
            if am:
                again = float(am.group(1))
            continue

        m = _AGAIN_RE.search(line)
        if m:
            again = float(m.group(1))
            continue

        parts = line.replace(",", " ").split()
        if len(parts) >= 2:
            try:
                rows.append((float(parts[0]), float(parts[1])))
            except ValueError:
                continue

    if not rows:
        raise ValueError("no frequency/gain data found in calibration file")

    arr = np.asarray(rows, dtype=np.float64)
    return UmikCalibration(
        serial=serial,
        sens_factor_db=sens,
        again_db=again,
        freq_hz=arr[:, 0],
        gain_db=arr[:, 1],
    )


# A calibrator driving the mic at 94 dB SPL is 1 Pa rms — the reference level the
# UMIK Sens Factor is quoted against (it records the dBFS the mic reports there).
CALIBRATOR_REFERENCE_SPL_DB = 94.0
REFERENCE_PRESSURE_PA = 20e-6


def is_absolute_spl(cal: UmikCalibration) -> bool:
    """Whether `cal` can convert dBFS to absolute dB SPL (needs a Sens Factor)."""
    return cal.sens_factor_db is not None


def pascals_per_full_scale(cal: UmikCalibration) -> float | None:
    """Pa per unit of float audio in [-1, 1], or None without a Sens Factor.

    Falls out of `SPL = 20*log10(A_rms) - sens_factor_db + 94` combined with
    `p_rms = 20e-6 * 10**(SPL/20)`: the level terms cancel and leave a constant
    scalar. Consumers that need Pa (mosqito) multiply the samples by it.
    """
    if cal.sens_factor_db is None:
        return None
    return REFERENCE_PRESSURE_PA * 10 ** (
        (CALIBRATOR_REFERENCE_SPL_DB - cal.sens_factor_db) / 20.0
    )


def apply_calibration_to_spectrum(
    freq_hz: np.ndarray,
    mag_db: np.ndarray,
    cal: UmikCalibration,
) -> np.ndarray:
    """Apply the UMIK-2 calibration to a magnitude spectrum.

    The response curve is SUBTRACTED, the Sens Factor offset is ADDED. They are
    different quantities and the signs are not a matter of taste:

    * `cal.gain_db` is the mic's own gain response — its coloration — not a
      correction. REW, whose file format this is, states it directly: "It should
      contain the actual gain (and optionally phase) response of the meter or
      microphone at the frequencies given, these will then be subtracted from
      subsequent measurements." A mic reading 1 dB hot at 5 kHz must have 1 dB
      taken off. The curve's shape corroborates it: these files sit near 0 dB at
      1 kHz and go negative at both extremes, which is a capsule rolling off —
      a correction curve for such a mic would be positive there.

    * The Sens Factor is the dBFS the mic reports at 94 dB SPL, so
      `SPL = dBFS - sens_factor_db + 94` follows from the definition. Adding a
      constant to a per-Hz density is fine: it passes through the downstream band
      integration unchanged.

    Linear interpolation over `freq_hz`; bins outside the calibration's range
    clamp to the boundary values rather than extrapolating.

    AGain is deliberately *not* applied — the Sens Factor already accounts for
    the mic's internal gain; AGain only records which analog-gain setting it is
    valid at. Without a Sens Factor only the response curve is removed and the
    result stays dBFS-relative (see `is_absolute_spl`).
    """
    response = np.interp(
        freq_hz,
        cal.freq_hz,
        cal.gain_db,
        left=float(cal.gain_db[0]),
        right=float(cal.gain_db[-1]),
    )
    correction = -response
    if cal.sens_factor_db is not None:
        correction = correction + (CALIBRATOR_REFERENCE_SPL_DB - cal.sens_factor_db)
    return mag_db + correction
