asdfgh0318/SoundVisualizer/(commit log)

2026-03-09 Initial commit: Sound Visualizer — multi-mic directivity measurement tool
    5-mic UMIK-2 array capture with AN69-inspired visualizations:
    contour/sonogram, frequency response, polar plots, 3D balloon,
    Sound Power & DI curves. Live level meters, WAV export, CEA-2034 metrics.
2026-05-12 Build MVP: phases 0-9 (server, frontend, capture wizard, results)
    Refactor from the original browser-only Web Audio app into a Python
    FastAPI server + React thin client per PLAN.md. All MVP phases except
    Norsonic (phase 6) and RPi packaging (phase 10) are complete — both
    are hardware-blocked.
    Server (server/):
    - FastAPI app with an asyncio lifespan owning the Tyto thrust-stand
    connection and a capture-run orchestrator. 17 HTTP/WS routes.
    - UMIK-2 multi-stream capture (sounddevice), REW-format calibration
    parser, server-side trigger-onset sync (port from triggerSync.ts).
    - Tyto 1585 driven by vendored Paweł Sadowski code
    (server/vendor/pawel/) — full permission granted. Calibratio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
2026-05-12 Run fake capture through the full wizard with simulated progress
    The "Run fake capture (no hardware)" path previously bypassed the
    safety modal + RunningView + reconfigure modal and jumped straight to
    the done summary. Now it routes through the same UX as a real capture:
    safety modal (with copy adjusted to "no motor will spin"), RunningView
    showing animated step-by-step phase transitions (setting_pwm →
    stabilizing → recording → writing, ~1s per step), reconfigure modal
    between top and bottom halves, then done.
    Useful for testing the wizard flow and demoing the app without the rig.
    - wizardStore: add fakeMode flag, reset on Start over.
    - SafetyModal: branches on fakeMode for friendlie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
2026-05-12 Constrain mic elevation dropdowns to the side that makes physical sense
    Top mics live above the prop plane (0° to +90°). Bottom mics live
    below (-90° to 0°). Showing the full -90..+90 range in both dropdowns
    let users pick contradictory configs (top=-90° / bottom=+90°), which
    muddles the polar plot grouping.
    0° is allowed in both because the equator mic may stay physically
    mounted across the top→bottom remount.
2026-05-12 Add savable mic presets (closes #1)
    Setup → Microphones now has a presets bar: server-stored named
    snapshots of the mic list (count + serials + top/bottom elevations +
    calibration assignments). Load replaces the current mic list (with
    confirmation if non-empty); Save prompts for a name; Delete removes
    a saved preset.
    USB device indices are intentionally NOT in the preset since they
    shift between machines and reboots — they stay per-session.
    Server:
    - New `SetupPreset` + `MicPresetEntry` schemas.
    - Filesystem store at `data/setup-presets/<uuid>.json`.
    - Endpoints: GET/POST/DELETE /setup-presets + GET /setup-presets/{id}.
    Frontend:
    - New PresetControls component placed atop the MicList.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
    [schemas.py, setup_presets.py, test_setup_presets.py]
2026-05-12 Cross-platform onboarding: setup scripts + audio device filter
    scripts/setup.sh — portable bash setup (Linux + macOS + WSL). Detects
    platform, checks prereqs (Python 3.12, Node 22, PortAudio per-OS),
    creates venv, installs server + frontend deps, runs pytest, builds
    the frontend. Verified end-to-end on this Linux box.
    scripts/setup.ps1 — PowerShell equivalent for Windows. Syntax-checked
    but not run-tested here (no Windows box available); core logic mirrors
    the bash script.
    server/core/audio_devices.py — the ALSA (hw:...) filter only applies
    on Linux now. On macOS (CoreAudio) and Windows (WASAPI/MME) there's no
    equivalent virtual-plugin proliferation, so we return all input
    devices. P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
2026-05-13 Group same-PWM captures into merged points with compat check (closes #2)
    Top + bottom captures at the same PWM setpoint now collapse into a
    single Results-sidebar entry when their performance summaries agree
    within the configured tolerances. Incompatible captures stay as
    separate entries; multiple compatible captures (e.g. retakes) merge
    with an explicit composition chip.
    - New CompatTolerance / CompatibilityTolerances schemas with per-channel
    absolute + relative thresholds (defaults: thrust 0.5 N / 5 %,
    torque 0.05 N·m / 10 %, current 0.5 A / 5 %, voltage 0.3 V abs,
    RPM 100 / 2 %).
    - /compat-tolerances GET/PUT persists to data/compat-tolerances.json.
    - /keys/{slug}/pwm_point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
    [compat_tolerances.py, results.py, schemas.py, test_compat_tolerances.py, test_results_api.py]
2026-05-13 setup.ps1: replace em-dash with ASCII hyphen
    Windows PowerShell 5.1 reads .ps1 files with the system ANSI codepage
    when no BOM is present. The em-dash's UTF-8 bytes get mis-decoded; one
    byte maps to a curly quote in Windows-1252, which closes the string
    early and breaks the whole script. ASCII-only avoids the trap.
2026-05-13 Add Psychoacoustics tab + Docker demo image (closes #3, closes #4)
    ## Psychoacoustics tab (closes #3)
    Per-mic Sound Quality Metrics + Psychoacoustic Annoyance per the
    Zwicker model, applied to drone noise (math reference:
    docs/psychoacoustics_report.{tex,pdf}, with Polish translation).
    - `mosqito` (BSD) + `matplotlib` added to pyproject deps. mosqito
    provides ISO 532-1 loudness, DIN 45692 sharpness, Daniel-Weber
    roughness.
    - `server/core/psychoacoustics.py` wraps mosqito and computes PA via
    the Zwicker formula manually. Fluctuation strength = 0 (mosqito
    doesn't ship one yet; for drone hover F ~ 0.01 vacil contributes
    <0.1% to PA — acceptable approximation per the report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
    [psychoacoustics.py, results.py, test_psychoacoustics.py]
2026-05-14 Psychoacoustics tab: color-code per-mic results green→red
    Each metric column (Loudness, Sharpness, Roughness, PA) now interpolates
    each cell's text color along a green→yellow→red HSL gradient based on its
    value's position in the column's min/max — lowest = best (green), highest
    = worst (red). Makes directivity asymmetries and outliers obvious at a
    glance instead of forcing the user to scan the digits.
    Fluctuation column stays neutral (always 0 — mosqito has no FS yet). Flat
    columns (single row / all-tied) fall back to neutral text to avoid
    implying "everything is green". Small legend swatch added under the table.
2026-05-14 Gitignore docs/references/*.pdf — keep research papers local-only
    Centralized all 8 untracked reference PDFs from the repo root into
    docs/references/ alongside the 4 already there, then gitignored the
    whole pattern. Combined weight is ~37 MB of new PDFs (Beaulieu thesis
    alone is 14 MB) and these papers are reading material, not project
    artifacts — no reason to bloat clones with them. The four previously
    tracked reference PDFs are untracked here too for consistency; anyone
    who wants them can re-download from the sources cited in the docs.
    The two generated reports (docs/psychoacoustics_report{,_pl}.pdf) stay
    tracked — those are project outputs, not references.
    .dockerignore already ex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
2026-05-19 Fix two HTTP-deploy bugs surfaced on Paweł's hosted instance
    1) crypto.randomUUID polyfill — the browser's randomUUID() is gated to
    secure contexts (HTTPS or localhost), so on a plain-HTTP deployment
    like http://git.swarozyn.pl:8000 it's not defined. Clicking "Add mic"
    crashed with "crypto.randomUUID is not a function". New helper
    src/lib/uuid.ts uses crypto.randomUUID when available and falls back
    to a Date.now+Math.random ID otherwise. These IDs are React keys /
    Zustand row identifiers only — never sent to the server — so the
    non-crypto fallback is fine. Replaced both callsites (setupStore,
    PresetControls).
    2) SPA routing fallback — the FastAPI StaticFiles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
2026-06-09 Phase 10 — Raspberry Pi 5 production packaging (closes #5)
    Native systemd deployment for the production rig. The Pi 5 runs the same
    server/ code as the laptop; one service serves the API + prebuilt React
    bundle on :8000 at http://soundvis.local:8000.
    New:
    - deploy/soundvis.service — systemd unit (uvicorn via `python -m server`,
    serves the bundle, Restart=on-failure, boot-enabled, runs in
    audio+dialout groups for ALSA mics + Tyto serial). Templated; the
    installer substitutes the real user/group and absolute repo path.
    - scripts/setup_rpi.sh — idempotent installer: apt deps + Node 22, pyenv
    + CPython 3.12 (Bookworm ships 3.11 and deadsnakes is Ubuntu-only, so we
    compile via py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
    [config.py]
2026-06-09 RPi deploy: system Python 3.13, not pyenv; add laptop-side deploy helper
    Deployed to the actual Pi 5 and the assumptions changed, so the scripts
    now match reality (verified end-to-end on the device):
    - The Pi runs Debian 13 (Trixie) → system Python 3.13, and every dep
    (numpy/scipy/mosqito/matplotlib) has an aarch64 wheel. So setup_rpi.sh
    uses the system interpreter directly — no pyenv, no 15-25 min CPython
    compile, no build-dep apt set. It requires Python >= 3.12 and fails
    fast with guidance on older Bookworm (3.11) images.
    - Frontend is now dist-aware: if dist/ is already present (shipped from a
    dev machine) it's used as-is; otherwise Node is installed and it builds
    on-dev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
2026-06-09 Setup: live per-mic input-level meter to identify mics (closes #6)
    UMIK-2s all report USB serial 00000, so the device picker can't tell which
    physical mic is which. Add a per-row "Listen" toggle: it opens a live level
    bar for that row's selected device — tap the mic, watch the bar move, assign
    its elevation/serial.
    Backend: WebSocket /devices/audio/{index}/level opens a sounddevice
    InputStream at the device's default rate, computes RMS + peak dBFS per block
    (~15 Hz), and streams JSON frames. Drops the oldest queued frame when the
    consumer lags so the latest level always lands. Refuses with code 1011 while
    a capture is in progress (device can't be opened twice). Releases the stream
    on disc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
2026-06-09 Fix capture-run crash: initialize ThrustStand tare attributes
    A capture run failed mid-recording with
    AttributeError: 'ThrustStand' object has no attribute 'tare_thrust'
    surfaced during the first real Tyto run on the Pi 5.
    Paweł's vendored ThrustStand declares tare_thrust/torque/current as class
    annotations but never sets them in __init__. Live telemetry dodged this
    (it uses raw_thrust()/raw_torque() directly), but the capture path calls
    stand.finish_meas_series() → get_samples() → sample_from_raw(), which
    subtracts self.tare_* — crashing the run.
    Initialize the three to 0.0 in ThrustStandService.start right after
    open_connection (no tare). Keeps the vendored module untouched per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
    [thrust_stand_service.py]
2026-06-09 Tyto: zero/tare the stand from the UI (closes #7)
    The load cell reads a non-zero resting baseline (~4.6 N thrust at idle on
    our unit) and the app applied no tare, so logged + displayed thrust/torque/
    current carried that offset. Setting stand.tare_* alone wouldn't fix it:
    both the live telemetry (_build_telemetry) and the stored CSV
    (_telemetry_to_csv) use raw_thrust()/raw_torque() directly and never touch
    sample_from_raw, so the tare must be subtracted in those two paths.
    Backend:
    - TareOffsets on ThrustStandService; zero(n=30) averages the last N at-rest
    samples into offsets, refusing unless idle (pwm 1000); clear_tare() resets.
    - _build_telemetry and the orchestrator's _telemetry_to_cs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
    [capture_orchestrator.py, test_capture_orchestrator.py, test_tare.py, thrust_stand.py, thrust_stand_service.py]
2026-06-09 Docs: record Tyto-on-Pi integration test + mic-meter & tare features
    - CLAUDE.md hardware row: Pi 5 integration-tested (UMIK enumerate/capture,
    Tyto connect/telemetry/watchdog/capture-run all verified); note the
    UMIK serial-00000 multi-mic caveat, temps unused, no powered run yet.
    - PLAN.md post-MVP: add the live per-mic level meter and Tyto zero/tare;
    add the multi-mic udev (port-path) open question.
2026-06-09 Multi-mic: per-port udev naming + show port-id in device picker (closes #8)
    UMIK-2s all report USB serial 00000, so the old serial-based udev rules
    collided and the picker showed identical 'UMIK-2 (hw:N,0)' entries with no
    way to tell 4 mics apart.
    - generate_udev.py: detect non-unique serials and fall back to USB
    port-path rules (KERNELS=="3-1.4.1" → ATTR{id}="umik_3_1_4_1"); stable
    per physical hub port. Serial-based naming kept for the unique case.
    - audio_devices.py: enrich /devices/audio with alsa_card_id, read from
    /sys/class/sound/cardN/id (parsed from the hw:N in the device name).
    - Setup mic-row dropdown shows the port-id prefix, so identical UMIKs are
    distinguishable; th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
    [audio_devices.py, generate_udev.py]
2026-06-09 Docs: multi-mic udev resolved; record 4-UMIK+Tyto Pi test + power lesson
    - PLAN.md: move the multi-mic udev open question to Resolved (port-path
    rules + alsa_card_id in the picker).
    - CLAUDE.md hardware row: 4 UMIKs + Tyto integration-tested; port-path
    naming; note the powered-hub power lesson from the SD-corruption incident.
2026-06-10 Results FFT: compare-configs overlay (multi-series per mic row) (closes #9)
    The FFT tab can now overlay multiple measurements for comparison. Series #0
    is the currently selected (key, PWM point); a transient cross-key picker
    (config → PWM point → + Add series) adds more. Rows stay per-mic-position
    and overlay one colored, labelled line per series, matched by elevation —
    so two propellers (or two PWM setpoints) show as two lines on every mic row.
    A legend appears once more than one series is active; base series is pinned,
    extras are removable. Frontend-only and transient — no persistence, nothing
    touches data files.
    Replaces the single-trace FFTRow with an OverlayRow inside FFTTab; r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
2026-06-10 FFT overlay: actual implementation + docs (follow-up to 599070d, #9)
    The prior commit only captured the FFTRow.tsx deletion — a multi-arg
    git add aborted on the already-staged delete, dropping the real changes.
    This commits the feature itself:
    - FFTTab.tsx: OverlayRow (multi-series per mic-position row, matched by
    elevation) + cross-key SeriesPicker (config → PWM point → add) + series
    chips with colors/labels; base series pinned, extras removable.
    - README: documented the compare-configs overlay on the Results — FFT page.
    - PLAN.md: added the feature to the post-MVP list.
2026-06-10 Results: Polar overlay + cross-tab shared compare series + cal warning (#9)
    Extends the compare-configs overlay from FFT to Polar and shares one series
    selection across both tabs.
    - compareSeries.tsx: extracted the series model + cross-key picker + the
    useCompareSeries hook into a shared module (was inline in FFTTab). Hook
    tolerates a null point and exposes CompareSeriesApi.
    - Series state lifted to ResultsBody and passed to both tabs, so the
    comparison persists when switching FFT ↔ Polar (add on one, it's there on
    the other).
    - PolarPlot is now multi-series (PolarSeries[]): one directivity curve per
    series, color-matched, legend when >1; mirror trace in 360° mode shares the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
2026-06-16 Setup: free-text per-mic elevation input (decimals OK, no preset list)
    The mic-row elevation dropdowns were limited to the preset list
    [-90, -75, -60, -45, -30, -15, 0, 15, 30, 45, 60, 75, 90], which
    doesn't fit rigs with arbitrary mic angles. Replaced them with number
    inputs that accept any value:
    - ElevationInput: <input type="number" step="any"> with per-half min/max
    (top mic ≥ 0, bottom mic ≤ 0; both clamped to [-90, 90]). Empty → null.
    - Removed the now-unused ELEVATION_VALUES constant from src/api/types.ts.
    - Backend already typed elevation_deg as float — no schema change needed.
    README Setup-page row updated to reflect the new behavior.
2026-06-16 Single-pass capture: drop top/bottom from the UI, keep backend hooks for two-pass
    Drone rigs that span the whole hemisphere in one mounting no longer need
    the two-pass capture flow. Each mic now has one absolute elevation
    (-90..+90°) and one capture run records them all simultaneously. The
    two-pass machinery (TOP / BOTTOM halves, reconfigure modal, per-half loop)
    is removed from the frontend but the backend keeps full support for it so
    old data renders and a future two-pass client can drive it.
    Backend (additive, no breakage):
    - MeasurementHalf gains FULL (single-pass default); TOP/BOTTOM kept.
    - CaptureHalfRunRequest renamed CaptureRunRequest; half defaults to FULL.
    - MicPresetEntry gains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
    [capture_orchestrator.py, capture_run.py, dev.py, schemas.py, test_capture_orchestrator.py]
2026-06-16 Research-tree integration: node picker + auto-push on capture (closes #N)
    Adds a deep integration with the sibling project duct-research-tree
    (github.com/asdfgh0318/duct-research-tree). Configure once via [research_tree]
    in config.toml; on the Pi, the setup_rpi.sh path also stands up the editor
    as its own systemd service alongside SoundVis.
    Phase A — duct-research-tree on the Pi:
    - deploy/research-tree.service: companion systemd unit running serve.py on
    :8123 (--bind 0.0.0.0). Installed + enabled by setup_rpi.sh, which also
    clones the repo into ~/duct-research-tree and configures a benign git
    author so /api/node/<id> auto-commits work.
    Phase B — header tile:
    - Navbar gets a "🌳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
2026-06-16 Mic arc: serial↔elevation map + cal-file loader
    Records the physical 11-mic vertical arc (18° steps, +90°→−72° known, −90°
    TBD) in docs/mic_arc.md, and adds scripts/load_mic_arc.py which uploads the
    per-serial UMIK-2 calibration files to a running SoundVis instance and builds
    a Setup preset mapping serial → elevation → calibration_file_id.
    The cal-file download from minidsp.com is Cloudflare-gated (JS challenge —
    plain curl/headless both 403), so that one step is done in a real browser;
    the loader handles everything after. Defaults to the on-axis cal file
    (arc mics point at the source); --ninety switches to the _90deg files.
2026-06-16 calibration: parse AGain when inline with Sens Factor
    Real miniDSP UMIK-2 cal files put AGain on the same line as Sens Factor +
    SERNO (`Sens Factor =-12dB, AGain =18dB, SERNO: 8108897`). The parser
    `continue`d after matching Sens, so AGain was always None in the stored
    summary. Now scan that line for AGain too. Cosmetic only — the correction
    curve never used AGain — but the metadata is now correct.
    Surfaced loading the real 11-mic arc cal files.
    [calibration.py]
2026-06-16 Setup: fix mic-row grid — calibration column was squished to col-span-1
    The single-elevation refactor left the row at 11/12 columns with the
    Calibration dropdown at col-span-1 (~90px) — too narrow to show a selected
    cal id like "8111897", so a linked calibration looked unset. Rebalanced to
    a full 12 cols (device 3, elevation 2, calibration 3, delete 1) and added
    the missing header cell so labels align with their columns.
2026-06-16 Setup: auto-link calibration by serial + render stale-but-set cal
    Two fixes for "calibration files show as 'none' on every mic row":
    1. Auto-link: when a mic row's serial matches an uploaded calibration's
    serial (digits-only compare, tolerating dashes/spaces), assign that cal
    automatically if the row has none. So uploading the arc's per-serial cal
    files now maps them onto the mic rows without manual picking — the
    behavior the rig operator expects.
    2. Defensive option: the cal dropdown now always renders the currently-set
    calibration id as an option even when the fetched list is empty/stale
    (e.g. cals uploaded out-of-band after the page loaded), so a linked cal
    never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
2026-06-17 Mic arc: add −90° mic (810-8904), now full 11-mic arc
    The −90° (below) mic serial is known: 810-8904. Recorded in docs/mic_arc.md
    and added to load_mic_arc.py's ARC list. Cal file downloaded + uploaded; the
    "Arc 11-mic 18° (top-down)" preset on the Pi is now complete (11/11 mics,
    +90°→−90° in 18° steps), each linked to its UMIK-2 calibration.
2026-06-17 Setup: persist mic→device binding by stable ALSA card id
    UMIK-2s all report USB serial 00000, so the only durable handle to a physical
    mic is its udev port-path card id (umik_3_1_4_1…). Previously assignments were
    keyed by the PortAudio numeric index, which shuffles every boot/replug — so
    device assignments silently broke ("mics not staying assigned").
    - MicConfig gains alsaCardId; persisted (store v3 migration).
    - Picking a device records its alsa_card_id alongside the index.
    - Reconcile effect re-resolves deviceIndex from the live device list by
    alsa_card_id on every load, and clears the index if that card is absent
    (so a row never points at the wrong physical mic).
    - Loading a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
2026-06-17 Setup: fix device assignment smeared across all rows; dedup guard
    Two related fixes for "every mic shows the same USB device (#10)":
    1. Preset-reload carry-over matched rows by digits-only serial. Non-numeric
    labels (a, b, c, …) all reduce to "" → collapse to one key → one device
    got copied onto every row. Now key on digits when present, else the raw
    serial, and skip empty keys.
    2. Dedup guard: a USB device backs exactly one mic, so if 2+ rows claim the
    same deviceIndex, clear them (can't disambiguate) and let the user re-pick.
    Also auto-cleans previously-corrupted persisted state on load.
2026-06-17 Presets: include device binding (alsa_card_id); upsert save by name
    Now that every mic has a stable udev card id, the physical mic→device binding
    is portable for a fixed rig, so store it in presets too.
    - MicPresetEntry gains alsa_card_id (backend + frontend). Save writes it;
    load restores it (deviceIndex stays null and is re-resolved from alsaCardId
    by MicList's reconcile effect once the live device list loads). Graceful if
    the card id doesn't match on a different machine/wiring.
    - "Save current as preset" now upserts by name (overwrite-with-confirm) so a
    re-save replaces the same-named preset instead of creating duplicates.
    [schemas.py]
2026-06-17 Capture: refresh research-tree node list on tab focus + manual button
    The picker fetched nodes only on mount, so edits made in the research-tree
    editor (other tab) didn't show up. Now re-fetches when the SoundVis tab
    regains focus, plus a manual ↻ refresh next to the dropdown. (Pairs with the
    duct-research-tree server-save fix so edits actually persist to the Pi.)
2026-06-19 Capture: auto-tare at run start before the motor spins
    A run-time load-cell zero defends against drift between runs (thermal, ESC
    bias, mechanical creep) bleeding false offsets into thrust/torque/current.
    Re-taring between PWM steps would mean spool-down/up per step — not worth
    the wear; one tare per run, while the motor's already at idle, is the
    right tradeoff.
    New CaptureRunPhase TARING fires once at the top of every run.
    [capture_orchestrator.py, schemas.py, test_capture_orchestrator.py]
2026-06-24 Research-tree: support multiple companion trees
    Configured via repeated [[research_trees]] tables in config.toml; the legacy
    singular [research_tree] still loads (folds into a one-entry list). Each tree
    is fetched/aggregated by /research-tree/nodes; nodes are tagged with their
    treeKey so the picker can group them. A capture-completion push is routed to
    whichever configured tree owns the picked node id — node IDs are unique by
    prefix (p1-* for duct, dp1-* for drone-paczek), so a single lookup picks the
    right tree.
    scripts/setup_rpi.sh now clones+installs a systemd unit per tree from a list,
    defaulting to duct (:8123) + drone-paczek (:8124). Navbar surfaces a dropdown
    when more than one tre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
2026-06-25 Backup: mirror measurement data to private GitHub repo every 15 min
    A corrupted SD card today wiped every measurement on the Pi (the duct-research
    ag1/ag3 sweeps + older sessions). The fix is operational, not algorithmic: a
    systemd timer rsyncs ~/SoundVisualizer/data/ into a sibling git repo and pushes
    to private SoundVisualizer-data via a per-repo SSH deploy key. Idempotent — a
    no-change run exits before committing.
    setup_rpi.sh now installs the timer; the deploy key has to be created and
    registered by hand on first deploy. Once that's done future re-flashes only
    lose <=15 min of in-flight data.
2026-06-25 Setup: motor direction-check (4 gentle spool-ups via the Tyto)
    A pre-flight in the Tyto card that runs 4 short spool-ups to PWM 1080 µs
    and back, with a 1.2s rest between each. The visible accel/decel reveals
    prop rotation direction so wiring mistakes are caught before any real run.
    Guarded by a "prop clear?" confirm, an always-visible Stop button, and an
    on-unmount slam to PWM 1000 so navigating away never leaves the motor
    spinning. TytoStatus now polls /tyto/status every 1s so the PWM readout
    mirrors the test progress live.
2026-06-25 Client: default API_BASE to same-origin in production builds
    The dev default of http://localhost:8000 was leaking into production
    bundles built without VITE_API_BASE="" — fetches died with
    ERR_CONNECTION_REFUSED for any LAN client (browser looks for soundvis
    on its own machine, not the server's). Switch the default to "" when
    import.meta.env.PROD is true so npm run build alone produces a
    same-origin bundle. VITE_API_BASE override still wins either way.
2026-07-24 Docs: OS is Raspberry Pi OS (Debian trixie base), not vanilla Debian
2026-07-24 Docs: thrust cal corrected vs 200g reference; config.toml lives on data partition
2026-07-24 MotorTest: 8 ramps, PWM 1120, 3s clear-the-prop countdown after Start
2026-07-27 Docs: pin Tyto to stable by-id serial path (replug stalls the poll loop)
2026-07-27 Tyto: auto-reconnect the serial link instead of dying silently
    The FT231X USB link drops and re-enumerates on its own (observed on the rig).
    The running server kept a dead fd, so the poll loop died — and with it went
    telemetry, PWM transmission AND the cutoff watchdog, while /tyto/status still
    claimed connected:true and any capture in flight kept "running" while writing
    empty telemetry. Silent loss of safety protection is the real problem here.
    Now: a raised poll or a 1s sample stall is treated as a dead link; the port is
    torn down and reopened with escalating backoff. PWM always returns at 1000 —
    a reconnect never resumes a live throttle — and the watchdog's stand reference
    is repoin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
    [capture_orchestrator.py, capture_run.py, test_capture_orchestrator.py, test_thrust_stand_reconnect.py, thrust_stand.py, thrust_stand_service.py]
2026-07-31 Calibration: convert spectra to absolute dB SPL; anchor polar plot at 0
    apply_calibration_to_spectrum only ever added the UMIK-2 frequency-response
    curve. sens_factor_db and again_db were parsed and stored but never used, so
    spectra stayed dBFS-relative — negative, ~100 dB low — while FFTResponse
    claimed calibrated:true. Every SPL figure in the app was wrong.
    Sens Factor is the rms dBFS a 94 dB SPL (1 Pa) calibrator produces, quoted
    with full-scale sine = -3.01 dBFS. Our Welch density + band integration is
    already mean-square, so a full-scale sine lands at -3.01 there too and no
    convention fudge is needed (pinned by a test). Hence
    SPL = level_dBFS - sens_factor + 94. AGain is NOT added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
    [calibration.py, psychoacoustics.py, results.py, test_fft.py, test_results_api.py]
2026-07-31 Psychoacoustics: feed MOSQITO calibrated Pascals, not raw float32
    MOSQITO expects acoustic pressure in Pa; compute_metrics was handed float32
    in [-1, 1] straight from the WAV, so loudness and sharpness — both strongly
    level-dependent — came out on an arbitrary scale and were not ISO-comparable.
    The endpoint never even looked at the measurement's calibration file.
    Scale by 20e-6 * 10^((94 - sens_factor)/20), reusing the reference constant
    the FFT path already defines. A full-scale sine then lands at 102.19 dB SPL,
    which matches -3.01 - sens + 94 from the spectral side; a test pins both.
    pa_per_full_scale is keyword-only with no default, so computing uncalibrated
    is still possible but ha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
2026-08-28 Capture wizard: default to the dp1 five-step ramp at 200 ms per take
    The default was three steps of 1000-2000 ms, which matched nothing we actually
    run. Use the ramp the material study uses - 1200/1500/1800/1900/2000 - so a new
    capture starts from the campaign shape instead of being retyped each time.
    200 ms per take rather than the ~2.6 s the dp1 sets used: the rotor runs
    continuously across a whole ramp, so exposure accumulates over the run, and
    short takes keep every step inside any plausible recirculation onset window.
    Trade-off is fewer Welch averages per spectrum.
    Claude-Session: https://claude.ai/code/session_01Ep1Dn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
2026-08-28 Results: include notes in compare-series labels
    The label was propeller + shroud only, so two keys differing solely in notes -
    two baselines of the same motor and prop, one per session - both rendered as
    "6in [unset]" and were indistinguishable once overlaid. Notes carries the
    research-tree node id, which is exactly the discriminator.
    Claude-Session: https://claude.ai/code/session_01Ep1DnoHv9xnRYkHVLY4ZLR
2026-08-28 Wizard: switching research-tree node updates shroud/notes
    The picker only filled empty fields, so picking a different node left the
    previous node's shroud and notes in place - and since the key is
    motor__propeller__shroud__notes, the capture was stored under the PREVIOUS
    material's key. Cost a felt run today: it landed in the cork key and was only
    caught by reading the stored data.
    Now a field is replaced when it is empty OR still equal to what the previously
    picked node put there. Values the user typed themselves are still left alone,
    which was the point of the original guard.
    Claude-Session: https://claude.ai/code/session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
2026-09-01 Capture: don't leak audio streams when one device fails to open
    The InputStreams were built in a list comprehension before the try block, so if
    any one device was unavailable the comprehension aborted and every stream opened
    before it was never closed. Those handles keep holding their ALSA devices, so
    the NEXT capture fails with the same Device unavailable [-9985] on mics that are
    physically fine — and it stays broken until the service is restarted. Seen twice
    on the rig today; the second time no mic was actually missing.
    Open inside the try and close defensively, so a partial failure releases
    everything it managed to open.
    [capture.py]
2026-09-01 Results: live polar readout for checking arc evenness
    New Live tab plus a /devices/audio/levels websocket that opens every configured
    mic at once and streams broadband RMS at ~10 Hz. Built for the job Adam asked
    for: put a uniform source at the rig and confirm the arc reads evenly.
    A uniform source should draw a circle, so the shape is not the answer - the
    spread is. The tab surfaces max-min, the median, an outlier count against an
    adjustable tolerance, and a per-mic table of deviation from the median, sorted
    by elevation. Median rather than mean so one bad mic cannot drag the reference.
    Levels are scalar-calibrated to dB SPL where a Sens Factor exists (same
    convention as the FFT path); th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
    [devices.py]
2026-09-01 Live polar: power-domain exponential averaging
    A single ~100 ms block per frame is too noisy to read a spread off. Added an
    EMA with a selectable time constant (0.5 / 3 / 10 / 30 s), defaulting to 3 s.
    Averaged in linear power, not in dB. Averaging dB under-weights the loud
    moments, and the bias grows with how much a mic fluctuates - so it would invent
    between-mic differences, which is exactly what this tab measures. With 6 dB of
    fluctuation the two differ by ~4 dB.
    Alpha is derived from the real frame interval rather than an assumed 10 Hz, so
    the time constant holds if frames stutter. A settling notice covers the first
    3 tau, since the spread is not trustworthy before the average converge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
2026-09-01 Docs: anechoic-chamber simulation review, plus a one-page PDF summary
    Stage 1 of the chamber question: what simulating an anechoic chamber
    actually buys, and which failures it can and cannot see. The decisive
    result is that chamber qualification is signal-dependent — Nash (ICA
    2019) had a chamber pass on one-third-octave noise and fail on tones at
    the same band centres. Drone noise is tonal, so a chamber qualified with
    noise is not qualified for this rig, and neither is a model excited with
    noise.
    Also relevant to the arc specifically: ISO 5305:2024 requires ISO 26101-1
    qualification along the measurement directions defined by the microphone
    positions, and chamber deviation is direction-d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
2026-09-01 Docs: companion review on locating reflections, not just detecting them
    A divergence-loss traverse says a chamber fails and roughly along which of
    five directions. It cannot say which surface is responsible, and you
    cannot treat a direction. This is the ladder that closes that gap —
    reflectogram, image-source trilateration, spherical arrays, and the
    blanket test that is the only step producing a fact rather than a
    hypothesis. Also covers ISO 26101-2:2024, the half of the standard that
    handles "the room is not anechoic and cannot be made so": measure K2,
    report it, correct for it.
    Two results for our rig fall out of the geometry:
    - The UMIK arc cannot beamform. trigger_sync aligns on 128-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
2026-09-01 Setup: a preset load repairs stale mic rows instead of preserving them
    Loading a preset carried the in-browser binding over the preset's for every
    mic, so a row whose card had vanished stayed broken no matter how many times
    you loaded - and MicList nulls such a row's deviceIndex on every render, so it
    could not be recovered by loading at all. That silently dropped mics from
    captures and from the live readout.
    The saved preset now wins wherever it carries a binding; prior bindings still
    fill entries the preset has none for, which was the original point of the
    carry-over.
2026-09-01 Papers: pending-fetch list, and correct the SDM limitations citation
    Adam is pulling the paywalled papers through a university proxy, so the
    list moves out of the review ledgers into papers/TODO-downloads.md where
    it can be worked through: priority order, what claim each one is holding
    up, and which directory it lands in. Every claim tagged with an open
    circle in the two reviews is a promise to go back and verify once the
    text is in hand; the file records that duty explicitly, including that
    the one-pager PDF is derived and must be re-rendered after the review is
    corrected rather than alongside it.
    Also records which retrieval routes work and which are dead ends, so a
    later session doesn't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
2026-09-02 Setup: tap-to-identify wizard for the mic arc
    Every UMIK-2 reports USB serial 00000, so the only ground truth for which mic
    sits at which elevation is which one moves when you tap it. Today that guess
    was wrong twice, and a wrong guess silently applies another mic's response
    curve to an elevation.
    Walks the configured elevations high to low, arms, and watches every present
    device over the levels websocket. A tap must clear 12 dB over that mic's own
    rolling-median baseline AND beat the runner-up by 6 dB, so one tap picks one
    mic and room noise does not trigger it.
    Streams all devices rather than the saved rows, so it can rebuild a mapping
    from scratch instead of being misled by a preset tha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
2026-09-02 Setup: show every mic's level at once instead of a tap wizard
    The step-by-step wizard was the wrong shape - identifying the arc means seeing
    all mics together, tapping one, and spotting which row moves. Replaced it with
    a live board: one row per present device, level bar, and a 1.5s peak hold so a
    tap is still visible after you look up from the mic.
    Lists every device, including ones no mic row is bound to, so a mic assigned to
    the wrong elevation shows up as the wrong row lighting. Each row has an assign
    dropdown, which writes deviceIndex and alsaCardId together - the only path that
    survives MicList's reconcile pass.
    Removes MicIdentifyWizard.
2026-09-02 Setup: drop the loudest-mic highlight from the level board
    Picking a 'loudest' row and colouring it added visual noise for no benefit -
    which bar jumped is obvious from the bars themselves, and the highlight flicked
    between rows on room noise between taps.
2026-09-02 Keys: list oldest measurement first, not alphabetically
    Directory order interleaved sessions - the July baseline sat between two
    August horizontal sets purely because of how the slug sorts, and the set you
    had just captured was buried mid-list. Ordering by each key's earliest
    measurement makes the picker read as a campaign timeline.
    Measurement directory names start with the capture time, so the earliest is
    the minimum name - no files are opened. Keys with no measurements sort last:
    they are slots waiting to be filled, not history.
2026-09-02 Calibration: subtract the mic response curve, don't add it
    The cal file's dB column is the microphone's own gain response, not a
    correction to apply. REW, whose format this is, states it plainly: it 'should
    contain the actual gain (and optionally phase) response of the meter or
    microphone at the frequencies given, these will then be subtracted from
    subsequent measurements'. miniDSP say the same for the UMIK. The curve's shape
    agrees - ~0 dB at 1 kHz and negative at both extremes, which is a capsule
    rolling off; a correction curve for such a mic would be positive there.
    We were adding it, which doubles the mic's coloration instead of removing it.
    On the real 11-mic set over 100 Hz-10 kHz tha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
    [calibration.py, test_fft.py]
2026-09-07 Docs: chamber-problems brief — how anechoic-chamber artefacts read in data
    Six-page PDF (HTML source alongside) derived from a new papers/chamber-problems
    set: 26 papers read at source on standing waves, direct/reflected interference,
    qualification-method dependence, ground reflection, recirculation, shear layers,
    and the fixes in use (wedge design, placement, K2, gating, meshes, active
    absorption). Structured extracts and retrieval logs are tracked so the ledger
    can be audited; PDFs/txt stay local per .gitignore.
    Also files the eight core chamber papers that landed in papers/ root
    (Bonfiglio, Cunefare, Schneider, Jiang, Vorländer, Brinkmann, Sun, Mabande)
    into their sets and ticks them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
2026-09-07 Brief rev 2: seven more chamber papers read at source
    Adam fetched Singh 2020, Garg 2019, Ma 2022, UCMAR 2019, Jenny & Anderson
    2011, Palchikovskiy 2016 and the English Belyaev 2015 via proxy. All promoted
    from abstract-only to read-at-source; the brief now quotes Singh's
    below-cut-off slopes (0.1-0.3 dB/doubling at 100 Hz), notes the formula was
    validated on a single chamber, adds Garg's 10 cm working space at 125 Hz,
    Palchikovskiy's tonal-2 m / broadband-3 m radii, Ma's cavity-mode limit on
    active absorption and UCMAR's refraction distortion. 33 papers now held.
2026-09-07 Review: re-check anechoic-simulation claims against the full texts
    Every abstract-tier claim in docs/anechoic-simulation.html re-verified against
    the eight core papers now held (Bonfiglio, Schneider, Jiang, Cunefare, Singh,
    Wang & Tang, Vorländer, Brinkmann), following the source_verification_agent
    protocol from the academic-research-skills deep-research skill. One correction:
    the card-12 round-robin figures (±5 dB on sound strength, >50 % differences
    where modal density is low) are not in Brinkmann 2019 and are withdrawn in
    favour of what the paper says. Singh's cut-off formula now carries its
    single-chamber caveat; Schneider, Jiang and Bonfiglio findings added as
    read-at-source evidence.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
2026-09-07 Docs: chamber literature synthesis (deep-research lit-review mode)
    Graded evidence matrix over all 69 held sources (three MATRIX-3W.md files
    with WHY/HOW/WHAT rows and page-referenced quotes), convergence per theme
    using the skill's strength rule, a cross-paper tension inventory with
    resolutions, seven knowledge gaps, and evidence-graded recommendations for
    the arc rig. Follows the academic-research-skills deep-research lit-review
    protocol (bibliography -> source verification -> synthesis).
2026-09-07 Papers: canonical Author_Year_Venue filenames + bibliography from the PDFs themselves
    Every one of the 69 held PDFs was opened and identified from its own front
    matter; files and text extracts renamed accordingly and all references in the
    extracts, matrices, retrieval logs and docs updated. papers/BIBLIOGRAPHY.md
    records the citation as printed. Corrections: Tervo is JAES 2013 not 2012; the
    Kim file is ICSV28 not Quiet Drones; the Schmal 'internoise2023' file is a
    different paper that cites Inter-Noise 2023; Singh's first author prints as
    'Singh K Sushil'; ultrasonic qualification is Jenny & Anderson.
2026-09-07 Audit pass: 69 papers re-identified and re-read, 27 corrections, and the story
    Second iteration as asked: every PDF opened and titled from its own front
    matter; five auditors checked every number, quote and page reference in the
    extracts, matrices and docs against the text (papers/AUDIT-1..5.md). The 27
    corrections are logged in papers/ERRATA.md and applied to the brief (rev 3),
    the synthesis (rev 2), the simulation review, its one-pager and the
    reflection-localization review. Notable: the NPL 1977/2003 error figures were
    reversed; the 15-30 dB recirculation jump was wrongly credited to Nardari and
    Whelchel; Jawahar's 24 mm foam is 75PPI-T; the held Beranek document is the
    1945 OSRD report;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
2026-09-07 Arc validation: error map from the horizontal-prop runs + small-chamber literature
    scripts/arc_error_map.py separates run gain, physical-position pattern and
    per-mic offset by least squares over the Sept 2026 horizontal-prop runs (mic
    swap prop10->11, arc rotated 180 deg in prop11-14). Mic 811-1892 is 2-6 dB low
    below 2 kHz after calibration (calibration file mismatch, raw is ~1 dB low);
    the room adds +/-3-8 dB at +/-36/54/72 deg in the 200-250, 630-1000 and 3150
    Hz bands only, flat above 4 kHz. Six small-chamber papers fetched and
    extracted (papers/small-chamber), incl. Rajmane & Baumann's reflector-size and
    time-lag localisation method.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
    [arc-error-map-third-octave.csv, mic-offsets-third-octave.csv]
2026-09-07 Docs: interactive arc-validation guide
    Self-contained HTML (no external libs): expected circle vs measured polar
    per third-octave, the 811-1892 mic offset with a correction toggle, the four
    flipped runs (prop11-14) with mirror view and rename table, the room error map
    as heat map and polar, and a two-run explorer with mic-offset / orientation /
    calibration toggles. Data pack embedded from docs/analysis/arc-validation-data.json.
    Claude-Session: https://claude.ai/code/session_01TRYVtfEUWUq2QFCAXCBAEY
2026-09-07 Docs: one-page A4 chamber findings from the arc validation
    Static, print-ready: room error polars at 250/800/3150/6300 Hz, the arc
    error map, and the same two positions across twelve runs and three mics;
    findings, where it points, and the loudspeaker burst test to name the reflector.
    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
2026-09-07 Arc validation: plain-language one-pager, figures labelled with their source captures
    The floor/ceiling asymmetry was described as 'above and below the prop
    plane', which is wrong: the arc lies in the prop plane, the asymmetry is
    between the floor-side and ceiling-side halves of the arc. Fixed in the
    one-pager, guide, analysis README and CLAUDE.md. Every figure and every
    polar in the guide now names the keys and capture ids it was computed
    from, so the measurements can be found again. Text rewritten in simple
    terms.
    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
2026-09-07 Arc validation: the 'horizontal' runs had the arc laid flat, prop axis vertical
    All mics at one height in the prop plane, so floor and ceiling act the
    same on every mic and the one-sided pattern points to a wall, corner or
    object beside the rig on the -angle side. Earlier wording had the prop
    turned instead of the arc.
    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
2026-09-08 One-pager: 'Where it points' becomes a three-item list of what to look for in the chamber
    Claude-Session: https://claude.ai/code/session_01VXsR3VrWjSzMBd5X6mBiR8
2026-09-08 Arc validation: remedies report, tone/broadband diagnostics, literature campaign
    The one-pager's 'room bends the polar by 8 dB' is true for the blade tones only:
    with tones notched, the broadband polar is round to ±1.3 dB in 92 % of cells
    from 125 Hz to 8 kHz. The tone pattern changes completely between BPF 216, 238
    and 258 Hz while the floor beside the tone stays flat, so the 200–260 Hz error
    is either narrow room modes or a non-axisymmetric inflow — decided by a
    loudspeaker at the hub, not by more propeller runs. Two fixed reflectors
    (extra path 1.5 m at +36/+54°, 0.7 m at −72°) explain 630–1000 Hz.
    - scripts/arc_validation_diagnostics.py: all five PWM steps, BPF from audio,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
    [remedies-broadband-position-map-allpwm.csv, remedies-broadband-position-se-allpwm.csv, remedies-mic-offsets-pwm1900.csv, remedies-mic-offsets-se-pwm1900.csv, remedies-thirdoct-position-map-allpwm.csv, remedies-thirdoct-position-se-pwm1900.csv, remedies-tone-probe-map.csv]
2026-09-08 Arc validation: ring diameter 1.68 m, upward-blowing stand-in-inflow orientation, prop7 explained by supply current limit
    Adam's answers of 2026-09-08 recorded in docs/mic_arc.md and the remedies
    report: capsules at r ≈ 0.84 m (the +36/+54° reflector is a surface ~0.75 m
    behind those mics); the propeller blew upward away from the Tyto, so the stand
    sits in the inflow (Problem 8); telemetry shows prop7 at 8 V / half current,
    i.e. the bench supply was current-limiting, and prop18's PWM-2000 step simply
    did not spin up.
    Claude-Session: https://claude.ai/code/session_01FTn9sdb3DiHxnYF8g3K9Le
2026-09-08 Papers move to the private papers repo; report gains the Bristol ground-effect and cepstrum primary sources
    papers/ and docs/references/ are now symlinks into ../papers/SoundVisualizer
    (github.com/asdfgh0318/papers, private); the notes that were tracked here
    (EXTRACTS, RETRIEVAL, AUDIT, BIBLIOGRAPHY, PROTOCOL) moved with the PDFs.
    Report: Problem 9 gets Hanson, Kamliya Jawahar, Vemuri & Azarpeyvand 2023
    (23-mic arc with a rigid plate: broadband reflection zone independent of plate
    distance, aerodynamic harmonics fading by 2–4 radii, in-plane mic least
    affected); Problem 10 gets Vesa 2020 as a cautionary small chamber; Problem 7
    gets Childers 1977 and Randall 2017 as the primary cepstrum s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
2026-09-09 Trigger sync: never crop a source that was already running (closes #13); one-pager: not a verdict against everything below 4 kHz
    align_captures cropped every mic to the tail after the latest trigger when the
    motor was already running and one quiet mic crossed -40 dBFS only at a late
    transient; that is why nine PWM-1800 captures of the Sept runs are 0.16-1.08 s.
    Alignment now applies only to a genuine onset (all mics triggered, none in
    block 0, spread <= 0.1 s); otherwise the captures pass through untouched.
    The one-pager headline and the 'white above 4 kHz' card now say that broadband
    directivity is usable from 125 Hz up and only the blade-tone levels below ~1 kHz
    need the loudspeaker check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
2026-09-09 Tone/broadband split: BPF from the audio, per-harmonic tone levels, tone-notched bands, off-speed flags, Polar level source (closes #12)
    The arc validation showed the room bends the blade tones by up to 8 dB while
    the tone-notched broadband polar stays round; the app's mixed-band polar hid
    that, and with no RPM channel nothing flagged a run at the wrong speed.
    - server/core/tones.py: blade-passage frequency from a capture's spectrum
    (peak in 100-320 Hz with 2nd/3rd harmonics), tone level per harmonic,
    third-octaves with every multiple of BPF/2 notched; synthetic-signal tests
    - /fft returns bpf_hz, tones[], band_centres_hz, broadband_bands_db (16384-pt
    Welch for the low bands); the orc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
    [capture_orchestrator.py, results.py, schemas.py, test_results_api.py, test_tones.py, tones.py]
2026-09-09 Polar: warn when the compared captures spin at different blade-passage frequencies
    Within one key the pwm_points flag catches an off-speed capture; across keys
    (prop7 vs the rest) the only place the mismatch is visible is the compare
    overlay, so the level-source bar now says so when the BPFs differ by >3 %.
    Claude-Session: https://claude.ai/code/session_012QHtRppxyhsVsKqSF5Vz8w
2026-09-09 One-pager: title it as an overview, not a verdict
    The headline sentence read like a conclusion on its own. It moves into the
    standfirst, so the page is named for what it is: an overview of the chamber
    problem, with the finding as the first line of the summary.
    Claude-Session: https://claude.ai/code/session_012QHtRppxyhsVcKqSF5Vz8w
2026-09-09 Arc validation: stop calling the broadband polar clean from 125 Hz
    The one-pager's headline read as "no error below 3 kHz once the tones are
    notched", which the heatmap on the same page contradicts. Re-audited the
    position maps: the notched residual is ±1.3 dB in 92 % of cells but 99 of the
    209 cells are more than three standard errors from the circle, and it is no
    smaller above 3 kHz (92.7 % within 1.3 dB) than below it (92.2 %). So it is
    two errors — the tones, up to 8 dB below 1 kHz, on a broadband floor of
    ±1-3 dB present in every band — and the arc is qualified nowhere yet.
    Claude-Session: https://claude.ai/code/s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
2026-09-09 Hub source options for the loudspeaker session, priced and verified
    Session 2 of the campaign needs a source at the propeller hub. Records the
    requirements our own captures impose (60 dB at 0.84 m is enough, 10-20 cm,
    omni to 1 kHz, sealed), and the three routes with vendor-page-verified specs
    and Polish prices: borrow a B&K OmniSource 4295 from PW electroacoustics,
    buy an Avantone MixCube, or build a Visaton FRS 8 M into a 1 l sealed box.
    Also records that no sweep or deconvolution tooling exists yet.
2026-09-11 Hub source: build sheet for the 1 l sealed cube
    Cut list, cutout, chamfer and mounting orientation for the Visaton build, plus
    the two qualification sweeps that must pass before the box is trusted. The
    driver fires up the rig axis so its directivity lands in the run-gain term and
    cancels out of the position map.
    Claude-Session: https://claude.ai/code/session_014dUjQAwZ2BSYJnWGYaCSDT
2026-09-11 One-pager for the hub source: the box, the numbers, the order of work
    A single screen-and-print sheet for the loudspeaker session: why a single
    driver is allowed (the arc samples one polar angle, so source directivity
    lands in the run-gain term), the cut list, and four figures generated from
    the driver's datasheet parameters and our September captures. Figure 4 is
    the honest one: the box is only 30 dB down at 4.3 ms, so the 1.5 m echo has
    to be read band-limited above 400 Hz.
    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
2026-09-11 UI pass: Intro landing page, RCbenchmark wording, parameter help, no fake capture, Key→Base, mic-arc schematic, polar zoom reset
    The app now opens on an Intro page (what/for whom/flow/project + funding
    placeholders/GitHub link; text in src/content/projectInfo.ts). Stand
    controls use the words RCbenchmark users know: Tare, ESC signal (µs),
    safety cutoffs; a measurement is a capture, not a run. Every settable
    parameter has a ⓘ InfoToggle (texts in src/content/parameterHelp.ts).
    The wizard's fake-capture path is gone (the /dev endpoints stay for
    curl). "Key" is "Base" in the UI. The polar plot gets a side-view
    schematic of the configured mic arc, scroll/drag zoom, a Reset-view
    button and a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
2026-09-11 Chamber-landscape campaign: a working guide to fighting the chamber
    The one-pager is about our room only; Adam asked for the world's practice.
    Seven research threads read 25 named facilities in 15 countries at source,
    plus qualification practice, the alternatives to a chamber, the low-frequency
    wall, rig and inflow effects, low-cost builds and the standards landscape.
    The guide is decision-shaped: a ten-row methods menu with the lowest usable
    frequency, residual error, cost and failure mode of each, then our programme
    in order. Two computed results decide the recommendation. Time gating is
    capped at 500 Hz in our room by the measured 1.98 ms echo, so it cannot
    answer the 238 Hz question. A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
2026-09-11 Guide: correct the Africa gap, and name the one non-chamber facility
    I wrote that Africa was absent from the inventory while citing a South
    African facility two sections earlier. The accurate gap is narrower: no
    small-rotor facility was found in Africa, South America or Australia. The
    Stellenbosch fan rig is also worth calling out on its own terms, since it
    is the only entry that fixed its room by measuring and correcting it
    rather than rebuilding it, which is the method we propose to copy.
    Claude-Session: https://claude.ai/code/session_011iq7xBRSo7rESQcWvATxZ9
2026-09-11 Guide: fold in the threads' final passes
    The inventory closed at 29 facilities in 17 countries, not 25 in 15. Three
    additions earn their place: the American fan standard qualifies a room by a
    different statistic entirely, so "qualified" is not one idea; a Swedish
    chamber that cannot meet ISO 3745's prerequisites publishes its uncertainty
    instead, including what halving the microphone count costs, which is the
    most directly useful precedent found for an eleven-microphone arc; and the
    missing round robin is now a confirmed absence rather than a search that ran
    out of time.
    94 of 94 literature quotes verified verbatim.
    Claude-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
2026-09-11 Record the fit degeneracy and its fix across all three documents
    Checking whether known microphone calibration would help turned up a hole in
    the arc-error-map analysis. The position and microphone terms are separable
    only where a microphone visited both positions, and ours only ever visited
    five disconnected clusters, so four directions of the fit are undetermined
    and lstsq settles them by minimum norm. Verified on the data: shifting the
    ±36 positions by +1 dB and their two serials by -1 dB leaves the residual
    identical. Contrasts inside a cluster hold, which covers the largest
    broadband feature and the whole speed-dependence result; comparisons across
    clusters carry an unmeasured offset o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
2026-09-11 Calibration geometry decided: normal incidence, arc clamps on
    Adam's call, and it matches what the rig already assumes: mic_arc.md records
    that the arc mics point at the source and that the on-axis calibration file
    is therefore the right one, and load_mic_arc.py defaults to it. Doing the
    substitution calibration at the same normal incidence means one curve per
    capsule is valid in the flat arc and the vertical arc alike, which removes
    the caveat the guide carried.
    Two conditions follow and are now written down. Aiming tolerance is generous,
    since the two supplied files differ only above a few kHz. But each capsule
    must wear its own arc clamp and grid during calibration, because the
    qualifica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
2026-09-11 Self-audit of every number our documents take from our own data
    Forty checks, recomputed from the source CSVs and the data pack and compared
    against what each document prints. One failed and is now fixed: I had called
    a 9.3 dB contrast the largest broadband feature, but that number came from
    the mixed-band fit. The tone-notched value for that pair at 794 Hz is
    2.87 dB, and the largest broadband within-group contrast is 4.3 dB at 397 Hz.
    The point it supported survives and is stronger, because the biggest feature
    on the one-pager's map, the 250 Hz hole at plus and minus 36 degrees, is
    12.5 dB and sits inside one cluster, so the degeneracy does not touch it.
    The audit is a script rather than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
2026-09-11 Hub source: record the parts Adam chose, and the three ways to get it wrong
    UCA202 plus a TPA3116 board plus the Visaton driver. The interface is the
    part that matters: it replaces the laptop headphone output, so the unknown
    source impedance that would have raised the box Qtc and lengthened its ring
    is no longer a concern. Still missing a DC supply for the amplifier.
    Also recorded why the cheapness is not a compromise (the source chain cancels
    in both measurements) and the one mistake that could damage hardware: the
    amplifier output is bridge-tied, so it must never be looped back into the
    interface inputs.
2026-09-14 Results: the overlay base picker was too narrow to show which capture it was
    Reported by Przemyslaw Kornatowski: in Compare bases (overlay) every
    horizontal-ring base rendered as "2004 - 6in" with the end cut off, so the
    twenty-odd captures of the same motor and propeller could not be told apart,
    while the main base picker showed them in full.
    It was not a missing field. The label already included the notes; the select
    was w-56, which fits "2004 - 6in" plus a short shroud and clips everything
    after it. Short notes like "felt" and "xps" survived, the long
    "dp1-baseline-horizontal-propN" did not. Widened to min-w-[24rem], the same
    class the working picker uses.
    Both pickers now build their t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
2026-09-14 Arc mark: say flat vs normal, not upright vs flipped
    Adam's correction, and he is right: none of these captures were upright. The
    store holds two different rig geometries. The dp1 material study has the arc
    standing normally, with the microphones genuinely at different elevations.
    The September validation captures have it laid flat, propeller axis vertical,
    all eleven microphones at one height around the axis. Marking only the turn
    conflated the two, because an unmarked base could have meant either.
    Four states now: no mark for the normal arc, H for laid flat in the reference
    orientation, H F for laid flat and turned 180 degrees, H ? for laid flat with
    the orientation never recovered. The f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
2026-09-14 Explain the level source, which is the control that needs it most
    The Mixed band / Broadband / BPF buttons decide which number the polar is
    drawn from, and nothing on screen said what the difference was or which to
    trust. That is the one control where picking the obvious default quietly
    hides the finding the whole validation campaign is about.
    The popup says a rotor makes two kinds of noise and the room treats them
    differently, defines the three sources, and gives the reason it matters: the
    room bent the blade tones by up to 8 dB between 200 and 260 Hz while the
    tone-notched broadband beside them stayed inside 1.3 dB. So read broadband as
    the trustworthy curve and treat tone levels below ab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
2026-09-14 Make the docs say what the code does, after a six-way repo audit
    Six parallel audits compared every prose claim in the repo against the code
    that is supposed to back it. The claims that did not survive:
    - README's backup section still told you to force a mirror with
    `ssh jama ~/SoundVisualizer/scripts/backup_data.sh`. Backups moved to the
    laptop on 2026-09-02 and the Pi script now exits on sight of a marker file,
    so that command silently did nothing. It now describes
    `backup_from_laptop.sh`, why it moved, and the env overrides.
    - "Settings popover for window/size/overlap" (README, PLAN, overview) — it is
    an inline bar, and the window is fixed Hann, not a control.
    - PLAN and scri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
    [load_mic_arc.py, schemas.py, tones.py]
2026-09-14 Pin the polar plot's orientation so a stray drag cannot mirror it
    Adam's screenshot showed the radial tick labels ("40 dB SPL", "60 dB SPL")
    rendered upside down, with the axis lying to the left of centre. Reproduced in
    an isolated Plotly harness: it is `polar.radialaxis.angle` moved to ~180.
    Plotly builds four draggers on a polar subplot. The rim one ("angulardrag")
    rotates the whole subplot, and the radial ones can swing the radial axis to a
    new angle — verified by driving synthetic drags and reading `_fullLayout` back
    (a rim drag took `angularaxis.rotation` 0 -> 49). Neither is meaningful here:
    elevation is mapped to the clock face (+90° up, 0° right, −90° down) and the
    tick text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
2026-09-15 Tell people to pass --build, because plain `docker compose up` serves a stale image
    Paweł pulled, ran `docker compose up`, and got a build with no Intro page.
    The image itself was never the problem — verified by running the current
    soundvisualizer:latest and grepping the served bundle: Intro, the ESC-signal
    wording and the new pinPolarOrientation guard are all in it.
    The cause is docker-compose.yml pinning `image: soundvisualizer:latest`
    alongside `build: .`. Compose builds only when no image of that name exists,
    so anyone who has ever run the demo before keeps getting their first build
    back, silently, however recently they pulled. Both READMEs and CLAUDE.md said
    plain `docker compose up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
2026-09-15 Model the hub source as a printable sealed sphere, and size its supply
    Parametric OpenSCAD model for the session-2 hub loudspeaker: 1 litre net sealed
    sphere around the Visaton FRS 8 M, 5 mm wall, split at the equator on a spigot,
    M6 mount pad, driver firing up the rig axis.
    Sealed rather than vented because a port is a second source, displaced and
    ringing, and the whole method reads echo arrival times off each mic's impulse
    response — 1.98 ms at -72 deg, 4.37 ms at +36/+54 deg. Spherical because the
    enclosure is printed: a doubly-curved shell is much stiffer than flat panels of
    the same thickness, which is where printed boxes fail, and it has no edges to
    diffract.
    The model solves for i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
    [hub-sphere.scad]
2026-09-15 One-piece printed sphere, sized to the FRS 8 M's real frame
    Adam asked for a single part whose only opening is the driver cutout, printed on
    that flat. That is now part="onepiece": no equator split, no glue line, nothing
    to seal but the gasket and the cable hole.
    Two things the new orientation forced, neither cosmetic:
    - The apex boss became a CONE. Printed flat-face-down the apex is the highest
    point, so a cylindrical boss would have hung its entire 26 mm underside in
    mid-air over the cavity — an unsupported island. A cone widens as it rises and
    carries itself, and the M6 insert still lands in solid material.
    - The cable hole moved to the side wall, where the wall is vertical and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
    [hub-sphere.scad]
2026-09-15 Give the driver something to screw into, and stop the screws leaking
    Two defects found while enumerating the holes, both would have survived to the
    printed part.
    The cavity is a sphere, so where the seating plane cuts it the opening is
    83.4 mm across — WIDER than the 75 mm bore, because the bore is not what limits
    it there. The seating face was therefore a 7.3 mm rim, not the 11.5 mm the flat
    diameter suggests, and the four screws on the datasheet's 83 mm bolt circle came
    down at radius 41.5 against a cavity edge at 41.74: in open air, with nothing to
    bite. driver_land() now fills the ring from the bore out to the wall over 8 mm,
    restoring a full-width face and giving the screws material.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
    [hub-sphere.scad]
2026-09-15 Calibrator: single-mic substitution-capture library for session 2b
    The remedies-report session 2b needs one capsule in one seat while a
    tone plays; the whole tool is play, capture, write. Identity is the
    connection (exactly-one UMIK rule), so no serials, no CLI, no session
    protocol. Both USB feature-unit mixers are device-firmware state that
    WirePlumber can rewrite (the PCM2902 interface shipped at -23 dB), so
    both are gated at 0 dB before every capture, read-only.
    Closes #21
2026-09-15 Pin acquire_speaker to the PCM2902 USB ID
    The name 'USB Audio CODEC' is a generic chip string any dongle can
    share and the 'any USB output' rule breaks the moment a second USB
    audio device is plugged in (the UMIK is always one). The vendor:product
    pair 08bb:2902 pins it to our interface wherever it is plugged;
    SPEAKER_USB_ID is exported and index= remains the escape hatch.
    Refs #21
2026-09-15 Calibrator: octave step series, 200 Hz to 15 kHz
    One take_sample_at_frequency per octave step via itertools.accumulate;
    kwargs pass straight through. Live run: all 7 steps (200-12800 Hz)
    captured and saved; at this drive the 200/400 Hz tones sit only 5-7 dB
    above the room floor, the rest 16-22 dB.
    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
2026-09-15 Gitignore calibrator/fft chart output
2026-09-15 Generate the calibration tone inside the PortAudio callback
    sd.play(loop=True) feeds PortAudio from a ring-buffer thread; behind the
    dock's full-speed hub that path dropped 2-22 ms bursts of tone, 20-80
    per capture - the tone was on the air ~90% of the time, which is why the
    FFT peaks sat 50 dB below where they belong and the band rms was 38 dB
    above the tone. Generating the sine inline in the callback removes the
    thing that can starve: measured 0 underflows, tone peaks up 42-59 dB,
    SNR 54-98 dB at every octave step, zero slope outliers. A 30 ms capture
    head is trimmed as stream-open insurance.
    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
2026-09-15 Calibrator: per-capture tone stability gate
    assert_tone_stable(sample, freq) proves a capture is worth keeping: the
    tone must stand 10 dB above the adjacent floor (dead mics and silent
    speakers do not pass as perfectly stable silence), and its level and
    frequency must hold across 0.25 s chunks. Verified on real data: the
    old sd.play captures fail it naming the broken chunks, the
    inline-callback captures pass with <2 dB and 0 Hz deviation.
    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
2026-09-15 Calibrator: full-curve session capture and postprocessing
    capture_capsule records one capsule's whole stepped-tone curve per call
    (1/3-octave 63 Hz-16 kHz, longer LF captures, gate failures recorded not
    fatal, repeat labels form the reference bracket); relative_curves turns
    sessions into per-capsule difference curves vs the reference with the
    bracket drift reported; merge_curve folds a difference into the factory
    REW file (gain += diff, Sens Factor verbatim). Also fixes a false alarm
    in assert_tone_stable: the chunk FFT quantizes low-frequency peaks to
    1/chunk_s bins, which alone exceeded the 1% tolerance at 63 Hz - the
    tolerance now has a 1.5-bin floor.
    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
2026-09-15 Gitignore calibrator session WAVs
2026-09-15 Calibrator: thin CLI over the library
    python -m calibrator devices | capture <label> | process --ref <label>.
    cli.py is wiring only - every command just calls the library and
    prints; session discipline (labels, brackets, out dirs) stays with the
    operator. Verified end-to-end: two untouched-rig captures agree within
    0.05-0.17 dB per frequency.
    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
2026-09-15 Calibrator: denser log-spaced tone grids via --per-octave
    log_series() builds the IEC-61260 base-2 grid anchored at 1 kHz
    (62, 70, 79 ... Hz); --per-octave N on capture switches to it
    (6 = 49 points ~3 min per capsule, 12 = 97 ~6 min). One grid per
    session: relative_curves matches exact frequency keys and the log
    grid does not repeat the preferred 1/3-octave roundings.
    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
2026-09-15 Calibrator: --fmin/--fmax bounds on the capture grid
    Either grid (preferred 1/3-octave or the IEC log series) can now be
    bounded; --freqs stays the explicit escape hatch and errors if mixed
    with bounds. Verified live on an 800-3150 Hz band capture - which also
    caught the rig itself going silent, so every point failed its gate
    honestly and the run recorded the failures without dying.
    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
2026-09-17 Apply the substitution measurement to the cal files, and fix an empty-band crash
    apply_corrections.py folds the 2026-09-16 session into the eleven UMIK cal files:
    datum is the four capsules whose files agree with each other and with measurement,
    the correction goes entirely into gain_db, every Sens Factor is kept verbatim, and
    the factory originals are copied to a dated backup the tool refuses to overwrite.
    Acceptance test: the spread across the eleven in the SPL they report, fed back
    through the server's own calibration code, falls from 4.01 dB to 0.02 dB. The
    corrected files are committed in the data repo.
    core.py: assert_tone_stable selected the chunk-FFT tone band with a flat +/-3%
    wind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
2026-09-17 Record the substitution-calibration session in the locked decisions
    Seven of eleven factory cal files were wrong by 0.6-3.6 dB; the eleven are now
    mutually consistent to 0.02 dB. Also sharpens the 811-1892 line: re-calibrated,
    not retired -- its capsule is flat, only the certificate was wrong.
2026-09-17 Refit the arc without a microphone term, and republish on it
    The substitution session measured every capsule, so the fit no longer has to
    estimate them. arc_error_map.py and arc_validation_diagnostics.py take
    --no-mic-term, which drops the microphone block entirely: the design goes from
    34 parameters to 23, the five disconnected position/serial clusters vanish, and
    the position map is determined up to a single overall offset. That is what §15
    predicted would happen once M was known, and it needed no new captures.
    Acceptance test: dropping eleven free parameters costs 0.136 dB of residual
    (1.428 -> 1.564). If the corrected cal files were wrong, forcing M = 0 would have
    dumped that error int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
    [arc-error-map-third-octave.csv, mic-offsets-third-octave.csv, remedies-broadband-position-map-allpwm.csv, remedies-broadband-position-se-allpwm.csv, remedies-mic-offsets-pwm1900.csv, remedies-mic-offsets-se-pwm1900.csv, remedies-thirdoct-position-map-allpwm.csv, remedies-thirdoct-position-se-pwm1900.csv]
2026-09-17 Rewrite the degeneracy chapters around what measuring the microphones showed
    Problem 6 of the remedies report and method 3 of the fighting guide were written
    as an open problem with a proposed fix. The fix has been carried out, so both are
    rewritten as findings, and the rewrite surfaced things worth saying that neither
    document said before.
    The uncomfortable one, now stated plainly in both: an unmeasured sensor term
    FLATTERS a room map, because the fit hands the room's sins to the sensors. Our
    broadband polar was never 92 % within +/-1.3 dB; it is 84 %, and the worst cell is
    3.3 dB rather than 2.7. Nothing got worse -- we stopped crediting the microphones
    with the room's error.
    New, and it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
2026-09-17 Fig. 2: say which capsule sat where, and when it moved
    The row labels named one capsule per spot, which is wrong in two ways at once.
    prop11-14 were measured with the arc turned 180 degrees, so every capsule is
    mirrored to the opposite physical spot for those four runs; and 811-1892 and
    810-8901 were swapped outright after prop10. Most spots were therefore occupied
    by two capsules and the +72/+54 pair by three, while the label claimed one.
    Each row now reads "+72° 811-1892 · 1896 11-14 · 8901 15-18": the capsule that
    sat there in most runs, then the others with the run numbers where they did. The
    caption says why - the turn and the one swap - so the left panel cannot be read as
    a proper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
    [build_brief_fig2.py]
2026-09-17 Stepped tones through the whole arc, to see what the rig does to itself
    The substitution session that fixed the capsules was run with the chamber
    cleared -- one capsule, one speaker, nothing else. So it cannot see anything the
    assembled rig does to a capsule, and something clearly remains: swapping
    811-1892 and 810-8901 between +72 and +54 still leaves ~1 dB RMS unexplained
    after correction, worst -2.58 dB at 630 Hz.
    There is a geometric coincidence worth testing. Eleven capsules on the 1.68 m
    ring sit 26.3 cm apart, and half a wavelength equals that spacing at 653 Hz.
    Array self-scattering would be fixed to position -- each spot has a different
    neighbourhood -- so it lands in the position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
2026-09-17 Live identify meter, and the mains A/B that says AC is fine for tone work
    identify: a live per-capsule meter rather than a peak detector, because Adam
    would rather watch it than trust me to pick the peak. Tap a capsule and its row
    jumps; a channel more than 12 dB above its own slow baseline is flagged TAP.
    Nothing is inferred, nothing is written.
    It exists because identity is the weak link in the rig path and I had overstated
    what load_arc proves. A UMIK-2 reports USB serial 00000, so which capsule is on a
    given cable cannot be checked electronically, and nothing anywhere records which
    arc position a cable ends at -- load_arc only proves which USB PORT each stream
    comes from. With the sourc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
2026-09-17 Flip the arc and the map splits in two: half is the rig, half is the room
    Whole-arc tone grid with the sphere at the hub firing up the symmetry axis, 112
    tones over all eleven capsules, then the same again with the arc physically
    flipped. The measurement is quiet enough to make the comparison decisive:
    repeatability 0.026 dB rms, worst cell 0.20 dB, against a 4.9 dB pattern.
    If each cell is X (travels with the capsule, its clamp, its cable, its place on
    the frame) plus Y (stays in the room), then flipping the arc must change the map
    antisymmetrically. It does. Of a 2.10 dB rms change, 2.07 dB is antisymmetric and
    0.33 dB is symmetric residual -- the flip was not a perfect mirror, but nearly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
2026-09-17 Apply the mic calibrations to the rig map, and withdraw the headline it produced
    rig.py was reporting raw dBFS. The eleven capsules were bench-corrected yesterday
    and the correction was simply not in the loop, so every number from Wednesday's
    flip experiment was computed on uncalibrated levels.
    Fixed at the source: capture_rig now computes level_db_spl alongside level_dbfs
    from data/calibrations, records which serials it found in meta.json, and warns per
    missing file. read_map() is the one loader every consumer goes through -- it
    prefers the calibrated level baked in at capture time and applies the cal files
    itself for runs taken before this change, so a plot can never disagree with the
    cap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
2026-09-17 Say axisymmetric, not omni: that is the property the method needs
    Adam: "this speaker was ment to be axis symetrical not omnidirectional." Correct,
    and the distinction is the whole point of the test rather than a nicety.
    Every capsule sits at 90 degrees to the source's aim, so the method needs only
    that the radiation be rotationally symmetric about that axis -- never that it be
    omnidirectional. A single driver in a sealed sphere meets that requirement as
    long as the cone stays pistonic, which is why it was a sound choice.
    That is also what makes the 90 degree roll a clean test: rolling an axisymmetric
    radiator about its own axis cannot change the field at all, by construction. It
    changed e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
2026-09-17 "Above ~3 kHz" was the edge of my test window, not a boundary
    The roll test only covered 3.4-5.6 kHz, and the field changed by 1.3-2.9 dB rms
    at every tone in it, with no trend and already broken at the lowest one. That
    locates the onset at or below 3462 Hz and nowhere else. Quoting 3 kHz as the
    limit reported where I happened to look as though it were a measurement.
    Recorded with the numbers that bound it: ka = 1 at 1829 Hz for this driver
    (Sd = 28 cm^2, a = 29.9 mm), the tested band is ka 1.9-3.0, and we measure at 90
    degrees off-axis, where the axisymmetric m=0 lobe is weakest and an asymmetric
    component is most visible. Failure well below 3 kHz is plausible on that basis
    and has to be m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
2026-09-17 Turn the driver, not the sphere: the source is clean to 3 kHz and rocks at 4.4 kHz
    Rotating the whole sphere looked damning and was not trustworthy. A 90 degree
    roll moved the map by 1.67 dB rms, including 1.4 dB at 257 Hz where ka = 0.14 and
    rolling a source that small can do nothing at all. The control says why: two runs
    with the source untouched agree to 0.05 dB (r = +1.000), but rolling the sphere
    away and back to the SAME roll reproduces only to 1.32 dB. Handling the enclosure
    costs 1.3 dB on its own -- 56% of what I was attributing to the roll.
    Adam's experiment settles it: unbolt the driver and remount it 180 degrees inside
    a sphere that never moves, so position, aim, room coupling a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
2026-09-17 Put the sphere's bad band where it cannot be missed: in the tool, not just the docs
    3000-5000 Hz is unusable with this source -- its driver rocks (m=1, 11.0 dB at
    4362 Hz), so the arc reads the loudspeaker rather than the rig or the room. A
    paragraph in the docs would not survive contact with a future session, so it now
    lives in four places that are hard to walk past:
    - calibrator.rig.SOURCE_SUSPECT_HZ, with the measurement that established it in
    the comment beside it, and suspect_tones(freqs) to mask it in analysis
    - capture_rig prints a warning naming the count of affected tones before a grid
    that enters the band, and writes source_suspect_band_hz plus a note into every
    meta.json, s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
2026-09-23 One page instead of fifteen documents: the docs audit after the loudspeaker campaign
    Every arc-validation write-up was stale in the same place -- its central open
    question. All of them describe the loudspeaker-at-the-hub session as future work
    that "will decide" room-vs-inflow, and the remedies report still asserts the arc
    is "not qualified at any frequency". That session ran on 17 September. None of
    them contains the flip decomposition, the vertical session, |X_sym| <= 0.16 dB,
    the finding that ~0.2 dB of the position map is arc hardware and the rest is the
    room, or the source's m=1 rocking mode.
    New: docs/arc-rig-onepager.{html,pdf}. One A4 page, written from the captures --
    every number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
    [arc_validation_diagnostics.py]
2026-09-23 Both panels are the same kind of map now
    Adam: the two heatmaps were not comparable. The top was a derived quantity,
    (before + mirrored after)/2, and the bottom a single raw run, so 'the features do
    not carry over' compared two different things.
    Both panels are now raw position maps from one capture each -- full-rig and
    vertical -- same quantity, same colour scale. The comparison is what it claims to
    be, and the source's 4.3 kHz artefact is visible in both, which also shows the
    reader what the red rules are for.
2026-09-23 The one-pager's figure is the driver pair: arc vertical both times, only the driver turned
    That is the pair that shows what the page argues, and it is the cleanest thing in
    the session: enclosure in the same place pointing the same way, only the driver
    remounted 180 degrees in its own seat. The two maps are the same picture
    everywhere except between the red rules, and the effect curve underneath sits on
    the 0.05 dB floor to 550 Hz before spiking to 11 dB at 4362 Hz.
    Replaces the horizontal-vs-vertical room pair, which compared two rooms rather
    than showing the artefact, and whose first version compared a derived quantity
    against a raw run.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
2026-09-23 The one-pager is now four experiments and almost no prose
    Adam wants the bare minimum of text. The page is a headline, one figure, four
    numbers and a footer.
    The figure is the argument, one intervention per row, each changing exactly one
    thing, with the rms change and correlation beside it:
    1 nothing changed 0.03 dB r +1.00 -- the instrument is silent
    2 arc flipped, second run
    re-indexed by position 0.53 dB r +0.92 -- the pattern stayed with the room
    3 arc stood vertical 2.29 dB r -0.12 -- different room, unrecognisable map
    4 only the driver turned 0.20 dB below 3 kHz, 11.0 dB at 4362 Hz
    Row 2 is the whole result in one step and needs no decomposition: l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
2026-09-23 A rig diagram over every panel, so a stranger can follow the geometry
    Words like 'horizontal', 'flipped' and 'vertical' only mean something to someone
    who has stood next to the arc. Each of the eight panels now carries a small
    side-on diagram: grey arc and dots for the eleven capsules, a square for the +90
    end, an orange dot for the sphere with an arrow for the way it fires, and on row
    4 a tick showing the driver's roll.
    Read down the column and the experiment tells itself -- the arc lies flat, the
    +90 mark jumps to the other end, the arc stands up, then nothing moves but the
    tick on the sphere. A legend line under the subtitle says what the parts are.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
2026-09-23 Isometric room-and-tripod icons beside every map
    The flat arc glyphs said 'horizontal' or 'vertical' only to someone who already
    knew the rig. Each panel now gets a proper little 3D view on its left: the room
    as a box, the sphere on its tripod at the centre, the arc of eleven capsules in
    its actual orientation, a square on the +90 end and an arrow for the way the
    source fires. Row 4 adds a tick on the sphere for the driver's roll.
    Read down the icon column and the campaign is legible without the captions: the
    arc lying flat with the sphere firing up, the +90 mark jumping to the far side,
    the arc standing up with the sphere now firing sideways, then two identical rigs
    differing only by the t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
2026-09-23 Drop the rig icons; the panel labels say what moved
    Adam: kill the icons, keep the descriptions. Each panel label now states the
    geometry in words -- 'arc flat, sphere at the centre firing up', 'arc turned 180
    deg, read by physical position', 'arc standing, sphere firing sideways', 'same
    rig, driver remounted 180 deg' -- and the header line explains the one thing that
    makes the method work: the sphere sits at the centre of the arc and fires along
    its axis, so every capsule is the same distance away at the same angle.
    The freed column goes to the maps, which are now about a fifth wider, so the
    4.3 kHz stripe and the low-frequency structure both read at a glance.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
2026-09-23 Document the capsule calibration on the one-pager, with its parameters
    The page rested on 'per-capsule calibration applied' without saying what that
    was. It now carries the method and every parameter, all re-read from
    calibrator/sessions/2026-09-16 rather than from notes:
    substitution at one seat, cleared chamber, one capsule and one speaker
    97 tones, 62 Hz-16 kHz at 12/octave, amplitude 0.03, 48 kHz
    2 s per tone, 6 s below 250 Hz, Mic Capture Volume gated at unity
    eleven captures, so all 55 pairs follow
    drift bracket 810-8904 re-measured at the end: -0.025 dB mean, 0.165 sd over
    2 h 13 min (0.09 below 1 kHz, 0.24 above 4 kHz)
    seven of eleven factory files wrong by 0.6-3.6 d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
2026-09-23 Split docs: what our chamber measured, and what is speculation about it
    Anything not tied to a capture of our own room moves to
    docs/acoustic-speculations/ -- the chamber-fighting guide (other people's rooms,
    29 facilities, every number theirs), reflection-localization (a method we have a
    real 630-1000 Hz target for and have never run), hub-source-options (we built one
    of the four and measured it only axisymmetric below 3 kHz; the rest are untested)
    and recirculation-plan (reasoning, never measured here).
    Its README says for each file how far it sits from our chamber and what would
    move it out: a capture that tests the claim in our room, with the number written
    into the one-pager.
    What sta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
2026-09-23 Chamber treatments 2026-09-23: unwrapping the tripod legs flattens 1.6-3 kHz
    Repeat floor 0.010 dB, handling ~0.04 dB, so in/out differences above ~0.1 dB
    are real. The Thinsulate roll in a corner changed 250-630 Hz by 0.34 dB without
    flattening anything, core or no core, and removing it restored the baseline.
    Unwrapping the tripod legs took 1.6-3 kHz flatness from 0.98 to 0.93 dB by
    filling in the shadowed -54 deg capsule. Blind reflector localisation failed and
    is recorded as such.
2026-09-23 Chamber treatments: unwrapping the ring costs flatness; only the first section mattered
2026-09-23 Chamber treatments: a Thinsulate floor carpet cuts room error at 250-630 Hz
    Below 3 kHz 1.408 -> 1.277 dB, the best state measured: -0.30 dB at 250-400 Hz,
    -0.16 at 400-630, nothing above 1.6 kHz. First treatment to reach the band
    where the error is largest.
2026-09-23 Chamber treatments: the carpet works on the floor, not on the ceiling
    Ceiling helps 400 Hz-1.6 kHz like the floor but worsens 250-400 Hz (2.04 -> 2.29 dB);
    overall 1.431 dB vs 1.277 on the floor.
2026-09-24 Chamber treatments day 2: overnight drift, and felt on the floor
    Untouched overnight the map moves 0.16 dB but flatness only 0.007 dB. A 2 cm felt
    carpet on the floor (Thinsulate on the ceiling) changes the map 1.10 dB and makes
    it worse overall, 1.424 -> 1.457. Scripts now read runs from any day; grid saved.
2026-09-24 Chamber treatments day 2: felt alone on the floor is the worst state measured
    1.512 dB below 3 kHz, worse than the bare room (1.408) from 400 Hz to 3 kHz.
2026-09-24 Chamber treatments day 2: bare room reproduces yesterday to 0.008 dB
2026-09-24 Chamber treatments day 2: removing the floor wedges takes room error 1.40 -> 2.05 dB
2026-09-24 Chamber treatments day 2: a carpet on flat foam recovers ~63% of the wedges' loss
2026-09-24 Chamber treatments day 2: carpet on flat foam vs wedges only
2026-09-24 Chamber treatments day 2: a chaotic carpet beats the wedges alone (1.317 vs 1.400)
2026-09-24 Chamber treatments day 2: a second chaotic arrangement reproduces the first (1.318 vs 1.317)
2026-09-24 Chamber treatments day 2: three chaotic arrangements agree (1.317 / 1.318 / 1.324)
2026-09-24 Chamber treatments day 2: figure of the three chaotic arrangements together
2026-09-24 Chamber treatments day 2: speaker on the wall, 1.5 m out on the axis
    Better from 1 kHz up, far worse at 250-630 Hz (4.18 dB at 250-400) with deep
    single-capsule nulls; overall 2.180 vs 1.324 dB in the old position.
2026-09-24 Chamber treatments day 2: decoupling the wall mount barely helps (2.180 -> 2.109)
    The low-end holes come from the speaker position, not structure-borne sound.
2026-09-24 Chamber day 2: speaker on the wall itself; live per-capsule tone meter
    Moving the sphere from the wall reinforcement to the wall recovers 250-400 Hz but
    ruins 400 Hz-1.6 kHz instead; total unchanged (2.170). calibrator/live_tone.py plays
    one tone and shows every capsule's calibrated level at it live, flagging a capsule
    whose USB stream has gone to full-scale noise after a bus reset.
2026-09-24 Chamber day 2: absorber behind the wall-mounted speaker leaves the 555 Hz peak
2026-09-24 Chamber day 2: bare ring leaves the score unchanged (2.219 -> 2.205)
2026-09-24 Chamber day 2: sphere back at the centre on a new mount, 1.786 dB with a 3.2 dB tilt
2026-09-24 Chamber day 2: levelling the sphere takes the score 1.786 -> 1.443
    Tilt now under 0.5 dB below 3 kHz; cleanest state measured from 1 kHz up.
2026-09-24 Chamber day 2: figure, levelled sphere vs the previous cleanest state
2026-09-24 README: correct the levelled-sphere claim at 1-1.6 kHz; add comparison with the best state
    It ties rather than beats the best at 630 Hz-1.6 kHz (0.84 vs 0.81).
2026-09-24 Refuse to capture on a broken USB stream; even carpet undoes the floor
    After a hub reset a UMIK-2 can come back delivering full-scale noise while its
    mixer still reads unity, so every tone failed on it; happened twice on 2026-09-24.
    capture_rig now records 0.5 s of silence first and stops, naming the capsules, if
    any reads above -40 dBFS. Chamber: an evenly laid thick carpet takes room error
    1.443 -> 2.540 dB (250-400 Hz 4.86).
2026-09-24 Chamber day 2: every floor state side by side
2026-09-24 Chamber day 2: felt on the even carpet trades bands, total unchanged (2.509)
2026-09-24 Chamber day 2: a metal rod scatters only at the high end
2026-09-24 Chamber day 2: felt on the ceiling improves every band below 3 kHz (2.506 -> 2.051)
2026-09-24 Chamber day 2: removing the rod undoes it at 5-6.4 kHz, nothing below 1 kHz
2026-09-24 Chamber day 2: raised, less even carpet helps a little (2.054 -> 2.011), not the low end
2026-09-24 Chamber day 2: figure, raised carpet vs the previous cleanest state
2026-09-24 Chamber day 2: carpet raised further + felt shield, score unchanged (2.027)
2026-09-24 Chamber day 2: felt shield and extra carpet height each move the map, neither the score
2026-09-24 Chamber day 2: removing the ceiling felt only partly undoes it; its effect depends on the floor
2026-09-24 Chamber day 2: felt on the floor hurts 630 Hz-3 kHz a third time (2.107 -> 2.517)
2026-09-24 Chamber day 2: felt foil side inward is worse still (2.517 -> 2.753)
2026-09-24 Chamber day 2: all felt removed, 2.159 dB
2026-09-24 Chamber day 2: the last run was foil stripped off the felt, not felt removed
    Relabelled after Adam's correction. Stripping the foil takes the room from 2.753
    (foil in) / 2.517 (foil away) to 2.159, with the best low end since the wedges came
    out: the foil had been sealing the Thinsulate underneath.
2026-09-24 Chamber day 2: figures, foil-free felt vs before any felt
2026-09-24 Chamber day 2: flipping the foil-free felt improves every band (2.159 -> 2.008)
2026-09-24 Chamber day 2: bare felt (glue removed) helps 1-6 kHz, total 1.998
2026-09-24 Chamber day 2: figure, bare felt vs the cleanest state
2026-09-24 Chamber day 2: floor layer raised further, score unchanged (1.992)
2026-09-25 Chamber day 3: repeatability 0.009 dB within the day, score reproduces overnight to 0.005 dB
2026-09-25 Chamber day 3: blue carpet on the floor stack, 1.996 -> 1.961
2026-09-25 README: blue carpet is on top, ~0.5 cm, no backing
2026-09-25 Chamber day 3: speaker closer to the ring, 1.961 -> 1.311 dB
    400-630 Hz and 630 Hz-1 kHz at their best ever; within 0.03 dB of the best state
    without the wedges.
2026-09-25 README: speaker moved ~20 cm closer, on axis
2026-09-25 Chamber day 3: speaker in the ring plane is worse (1.473) than ~10 cm off it (1.311)
2026-09-25 Chamber day 3: curtain run confounded by a disturbed sphere (+4.3 dB at 5-6.4 kHz)
2026-09-25 Chamber day 3: material roll 1.403; an unexplained HF boost is common to curtain and roll runs
2026-09-25 Chamber day 3: stuffed corner near the hubs, 1.403 -> 1.445
2026-09-25 Chamber day 3: one-layer folding screen, 1.445 -> 1.626
2026-09-25 Chamber day 3: felt on a wall, 1.445 -> 1.409
2026-09-25 Chamber day 3: only the raised carpet left, 1.393 (best today); HF boost persists
2026-09-25 Chamber day 3: speaker backed off 5 cm, 1.393 -> 1.303
2026-09-25 Chamber day 3: figure, backed-off speaker vs the cleanest state
2026-09-25 Chamber day 3: backed-5cm accepted; clean-up 1 (loose felt off) is safe
2026-09-25 Chamber day 3: clean-up 2 moves the map 0.35 dB, score within tolerance (1.314)
2026-09-25 Chamber day 3: clean-up 3 (junk put back tidily) hurts, 1.314 -> 1.531 — undo
2026-09-25 Chamber day 3: removing the blue curtain recovers a third of clean-up 3's damage (1.458)
2026-09-25 Chamber day 3: clean-up 5 not back to the accepted state; the geometry shifted during clean-up 3
2026-09-25 Chamber day 3: rearranging the carpet leaves the geometry shift in place (1.443)
2026-09-25 Chamber day 3: carpet removed, 1.740 — the source geometry moved with it
2026-09-25 Chamber day 3: carpet along the walls does nothing (1.779 vs 1.740 without)
2026-09-25 Chamber day 3: wall insulation swapped for Thinsulate, 1.779 -> 1.955
2026-09-25 Chamber day 3: thin carpet on standoffs, 1.955 -> 1.778
2026-09-25 Chamber day 3: thicker carpet on standoffs, 1.778 -> 1.579
2026-09-25 Chamber day 3: figure, thick carpet on standoffs vs the accepted state
2026-09-25 Chamber day 3: even thicker carpet on standoffs, 1.579 -> 1.497
2026-09-25 Chamber day 3: figure, thicker carpet on standoffs vs the accepted state
2026-09-25 Chamber day 3: full carpet on standoffs, 1.541 — thickness has stopped paying
2026-09-25 Chamber day 3: reordering the carpet layers, 1.541 -> 1.387 — layer order matters
2026-09-25 Chamber day 3: figure, reordered carpet vs the accepted state
2026-09-25 CLAUDE.md: summarise the three-day chamber-treatment campaign, tools and presets
2026-09-25 Chamber day 3: figure, reordered carpet vs the thicker-but-not-full carpet
2026-09-28 Quiet multicopter design rules: literature quick scan (7 pp.)
    Design rules for a quieter multicopter from ~100 papers: rotor above the arm and
    >=0.4 R clearance, rotor elevation for forward flight, rotor spacing and count,
    coaxial z/D 0.2-0.4, phase sync, ground effect; blade twist, blade count,
    trips and serrations; duct tip gap, lip, struts and when a duct is louder;
    resonant vs porous linings. Derived from the EXTRACTS files in the private papers
    repo (655 verified quotes), which govern. Section 06 maps the rules onto the
    duct and parcel-drone research trees as predictions to test.
2026-09-28 Design rules: audit the findings list against the sources
    Four numbers were wrong or misleading (ground-effect +6 dB is the reflection zone
    at any height, not within 1 D; the conical-arm 6 dB is the one exception case;
    Serré's measured gain is 8.8 dB(A), not the caption's 10; Turhan's -19 dB is vs
    in-phase in 9 m/s inflow, static was -8 dB, and spacing was tested only at
    s/D 1.01-1.05). Added missing scale/regime conditions and re-tagged second-hand
    results. Same corrections applied to the PDF.
2026-09-30 Chamber day 3: summary of the top 5 setups, A4 waterfall pages, ISO 3745-analogue band verdicts
    Room error <3 kHz per setup (top four tied within 0.014 dB; the last config is
    0.086 dB behind), each drawn against cleanup-1 with the existing step figure,
    plus a per-third-octave-band test borrowed from ISO 3745 (band level and pure
    tones). Only 2 kHz is clean in all five setups; 315, 400 and 800 Hz fail in
    three or more. Pure tones are not qualified in any band.
2026-09-30 Chamber day 3 summary: the source moved between cleanup-1 and the last config
    Level +0.6 dB at cleanup-3 (never undone) and the top-to-bottom tilt flipped sign
    at carpet-removed. With the tilt fitted out the last config scores 1.165 vs 1.157
    for cleanup-1: its 0.086 dB deficit was the source, not the carpet layers.
2026-09-30 Chamber: carpet-reordered is the final accepted state (Adam, 2026-09-30)
    Summary descriptions, README and CLAUDE.md updated; the summary now states the
    band-level verdicts for the accepted state alone.
2026-09-30 Baseline story 2026-09-30: fresh vertical prop baseline, mic corrections, room campaign, felt-duct runs
    A4 report with real-time timeline, room error per clock time, polars, waterfalls and
    the felt-duct comparison at equal thrust. Findings: the mic corrections smooth the polar
    by 70% on identical captures; the room campaign's net headline change is zero (1.380 ->
    1.387); July/August vertical baselines ran at 6.6-7.6 V and are not a valid before;
    today matches the September operating point. Felt-duct variants are 10-13 dB louder at
    equal thrust.
    [build_report.py, story_lib.py]
2026-10-01 Chamber final report (3 pages): final configuration vs the empty floor, evaluated by the ISO 3745 band-by-band method
    Final configuration 1.387 dB vs 2.054 for the bare floor (wedges off), 1.380 untouched start.
    Band-level test: 4 of 11 bands clearly over the limit (start: also 4, in different places),
    pure tones qualified in no band. Quotes (Cunefare 2003, Kayhan 2008, Nash 2019) verified
    verbatim against the text dumps.
2026-10-01 Chamber final report: drop the standalone final-configuration page (2 pages: comparison waterfall + evaluation)
2026-10-01 Chamber report: same-day comparison only, prop-plane roundness check, semi-anechoic solutions that apply
    Waterfall compares the empty floor (wedges off) with the carpet, 24 Sep afternoon, source in one
    position (tilt change <=0.03). Evaluation by the ISO 3745 band method; prop-plane polar vs 31 Aug
    (clearly rounder, worst cell 3.1 vs 7.5 dB) and vs 2 Sep at the same operating point (not rounder,
    66% vs median 71% of cells in tolerance). Page 3: which semi-anechoic remedies apply, from the
    chamber-fighting guide, quotes verified. Source-output step at 14:57 on 24 Sep noted.
2026-10-01 Correct the baseline story: same-day comparisons only, prop-plane roundness replaces 'cannot tell'
    Room verdict restricted to the 24 Sep stripped-floor block (empty floor 2.054 -> carpet 1.317); the
    cross-day 1.380 -> 1.387 'no net gain' and the 'vertical arc, polar is real' assumption are withdrawn.
    Prop-plane polar: rounder than 31 Aug, not rounder than 2 Sep at the same operating point.
    CLAUDE.md updated to match.
    [build_report.py]
2026-10-01 Chamber report: the 24 Sep 14:52 level step is unexplained, not 'source output'
    Neighbours named (chaotic-carpet-2 before, wall-mount-a 34 min after); same shape recurs on 25 Sep
    (in-plane-b -> curtain); known axial moves give different shapes. Candidates and a test listed.
2026-10-01 Chamber report: room-only changes that afternoon moved the mean by <=0.13 dB; the 14:52 step is not redistributed absorber
2026-10-01 Chamber report: the HF-vs-LF step is a two-state switch in the source chain, not a move, absorber or supply change
    Five flips of 4.1-4.6 dB between neighbouring runs; speaker device and amplitude unchanged at the
    same-day ones; arc-relative map changed 0.12 dB (a 5 cm source move: 0.80).
2026-10-02 Chamber report: page 1 and the evaluation table compare day3-a (worst of day 3) with carpet-reordered (final); source-moved caveat and the clean 24 Sep pair stated on page 2
2026-10-02 Chamber report: polar on the app's 0-80 dB SPL axis (round, as in the screenshots); day3-a vs carpet-reordered waterfall figure
2026-10-02 CLAUDE.md: how the laptop backup timer and the Pi SSH key were restored (overlayroot-chroot, HTTPS remote)
2026-10-02 Chamber report: shorten page-1 title, fix the same-day-pairs sentence
2026-10-02 Chamber report: polar zoomed to the 315 Hz-1 kHz tone-notched broadband where the runs differ; 2 Sep shown as equally round
2026-10-02 Chamber report: larger polar (6.3 -> 8.2 cm), tighter text around it
2026-10-02 Chamber report: polar radial zoom +-8 dB
2026-10-02 Chamber report: say the screenshot's total level is equally spread; the gain is in the broadband
2026-10-05 Chamber report: photos of the chamber (5 Oct) and the source sphere on page 3, with descriptions
2026-10-05 Chamber report restructured into chapters: 1 source and microphones (full-width photos), 2 waterfall and day-3 evaluation, 3 polars, 4 solutions
2026-10-05 Chamber report: the chamber photo is the final (carpet-reordered) configuration
2026-10-05 Chamber report: shorter source description on page 1
2026-10-05 Chamber report: chapter 1 is substitution calibration with before/after maps; chamber photo moves to the main waterfall page
2026-10-05 Chamber report: full-width chamber photo page before the main waterfall
2026-10-05 Chamber report: chapter numbering by page (1 microphones, 2.1-2.3 chamber/waterfall/evaluation, 3 polars, 4 solutions)
2026-10-05 Chamber report: say which parts of the qualification method are taken from ISO 3745 / Cunefare and which are ours
2026-10-05 Chamber report: no claim of qualification or conformity; limits cited to ISO 5305 Table 1; microphone placement against the standards
2026-10-05 Chamber report: comparable rooms from the held papers and the criteria they used
2026-10-05 Chamber report: continuous red-yellow-green colouring of the band table relative to each band's limit
2026-10-05 Chamber report: say that the percentage counts tone x capsule cells
2026-10-05 Chamber report: visible note that a cell is one tone x one microphone
2026-10-05 Chamber report: the September reference set is 1-2 Sep (prop8-10 on 1 Sep, prop11-17 on 2 Sep), not 2 Sep
2026-10-05 Chamber report: polars recomputed as the app draws them (20-560 Hz and 100-10000 Hz, 31 Aug vs 30 Sep), on their own page; caption says the 31 Aug baseline is not a controlled pair
2026-10-05 Chamber report: low-end polar zoomed to 50-74 dB SPL
2026-10-05 Chamber report: low-end polar zoom 30-76 dB SPL
2026-10-05 Chamber report: each prop capture read with the calibration that existed when it was taken (factory before 16 Sep, corrected after); 30 Sep is rounder in absolute terms, the gain comes from the calib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
2026-10-05 Chamber report: 2 Sep runs drawn on the polars; spread text corrected for 100-10000 Hz
2026-10-05 Chamber report: table of which capture sets carry the microphone corrections
2026-10-05 Chamber report: polars show only 31 Aug (factory files) and 30 Sep (corrected files)
2026-10-06 Chamber report: calibration maps with k-unit frequency ticks (no overlap) and colour legends
2026-10-06 Chamber report: plain wording for the correction-effect row
2026-10-06 Chamber report: plain-language rewrite and corrections from the text audit (page 5 conclusion, deviation units, tone counts, cost and gate wording, caveat in body type)
2026-10-06 Chamber report: describe the 16 Sep microphone calibration as it was done (one capsule at a time, same mounting point, stepped sweep, reference measured three times), not as 'substitution'
2026-10-06 Chamber report: caveat now says the final mounting point was meant to repeat the starting one but is undocumented; tilt and level show the match is close, not exact
2026-10-06 Slides: slide 1, the jagged propeller polar (31 Aug, 20-560 Hz) and the problem statement
2026-10-06 Slides: slide 2, what we did (loudspeaker photo, microphone swap diagram, sweep settings, calibration results); overlay is now slide 3
2026-10-06 Slides: spread chart removed, slide 2 re-laid out; new slide 3 with the calibration waterfalls; overlay is slide 4
2026-10-06 Slides: larger, redrawn calibration waterfalls on slide 3 (bigger type, 8.2 in wide); fig_mic takes size and font scale
2026-10-06 Slides: new slide 4, the chamber-treatment waterfall (day3-a to carpet-reordered) with a native per-band chart; the polar overlay becomes the last slide (5)
2026-10-06 Slides: slide 5 table gets the partial 5000 and 6300 Hz bands, no bullet dots on its summary lines
2026-10-06 Slides: slide 7, the five material set-ups overlaid on one polar at 2000 us
2026-10-06 Slides: material polar uses a tighter radial range (68-100 dB) so the curves fill more of the plot
2026-10-06 Slides: material polar scale cut at 88 dB so the curves fill the plot; the -90 deg lobe is marked as off the scale
2026-10-06 Slides: material polar scale 69-84 dB, spike out of sight and marked
2026-10-06 Slides: material polar scale eased to 65-90 dB
2026-10-06 Slides: new intro slide with the chamber photo; the other slides are numbered 2 to 8
2026-10-06 Chamber photo levelled by 2.1 degrees using the back-wall wedges (report and slides)
2026-10-07 Slides: say 'motor supply' where the volts are given (EN and PL)
2026-10-07 Slides and report: the two polars use different propellers; no attribution of the lower level to the supply voltage
2026-10-07 Slides: voltage removed from the comparison slide (EN and PL)
2026-10-07 Slides: materials listed from quietest to loudest (EN and PL)
2026-10-07 Slides: decks renamed chamber-slides-final(.pptx) and chamber-slides-final-pl(.pptx)
2026-10-07 Slides: slide 8 adds the five 7 Oct materials (PU foam, double PU foam, felt+PU foam, Thinsulate 4 and 8 layers); band changed to 500 Hz-24 kHz
2026-10-07 Slides: slide 8 uses solid lines only; 7 Oct materials marked with square markers
2026-10-07 Repeat the ESC signal ramp within one capture so repeat scatter is visible
    A single pass cannot say how much of a polar's shape is the measurement's own
    scatter. The capture run now takes `repeats` (API default 1, wizard default 3)
    and `repeat_gap_seconds` (default 4): between passes the ESC signal drops to
    1200 µs and the orchestrator waits for the rotor to come down from 2000 µs
    before ramping again. No re-tare between passes; a trip, link loss or abort in
    any pass (gap included) ends the run as before.
    Every meta.json records its 1-based `repeat` (older data reads as 1), and
    pwm_points exposes it per capture and per mic. The Polar tab gains "Show all
    repeats": one curve per repeat in t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
2026-10-07 Allow the :5174 dev origin; add final chamber slides PDF
2026-10-09 Slides: slide 9, the ten membrane set-ups (8-9 Oct) overlaid at 2000 us, 500 Hz-24 kHz, mean of 3 repeats
2026-10-09 Slides: 'Duct, small' renamed 'Duct, membrane only' on slide 9
2026-10-09 Slides: slide 9 also saved as a separate one-slide file, 2026-10-09 duct membrane materials results
2026-10-09 Slides: bare prop added to the membrane slide with its thrust (3.75 N) against the quietest other set-up (0.39 N)
2026-10-23 CLAUDE.md: fourth research tree 2026-10-23 (8in duct membrane materials, :8126, m8-)
2026-10-23 CLAUDE.md: fifth research tree 'propellers' (:8127, pr1-), linked to propellers.pdf
2026-10-23 CLAUDE.md: propellers tree also hosts the one-pager
2026-10-23 Add duct liner CAD (ladder ring/segment and spiral strip), chamber TOP5 comparison and membrane-results slides
    cad/ladder-liner: OpenSCAD sources + STLs for a printed liner in the circular
    duct slot (ladder ring with dovetail latch, flat rollable segment, and a
    0.8 mm continuous spiral strip that springs outward in the slot).
    docs: TOP5-vs-best/current chamber comparisons (2026-09-30), day-3 rerun
    figure, final chamber slides and the 2026-10-09 membrane-materials slide.
2026-10-27 CLAUDE.md: sixth research tree 2026-10-27 (:8128, r27-), first node 8x4.5MR bare prop
2026-10-27 Compare picker: never pair a base's label with another base's mics
    PWM point ids repeat across bases, so an Add pressed while a newly chosen
    base's points were still loading found the same id in the previous base's
    list and drew that base's levels under the new label (or 404'd and dropped
    the curve). The points list now carries the base it was loaded for.
    closes #23
2026-10-28 Polar tab opens on 500 Hz–24 kHz
    The r27 material comparisons are read in that band; the Custom tab keeps 100 Hz–10 kHz.
2026-10-28 Compare picker: overlay every base captured on one day at one ESC signal
    A toggle with a day (default today) and ESC signal (default 2000 µs) adds one series per
    base, built only from that day's captures, so days are never mixed in one curve.
2026-10-28 Results: rank the overlaid bases by thrust at 2000 µs in the left column
    Each series is the mean over its repeats; sorted by magnitude because thrust reads negative on the current rig.
2026-10-28 Day overlay: From–To range, each base at its latest day in the range
    Lets yesterday's Thinsulate 10 sit beside today's bases; a curve still never mixes days and keeps its date in the label.
2026-10-28 Thrust ranking: show propeller rpm (mean and range over repeats) beside each thrust
    Electrical rpm × 60/7 for the 14-pole AXI 2217/12.
2026-10-28 CLAUDE.md: next-session list from the 2026-10-28 r27 materials session
2026-10-29 Ranking panel: arc level from the Polar tab, sortable by thrust, quietness or rpm
    The level is the energy mean over the mics of each mic's repeat-mean, in the Polar tab's band and level source.
2026-10-30 Base and series labels carry their capture dates
    A material re-measured on another day (Thinsulate 2, 2026-10-30) has to be told
    apart from the earlier run in the pickers, the chart legends and the thrust
    ranking. GET /keys now returns each base's first/last capture time (from the
    measurement folder names, not stored in key.json); keyLabel appends the local
    day or day span, and every overlaid series ends with the day(s) of its captures.
2026-11-02 Duct inlet design rules (2 pp.): tip gap, lip, wall, prop position, outlet for the r27 8in duct
    The r27 unlined duct gives 24% less thrust than the bare APC 8x4.5MR at
    2000 us, so the inlet needs redesigning. Derived from the verified duct
    extracts in the papers repo, which govern; all quotes re-checked.
2026-11-02 Parametric 8in duct for the APC 8x4.5MR on the AXI 2217/12, built to the inlet rules
    1 mm tip gap, 25 mm lip (12% Dt), 30 mm wall, disc behind the lip,
    10 deg diffuser to area ratio 1.18, 3-arm spider at the exit plane.
    Printable in four quarters. Motor mount dimensions are placeholders to
    measure; nothing printed or tested yet.
2026-11-02 Duct README: STLs are build output, how to regenerate them
2026-11-02 Duct: interactive three.js viewer built from the same profile as duct.scad
2026-11-02 Duct: pusher layout with three NACA 0015 struts upstream of the propeller
    Air now passes the stand plate, hub, struts and motor before the
    propeller. The hub hangs the motor inside the straight throat, the struts
    sit 55 mm upstream of the disc and screw into pockets in the duct wall,
    and the hub prints flat. Moves the strut angles off the quarter cut
    planes (the old tab at 270 deg sat on one).
2026-11-02 Duct: back to the first shape, motor moved upstream, plain box spider over the inlet
    Adam preferred the first duct (90 mm, disc 35 mm below the lip) with only
    the motor placement swapped. The spider now sits 20 mm above the lip and
    its legs screw into the outer wall, so the inside stays smooth and the
    outlet is clear; the struts no longer need an aerofoil section.
2026-11-02 Duct spider: AXI 2217 rear-mount holes from AXI's drawing (4 x M3, 19/16 mm cross)
    The hole pattern was a placeholder (4 on 25 mm) and the viewer drew the
    hub solid. Now the hub carries AXI's documented pattern, the centre hole
    is 9 mm so the web to the 16 mm holes is 1.9 mm (12 mm left 0.4 mm), an
    assert guards that web, and the viewer shows holes and bolts.
2026-11-03 Slide: r27 duct linings at 2000 us with thrust and rpm, in the style of the membrane slide
    Seven 8in set-ups (bare prop, unlined duct, Thinsulate 2/4/6/8/10 with
    the new fit), levels 500 Hz-24 kHz from the corrected files, thrust and
    mechanical rpm from the telemetry. Each base is read on one day only,
    since the additive backup keeps re-measured bases' old captures under
    the same name.
2026-11-03 r27 slide: line chart by microphone angle instead of the polar, plus each lining minus the unlined duct
    The polar hid the 0.1-1 dB differences between linings under the 11 dB
    gap to the bare prop. The bare prop stays in the list; the -90/-72
    positions are shaded as probably in the flow.
2026-11-03 r27 slide: back to the polar, radial axis zoomed to the duct set-ups (82-96.5 dB)
    Adam wanted the polar, with the materials as separate lines rather than a
    different chart. The bare prop (74-80 dB) leaves the plot and stays in the
    list; the -90/-72 wedge is shaded as probably in the flow.
2026-11-03 r27: polar of the duct with inlet (two runs, 3 Nov) against the unlined duct without it (2 Nov)
    The inlet run repeats to 0.04 N and 0.0-0.2 dB from -54 to +90 deg; it gives
    +2.1 N at 2000 us with the same level except 2.4 dB less on the axis (0 deg).
2026-11-03 r27 slide: add the duct with the inlet (3 Nov, dashed), +2.13 N over the unlined duct at the same level
2026-11-03 r27 figures: add inlet + Thinsulate 2 and 4 (3 Nov) to the A3 slide and the inlet polar
    With the inlet fitted the linings no longer add thrust (-0.07/-0.08 N, inside the
    repeat scatter) and take 0.2-0.3 dB off from -54 to +90 deg.
2026-11-03 r27: per-band analysis of the inlet and the linings (third octaves, tones notched, BPF harmonics)
    The inlet takes 2-4 dB off 400 Hz-2 kHz broadband but adds ~0.5-1.5 dB at 2.5-20 kHz, where the
    ducted level peaks, so the 500 Hz-24 kHz total barely moves.
2026-11-03 r27: heatmap, microphone x third-octave band, of Thinsulate 2 and 4 inside the inlet duct (same day) with the repeat floor
2026-11-03 r27 heatmap: clearer panel titles ([A] minus [B]) - 'inlet + Thinsulate - inlet, no lining' read as one name
2026-11-03 r27 heatmap: stats under each panel title; script also draws the no-inlet version (2 Nov) for reference
2026-11-03 r27 figures: add inlet + Thinsulate 4 + rubber (3 Nov)
    Same thrust (10.08 N); 0.8-1 dB less broadband above 2 kHz than the unlined inlet duct,
    but the 2xBPF tone (800 Hz) rises 3-9 dB at the front mics, so the total level does not move.
2026-11-03 r27 figures: add inlet + felt (3 Nov)
    Behaves like Thinsulate 4 inside the inlet duct: -0.4 dB total from -54 to +90, -0.6 dB broadband
    above 2 kHz, no tone penalty; thrust 9.98 N.
2026-11-04 r27: heatmap of the duct and the inlet against the bare prop (mic x third octave), with the inlet effect and the repeat floor
2026-11-04 r27 heatmap: inlet + PETG 1-layer wall (4 Nov) against the latest unlined inlet run (3 Nov)
2026-11-06 r27: side-vs-top index per third octave - does the duct shield its side, and where do the linings act
2026-11-06 r27: inlet + transparent wall (6 Nov) in the heatmap and side-vs-top figures
2026-11-09 CLAUDE.md: seventh research tree (2026-11-09, g5-, 5 in prop in the 8 in duct) and its rpm cutoff
2026-11-09 CLAUDE.md: g5 runs use the current cutoff only, the 5 in prop is an FPV prop built for high rpm
2026-11-10 Timeline of the duct and lining work, 2 Oct - 9 Nov, checked against the recordings
    Inventory of every recording (228 runs), thrust/power/level per run since 2 Oct,
    a claims ledger with verdicts, and a one-page step-by-step timeline with a figure.
    The 27 Oct - 2 Nov lining gain is marked as not a win: it came with the thrust,
    and a plain inlet gave more.
